nppesnteam/357-22-RHTU-DKVR-4.13/Титульник.pdf

## Директор

# РОССИЙСКАЯ ФЕДЕРАЦИЯ

Общество с Ограниченной Ответственностью Научно Производственное Предприятие "ЭНЕРГОСБЕРЕГАЮЩИЕ СИСТЕМЫ И НЕЙРОАВТОМАТИЗАЦИЯ г.Ижевск
nppesn.ru

## /Корепанов М.И./

Регистрационный номер 1083 в реестре Ассоциации Саморегулируемой организации "Национальное объединение научно-исследовательских и проектно-изыскательских организаций" (Ассоциация СРО "ЦЕНТРСТРОЙПРОЕКТ", регистрационный номер в государственном реестре саморегулируемых организаций СРО-П-029-25092009)

# Котельная ФГБОУ ВО "РХТУ имени Д. И. Менделеева" по адресу: г. Москва, Миусская площадь, дом 9, стр.1

# 357-22-АГСВ1

Автоматизация.

# Котел №1 ДКВР-4/13

## Заказчик: ФГБОУ ВО "РХТУ имени Д. И. Менделеева"

## Ижевск, 2022
