nppesnteam/357-22-RHTU-DKVR-4.13/АГСВ/АГСВ.pdf

## Директор

# РОССИЙСКАЯ ФЕДЕРАЦИЯ

Общество с Ограниченной Ответственностью Научно Производственное Предприятие "ЭНЕРГОСБЕРЕГАЮЩИЕ СИСТЕМЫ И НЕЙРОАВТОМАТИЗАЦИЯ г.Ижевск
nppesn.ru

## /Корепанов М.И./

Регистрационный номер 1083 в реестре Ассоциации Саморегулируемой организации "Национальное объединение научно-исследовательских и проектно-изыскательских организаций" (Ассоциация СРО "ЦЕНТРСТРОЙПРОЕКТ", регистрационный номер в государственном реестре саморегулируемых организаций СРО-П-029-25092009)

# Котельная РХТУ им. Д.И. Менделеева. Приведение автоматики безопасности котлов ДКВР-4/13 в соответствие с требованиями ТР безопасности сетей газораспределения и газопотребления

# 357-22-АГСВ

Автоматизация.

# Общекотельное оборудование

## Заказчик: ФГБОУ ВО "РХТУ имени Д. И. Менделеева"

## Ижевск, 2022

Стадия | Лист | Листов
Изм. | К.уч. | Лист | №Док. | Подп. | Дата

ОООНПП "ЭСН"
www.nppesn.ru

РД

Состав раздела автоматизации

1

ГИП
Разраб.
Проверил

Н. контр.

Чураков

Корепанов

Шакиров

Корепанов

Технические решения, принятые в рабочей документации, соответствуют требованиям экологических, санитарно-технических, противопожарных и других норм, действующих на территории Российской Федерации и обеспечивают безопасную для жизни и здоровья людей эксплуатацию объекта при соблюдении предусмотренных рабочими чертежами мероприятий.

Ведомость рабочих чертежей | Ведомость ссылочных и прилагаемых документов
Лист | Примечание Наименование | Обозначение | Примечание Наименование

Автоматизация. Общекотельное оборудование

357-22-АГСВ

Котельная РХТУ им. Д.И. Менделеева. Приведение автоматики безопасности котлов ДКВР-4/13 в соответствие с требованиями ТР безопасности сетей газораспределения и газопотребления

1 | Состав раздела "Автоматизация. Общекотельное оборудование"
2 | Общие указания
3 | План размещения средств автоматизации
5 | Схема внешних электрических проводок | на 2 листах
| | | Прилагаемые документы
| | 357-22-АГСВ.СО | Спецификация оборудования и материалов
| | 357-22-АГСВ.КЖ | Кабельный журнал
4 | Схема функциональная | 357-22-АГСВ.ИО | Информационное обеспечение
6 | Структурная схема автоматизации котельной
7 | Автоматизированное рабочее место | | Ссылочные документы
8 | Шкаф общекотельной автоматики | на 2 листах
9 | Шкаф управления преобразователями частоты вентиляторов | на 2 листах
10 | Шкаф управления преобразователями частоты дымососов | на 2 листах
11 | Шкаф автоматического ввода резерва | на 2 листах

Стадия | Лист | Листов
Изм. | К.уч. | Лист | №Док. | Подп. | Дата

Автоматизация. Общекотельное оборудование
РД

Котельная РХТУ им. Д.И. Менделеева. Приведение автоматики безопасности котлов ДКВР-4/13 в соответствие с требованиями ТР безопасности сетей газораспределения и газопотребления

357-22-АГСВ

Общие указания

2 Разраб.

Общие указания
Рабочая документация по автоматизации котельной разработана на основании договора подряда, в соответствии с нормами и правилами, действующими на период 12.2022г. в части автоматизации котельных установок и газоснабжения.
Данным рабочим проектом предусматривается автоматизация работы котельной, которая обеспечивает оснащение общего газопровода электромагнитным клапаном, предназначенным для подачи газа на два котла типа ДКВР-4/13, а также сигнализаторами загазованности помещения по углекислому газу и метану.
Система защиты котельной предусматривает прекращение подачи газа к котлам в случаях : а) прекращения подачи электроэнергии или исчезновения напряжения в цепях защиты;
б) срабатывания сигнализаторов загазованнсти.
Автоматика безопасности, при ее отключении или неисправности, обеспечивает блокировку подачи газа в ручном режиме.
Система контроля загазованности по метану и угарному газу в котельной существующая. Регистрация давления, расхода пара и уровня воды в барабане котла производится контроллером шкафа управления и дублируется на АРМ оператора.
В качестве устройства контроля, управления, сигнализации и защиты котла применяется программируемый многофункциональный контроллер REGUL R500, производства инженерной компании "Прософт-Системы" г.Екатеринбург с блоками дискретных входов/выходов REGUL R500, имеющий разрешение к применению на опасных промышленных объектах подконтрольных Ростехнадзору. Контроллер обеспечивает программное открытие клапана подачи газа к котлам, прекращение подачи газа при срабатывании защит, фиксацию первопричины аварии.
Все параметры работы котлов в виде дискретных и аналоговых сигналов вводятся в контроллер REGUL R500, раюотающий в паре с сенсорным монитором размером 12,1". На монитор выводятся необходимые для наблюдения величины: температура, давление, расход, уровень.
В случае аварийной остановки котла выводятся сведения о причине аварии, время и параметры работы котла на момент останова. Дополнительно включается звуковой сигнал и световой сигнал «Авария» на шкафу управления. Управление вводом требуемых параметров и режимами отображения производится виртуальными кнопками на экране панели.
В помещении операторской проектом предусмотрена установка автоматизированного рабочего места (АРМ) оператора. С рабочего места оператора производится управление работой котлов.
На АРМ ведутся архивы необходимой глубины и детализации (часовые, суточные)

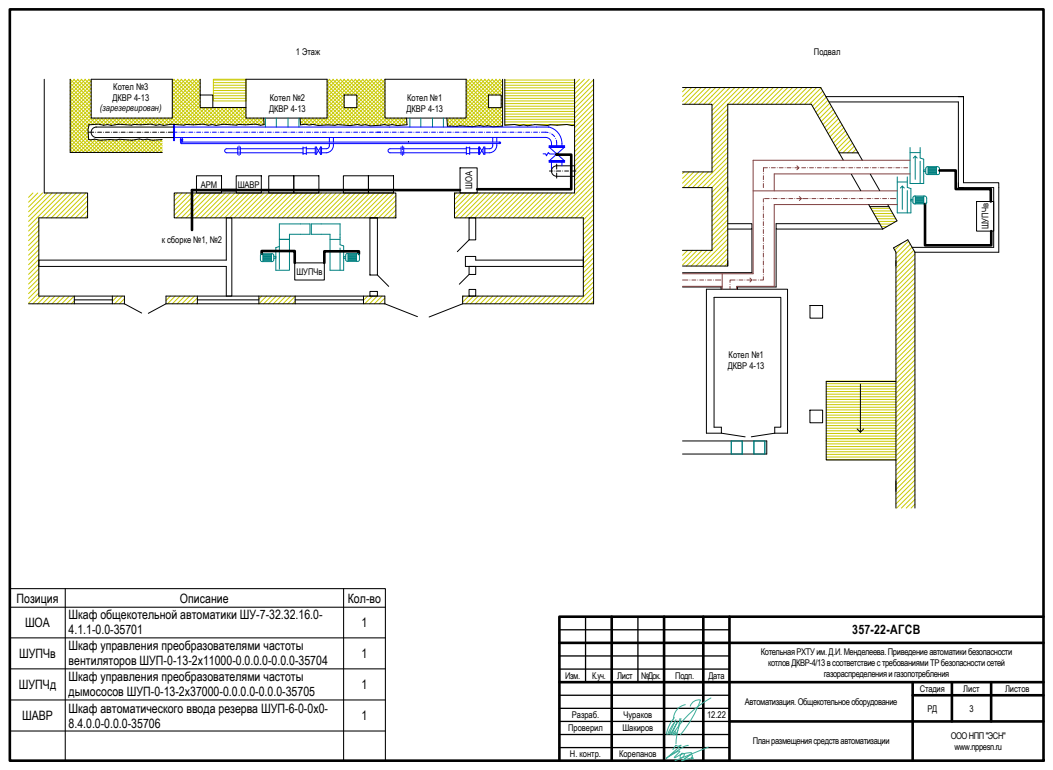
[picture p7: page 4]
Стадия; Лист; Листов; Изм.; №Док.; Подп.; Дата; газораспределения и газопотребления; 357-22-АГСВ; 3 Разраб.; Котел №1 ДКВР 4-13; Котел №2 ДКВР 4-13; Котел №3 ДКВР 4-13 (зарезервирован); 1 Этаж; АРМ; ШОА; ШУПЧв; Подвал; Позиция; Описание; Кол-во; ШАВР; к сборке №1, №2

ШОА | Шкаф общекотельной автоматики ШУ-7-32.32.16.0-4.1.1-0.0-35701
ШУПЧв | Шкаф управления преобразователями частоты вентиляторов ШУП-0-13-2х11000-0.0.0.0-0.0.0-35704 | 1
ШУПЧд | Шкаф управления преобразователями частоты дымососов ШУП-0-13-2х37000-0.0.0.0-0.0.0-35705 | 1
ШАВР | | 1 Шкаф автоматического ввода резерва ШУП-6-0-0х0- 8.4.0.0-0.0.0-35706

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

Автоматизация. Общекотельное оборудование

План размещения средств автоматизации

Стадия | Лист | Листов

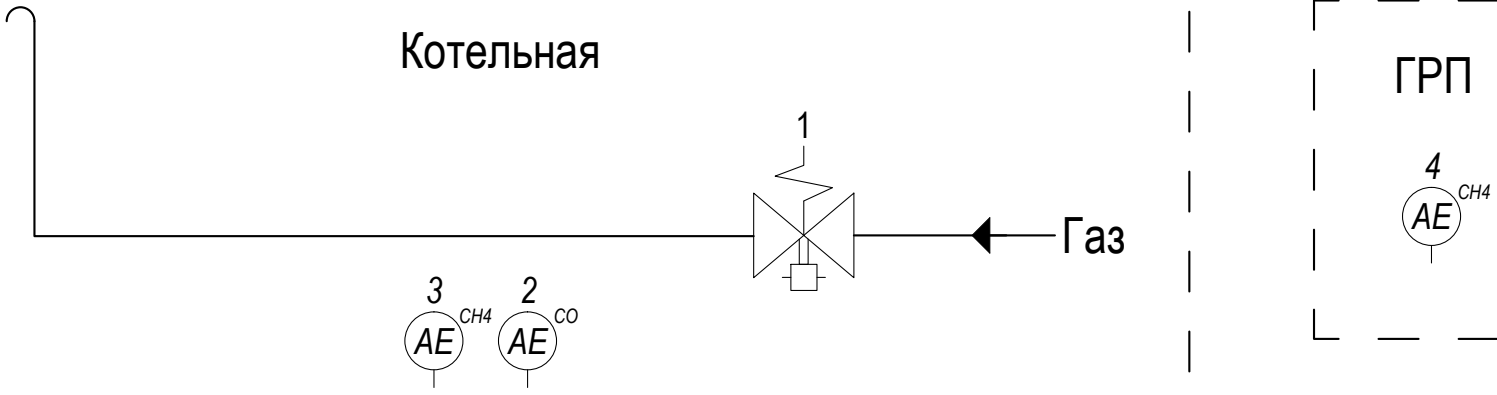
[picture p8: figure]
Газ; Котельная; ГРП

Изм. | К.уч. | Лист | №Док. | Подп. | Дата

Автоматизация. Общекотельное оборудование
РД

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

357-22-АГСВ

Схемафункциональная

4 Разраб.

A - Анализ

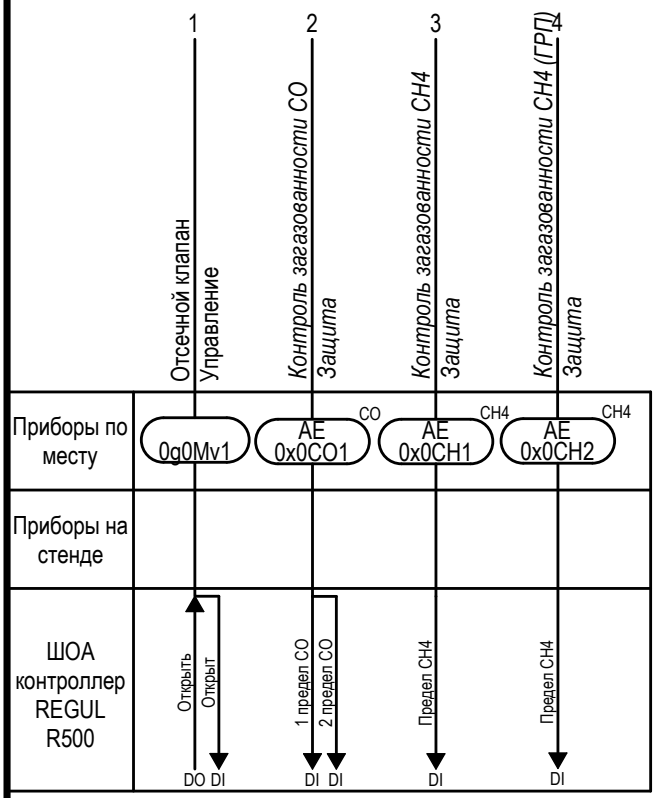
[picture p9: figure]
Приборы по месту; Приборы на стенде; ШОА контроллер REGUL R500; Отсечной клапан Управление

Стадия | Лист | Листов
Изм. | К.уч. | Лист | №Док. | Подп. | Дата

РД

Схема внешних электрических проводок. Дискретные входные сигналы

5.1 Разраб.

Параметр

Место отбора
импульса или
установки
прибора

Позиция

Автоматизация. Общекотельное оборудование

357-22-АГСВ

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

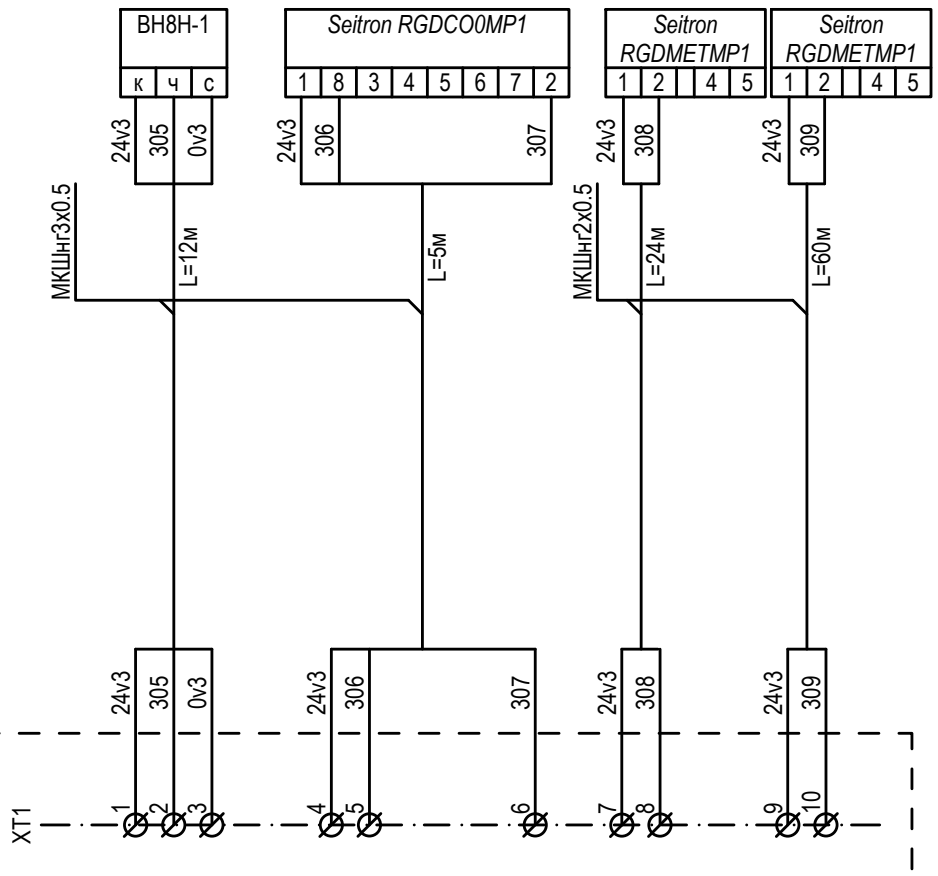
[picture p10: figure]
МКШнг; Seitron RGDCO0MP1; Seitron RGDMETMP1

Шкаф общекотельной автоматики

Контроль

Отсечной клапан
открыт

0g0Mv1

Контроль | Контроль | Контроль | Контроль
Загазованность 1 СО | Загазованность 2 СО | Загазованность СН4 (Котельная) | Загазованность СН4 (ГРП)
| | 0x0CH1 | 0x0CH2

0x0CO1

2

Стадия | Лист | Листов
Изм. | К.уч. | Лист | №Док. | Подп. | Дата

РД

Схема внешних электрических проводок. Дискретные выходные сигналы

5.2 Разраб.

Параметр

Место отбора
импульса или
установки
прибора

Позиция

Автоматизация. Общекотельное оборудование

357-22-АГСВ

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

Шкаф общекотельной
автоматики

XT2 ВВГнг

3

х1,5

Управление

Отсечной клапан
открыть

0g0Mv1

401

123

N | L | PE

ВН8Н-1

N

PE

N

401
PE L=12м

Управление

Вентилятор
котла №1

1a0fMf1

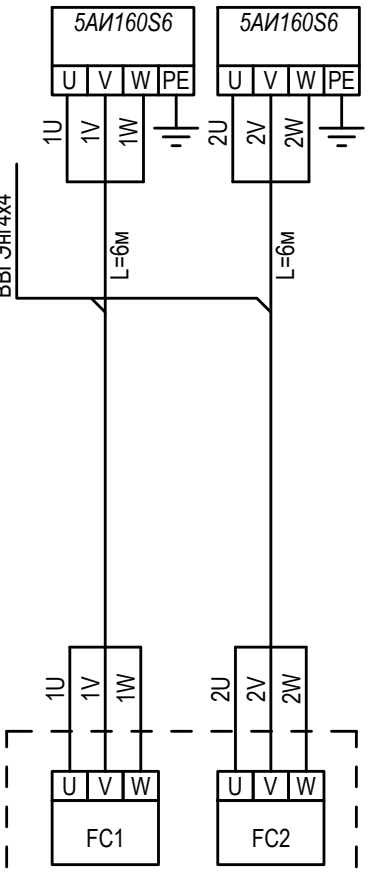
[picture p11: figure]

Шкаф управления
ПЧ вентилятора

Управление

Вентилятор
котла №2

2a0fMf1

Управление

Дымосос
котла №1

1f0fMf2

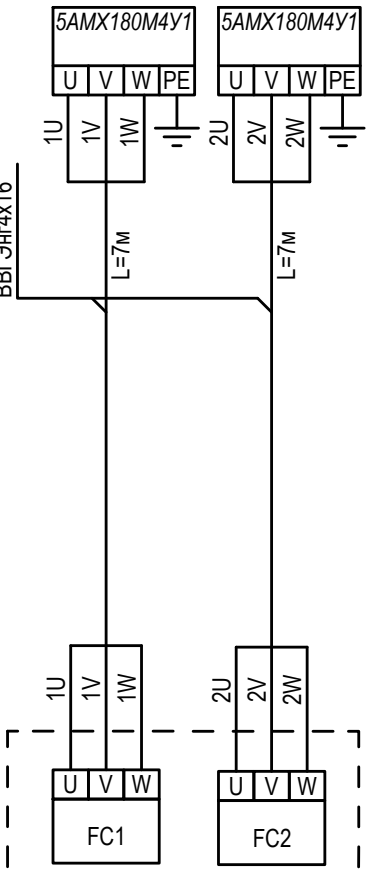
[picture p12: figure]
5АМХ180М4У1

Шкаф управления
ПЧ дымососа

Управление

Дымосос
котла №2

2f0fMf2

ВВГЭнг

4

х

4
ВВГЭнг

4

х16

ШУПЧв/
FC1..2
Позиция | Описание | Кол-во
| Частотный преобразователь 11кВт; Uпит.~380B;
Iн.вых 25А | 2
ШУПЧд/ FC1..2 | Частотный преобразователь 37кВт; Uпит.~380B;
Iн.вых 75А | 2

2

Стадия | Лист | Листов

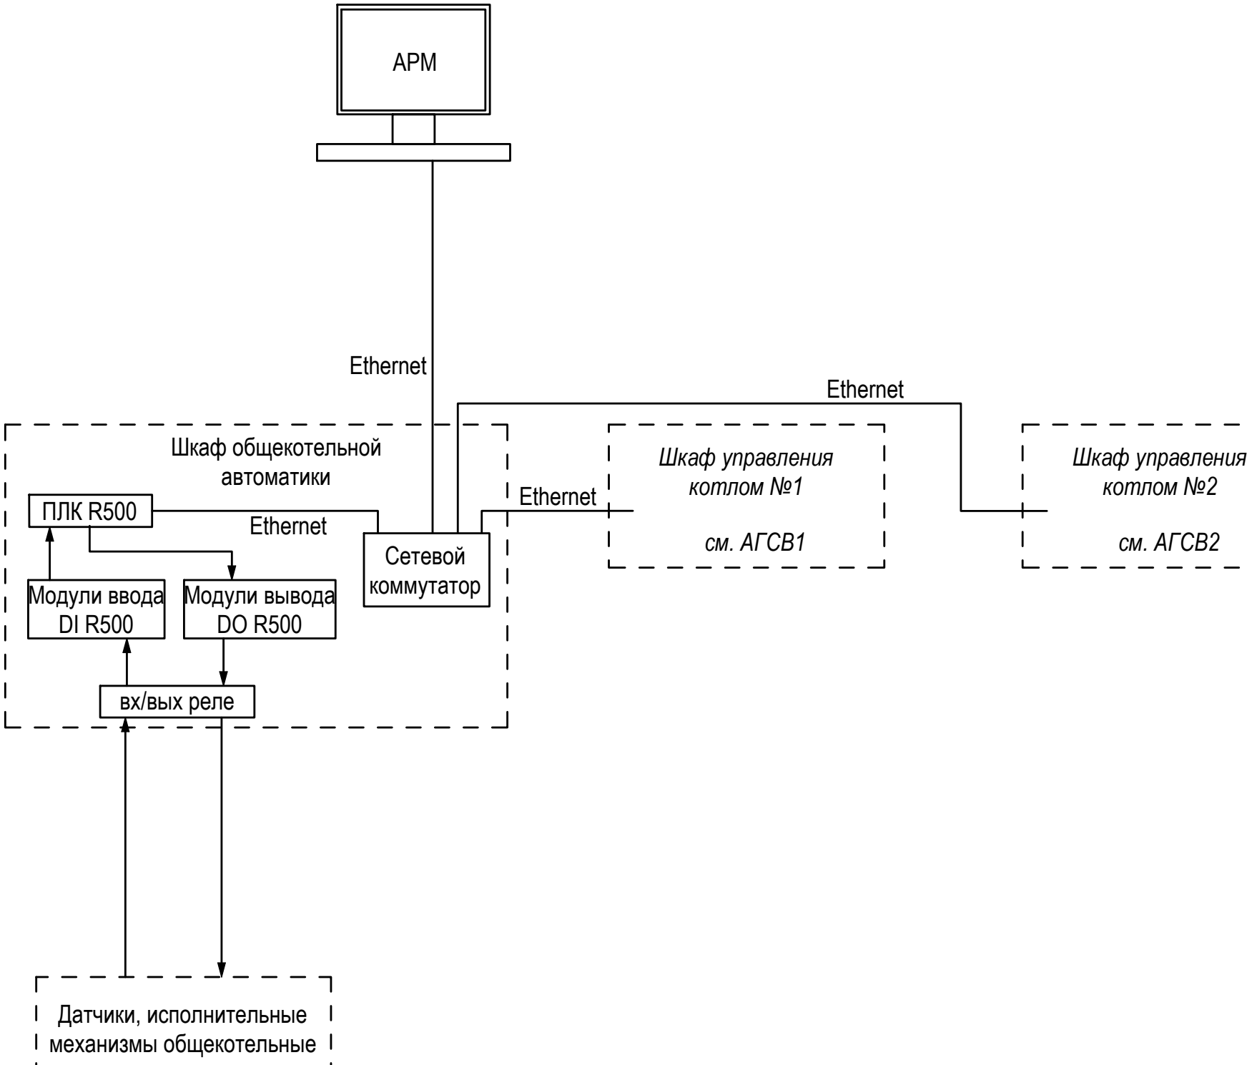
[picture p13: figure]
Датчики, исполнительные механизмы общекотельные; Шкаф управления котлом №1; Шкаф общекотельной автоматики; ПЛК R500; Модули ввода DI R500; Модули вывода DO R500; вх/вых реле; Сетевой коммутатор; Ethernet; АРМ; см. АГСВ1; Шкаф управления котлом №2; см. АГСВ2

Изм. | К.уч. | Лист | №Док. | Подп. | Дата

Автоматизация. Общекотельное оборудование
РД

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

357-22-АГСВ

Структурная схема автоматизации котла

6 Разраб.

Стадия | Лист | Листов
Изм. | К.уч. | Лист | №Док. | Подп. | Дата

Автоматизация. Общекотельное оборудование
РД

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

357-22-АГСВ

Автоматизированное рабочее место

7 Разраб.

### VGA

ПК

## ИБП

Позиция

ПК

Описание | Кол-во
Системный блок | 1
VGA | Монитор | 1
ИБП | Источник бесперебойного питания | 1

Примечание: стол и розетка питания для АРМ существующие.

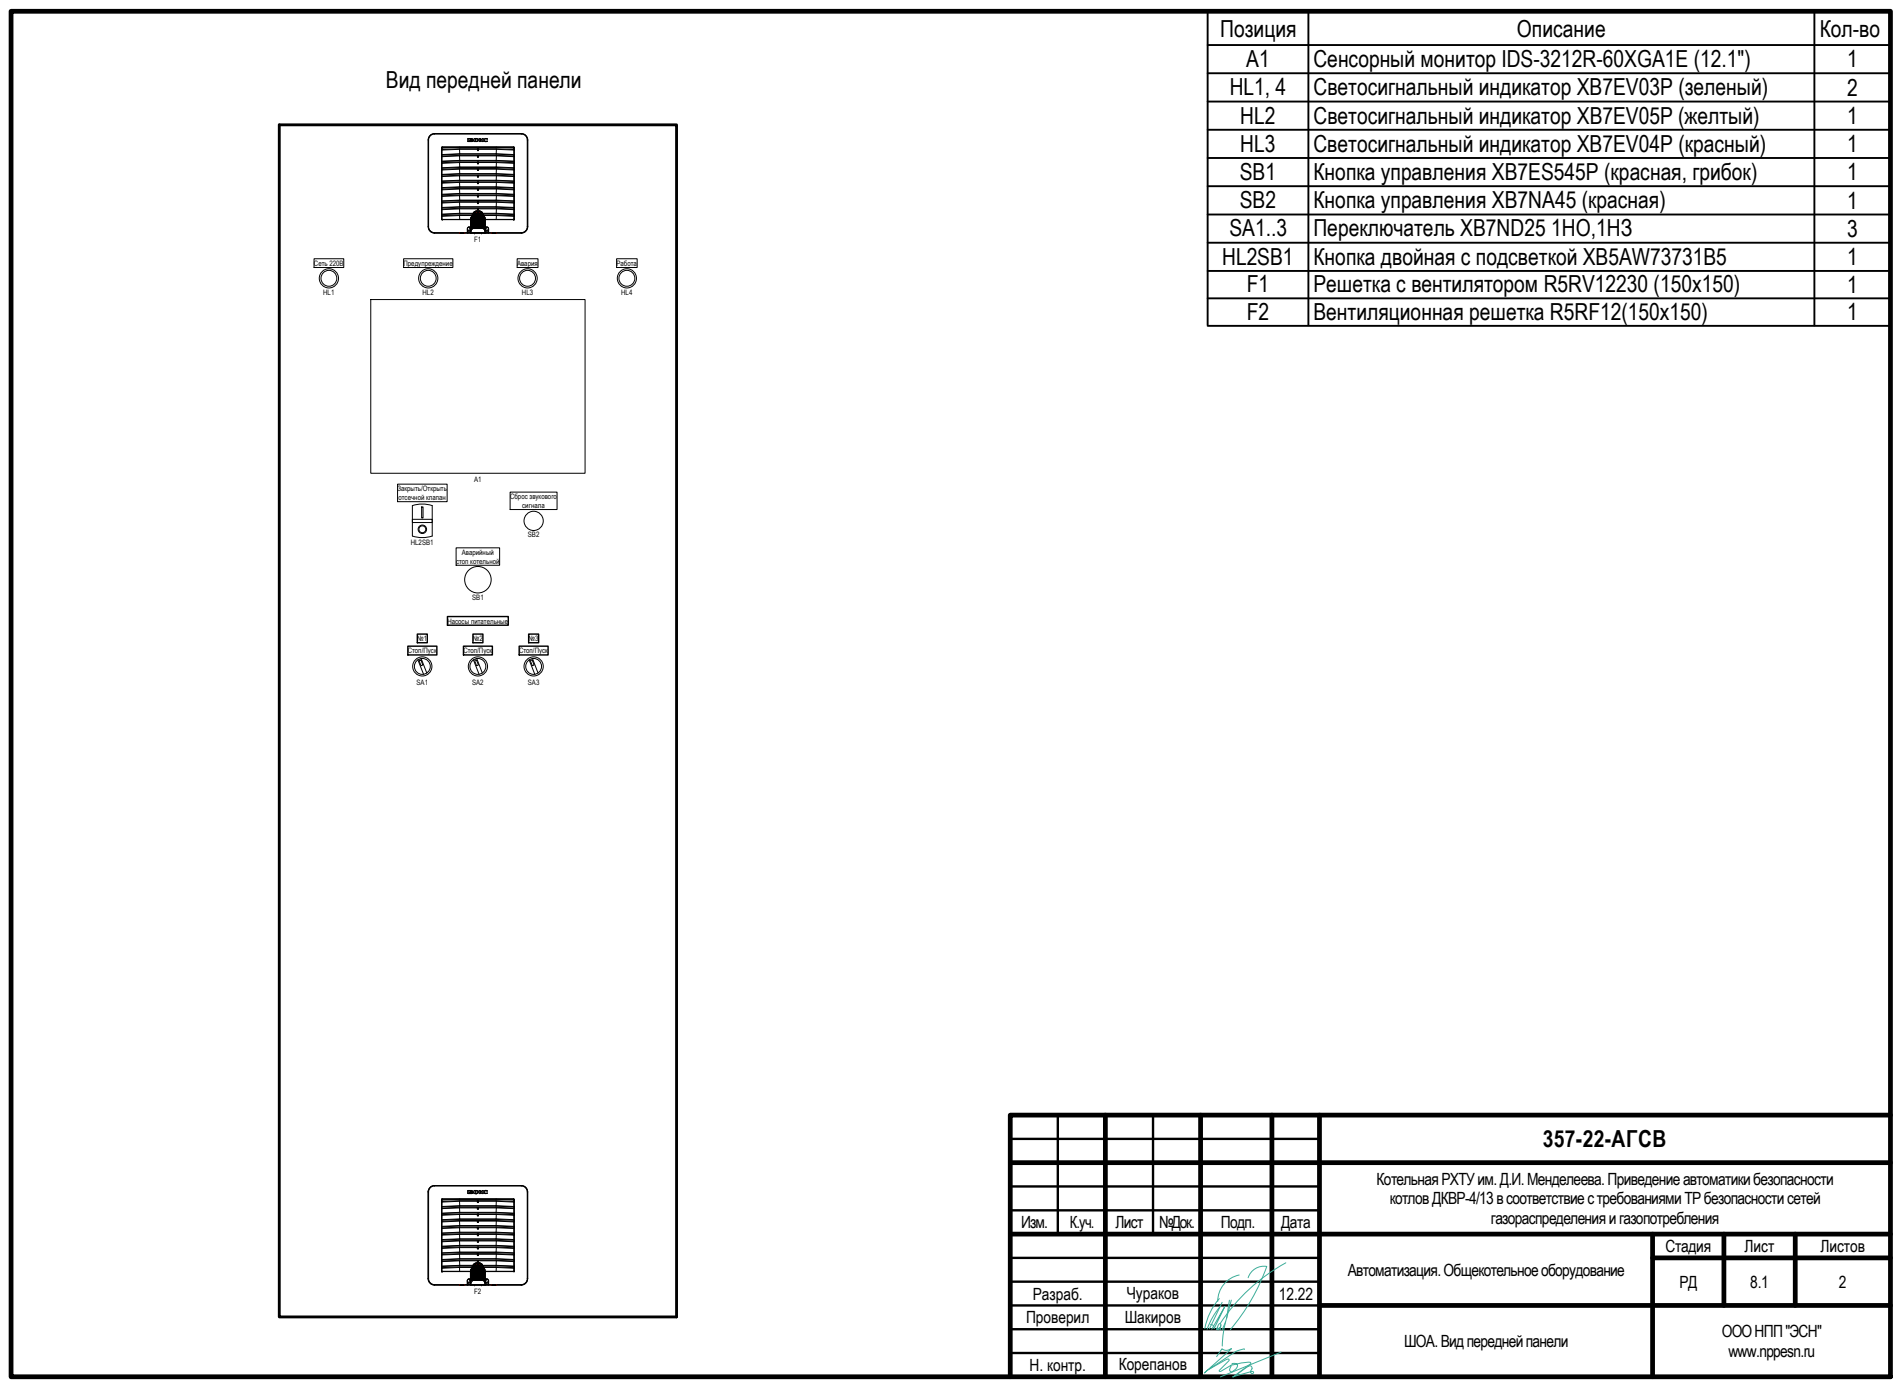
[picture p14: page 10]
Стадия; Лист; Листов; Изм.; №Док.; Подп.; Дата; газораспределения и газопотребления; 357-22-АГСВ; 8.1 Разраб.; Насосы питательные; Аварийный стоп котельной; Закрыть/Открыть; отсечной клапан; Сброс звукового; сигнала; Стоп/Пуск; Предупреждение; Авария; Сеть 220В; Работа; Описание; Кол-во; Сенсорный монитор IDS-3212R-60XGA1E (12.1"); Решетка с вентилятором R5RV12230 (150х150); Вентиляционная решетка R5RF12(150х150)

Позиция
Светосигнальный индикатор XB7EV03P (зеленый)
Светосигнальный индикатор XB7EV05P (желтый)
Светосигнальный индикатор XB7EV04P (красный)
Кнопка управления XB7ES545P (красная, грибок)
Кнопка управления XB7NA45 (красная)
Переключатель XB7ND25 1НО,1НЗ
Кнопка двойная с подсветкой XB5AW73731B5

Вид передней панели

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

Автоматизация. Общекотельное оборудование

ШОА. Вид передней панели

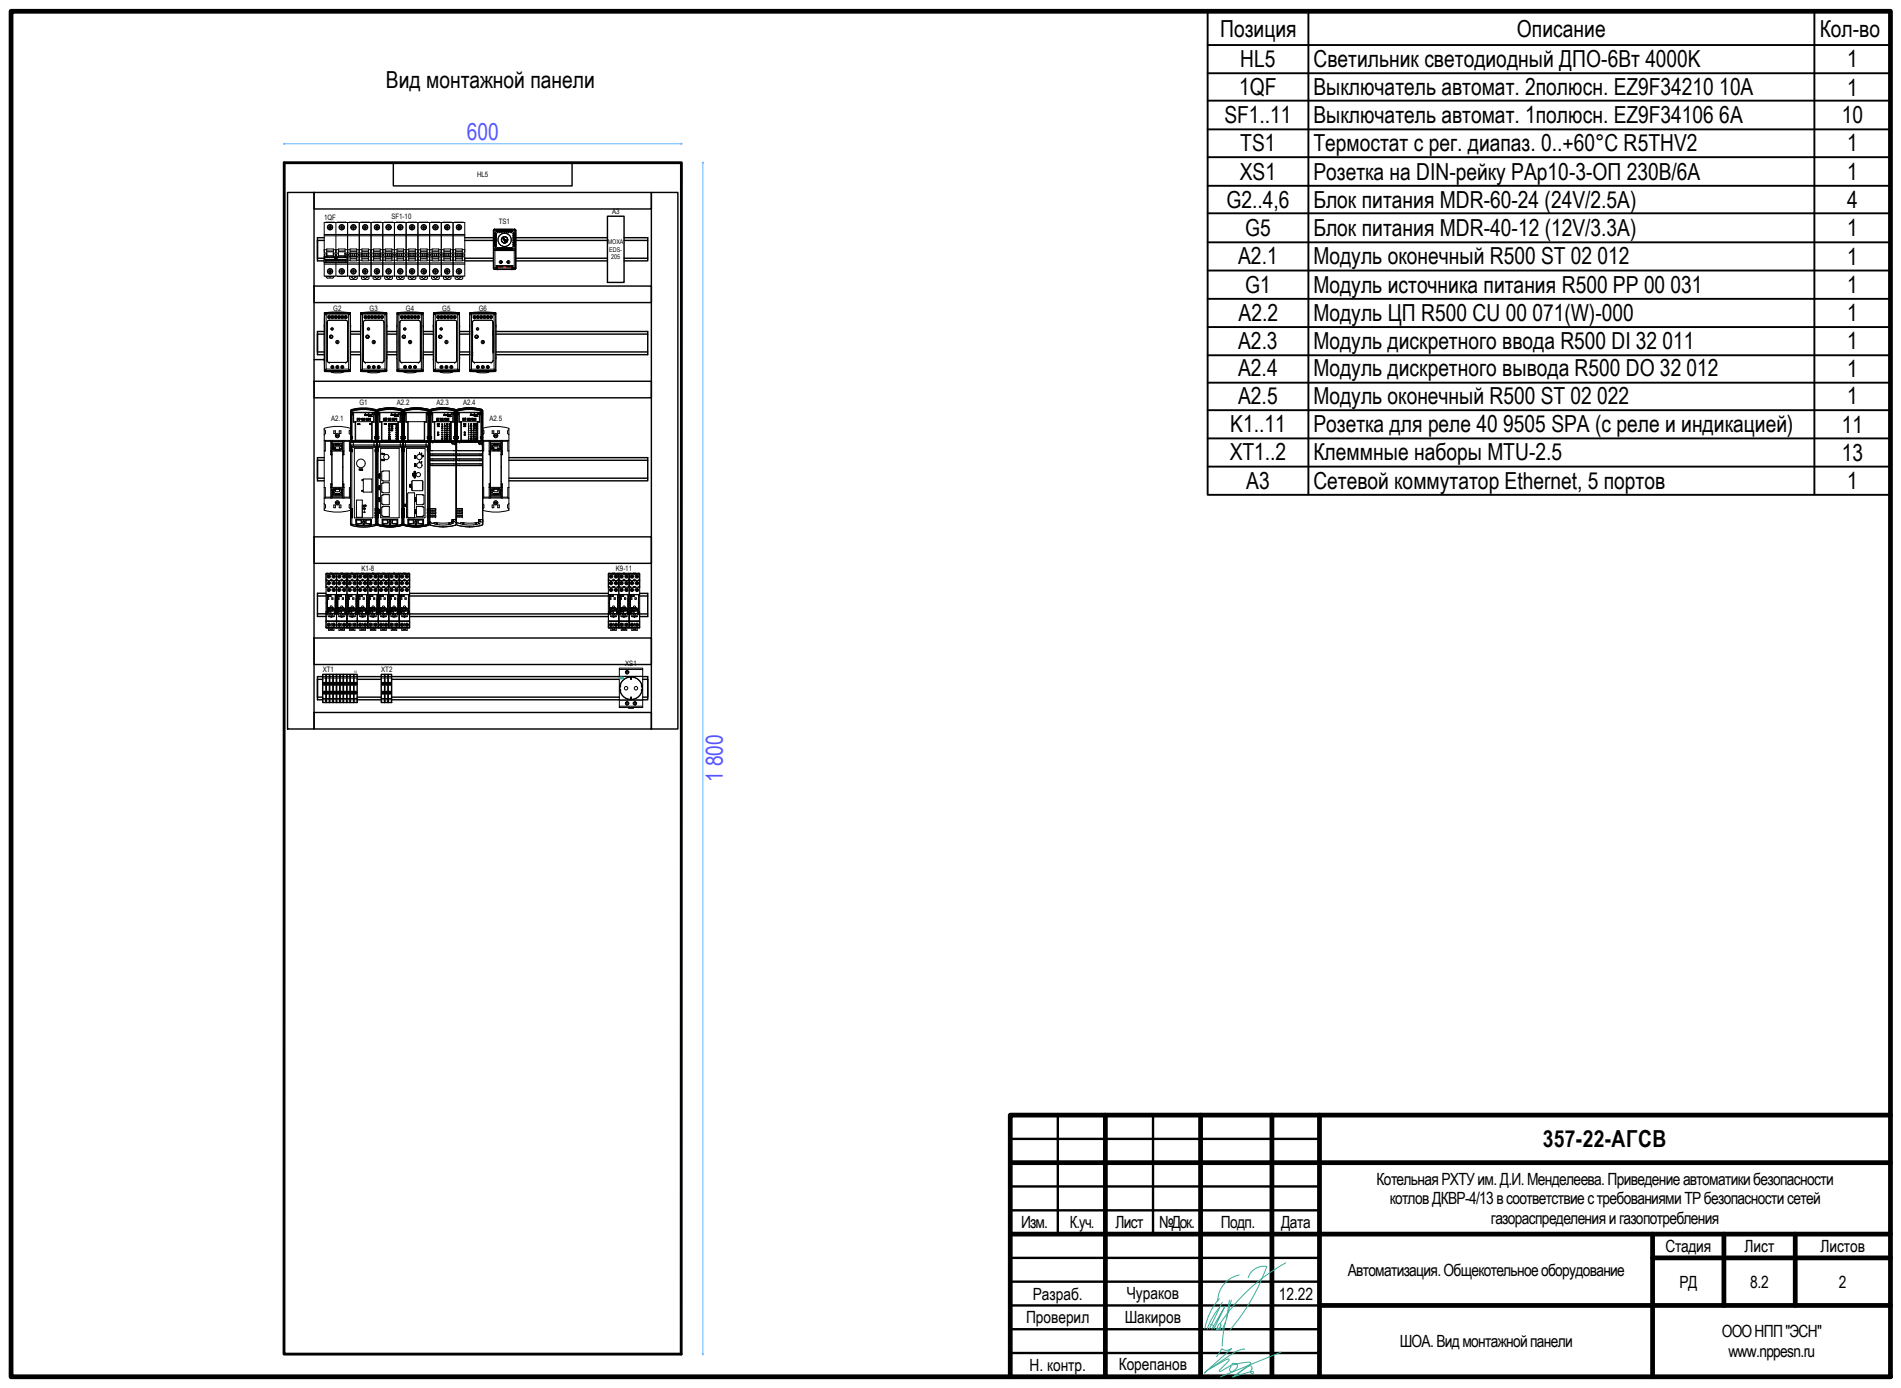
[picture p15: page 11]
Стадия; Лист; Листов; Изм.; №Док.; Подп.; Дата; газораспределения и газопотребления; 357-22-АГСВ; 8.2 Разраб.; COIL; MOXA EDS- 205; Описание; Кол-во; Светильник светодиодный ДПО-6Вт 4000K; Модуль дискретного вывода R500 DO 32 012; Термостат с рег. диапаз. 0..+60°С R5THV2; SF1..11 Выключатель автомат. 1полюсн. EZ9F34106 6A; Блок питания MDR-40-12 (12V/3.3A); Сетевой коммутатор Ethernet, 5 портов

Позиция
Выключатель автомат. 2полюсн. EZ9F34210 10А
Розетка на DIN-рейку PAp10-3-ОП 230В/6А
Блок питания MDR-60-24 (24V/2.5A)
Модуль оконечный R500 ST 02 012
Модуль источника питания R500 PP 00 031
Модуль ЦП R500 CU 00 071(W)-000
Модуль дискретного ввода R500 DI 32 011
Модуль оконечный R500 ST 02 022
Розетка для реле 40 9505 SPA (с реле и индикацией)
Клеммные наборы MTU-2.5

Вид монтажной панели

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

Автоматизация. Общекотельное оборудование

ШОА. Вид монтажной панели

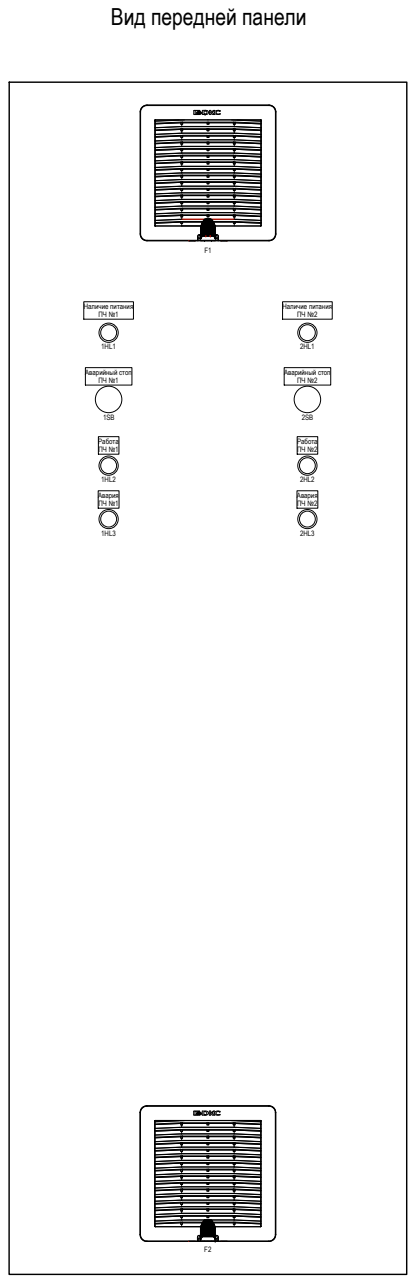
[picture p16: page 12]
Стадия; Лист; Листов; Изм.; №Док.; Подп.; Дата; газораспределения и газопотребления; 357-22-АГСВ; 9.1 Разраб.; Наличие питания ПЧ №1; Аварийный стоп ПЧ №1; Работа ПЧ №1; 1HL2 Авария ПЧ №1; Наличие питания ПЧ №2; Аварийный стоп ПЧ №2; Работа ПЧ №2; 2HL2 Авария ПЧ №2; Описание; Кол-во; Вентилятор с фильтром RV 100/105 м3/ч, 230 В, 205x205 мм, IP54; Вентиляционная решетка с фильтром RF 205x205 мм, IP54

Позиция
Светосигнальный индикатор цвет зеленый (230в)
Кнопка "Грибок" АЕ-22 (красная)
Светосигнальный индикатор цвет красный (230в)

Вид передней панели

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

Автоматизация. Общекотельное оборудование

ШУПЧв. Вид передней панели

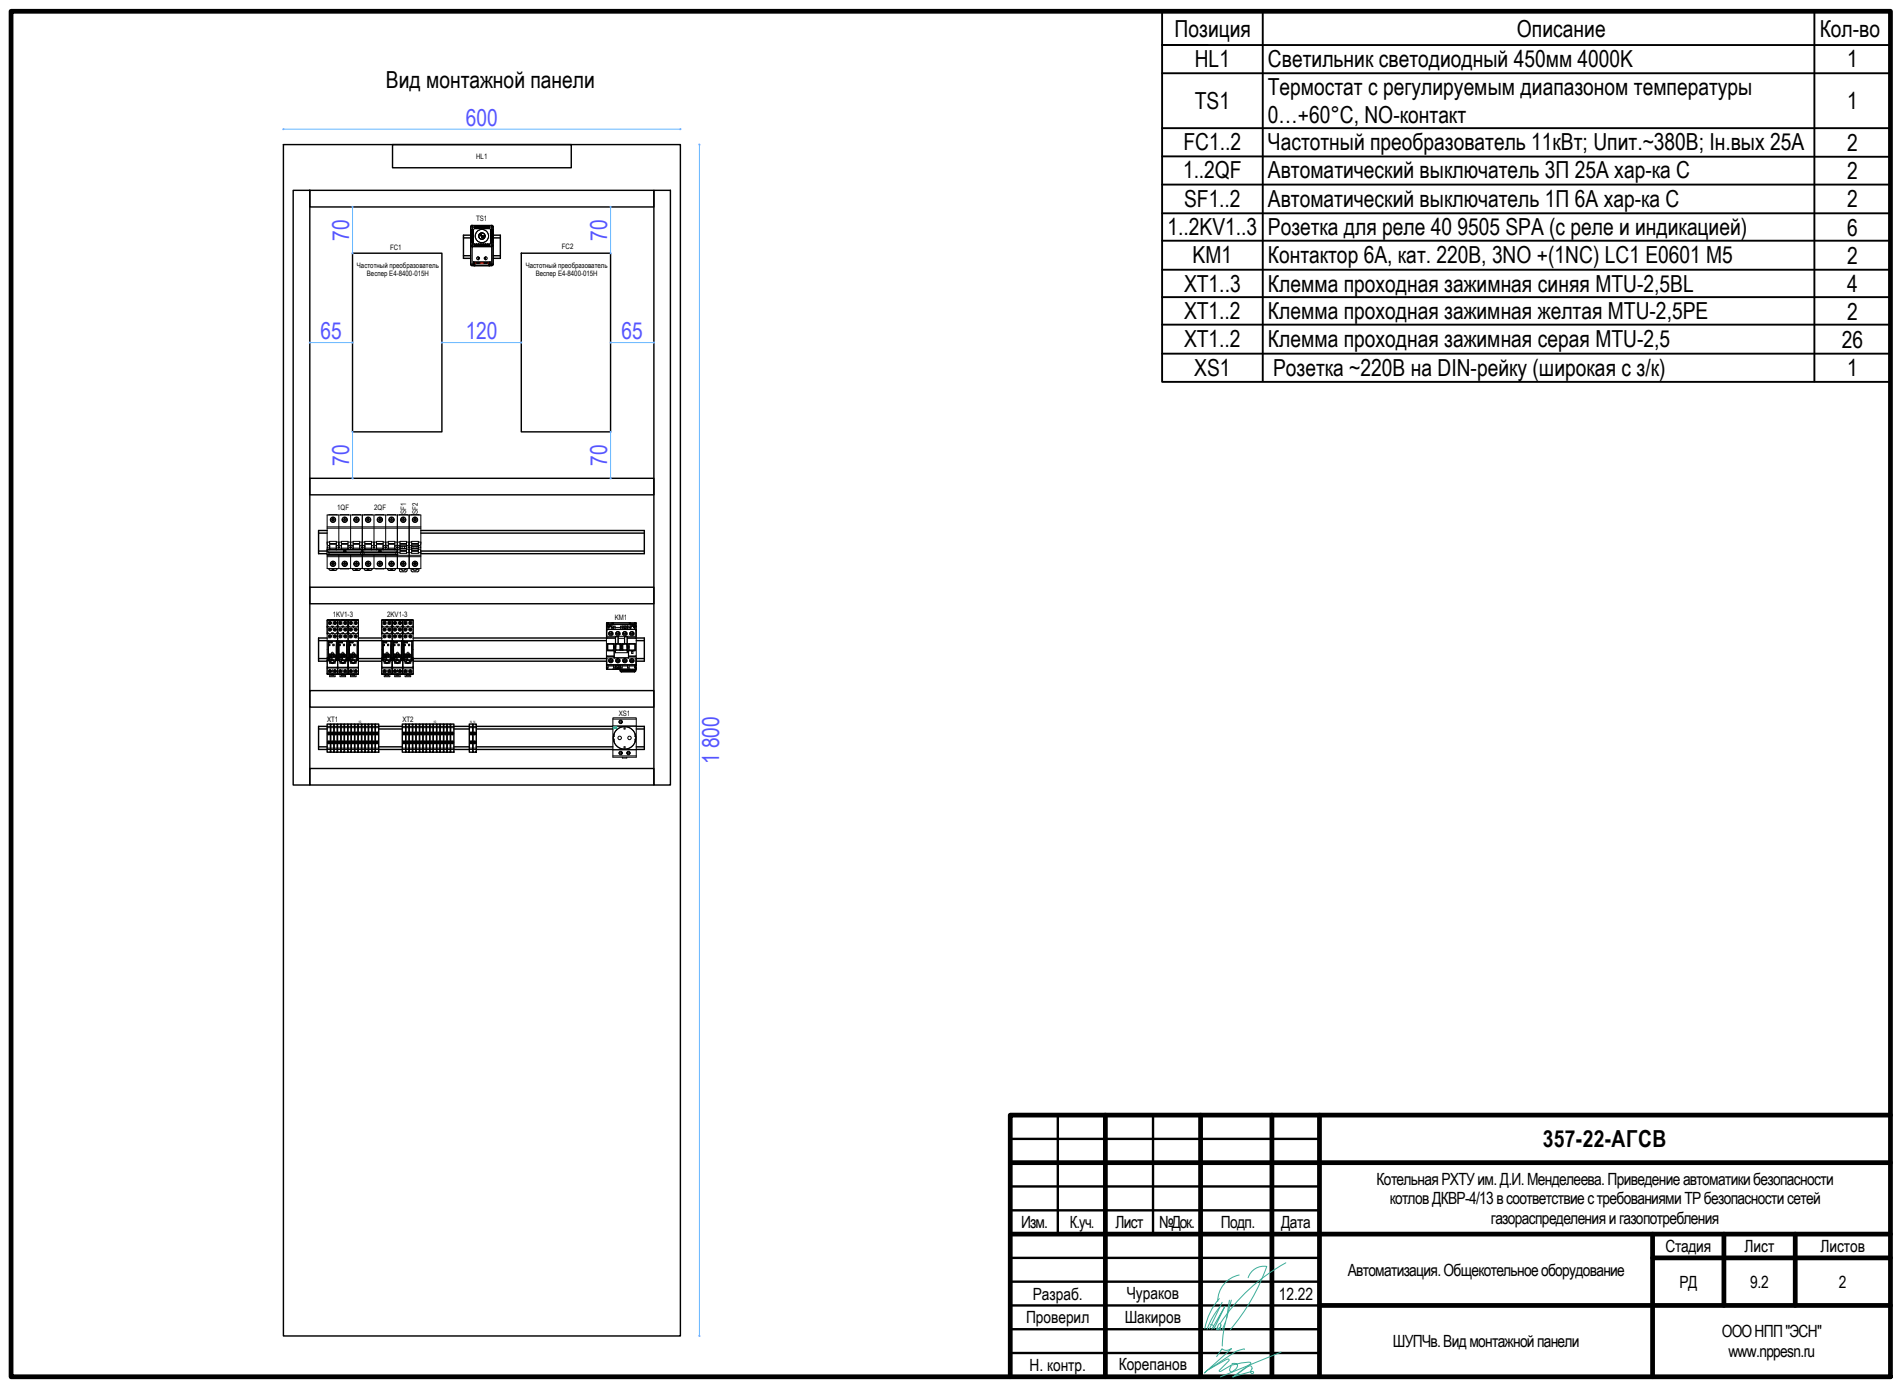
[picture p17: page 13]
Стадия; Лист; Листов; Изм.; №Док.; Подп.; Дата; газораспределения и газопотребления; 357-22-АГСВ; 9.2 Разраб.; Частотный преобразователь Веспер E4-8400-015Н; COIL; Описание; Кол-во; Светильник светодиодный 450мм 4000K; Автоматический выключатель 3П 25А хар-ка C; Частотный преобразователь 11кВт; Uпит.~380B; Iн.вых 25А; Контактор 6А, кат. 220В, 3NO +(1NС) LC1 E0601 M5; Клемма проходная зажимная желтая MTU-2,5PE; Клемма проходная зажимная cерая MTU-2,5

Позиция
Термостат с регулируемым диапазоном температуры
0…+60°C, NO-контакт
Автоматический выключатель 1П 6А хар-ка C
Розетка для реле 40 9505 SPA (с реле и индикацией)
Клемма проходная зажимная cиняя MTU-2,5BL
Розетка ~220В на DIN-рейку (широкая с з/к)

Вид монтажной панели

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

Автоматизация. Общекотельное оборудование

ШУПЧв. Вид монтажной панели

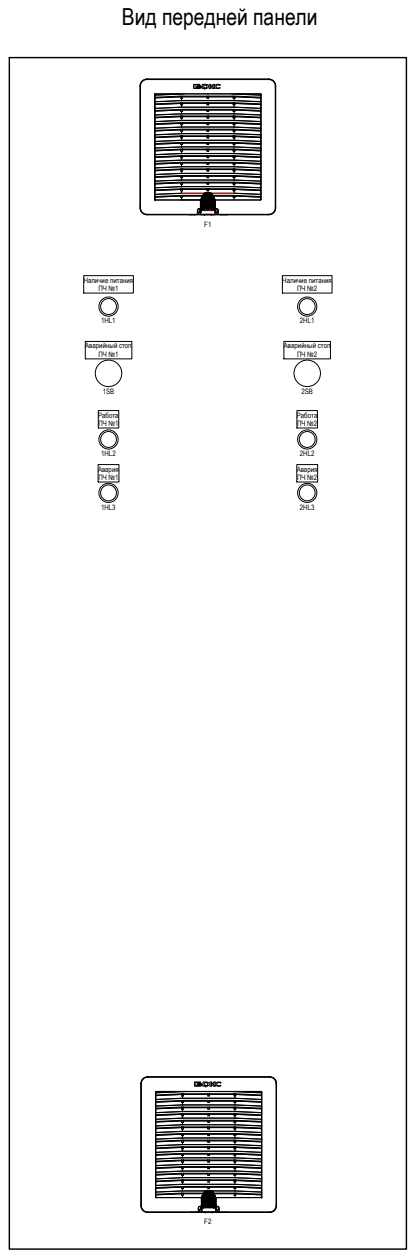
[picture p18: page 14]
Стадия; Лист; Листов; Изм.; №Док.; Подп.; Дата; газораспределения и газопотребления; 357-22-АГСВ; 10.1 Разраб.; Наличие питания ПЧ №1; Аварийный стоп ПЧ №1; Работа ПЧ №1; 1HL2 Авария ПЧ №1; Наличие питания ПЧ №2; Аварийный стоп ПЧ №2; Работа ПЧ №2; 2HL2 Авария ПЧ №2; Описание; Кол-во; Вентилятор с фильтром RV 100/105 м3/ч, 230 В, 205x205 мм, IP54; Вентиляционная решетка с фильтром RF 205x205 мм, IP54

Позиция
Светосигнальный индикатор цвет зеленый (230в)
Кнопка "Грибок" АЕ-22 (красная)
Светосигнальный индикатор цвет красный (230в)

Вид передней панели

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

Автоматизация. Общекотельное оборудование

ШУПЧд. Вид передней панели

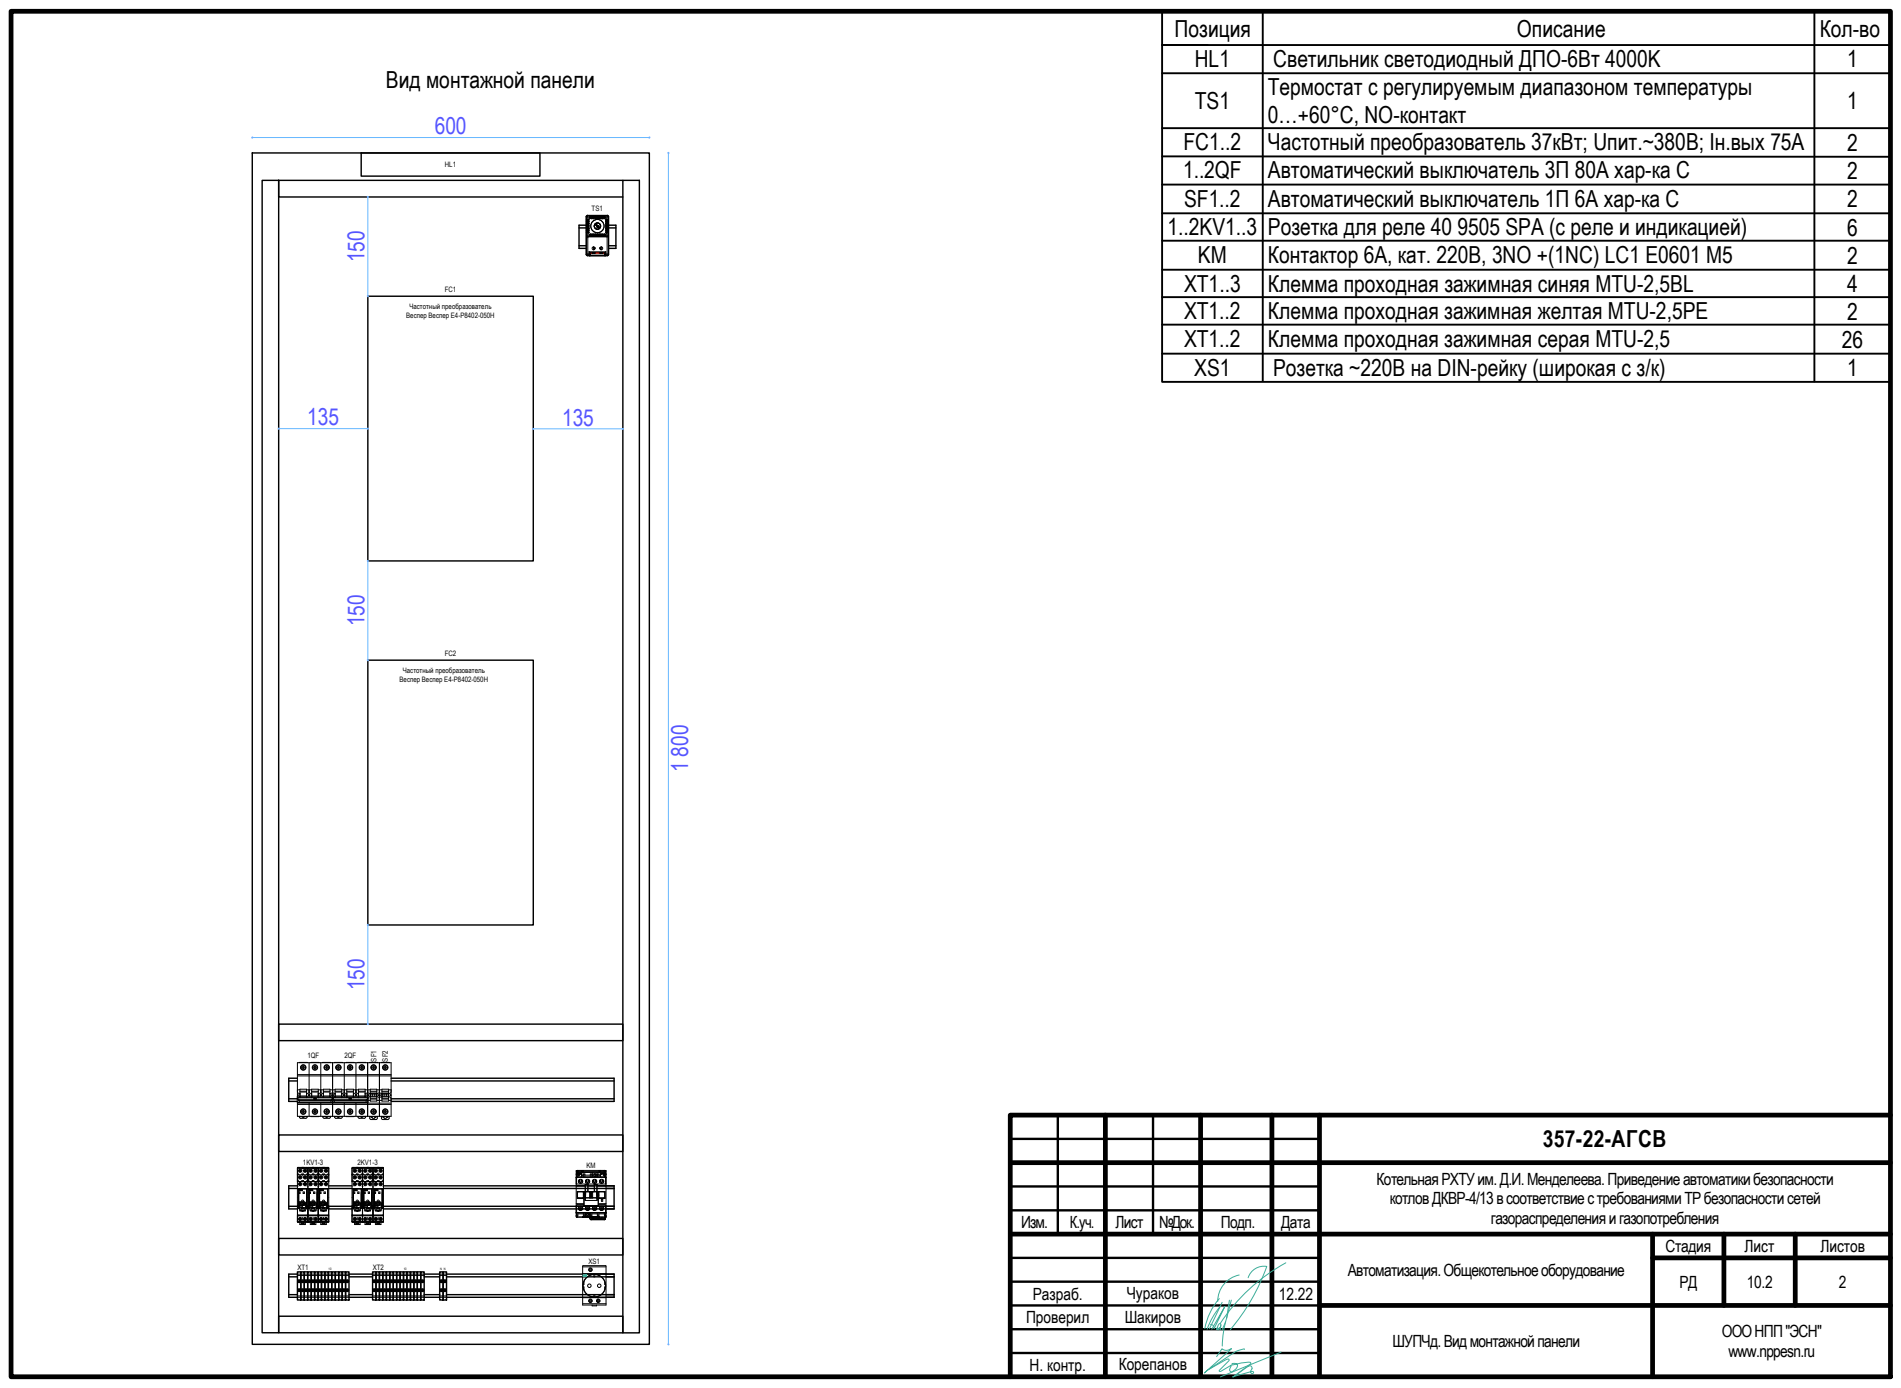
[picture p19: page 15]
Стадия; Лист; Листов; Изм.; №Док.; Подп.; Дата; газораспределения и газопотребления; 357-22-АГСВ; 10.2 Разраб.; Частотный преобразователь Веспер Веспер Е4-P8402-050H; COIL; Описание; Кол-во; Светильник светодиодный ДПО-6Вт 4000K; Автоматический выключатель 3П 80А хар-ка С; Частотный преобразователь 37кВт; Uпит.~380B; Iн.вых 75А; Контактор 6А, кат. 220В, 3NO +(1NС) LC1 E0601 M5; Клемма проходная зажимная желтая MTU-2,5PE; Клемма проходная зажимная cерая MTU-2,5

Позиция
Термостат с регулируемым диапазоном температуры
0…+60°C, NO-контакт
Автоматический выключатель 1П 6А хар-ка C
Розетка для реле 40 9505 SPA (с реле и индикацией)
Клемма проходная зажимная cиняя MTU-2,5BL
Розетка ~220В на DIN-рейку (широкая с з/к)

Вид монтажной панели

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

Автоматизация. Общекотельное оборудование

ШУПЧд. Вид монтажной панели

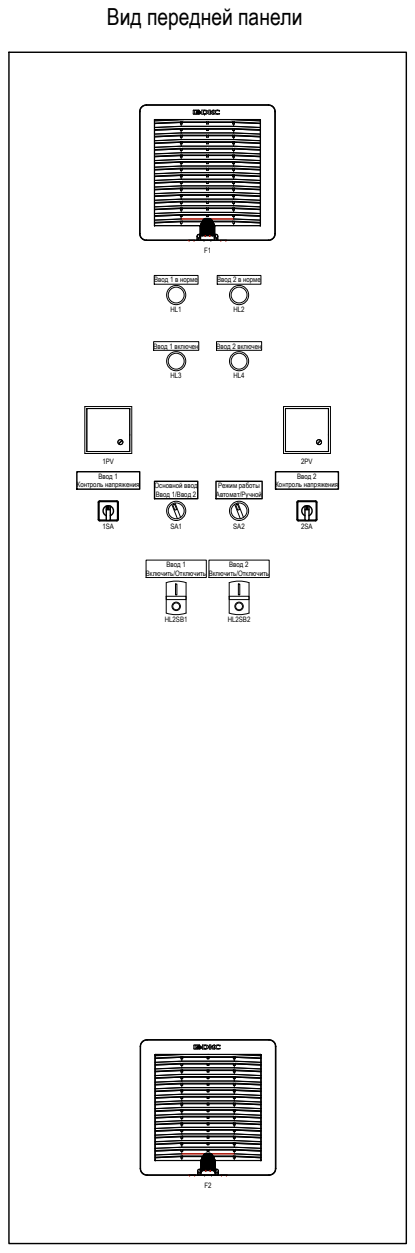
[picture p20: page 16]
Стадия; Лист; Листов; Изм.; №Док.; Подп.; Дата; газораспределения и газопотребления; 357-22-АГСВ; 11.1 Разраб.; Ввод 1 в норме; Ввод 2 в норме; Ввод 1 включен; Ввод 2 включен; Основной ввод Ввод 1/Ввод 2; Ввод 1 Включить/Отключить; Ввод 1 Контроль напряжения; Ввод 2; Режим работы; Контроль напряжения; Автомат/Ручной; Ввод 2 Включить/Отключить; Описание; Кол-во; Решетка с вентилятором R5RV13230 (205х205); Решетка R5RF13 (205х205)

Позиция
Светосигнальный индикатор XB7EV03P (зеленый)
Вольтметр аналоговый 0-500В AC 16005
Переключатель кулачковый K10F027MCH
Переключатель XB7ND25 1НО,1НЗ
Кнопка двойная с подсветкой XB5AW73731M5

Вид передней панели

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

Автоматизация. Общекотельное оборудование

ШАВР. Вид передней панели

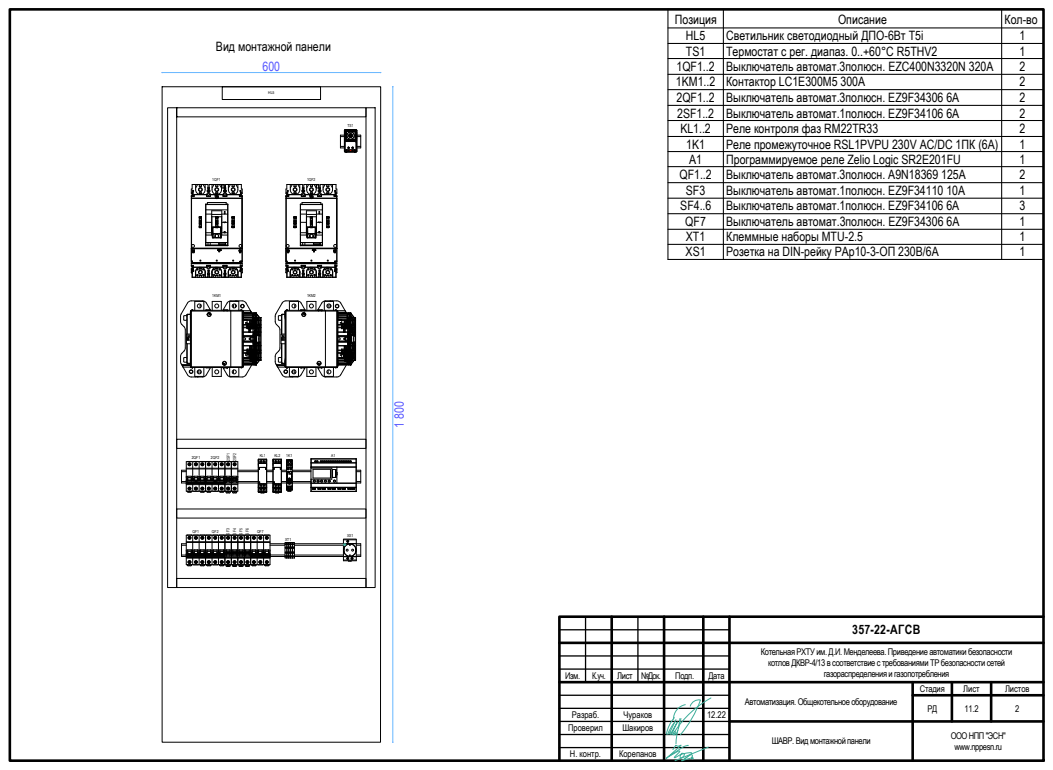
[picture p21: page 17]
Стадия; Лист; Листов; Изм.; №Док.; Подп.; Дата; газораспределения и газопотребления; 357-22-АГСВ; 11.2 Разраб.; COIL; Описание; Кол-во; Светильник светодиодный ДПО-6Вт Т5i; Клеммные наборы MTU-2.5; Розетка на DIN-рейку РАр10-3-ОП 230В/6А; 1KM1..2 Контактор LC1E300M5 300А; 1QF1..2 Выключатель автомат.3полюсн. EZC400N3320N 320А; KL1..2 Реле контроля фаз RM22TR33; Программируемое реле Zelio Logic SR2E201FU; QF1..2 Выключатель автомат.3полюсн. A9N18369 125А

Позиция
Термостат с рег. диапаз. 0..+60°С R5THV2
Выключатель автомат.3полюсн. EZ9F34306 6А
Выключатель автомат.1полюсн. EZ9F34106 6А
Реле промежуточное RSL1PVPU 230V АC/DC 1ПК (6А)
Выключатель автомат.1полюсн. EZ9F34110 10А

Вид монтажной панели

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

Автоматизация. Общекотельное оборудование

ШАВР. Вид монтажной панели

Позиция | Наименование и техническая характеристика | Тип,марка,обозначение документа, опросного листа | код оборудования, изделия, материала | Завод-изготовитель | Едини. изме- рения | Коли- чество | Масса един кГ | Примечание
1 | 2 | 3 | | 5 | 6 | 7 | 8 | 9
| 1.Приборы по месту (общекотельная автоматика)
| Приборы контроля загазованности
0g0co1 | Прибор контроля загазованности по угарному газу | RGDCO0MP1 | | Seitron | шт | 1 | 0,4 | Существующий
0g0ch1..2 | Прибор контроля загазованности по метану | RGDMETMP1 | | Seitron | шт | 2 | 0,8 | Существующий
| Исполнительные механизмы
0g0Mv1 | Электромагнитный клапан с датчиком положения PNP типа, нормально закрытый, сталь, с комплектом ответных фланцев, прокладок, крепежа (КОФ) | ВН8Н-1П | Термобрест | шт | 1 | 148

2.АРМ оператора
Пульт АРМ оператора | | ООО НПП «ЭСН» | шт | 1 | 20
В том числе:
ПК i3-10105 3.7GHz, 6MB/ H510/ 8GB 2666MHz/ 1TB 7200 rpm | 310H5SE | IRU | шт | 1 | 10 | 30000р
Монитор 1920x1080 FHD Monitor IPS 250 cd/m2 1000:1, 5ms, VGA, HDMI, DisplayPort, height, anti-glare, Plug and Play | P27h G4 27 | HP | шт | 1 | 4 | 22500р
Клавиатура+мышь компьютерная | Desktop MK120 USB | Logitech | шт | 1 | 0,75 | 2500р
Источник бесперебойного питания | Ippon Back Basic 650 Euro | IPPON | шт | 1 | 5 | 3500р
Прикладная программа АРМ оператора котла ДКВР4 | | ООО НПП «ЭСН» | шт | 1
Аппаратный ключ защиты | KEY USB | ООО «Прософт-Системы» | шт | 1 | 0,1 | 0р
Сервер Alpha.One+, 1.5k тегов | ONE+-SRV1.5k | ООО «Прософт-Системы» | шт | 1 | | 282000р
Полный клиент Alpha.SCADA, включает лицензию доступа к Alpha.Historian | | ООО «Прософт-Системы» | шт | 1 | | 120000р
Alpha.Historian Standard на 500 тегов | HIST-S500 | ООО «Прософт-Системы» | шт | 1 | | 99000р

3.Шкафы управления
| ШОА | Шкаф общекотельной автоматики | ШУ-7-32.32.16.0-4.1.1-0.0-35701 | ООО НПП "ЭСН" | шт | 1 | 247
| ШУПЧв | Шкаф управления преобразователями частоты вентиляторов | ШУП-0-13-2х11000-0.0.0.0-0.0.0-35704 | ООО НПП "ЭСН" | шт | 1 | 247
| ШУПЧд | Шкаф управления преобразователями частоты дымососов | ШУП-0-13-2х37000-0.0.0.0-0.0.0-35705 | ООО НПП "ЭСН" | шт | 1 | 247
| ШАВР | Шкаф автоматического ввода резерва | ШУП-6-0-0х0-8.4.0.0-0.0.0-35706 | ООО НПП "ЭСН" | шт | 1 | 247

4.Кабельная продукция
Кабель силовой 2х1,5 | ВВГЭнг LS | Подольсккабель | м | 18 | 6
| | Кабель силовой 3х1,5 | ВВГнг LS | | Подольсккабель | м | 12 | 2
| | Кабель силовой 4х4 | ВВГнг LS | | Подольсккабель | м | 12 | 4
| | Кабель силовой 4х16 | ВВГЭнг LS | | Подольсккабель | м | 14 | 14
| | Кабель контрольный 3х0,5 | МКШнг LS | | Подольсккабель | м | 17 | 1
| | Кабель контрольный 2х0,5 | МКШнг LS | | Подольсккабель | м | 84 | 4
| | Кабель интерфейсный 4х2х0,52 | FTP cat5e | | Подольсккабель | м | 42 | 1,6
изм | к.уч. | лист | N докум | подпись | дата
| | | | Автоматизация. Общекотельное оборудование | Стадия | Лист | Листов
| | | | | РД | 1 | 2

формат А3

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

357-22-АГСВ.СО

Согласовано

Разработ. | Чураков
| | Спецификация оборудования и материалов | ООО НПП "ЭСН"
инв Н.контр.

№ подл

. подп.

и дата взамен инв

№

Позиция | Наименование и техническая характеристика | Тип,марка,обозначение документа, опросного листа | Завод-изготовитель код оборудования, изделия, материала | Едини. изме- рения | Коли- чество | Масса един кГ | Примечание
1 | 2 | 3 | 5 | 6 | 7 | 8 | 9
| Кабель силовой 4х150 | ВВГнг LS | Подольсккабель | м | 30 | 180
| Гофра ПВХ с протяжкой | Ф16мм | DKC | м | 29 | 1
| Гофра ПВХ с протяжкой | Ф25мм | DKC | м | 6 | 0,2
| Гофра ПВХ с протяжкой | Ф90мм | DKC | м | 6 | 0,2

5.ЗИП
Прибор контроля загазованности по угарному газу | RGDCO0MP1 | Seitron | шт | 1 | 0,4
Прибор контроля загазованности по метану | RGDMETMP1 | Seitron | шт | 1 | 0,4
Электромагнитный клапан с датчиком положения PNP типа, нормально закрытый, сталь, с (КОФ) | ВН8Н-1П | Термобрест | шт | 1 | 148
изм | к.уч. | лист | N докум | подпись | дата | Лист

формат А3

357-22-АГСВ.СО | 2

инв.

№ подл

. дата

и подп

. взамен инв.

№

№ кабеля | Марка кабеля, количествожил, сечение проводников | Источник подключения | Приемник подключения | Способ защиты | Едини. изме- рения | Коли- чество | Масса един (кГ) | Примечание
1 | 2 | 3 | 4 | 5 | 6 | 7 | 8 | 9
1 | ВВГЭнг LS 2х1,5 | ШАВР/SF3 | ШОА/1QF | Кабельный лоток | м | 18
| | | | Гофра ПВХ 16мм | м | 5
2 | МКШнг LS 3х0,5 | ШОА/XT1 | 0g0Mv1 | Кабельный лоток | м | 12
| | | | Гофра ПВХ 16мм | м | 2
3 | МКШнг LS 3х0,5 | ШОА/XT1 | 0x0CO1 | Кабельный лоток | м | 5
| | | | Гофра ПВХ 16мм | м | 1
4 | МКШнг LS 2х0,5 | ШОА/XT1 | 0x0CH1 | Кабельный лоток | м | 24
| | | | Гофра ПВХ 16мм | м | 5
5 | МКШнг LS 2х0,5 | ШОА/XT1 | 0x0CH2 | Кабельный лоток | м | 60
| | | | Гофра ПВХ 16мм | м | 2
6 | ВВГнг LS 3х1,5 | ШОА/XT2 | 0g0Mv1 | Кабельный лоток | м | 12
| | | | Гофра ПВХ 16мм | м | 2
7 | ВВГнг LS 4х4 | ШУПЧв/FC1 | 1a0fMf1 | Кабельный лоток | м | 6
| | | | | | | | Гофра ПВХ 25мм | м | 3
| | | | 8 | ВВГнг LS 4х4 | ШУПЧв/FC2 | 2a0fMf1 | Кабельный лоток | м | 6
| | | | | | | | Гофра ПВХ 25мм | м | 3
| | | | 9 | ВВГЭнг LS 4х16 | ШУПЧд/FC1 | 1f0fMf2 | Кабельный лоток | м | 7
| | | | | | | | Гофра ПВХ 90мм | м | 3
| | | | 10 | ВВГЭнг LS 4х16 | ШУПЧд/FC2 | 2f0fMf2 | Кабельный лоток | м | 7
| | | | | | | | Гофра ПВХ 90мм | м | 3
| | | | 11 | FTP cat5e 4x2x0,52 | ШОА/А3/port1 | ШУК1/А2.2/port5 | Кабельный лоток | м | 12
| | | | | | | | Гофра ПВХ 16мм | м | 4
| | | | 12 | FTP cat5e 4x2x0,52 | ШОА/А3/port2 | ШУК2/А2.2/port5 | Кабельный лоток | м | 14
| | | | | | | Гофра ПВХ 16мм | м | 4
| | | 13 | FTP cat5e 4x2x0,52 | ШОА/А3/port4 | АРМ | Кабельный лоток | м | 16
| | | | | | | Гофра ПВХ 16мм | м | 4
изм | к.уч. | лист | N докум | подпись | дата
| | | | Автоматизация. Общекотельное оборудование | Стадия | Лист | Листов
| | | | | РД | 1 | 2
Проверил | Шакиров | | | Кабельный журнал | ООО НПП "ЭСН"

Согласовано

357-22-АГСВ.КЖ

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

взамен инв

№

Н. контр. Корепанов

подп.

и дата

формат А3

инв.

№ подл

. Разраб. Чураков

№ кабеля | Марка кабеля, количествожил, сечение проводников | Источник подключения | Приемник подключения | Способ защиты | Едини. изме- рения | Коли- чество | Масса един кГ | Примечание
1 | 2 | 3 | 4 | 5 | 6 | 7 | 8 | 9
14 | ВВГнг LS 4х150 | Сборка №1 | ШАВР/1QF1 | Кабельный лоток | м | 15
15 | ВВГнг LS 4х150 | м | 15
к.уч. | лист | N докум | подпись | дата | лист
2

формат А3

инв

.№подл

изм
357-22-АГСВ.КЖ

дата

и подп

. взамен инвю№

Сборка №2 | ШАВР/1QF2 | Кабельный лоток

№ поз. | | Для расчета сметных норм | Распределение каналов по принадлежности
поз. по ФСА | Описание сигнала | КПТС-ТОУ | ТОУ-КПТС | Оп-КПТС | | к подсистемам I,II,III категории техн. сложности | Метрологическая сложность | Развитость информац. функций | Развитость функций управления
Кау | Кду | Каи | Кди | Каи | Кди | СмС | I | II | III | КаиМ1 | КаиМ2 | КаиМ3 | КиИ1 | КиИ2 | КиИ3 | КуУ1 | КуУ2 | КуУ3
ШОА/HL2SB1 | Открыть/закрыть отсечной клапан | | 1 | | | | 2 | | | | 3 | | | | | 2 | | | 1
ШОА/SB2 | Сброс звукового сигнала | | | | | | 1 | | | | 1 | | | | | 1
ШОА/SB1 | Аварийный останов котельной | | | | | | 1 | | | | 1 | | | | | 1
ШОА/HA1 | Звуковая сигнализация | | 1 | | | | | | | | 1 | | | | | | | | 1
ШОА/HL1 | Светодиод "Питание 220В" | | 1 | | | | | | | | 1 | | | | | | | | 1
ШОА/HL2 | Светодиод "Предупреждение" | | 1 | | | | | | | | 1 | | | | | | | | 1
ШОА/HL3 | Светодиод "Авария" | | 1 | | | | | | | | 1 | | | | | | | | 1
ШОА/HL4 | Светодиод "Работа" | | 1 | | | | | | | | 1 | | | | | | | | 1
ШУПЧв/1SB | Аварийный стоп ПЧ №1 | | | | | | 1 | | | | 1 | | | | | 1
ШУПЧв/2SB | Аварийный стоп ПЧ №2 | | | | | | 1 | | | | 1 | | | | | 1
ШУПЧв/1HL1 | Контроль наличия питания ПЧ №1 | | 1 | | | | | | | | 1 | | | | | | | | 1
ШУПЧв/2HL1 | Контроль наличия питания ПЧ №2 | | 1 | | | | | | | | 1 | | | | | | | | 1
ШУПЧв/1HL2 | Контроль работы ПЧ №1 | | 1 | | | | | | | | 1 | | | | | | | | 1
ШУПЧв/2HL2 | Контроль работы ПЧ №2 | | 1 | | | | | | | | 1 | | | | | | | | 1
ШУПЧв/1HL3 | Контроль аварии ПЧ №1 | | 1 | | | | | | | | 1 | | | | | | | | 1
ШУПЧв/2HL3 | Контроль аварии ПЧ №2 | | 1 | | | | | | | | 1 | | | | | | | | 1
ШУПЧд/1HL1 | Контроль наличия питания ПЧ №1 | | 1 | | | | | | | | 1 | | | | | | | | 1
ШУПЧд/2HL1 | Контроль наличия питания ПЧ №2 | | 1 | | | | | | | | 1 | | | | | | | | 1
ШУПЧд/1HL2 | Контроль работы ПЧ №1 | | 1 | | | | | | | | 1 | | | | | | | | 1
ШУПЧд/2HL2 | Контроль работы ПЧ №2 | | 1 | | | | | | | | 1 | | | | | | | | 1
ШУПЧд/1HL3 | Контроль аварии ПЧ №1 | | 1 | | | | | | | | 1 | | | | | | | | 1
ШУПЧд/2HL3 | Контроль аварии ПЧ №2 | | 1 | | | | | | | | 1 | | | | | | | | 1
0g0Mv1 | Отсечной клапан | | 1 | | 1 | | | | | | 2 | | | | | 1 | | | 1
0x0CO1 | Загазованность CO 1..2 уровни | | | | 2 | | | | | | 2 | | | | | 2
0x0CH1 | Загазованность СН4 (котельная) | | | | 1 | | | | | | 1 | | | | | 1
0x0CH2 | Загазованность СН4 (ГРП) | | | | 1 | | | | | | 1 | | | | | 1
| Контроль аварий общекотельного оборудования | | | | 4 | | | | | | 4 | | | | | 4
| 0 | 19 | 0 | 9 | 0 | 6 | 0 | 0 | 0 | 34 | 0 | 0 | 0 | 0 | 15 | 0 | 0 | 19 | 0
| Кау | Кду | Каи | Кди | Каи | Кди | СмС | КобщI | КобщII | КобщIII | КаиМ1 | КаиМ2 | КаиМ3 | КобщиИ1 | КобщиИ2 | КобщиИ3 | КобщуУ1 | КобщуУ2 | КобщуУ3
Кобщу = 19 | | | Кобщи = 15 | | | | 0 | Кобщ = | | 34 | Каи = | | 0 | Кобщи = | | 15 | Кобщу = | | 19

Список каналов на ПНР по объекту 357-22 "Котельная при РХТУ, г.Москва. АГСВ"

По результатам расчета количества каналов имеем | Кобщ = | 34
| К1общ = | 0
| К2общ = | 0
| К3общ = | 34
Таким образом:
С=(1+0,313хК2общ/Кобщ)*(1+0,566*К3общ/Кобщ) = | | 1,566
На основании расчета величина получившегося коэффициента С удовлетворяет условию № | 3
Принимая это во внимание базовая норма сложной системы Нбсл будет расчитываться исходя из | | 3 | категории
технической сложности системы управления с применением к ней результирующего коэффициента С= | | 1,0000

Расчет коэфициентов
М = (1+0,14*КаиМ2/Каи) * (1+0,51*КаиМ3/Каи) = | (1+0,14*0/0)*(1+0,51*0/0) = | 1
И = (1+0,51*КобщиИ2/Кобщи) * (1+1,03*КобщиИ3/Кобщи) = | (1+0,51*15/15)*(1+1,03*0/15) = | 1,51
У = (1+0,61* КобщуУ2 / Кобщу)*( 1+1,39* КобщуУ3 / Кобщу) = | (1+0,61 * 19/19) * (1+ 1,39*0/19) = | 1,61
Фми = 0,5+ Каи / Кобщи * М * И = | 0,5 + 0/15 * 1 * 1,51 = | 0,5000
Фу = 1,0+(1,3* Кау + 0,95* Кду )/ КобщАСУ * У = | 1,0+(1,3*0 + 0,95*19)/34*1,61= | 1,8547
(Фим x Фу) = | | 0,9274

Для расчета сметных норм:

Количество сигналов системы управления | Кобщ = | 34
Категория сложности системы | атег. т.с. = | 3
Коэффициент к заработной плате | Козп = | 0,9274

Исчисление объемов работ.

1. В соответствии с п. 2.2.2 (ТЕРп 81-05-2001-И1) Базовая норма для сложной системы, имеющие в своем составе подсистемы с разной категорией технической
С=(1+0,313хК2общ/Кобщ)*(1+0,566*К3общ/Кобщ)
где:
К1общ, К2общ, К3общ - общее количество аналоговых и дискретных каналов информационных и управления относимых к подсистемам соответственноI, II и III Кобщ = К1общ + К2общ + К3общ
В этом случае базовая норма для сложной системы расчитывается по формуле:
Нбсл=Нб1 х С; при условии 1 < C < 1,313 (УСЛОВИЕ №1)
Нбсл=Нб2 х С:1,313; при условии 1,313 < C < 1,566 (УСЛОВИЕ №2)

Таким образом по результатам расчета общий коэффициент для расчета базовой нормы сложной системы будет иметь вид:
Нслб | = Нб | 3 | х | С | х | Фми | х | Фу

или
Нслб | = Нб | 3 | х | 1 | х | 0,5000 | х | 1,8547

или
Нслб | = Нб | 3 | х | 0,9274
