nppesnteam/357-22-RHTU-DKVR-4.13/АГСВ1/АГСВ1.pdf

# Директор

# РОССИЙСКАЯ ФЕДЕРАЦИЯ

## Общество с Ограниченной Ответственностью Научно Производственное Предприятие "ЭНЕРГОСБЕРЕГАЮЩИЕ СИСТЕМЫ И НЕЙРОАВТОМАТИЗАЦИЯ г.Ижевск nppesn.ru

# /Корепанов М.И./

Регистрационный номер 1083 в реестре Ассоциации Саморегулируемой организации "Национальное объединение научно-исследовательских и проектно-изыскательских организаций" (Ассоциация СРО "ЦЕНТРСТРОЙПРОЕКТ", регистрационный номер в государственном реестре саморегулируемых организаций СРО-П-029-25092009)

# Котельная РХТУ им. Д.И. Менделеева. Приведение автоматики безопасности котлов ДКВР-4/13 в соответствие с требованиями ТР безопасности сетей газораспределения и газопотребления

# 357-22-АГСВ1

Автоматизация.

# Котел №1 ДКВР-4/13

# Заказчик: ФГБОУ ВО "РХТУ имени Д. И. Менделеева"

# Ижевск, 2022

## Технические решения, принятые в рабочей документации, соответствуют требованиям экологических, санитарно-технических, противопожарных и других норм, действующих на территории Российской Федерации и обеспечивают безопасную для жизни и здоровья людей

эксплуатацию объекта при соблюдении предусмотренных рабочими чертежами мероприятий.

Ведомость рабочих чертежей | Ведомость ссылочных и прилагаемых документов
Лист | Примечание Наименование | Обозначение | Примечание Наименование

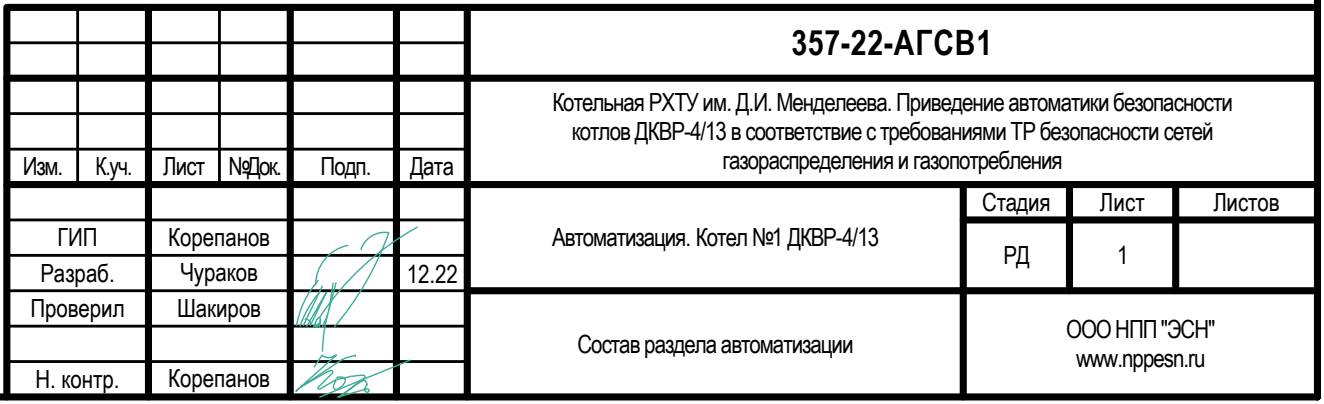
[picture p22: figure]
Стадия; Лист; Листов; Изм.; №Док.; Подп.; Дата; ОООНПП "ЭСН" www.nppesn.ru; Состав раздела автоматизации; ГИП Разраб. Проверил; Н. контр.; Чураков; Корепанов; Шакиров; Автоматизация. Котел №1 ДКВР-4/13; 357-22-АГСВ1; газораспределения и газопотребления

Котельная РХТУ им. Д.И. Менделеева. Приведение автоматики безопасности котлов ДКВР-4/13 в соответствие с требованиями ТР безопасности сетей

## 1 Состав раздела "Автоматизация. Котел №1 ДКВР-4/13"

## на 2 листах на 8 листах

## Прилагаемые документы

357-22-АГСВ1.ТП | Автоматизация. Трубные проводки
357-22-АГСВ1.СО | Спецификация оборудования и материалов
357-22-АГСВ1.КЖ | Кабельный журнал
357-22-АГСВ1.ИО | Информационное обеспечение

## Ссылочные документы

2 | Общие указания
3 | План размещения средств автоматизации
5 | Схема внешних электрических проводок
4 | Схема функциональная
6 | Структурная схема автоматизации котельной
7 | Шкаф управления котлом
8 | Шкаф питания | на 2 листах на 2 листах

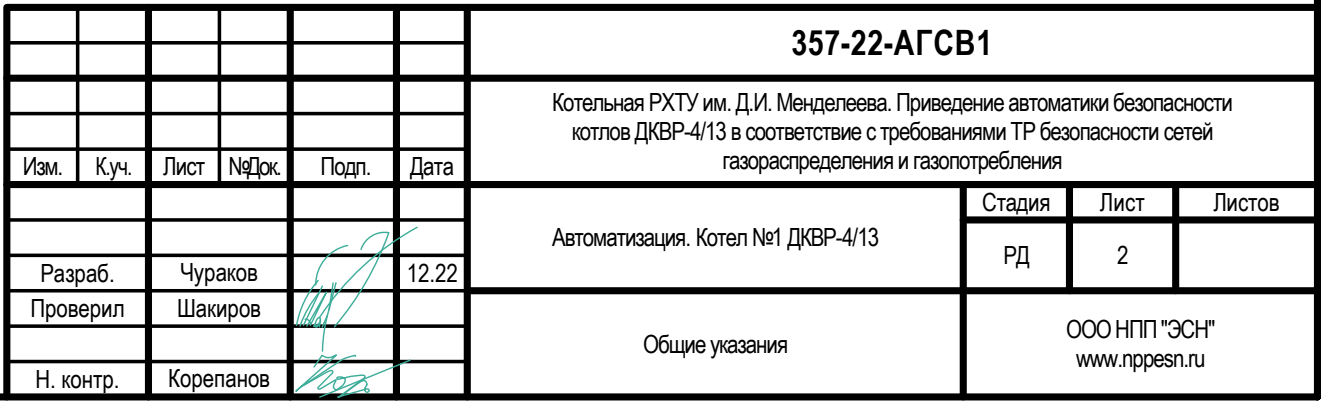
[picture p23: figure]
Стадия; Лист; Листов; Изм.; №Док.; Подп.; Дата; Автоматизация. Котел №1 ДКВР-4/13; газораспределения и газопотребления; 357-22-АГСВ1; Общие указания; 2 Разраб.

Котельная РХТУ им. Д.И. Менделеева. Приведение автоматики безопасности котлов ДКВР-4/13 в соответствие с требованиями ТР безопасности сетей

## Общие указания

Рабочая документация по автоматизации котла разработана на основании договора подряда ,

## в соответствии с нормами и правилами, действующими на период 12.2022г. в части

автоматизации котельных установок и газоснабжения.

## Данным рабочим проектом предусматривается полная автоматизация работы котла ДКВР-4/13, которая обеспечивает оснащение каждой газовой горелки котла: а) электромагнитным клапаном запальника, предназначенными для подачи газа на запальник

горелки во время пуска котла;

## б) электромагнитным клапаном опрессовки, предназначенным для подачи газа в газопровод

между отсечными клапанами и дальнейшей проверкой их герметичности;

## в) двумя, расположенными последовательно по ходу газа электромагнитными отсечными клапанами и нормально открытым клапаном безопасности, расположенным между ними и

связанным с атмосферой;

## г) датчиком давления, обеспечивающего проверку герметичности затворов отсечных клапанов

перед розжигом горелки;

## д) регулирующей газовой заслонкой расположенной за вторым отсечным клапаном перед

горелкой;

## е) датчиком давления, измеряющим давление перед горелкой для регулирования

соотношения газ-воздух;

## ж) защитно-запальным устройством, обеспечивающим автоматический розжиг и контроль

факела горелки;
з) датчиком-сигнализатором наличия факела запальника , факела горелки;

## Система защиты парового котла предусматривает прекращение подачи газа к горелке в случаях :

а) повышения давления газа в коллекторе;
б) понижения давления газа в коллекторе;
в) повышения давления газа перед горелкой; г) понижения давления газа перед горелкой;
д) негерметичности отсечных клапанов;
е) понижения разрежения в топке котла;
ж) понижения давления воздуха перед горелкой; з) погасания факела запальника;
и) погасания факела горелки;
к) повышения давления пара в барабане котла;
л) прекращения подачи электроэнергии или исчезновения напряжения в цепях защиты.

## Автоматика безопасности, при ее отключении или неисправности, обеспечивает блокировку

подачи газа в ручном режиме.

## Система управления котлом обеспечивает автоматическое регулирование и поддержание в

заданных режимах давления воздуха и газа перед горелками, разрежения в топке котла, давления пара и уровня воды в барабане котла.
Для контроля над работой котла предусмотрены измерители давления газа , воздуха, питательной воды, пара, разрежения в топке котла, температуры уходящих газов, уровня воды в

## барабане котла. Контроль тока двигателей дымососа и вентилятора предусмотрен по показаниям табло частотных преобразователей. Регистрация параметров котла производится

контроллером шкафа управления и дублируется на АРМ оператора.

В качестве устройства контроля, управления, сигнализации и защиты котла применяется программируемый многофункциональный контроллер REGUL R500, производства инженерной компании "Прософт-Системы" г.Екатеринбург с блоками аналоговых, и дискретных входов/выходов REGUL R500, имеющий разрешение к применению на опасных промышленных объектах подконтрольных Ростехнадзору. Контроллер обеспечивает работу систем

регулирования в режиме автоматических ПИД-регуляторов, программный пуск, и останов котла, прекращение подачи газа при срабатывании защит, фиксацию первопричины аварии.

## В качестве датчиков измерения давления используются преобразователи давления ЗОНД-10

производства НПП "Гидрогазприбор" г. Зеленоград, имеющие аналоговый токовый выход.

## Регулирование давления газа производится поворотными заслонками на газопроводе перед

горелкой при помощи приводных механизмов МЭОФ.

## Измерение температурных параметров производится датчиками температуры ПТ-204 производства НПП "ПРОМА" г. Казань, с нормирующими преобразователями, имеющими

токовый выход.

## Регулирование уровня воды в барабане котла производится поворотными заслонками на

трубопроводе питательной воды при помощи приводных механизмов МЭОФ.

## Управление разрежением и давлением воздуха предусмотрено изменением частоты вращения двигателей дымососа и вентилятора с помощью преобразователей частоты. Для установки рабочего положения предусмотрено управление заслонками направляющих аппаратов

вентилятора, дымососа при помощи приводных механизмов МЭО.

## Все параметры работы котла в виде дискретных и аналоговых сигналов вводятся в контроллер REGUL R500, работающий в паре с сенсорным монитором размером 12,1". На

монитор выводятся необходимые для наблюдения величины: температура, давление, расход, уровень.

В случае аварийной остановки котла выводятся сведения о причине аварии, время и параметры работы котла на момент останова. Дополнительно включается звуковой сигнал и световой сигнал «Авария» на шкафу управления. Управление вводом требуемых параметров и режимами отображения производится виртуальными кнопками на экране панели или с АРМ

оператора.

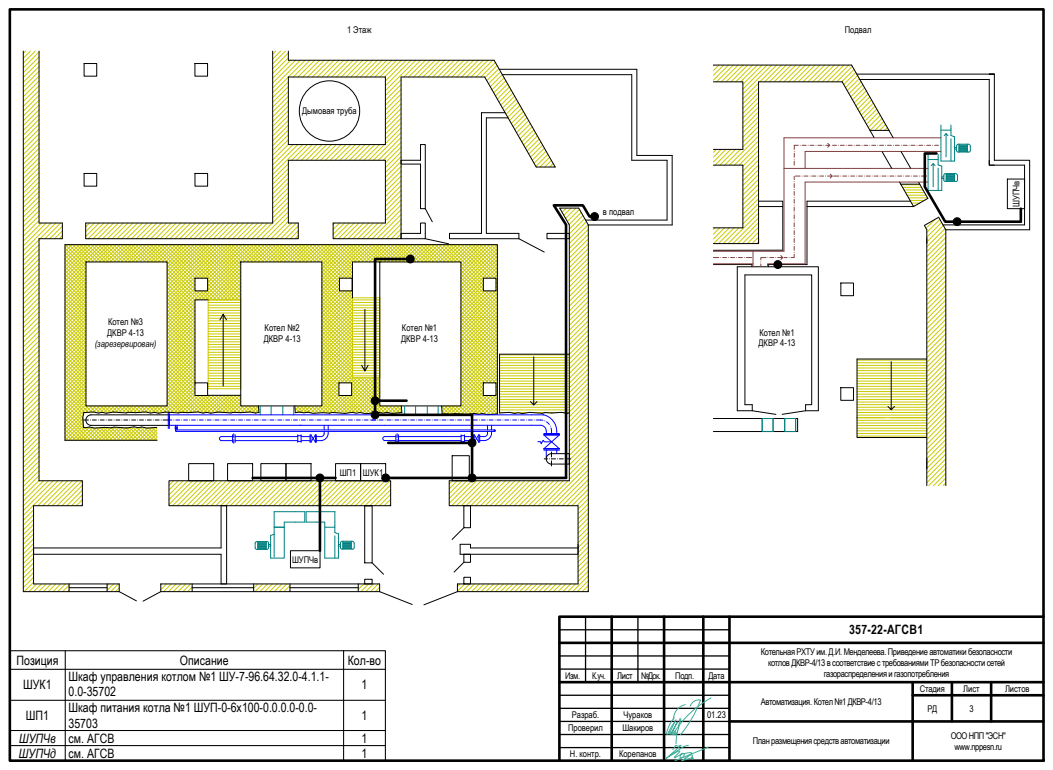
[picture p24: page 4]
Стадия; Лист; Листов; Изм.; №Док.; Подп.; Дата; газораспределения и газопотребления; 357-22-АГСВ1; 3 Разраб.; 1 Этаж; Котел №1 ДКВР 4-13; Подвал; ШУПЧв; Позиция; Описание; Кол-во; Котел №2 ДКВР 4-13; Котел №3 ДКВР 4-13 (зарезервирован); Дымовая труба; ШП1 ШУК1; в подвал

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

ШУК1 | Шкаф управления котлом №1 ШУ-7-96.64.32.0-4.1.1-0.0-35702 | 1
ШП1 | Шкаф питания котла №1 ШУП-0-6х100-0.0.0.0-0.0-35703 | 1

Автоматизация. Котел №1 ДКВР-4/13

ШУПЧв | см. АГСВ | 1
ШУПЧд | см. АГСВ | 1

План размещения средств автоматизации

## Газ

## ~ PG PE Питательная

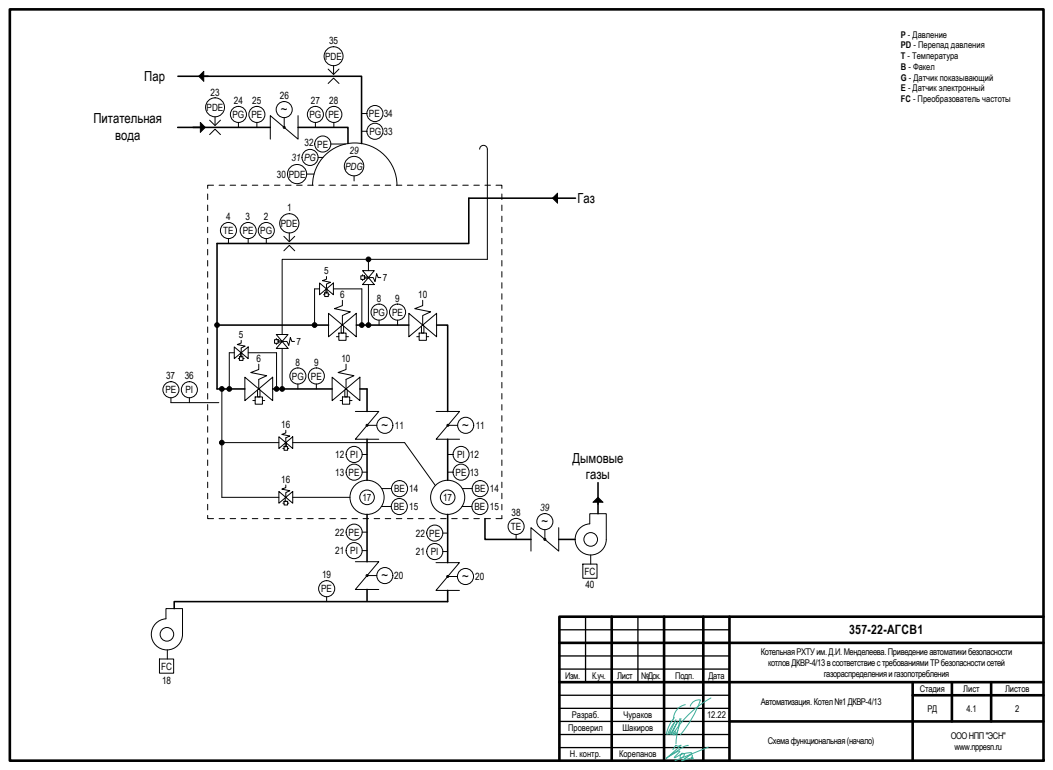
[picture p25: page 5]
Стадия; Лист; Листов; Изм.; №Док.; Подп.; Дата; газораспределения и газопотребления; 357-22-АГСВ1; Схемафункциональная (начало); 4.1 Разраб.; PDE; PG PDE; вода; Пар; PDG; Дымовые газы

P - Давление
PD - Перепад давления
T - Температура
B - Факел
G - Датчик показывающий
E - Датчик электронный
FC - Преобразователь частоты

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

Автоматизация. Котел №1 ДКВР-4/13

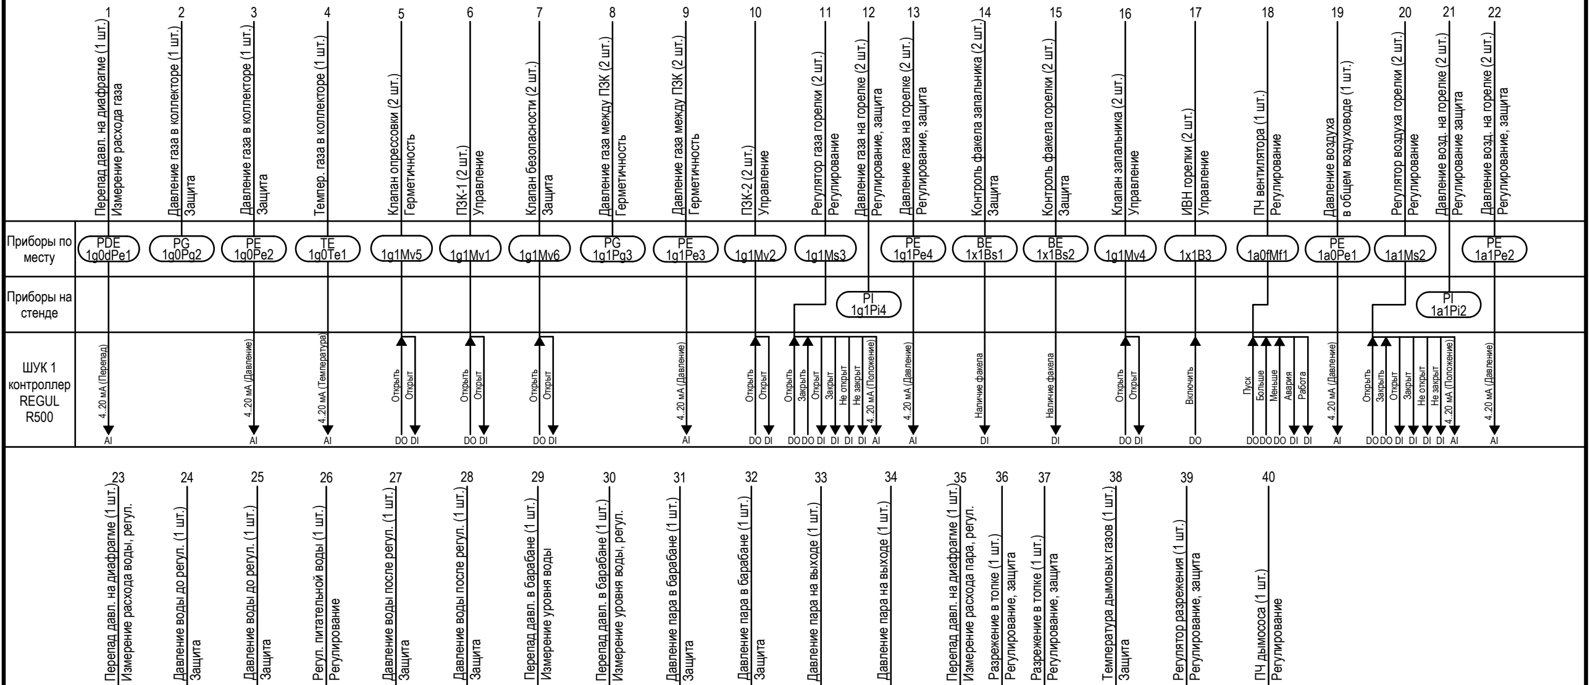
[picture p26: figure]
1g0dPe1; Перепад давл. на диафрагме (1 шт.); Измерение расхода газа; Давление газа; в коллекторе (1 шт.); Защита; Давление газа между ПЗК (2 шт.); Герметичность; Темпер. газа; Приборы по месту; Приборы на стенде; ШУК 1 контроллер REGUL R500; ПЗК-1 (2 шт.) Управление; ПЗК-2 (2 шт.) Управление; Клапан запальника (2 шт.); Управление; Регулятор газа горелки (2 шт.); Регулирование; Клапан безопасности (2 шт.); ИВН горелки (2 шт.); Давление газа на горелке (2 шт.); Регулирование, защита; а Контроль факела запальника (2 шт.); а Контроль факела горелки (2 шт.); Регулятор воздуха горелки (2 шт.)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
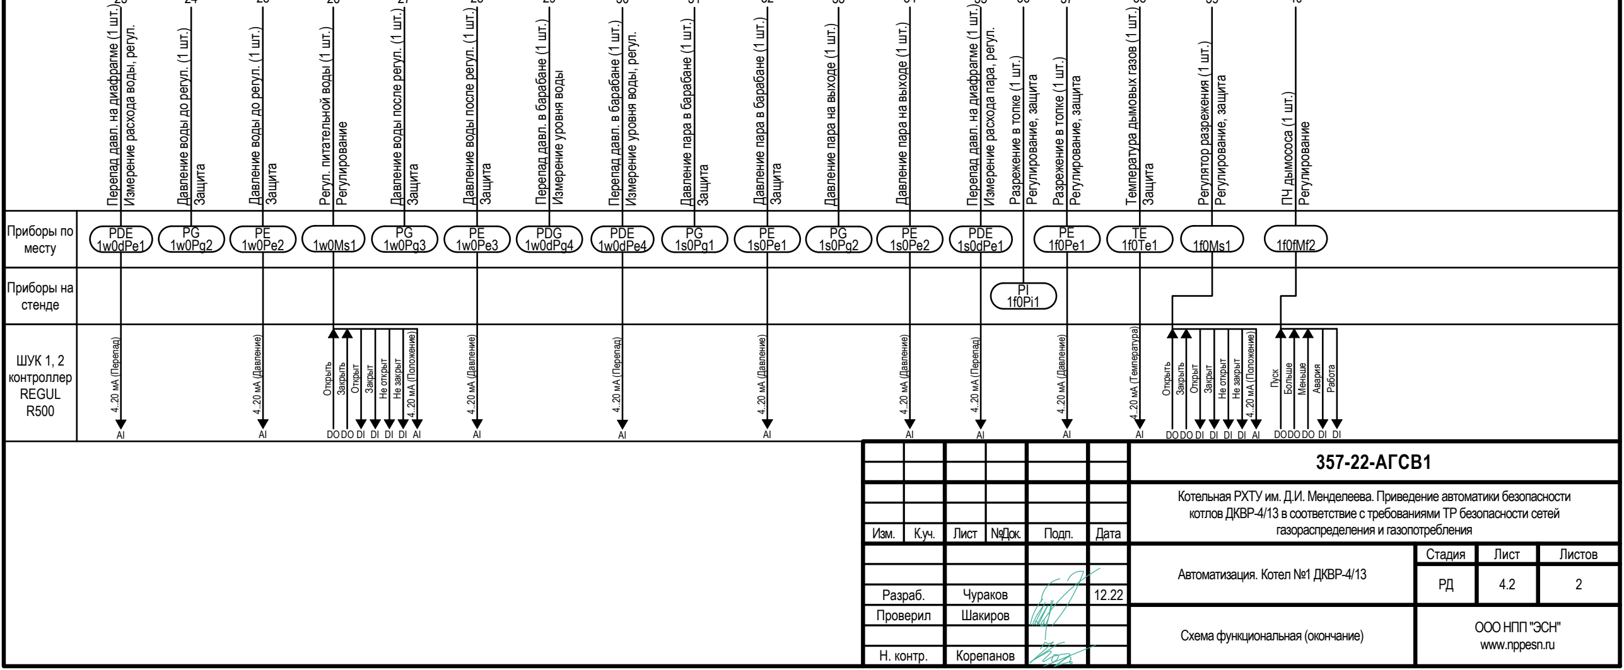
[picture p27: figure]
Стадия; Лист; Листов; Изм.; №Док.; Подп.; Дата; Автоматизация. Котел №1 ДКВР-4/13; газораспределения и газопотребления; 357-22-АГСВ1; Схемафункциональная (окончание); 4.2 Разраб.; Приборы по месту; Приборы на стенде; ШУК 1, 2 контроллер REGUL R500; Давление воды после регул. (1 шт.); Защита; Давление воды до регул. (1 шт.); Регул. питательной воды (1 шт.); Регулирование; 1w0dPe1; Перепад давл. на диафрагме (1 шт.) Измерение расхода воды, регул; 1w0dPe4; Перепад давл.; 1s0dPe1; PDE; 1w0dPg4; PDG; 1f0fMf2

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

# Давление воздуха в общем воздуховоде (1 шт.)

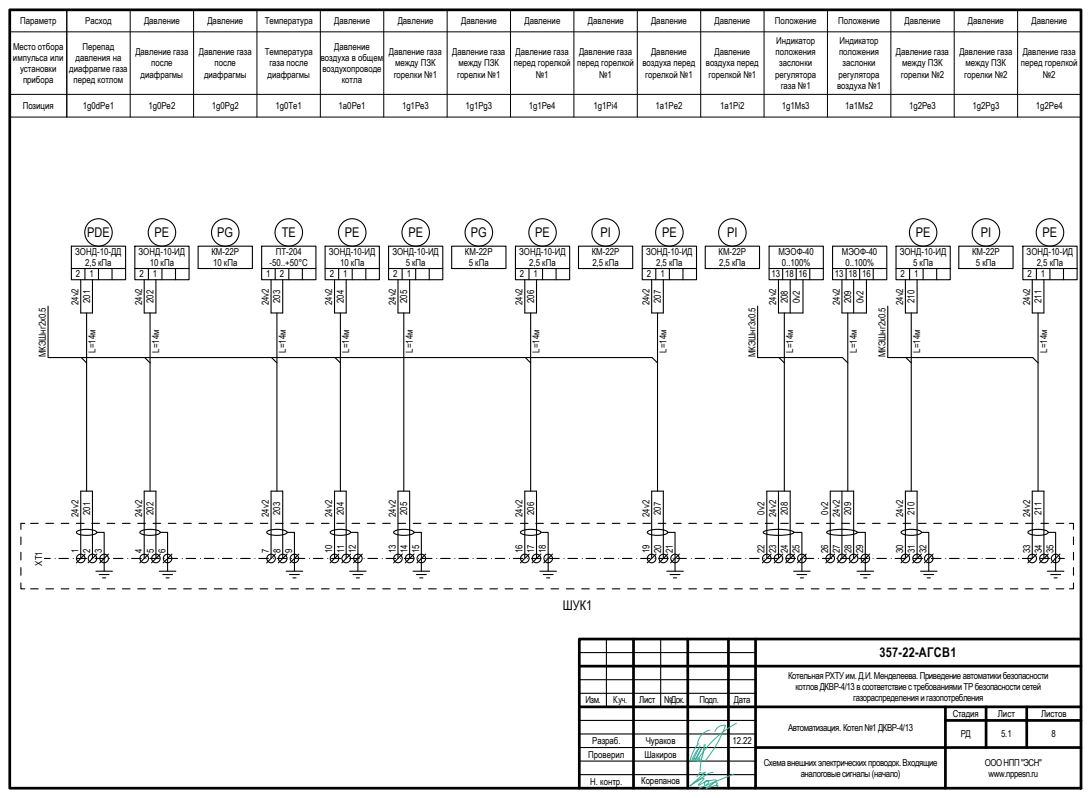
[picture p28: page 7]
Стадия; Лист; Листов; Изм.; №Док.; Подп.; Дата; РД 5.1 Разраб.; Параметр; Место отбора импульса или установки прибора; Позиция; 357-22-АГСВ1; газораспределения и газопотребления; Расход; Давление; Температура; Положение; Перепад давления на диафрагме газа перед котлом; Давление газа после диафрагмы; Температура газа после диафрагмы; Давление воздуха в общем воздухопроводе котла; Давление газа между ПЗК горелки №1; Давление газа перед горелкой №1; Давление воздуха перед горелкой №1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

Автоматизация. Котел №1 ДКВР-4/13

Схема внешних электрических проводок. Входящие
аналоговые сигналы (начало)

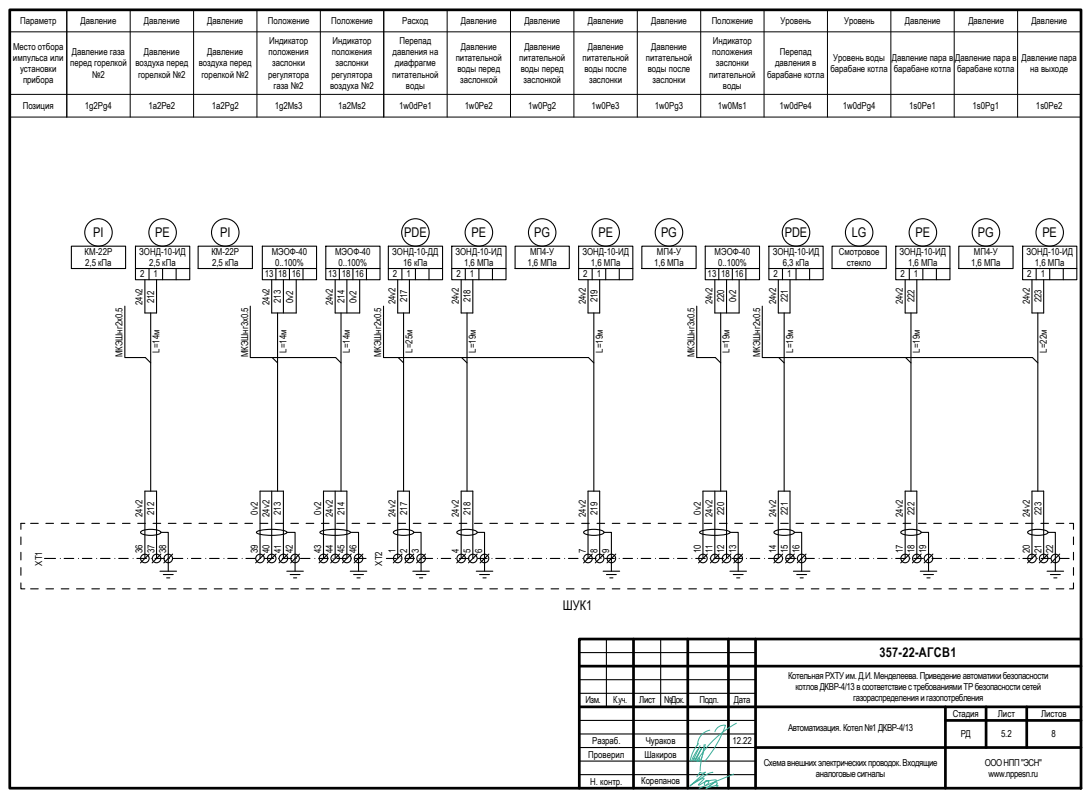
[picture p29: page 8]
Стадия; Лист; Листов; Изм.; №Док.; Подп.; Дата; аналоговые сигналы; 5.2 Разраб.; Параметр; Место отбора импульса или установки прибора; Позиция; 357-22-АГСВ1; газораспределения и газопотребления; МКЭШнг; ЗОНД-10-ДД 16 кПа; ЗОНД-10-ИД 1,6 МПа; ЗОНД-10-ИД 6,3 кПа; МЭОФ-40 0..100%; Расход; Давление; Положение; Уровень; Перепад давления на диафрагме питательной воды; Давление питательной воды перед заслонкой; Давление питательной воды после заслонки; Индикатор положения заслонки питательной воды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

Автоматизация. Котел №1 ДКВР-4/13

Схема внешних электрических проводок. Входящие

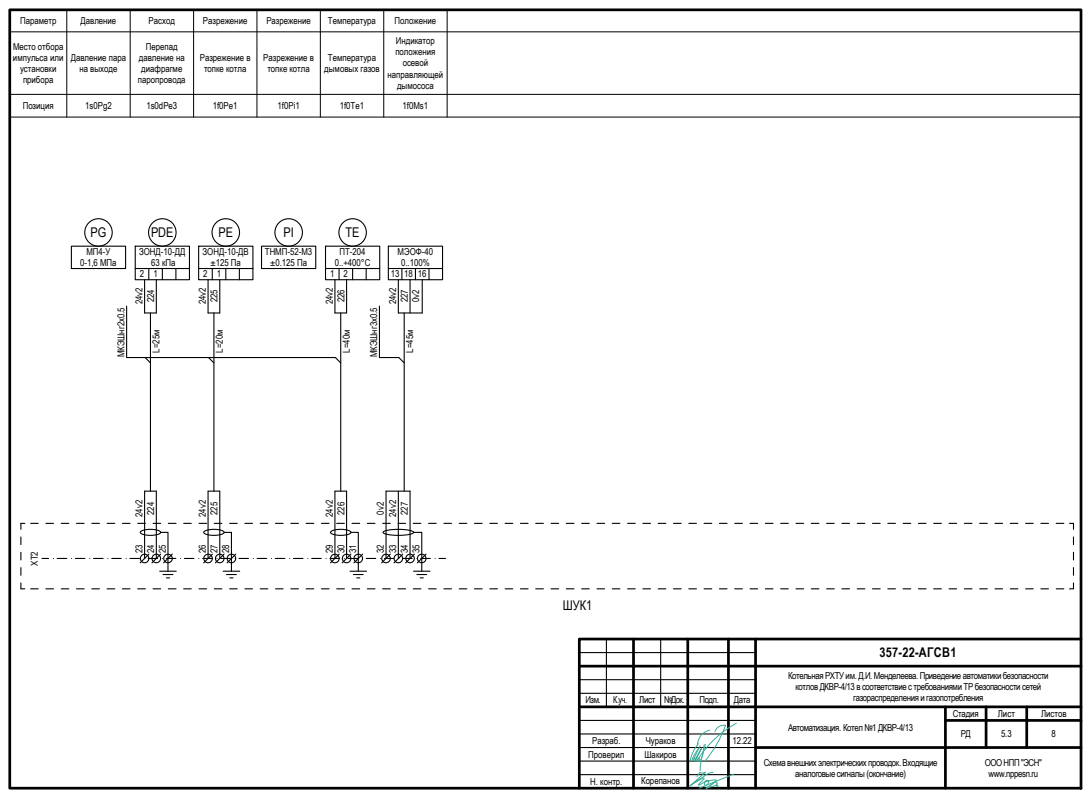
[picture p30: page 9]
Стадия; Лист; Листов; Изм.; №Док.; Подп.; Дата; РД 5.3 Разраб.; Параметр; Место отбора импульса или установки прибора; Позиция; 357-22-АГСВ1; газораспределения и газопотребления; ШУК1; ЗОНД-10-ДД 63 кПа; ЗОНД-10-ДВ ±125 Па; МЭОФ-40 0..100%; МКЭШнг; Давление; Расход; Разрежение; Температура; Положение; Давление пара на выходе; Перепад давление на диафрагме паропровода; Разрежение в топке котла; Температура дымовых газов; Индикатор положения осевой направляющей дымососа; 1s0dPe3; PDE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

Автоматизация. Котел №1 ДКВР-4/13

Схема внешних электрических проводок. Входящие
аналоговые сигналы (окончание)

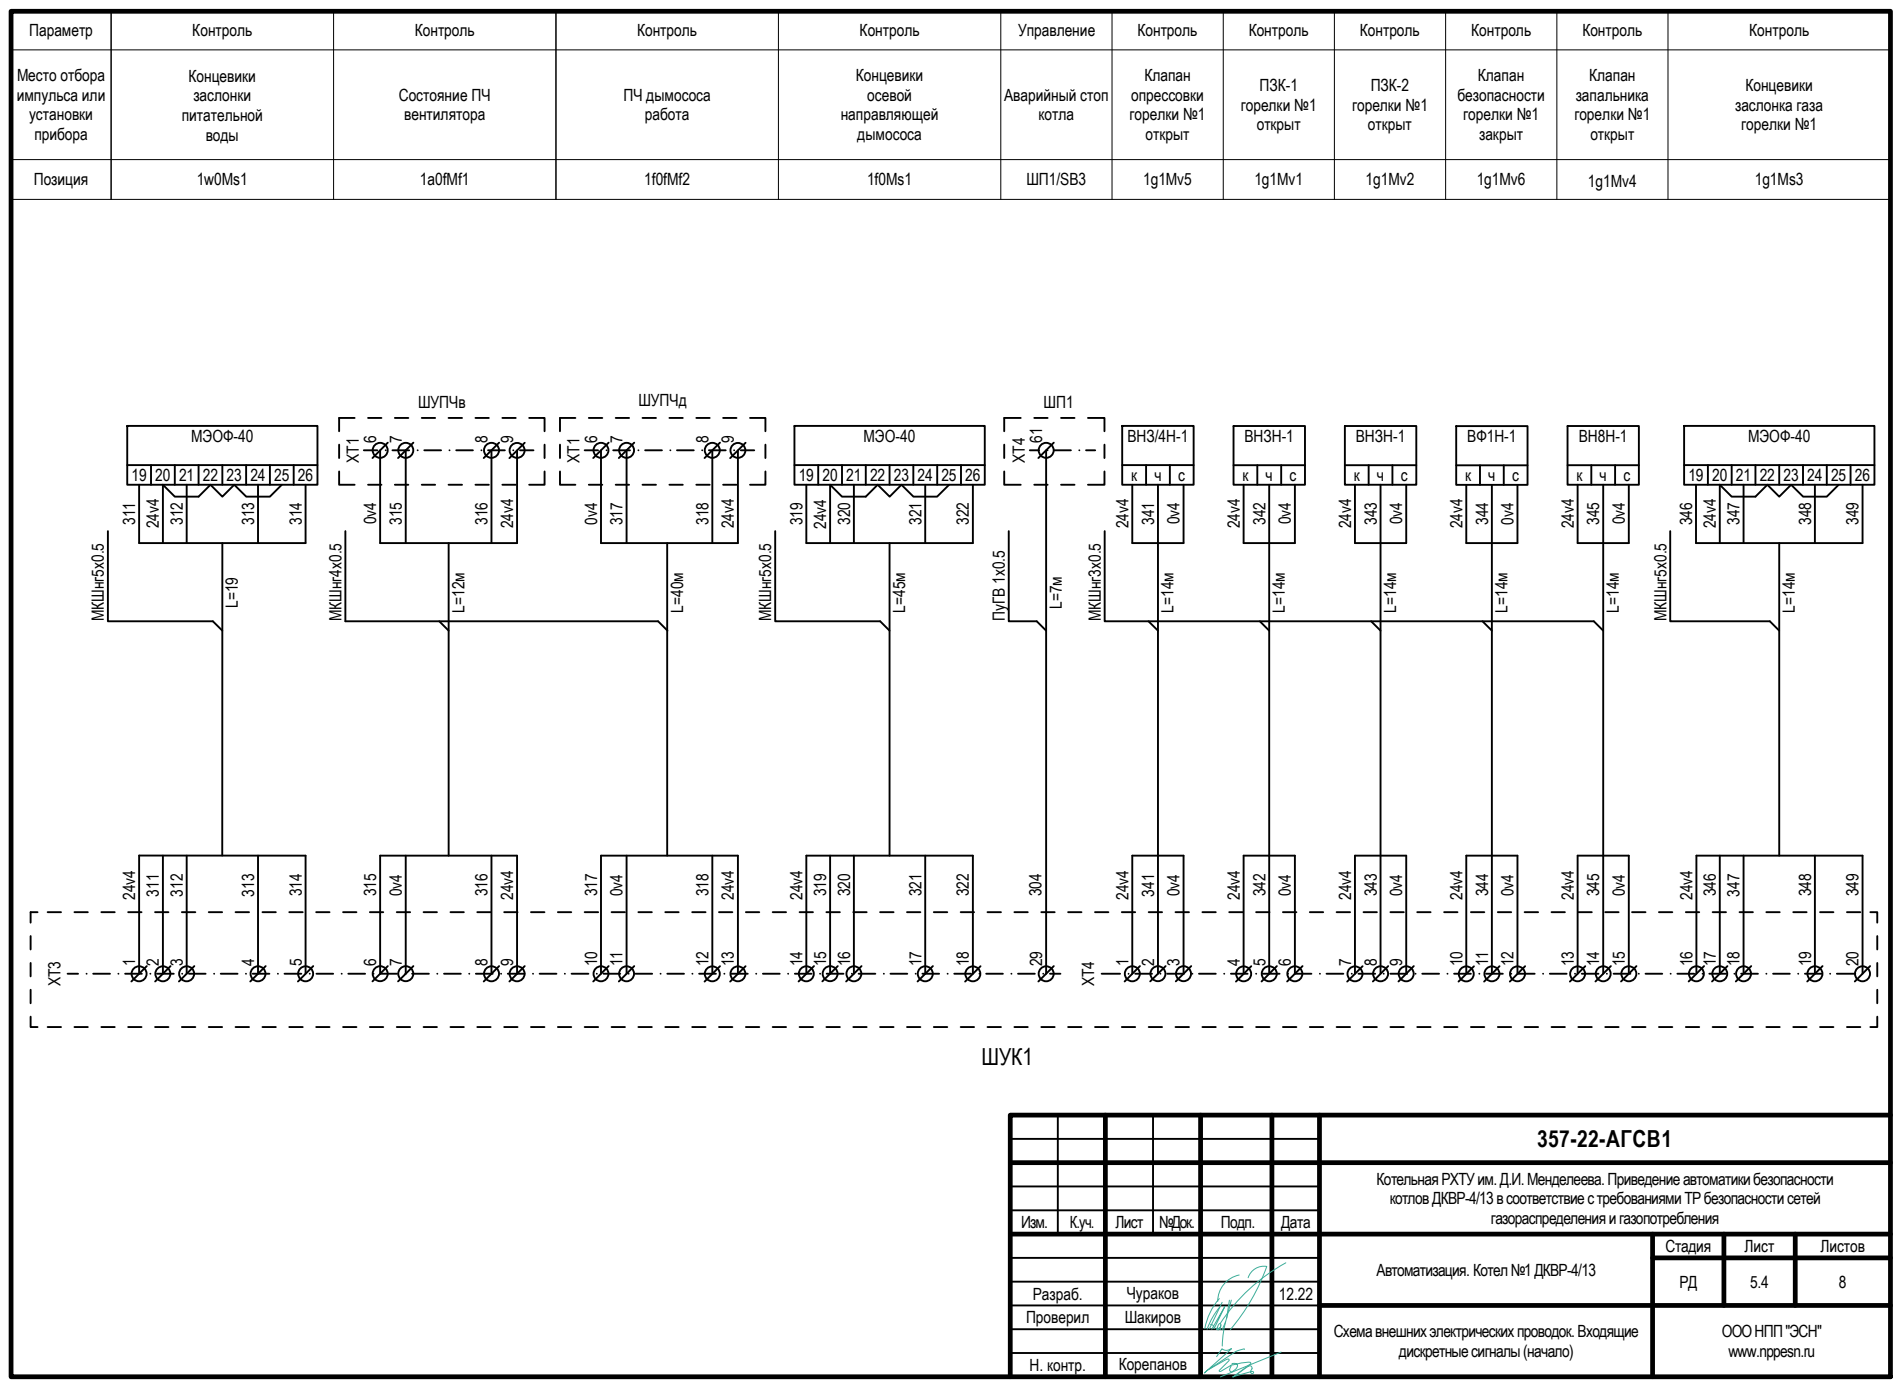
[picture p31: page 10]
Стадия; Лист; Листов; Изм.; №Док.; Подп.; Дата; РД 5.4 Разраб.; Параметр; Место отбора импульса или установки прибора; Позиция; 357-22-АГСВ1; газораспределения и газопотребления; МКШнг; Контроль; Концевики заслонки питательной воды; Состояние ПЧ вентилятора; 1a0fMf1; МЭОФ-40; ШУПЧв; ПЧ дымососа работа; Концевики осевой направляющей дымососа; 1f0fMf2; МЭО-40; ШУПЧд; Клапан опрессовки горелки №1 открыт; ПЗК-1 горелки №1 открыт; ПЗК-2 горелки №1 открыт; Клапан безопасности горелки №1 закрыт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

Автоматизация. Котел №1 ДКВР-4/13

Схема внешних электрических проводок. Входящие
дискретные сигналы (начало)

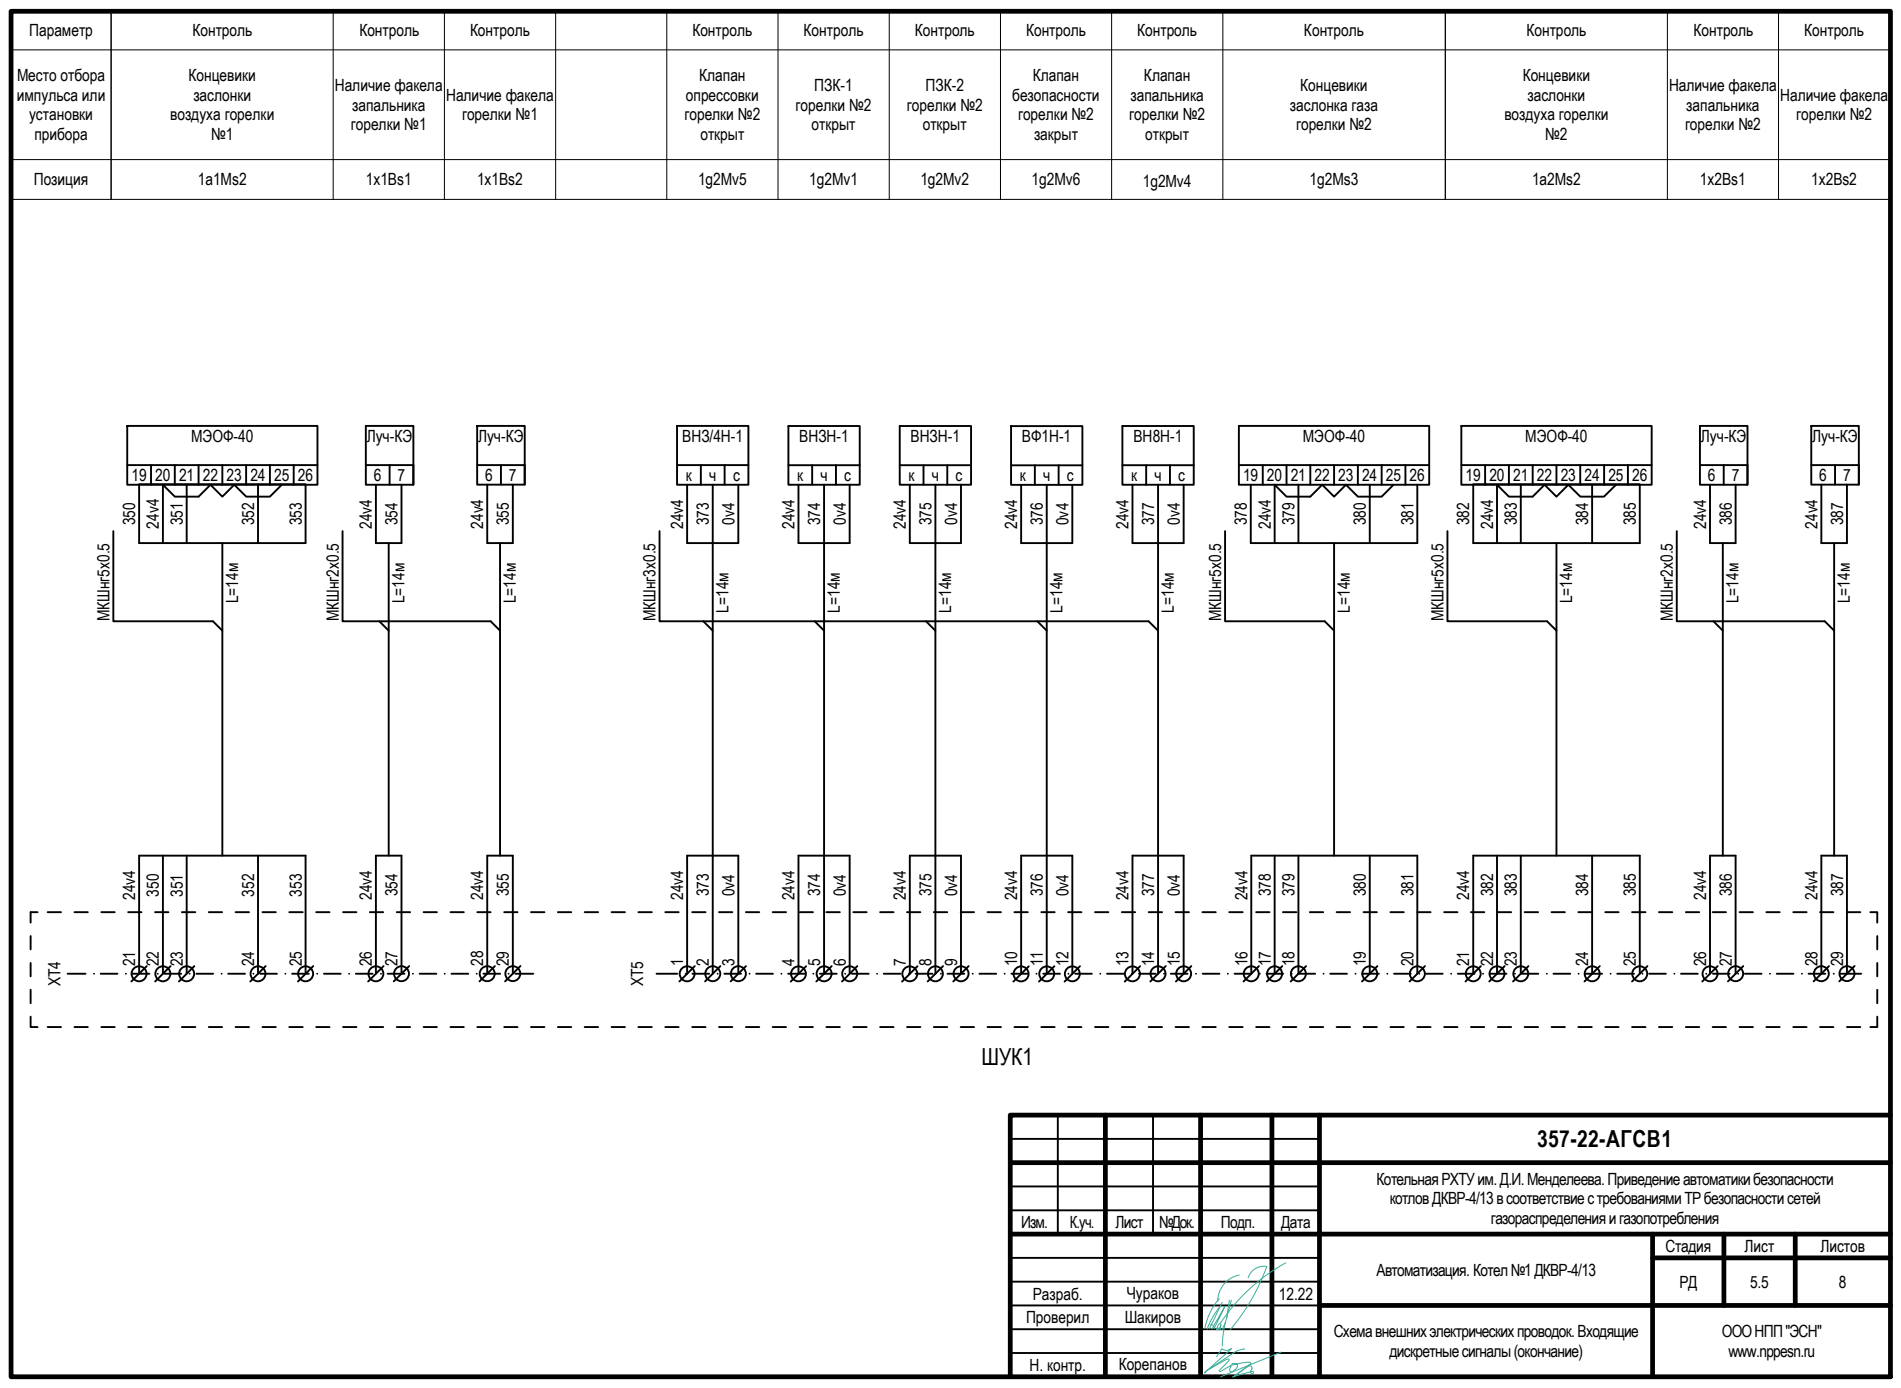
[picture p32: page 11]
Стадия; Лист; Листов; Изм.; №Док.; Подп.; Дата; РД 5.5 Разраб.; Параметр; Место отбора импульса или установки прибора; Позиция; 357-22-АГСВ1; газораспределения и газопотребления; МКШнг; Контроль; Концевики заслонки воздуха горелки №1; Наличие факела запальника горелки №1; Наличие факела горелки №1; МЭОФ-40; Луч-КЭ; ВНЗ/4Н-1; ВНЗН-1; Клапан опрессовки горелки №2 открыт; ПЗК-1 горелки №2 открыт; ПЗК-2 горелки №2 открыт; Клапан безопасности горелки №2 закрыт; Клапан запальника горелки №2 открыт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

Автоматизация. Котел №1 ДКВР-4/13

Схема внешних электрических проводок. Входящие
дискретные сигналы (окончание)

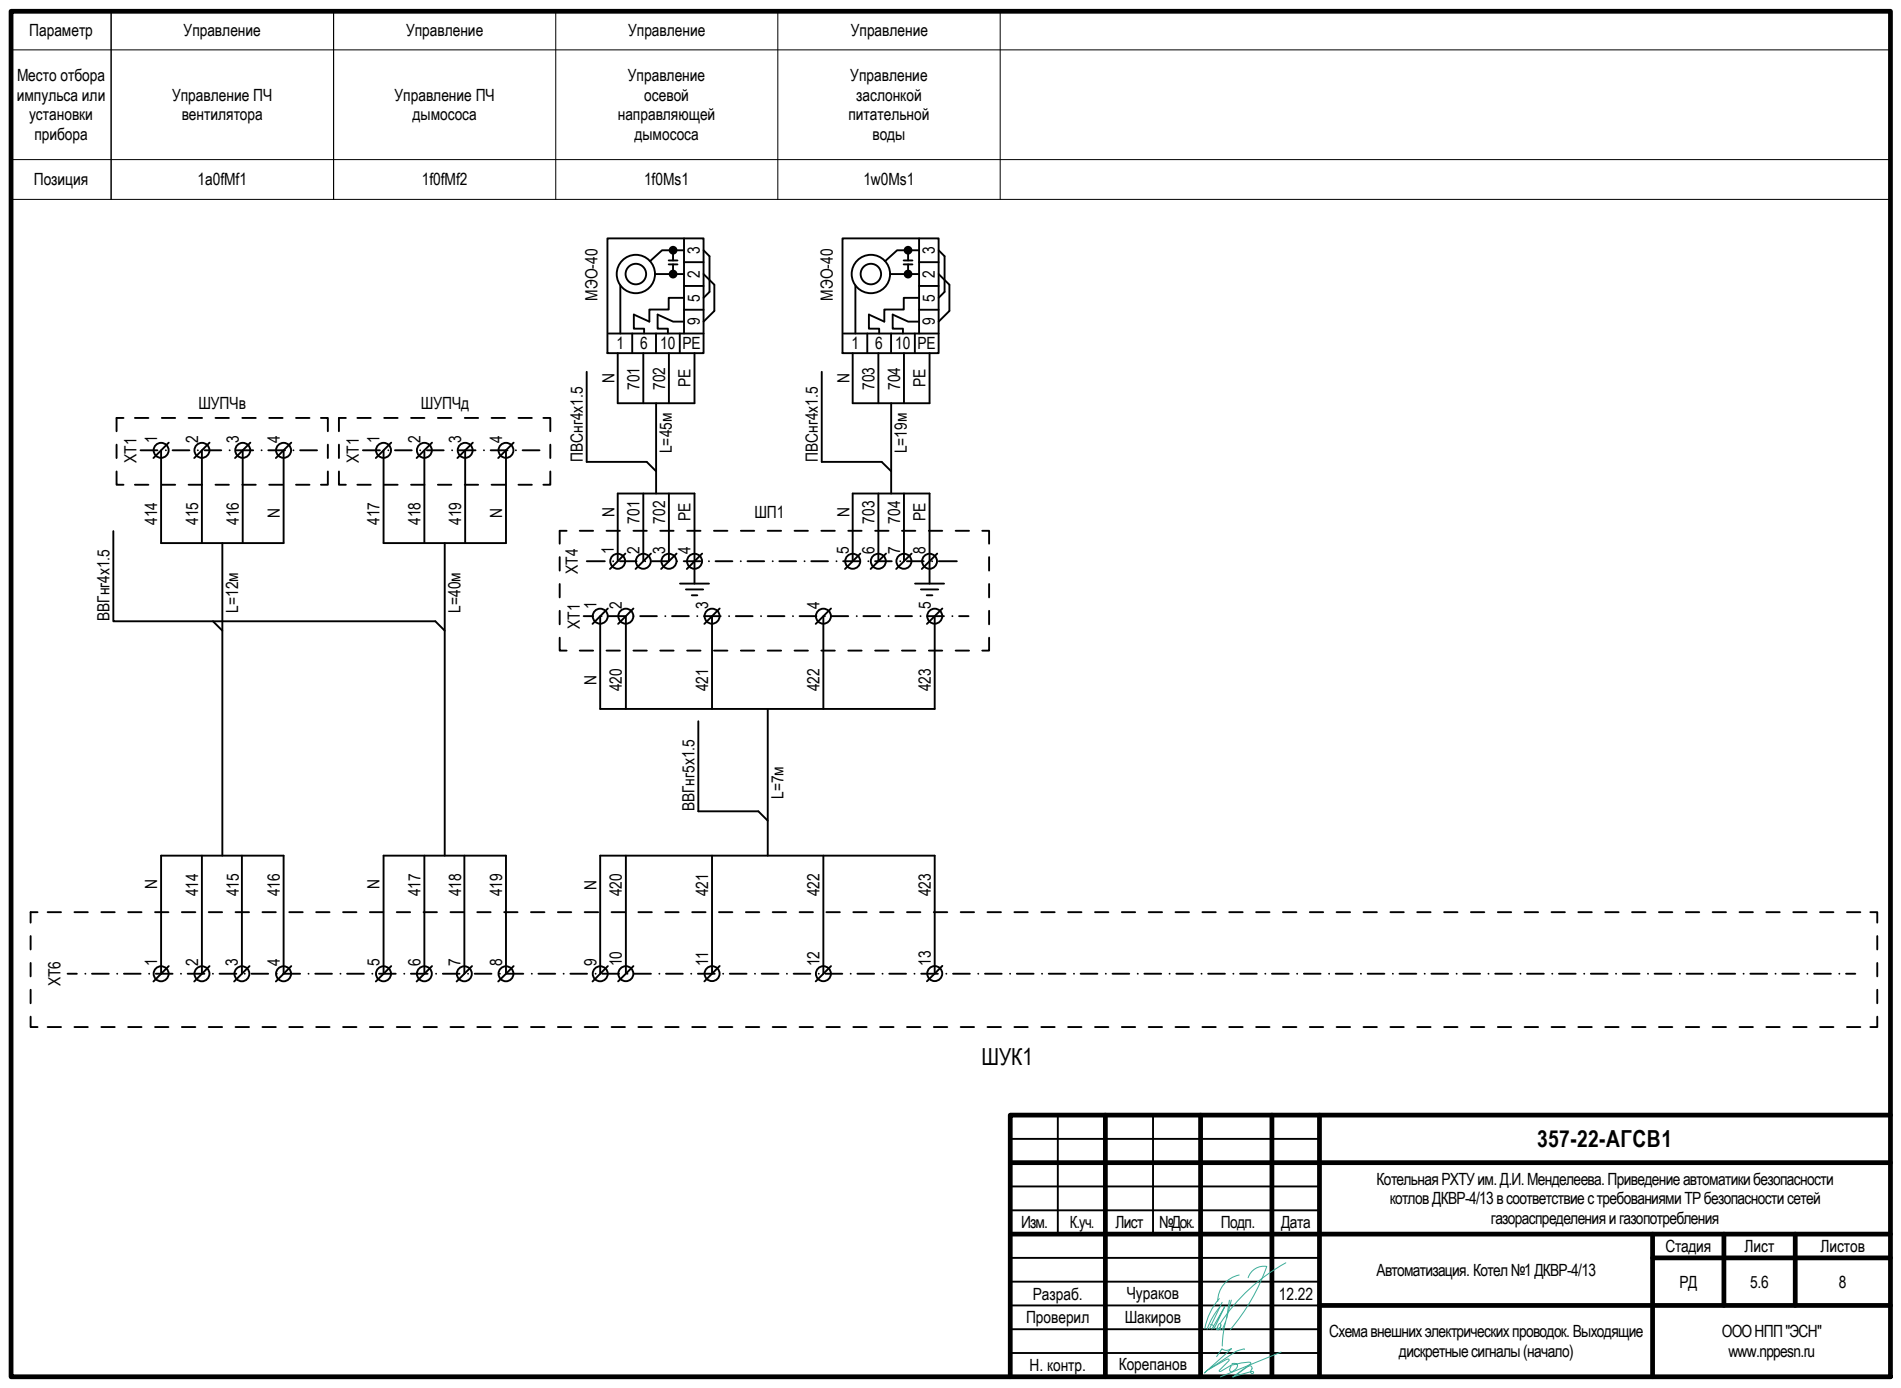
[picture p33: page 12]
Стадия; Лист; Листов; Изм.; №Док.; Подп.; Дата; РД 5.6 Разраб.; Параметр; Место отбора импульса или установки прибора; Позиция; 357-22-АГСВ1; газораспределения и газопотребления; ВВГнг; Управление; Управление ПЧ вентилятора; 1a0fMf1; ШУПЧв; Управление ПЧ дымососа; Управление осевой направляющей дымососа; 1f0fMf2; Управление заслонкой питательной воды; ПВСнг; ШУПЧд; МЭО-40; 4 PE PE ВВГнг5х1.5; ШУК1

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

Автоматизация. Котел №1 ДКВР-4/13

Схема внешних электрических проводок. Выходящие
дискретные сигналы (начало)

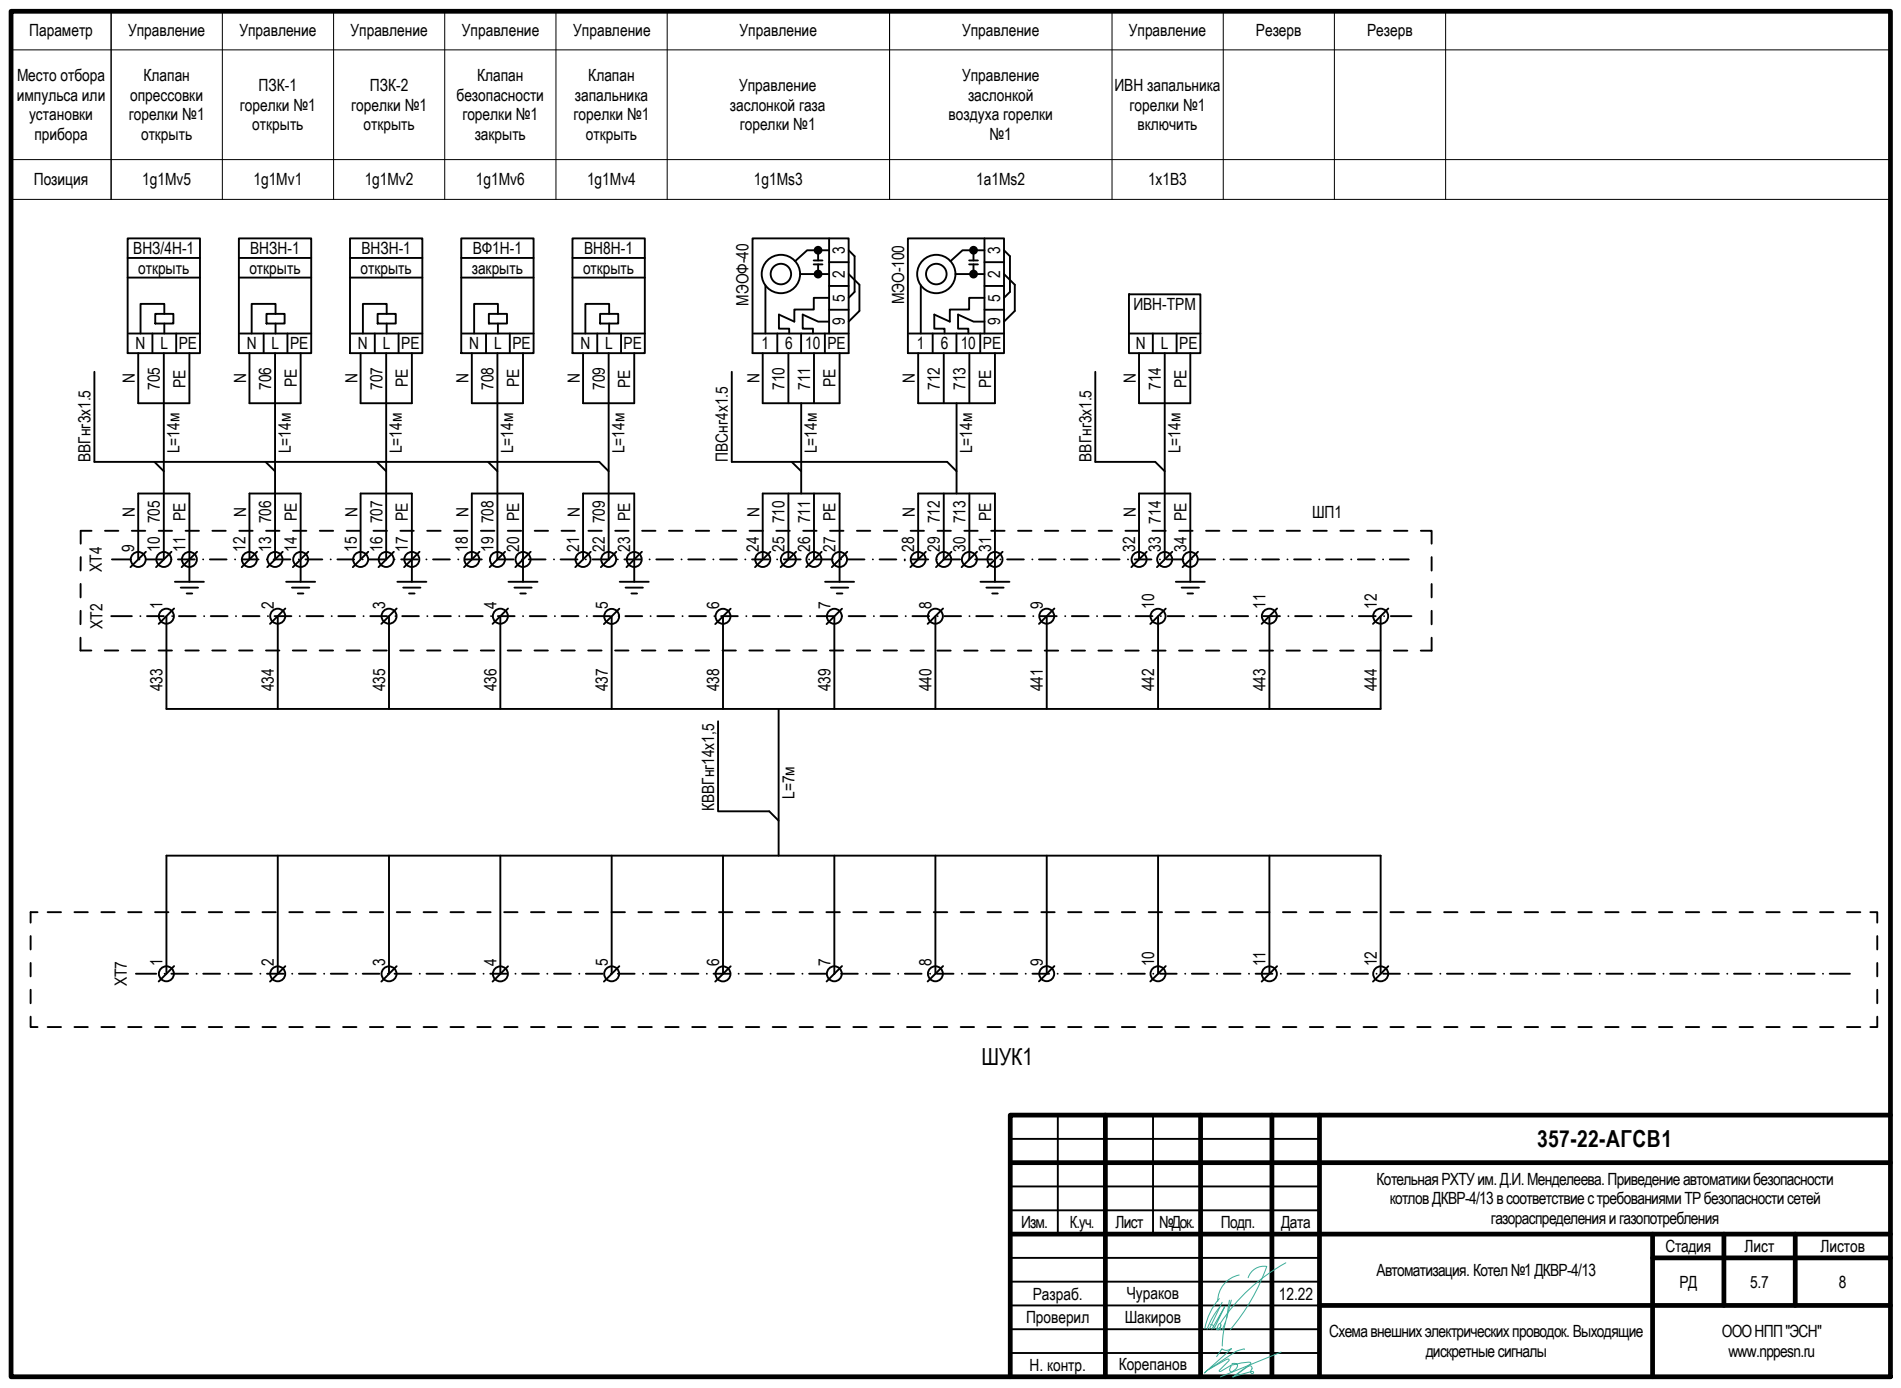
[picture p34: page 13]
Стадия; Лист; Листов; Изм.; №Док.; Подп.; Дата; дискретные сигналы; 5.7 Разраб.; Параметр; Место отбора импульса или установки прибора; Позиция; 357-22-АГСВ1; газораспределения и газопотребления; Управление; Резерв; Клапан опрессовки горелки №1 открыть; ПЗК-1 горелки №1 открыть; ПЗК-2 горелки №1 открыть; Клапан безопасности горелки №1 закрыть; Клапан запальника горелки №1 открыть; ИВН запальника горелки №1 включить; Управление заслонкой газа горелки №1; Управление заслонкой воздуха горелки №1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

Автоматизация. Котел №1 ДКВР-4/13

Схема внешних электрических проводок. Выходящие

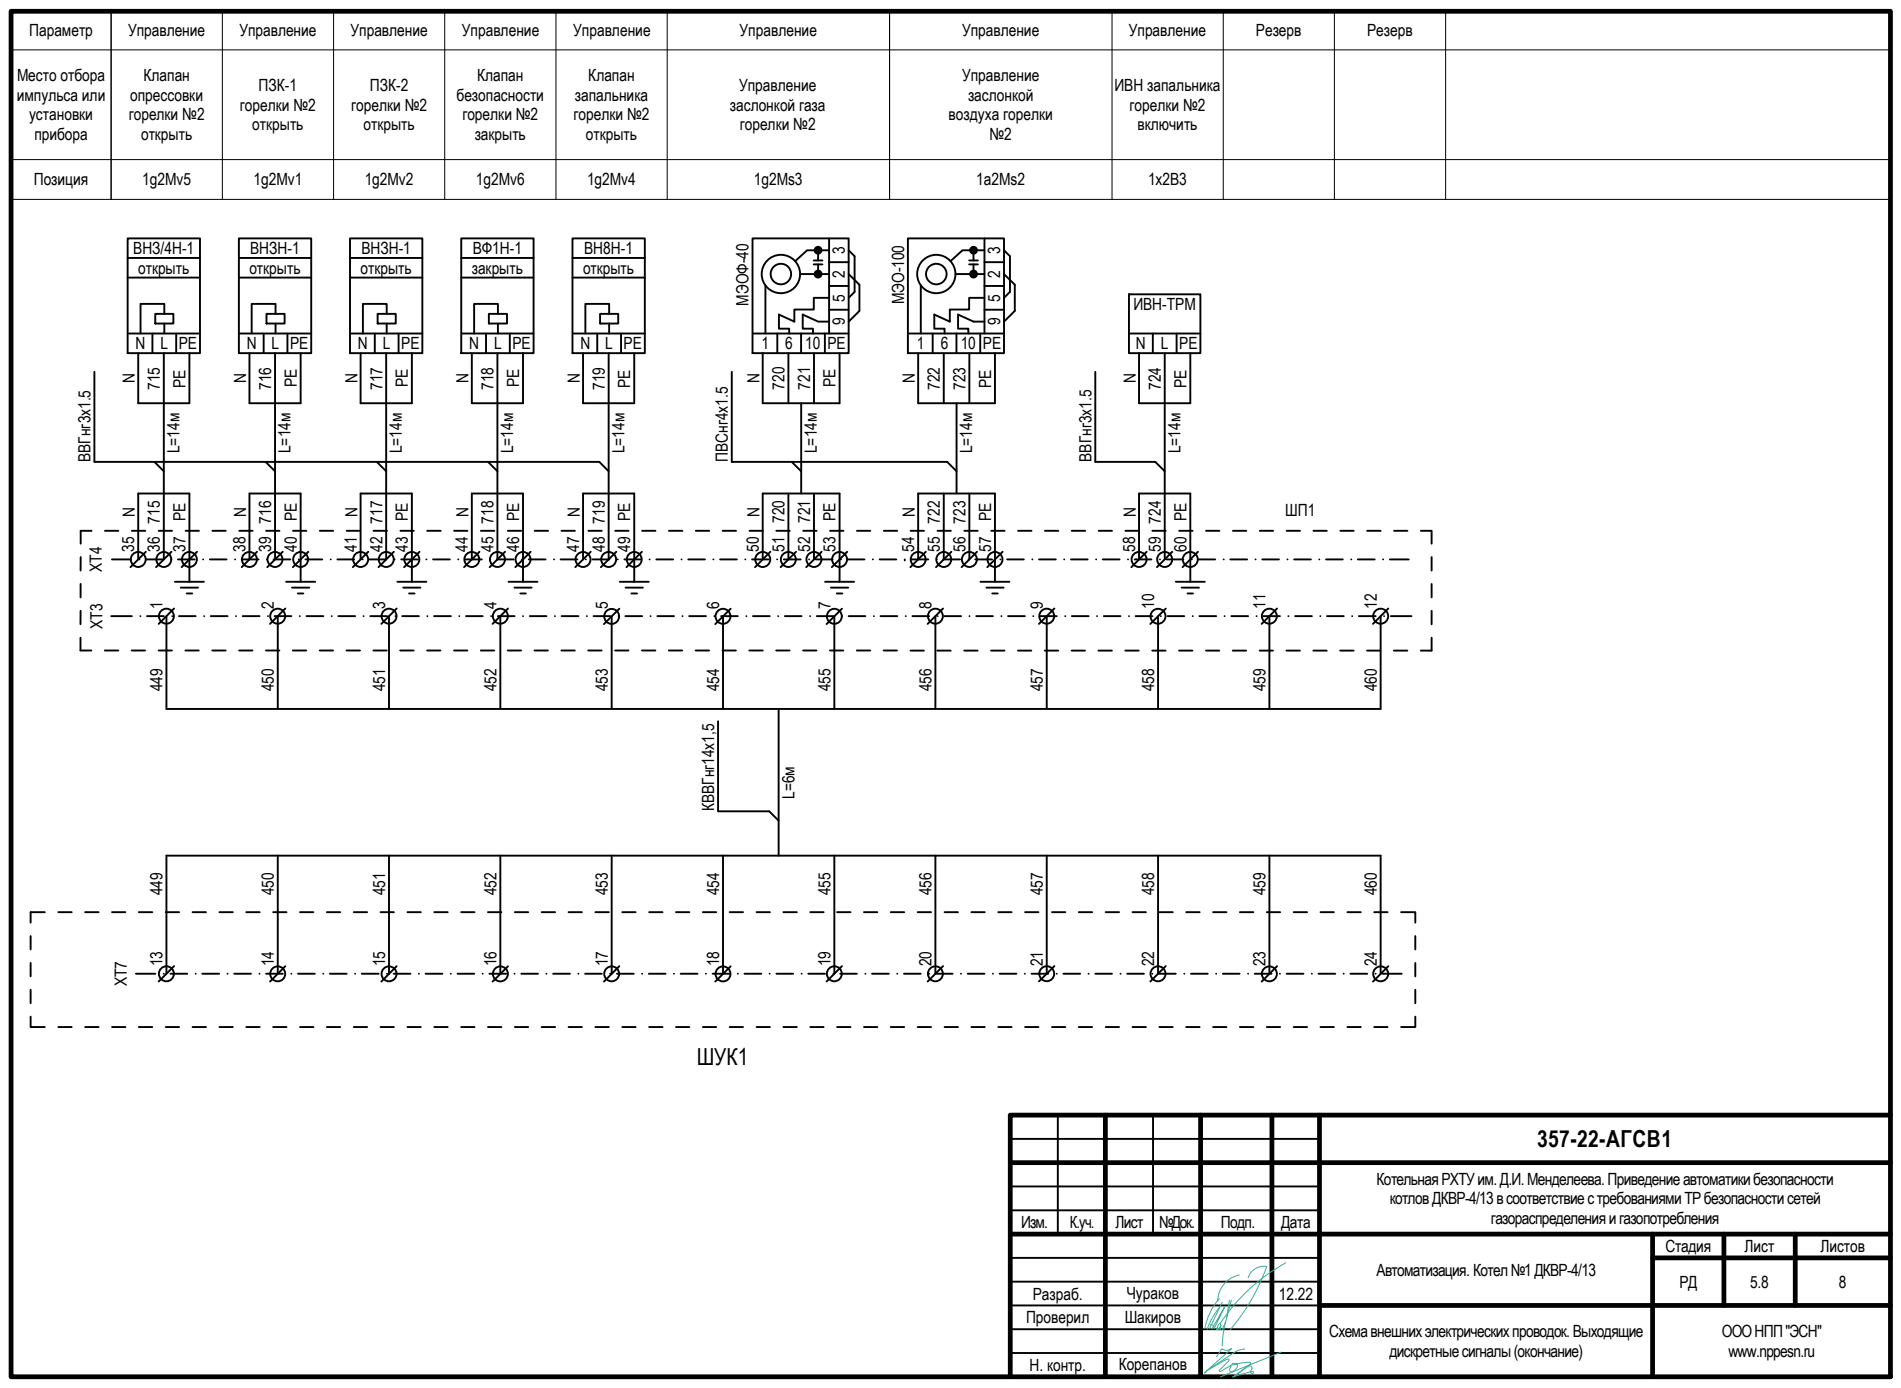
[picture p35: page 14]
Стадия; Лист; Листов; Изм.; №Док.; Подп.; Дата; РД 5.8 Разраб.; Параметр; Место отбора импульса или установки прибора; Позиция; 357-22-АГСВ1; газораспределения и газопотребления; Управление; Резерв; Клапан опрессовки горелки №2 открыть; ПЗК-1 горелки №2 открыть; ПЗК-2 горелки №2 открыть; Клапан безопасности горелки №2 закрыть; Клапан запальника горелки №2 открыть; ИВН запальника горелки №2 включить; Управление заслонкой газа горелки №2; Управление заслонкой воздуха горелки №2; КВВГнг14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

Автоматизация. Котел №1 ДКВР-4/13

Схема внешних электрических проводок. Выходящие
дискретные сигналы (окончание)

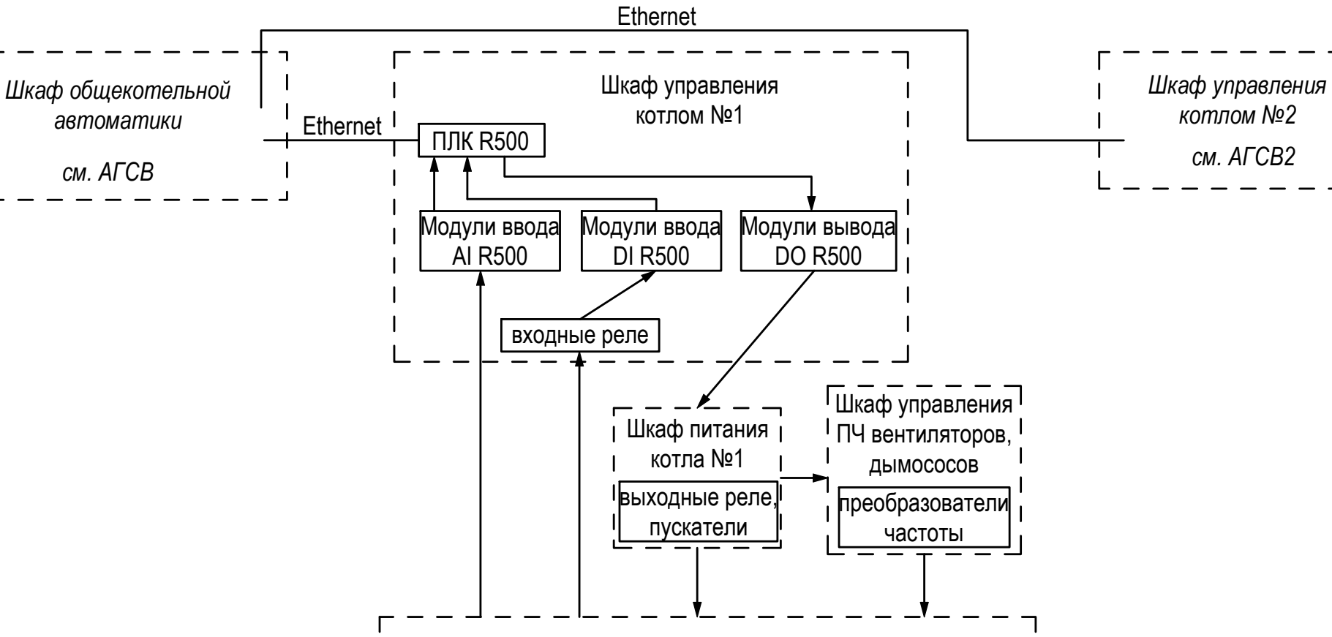
[picture p36: figure]
Шкаф управления котлом №1; Шкаф питания котла №1; ПЛК R500; Модули ввода AI R500; Модули ввода DI R500; Модули вывода DO R500; выходные реле, пускатели; входные реле; Шкаф управления ПЧ вентиляторов, дымососов преобразователи частоты; Шкаф управления котлом №2; Шкаф общекотельной автоматики; Ethernet; см. АГСВ; см. АГСВ2
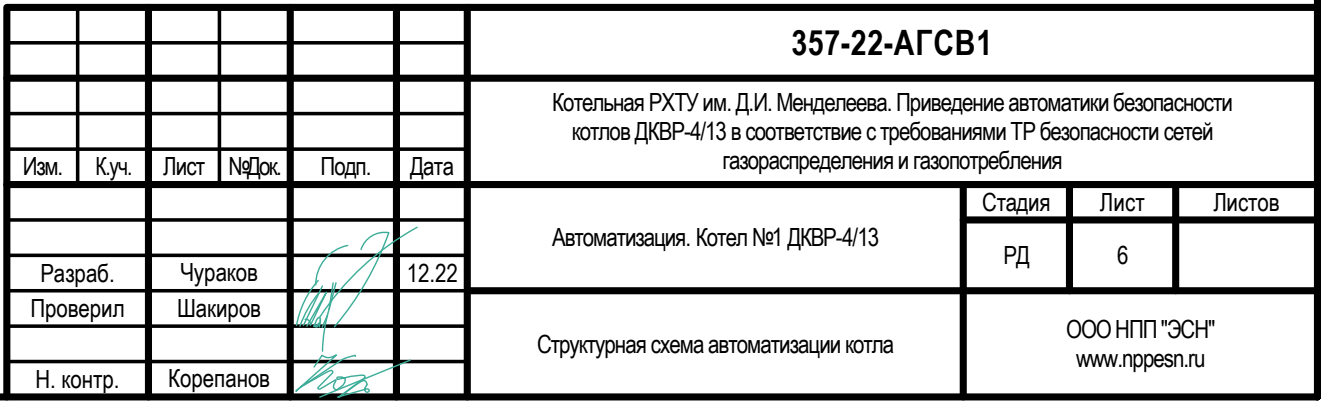
[picture p37: figure]
Стадия; Лист; Листов; Изм.; №Док.; Подп.; Дата; Автоматизация. Котел №1 ДКВР-4/13; газораспределения и газопотребления; 357-22-АГСВ1; Структурная схема автоматизации котла; 6 Разраб.

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

## Датчики, исполнительные механизмы котла №1

## Вид передней панели

## Позиция

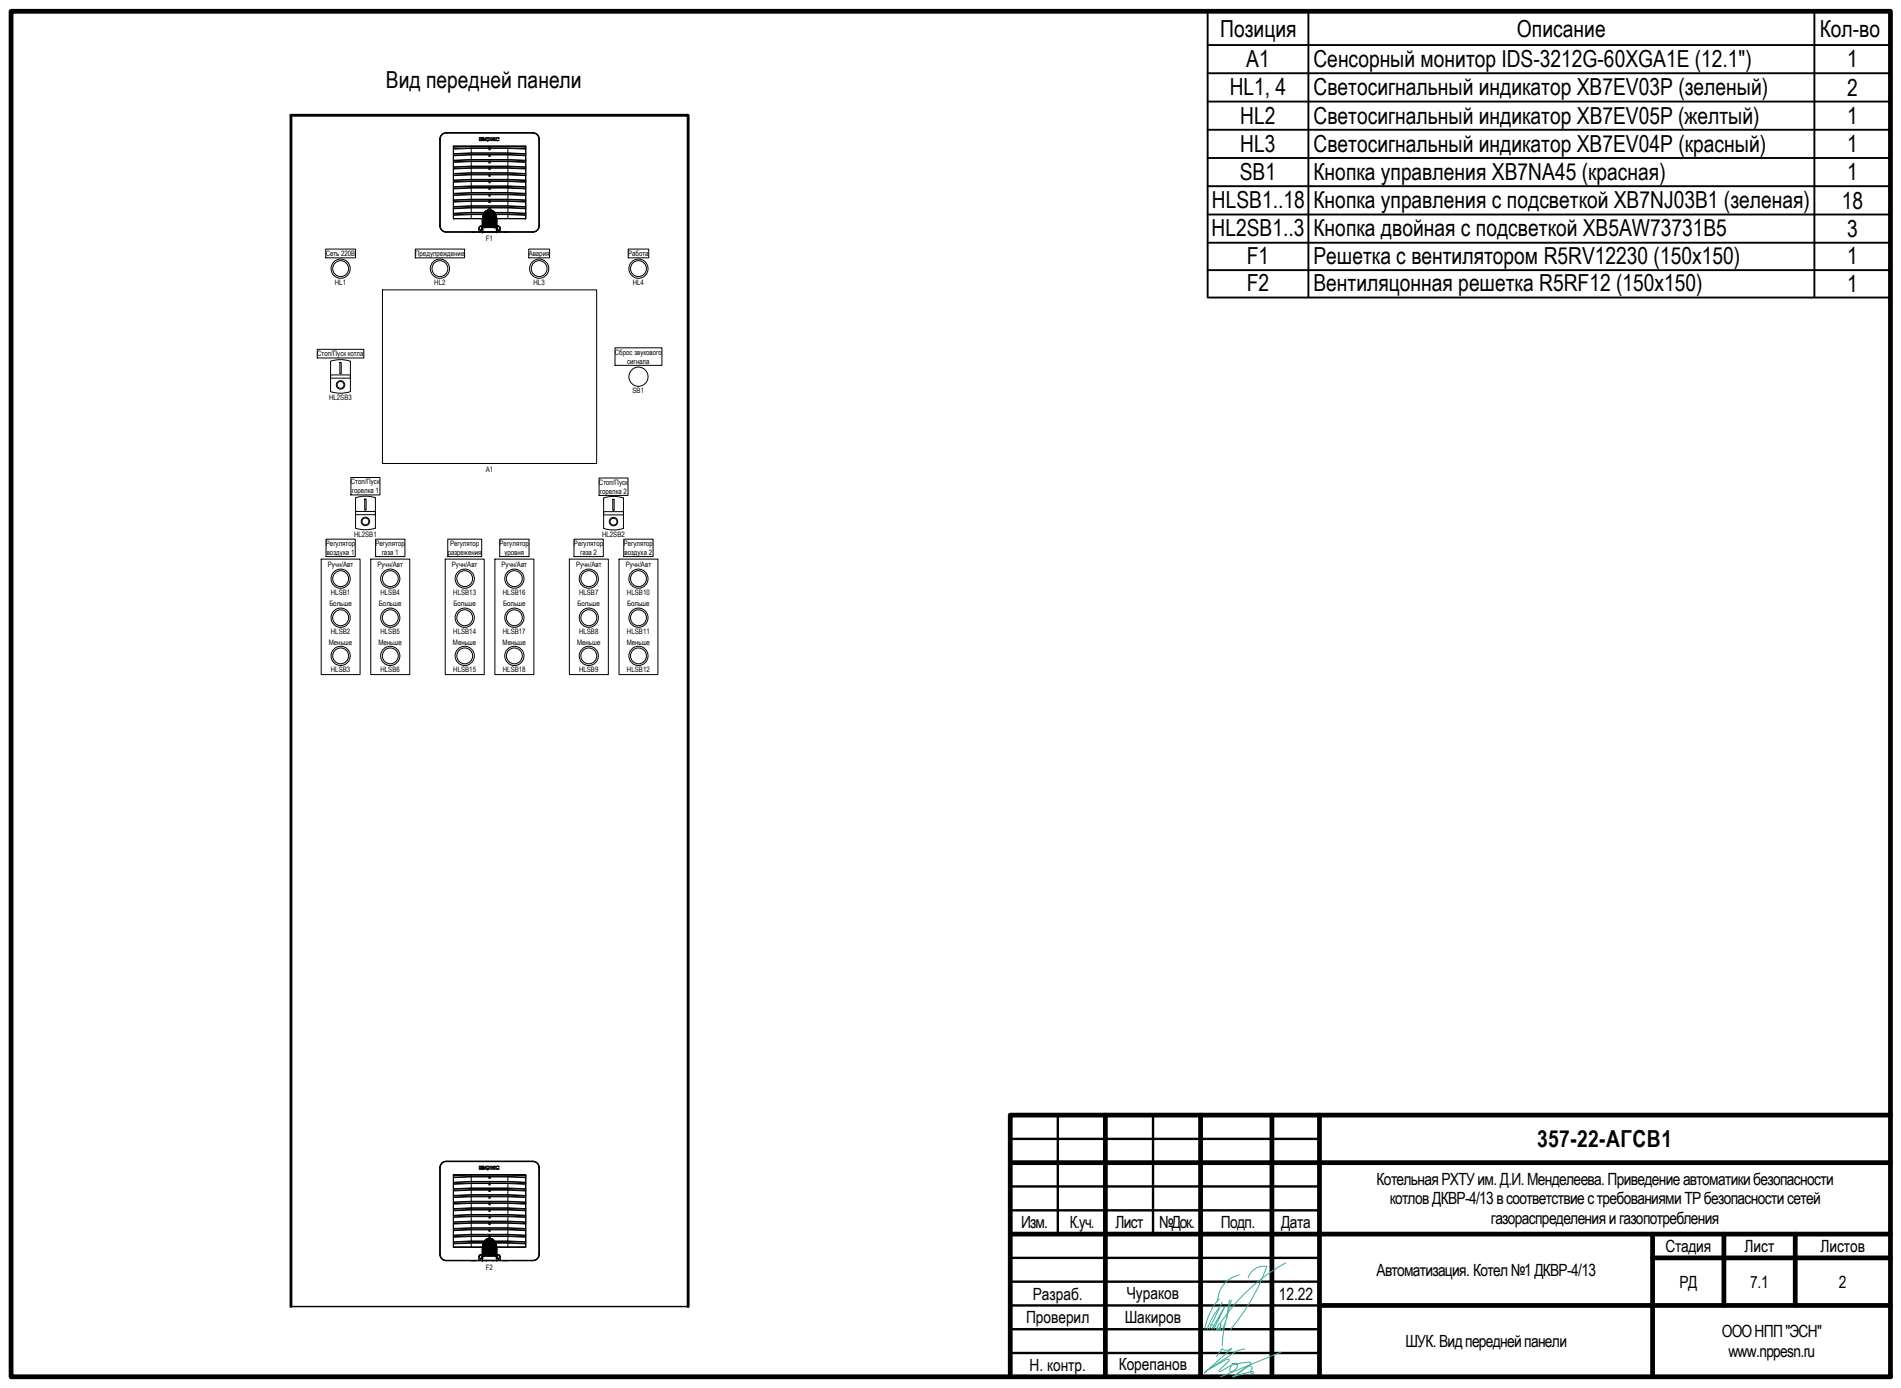
[picture p38: page 16]
Стадия; Лист; Листов; Изм.; №Док.; Подп.; Дата; газораспределения и газопотребления; 357-22-АГСВ1; 7.1 Разраб.; Сеть 220В; Предупреждение; Авария; Работа; Стоп/Пуск котла; Сброс звукового; сигнала; Стоп/Пуск горелка 1; Стоп/Пуск горелка 2; Регулятор газа 1; Регулятор воздуха 1; Регулятор воздуха 2; Регулятор газа 2; Регулятор уровня Ручн/Авт; Больше; Меньше; Регулятор разрежения; HLSB16; HLSB17; HLSB18; Ручн/Авт; HLSB13; HLSB14; HLSB15; HLSB7; HLSB8; HLSB9; HLSB10; HLSB11; HLSB12; HLSB4; HLSB5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

Светосигнальный индикатор XB7EV03P (зеленый)
Светосигнальный индикатор XB7EV05P (желтый)
Светосигнальный индикатор XB7EV04P (красный)
Кнопка управления XB7NA45 (красная)
Кнопка управления с подсветкой XB7NJ03B1 (зеленая)
Кнопка двойная с подсветкой XB5AW73731B5

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

Автоматизация. Котел №1 ДКВР-4/13

ШУК. Вид передней панели

## Позиция

Описание | Кол-во

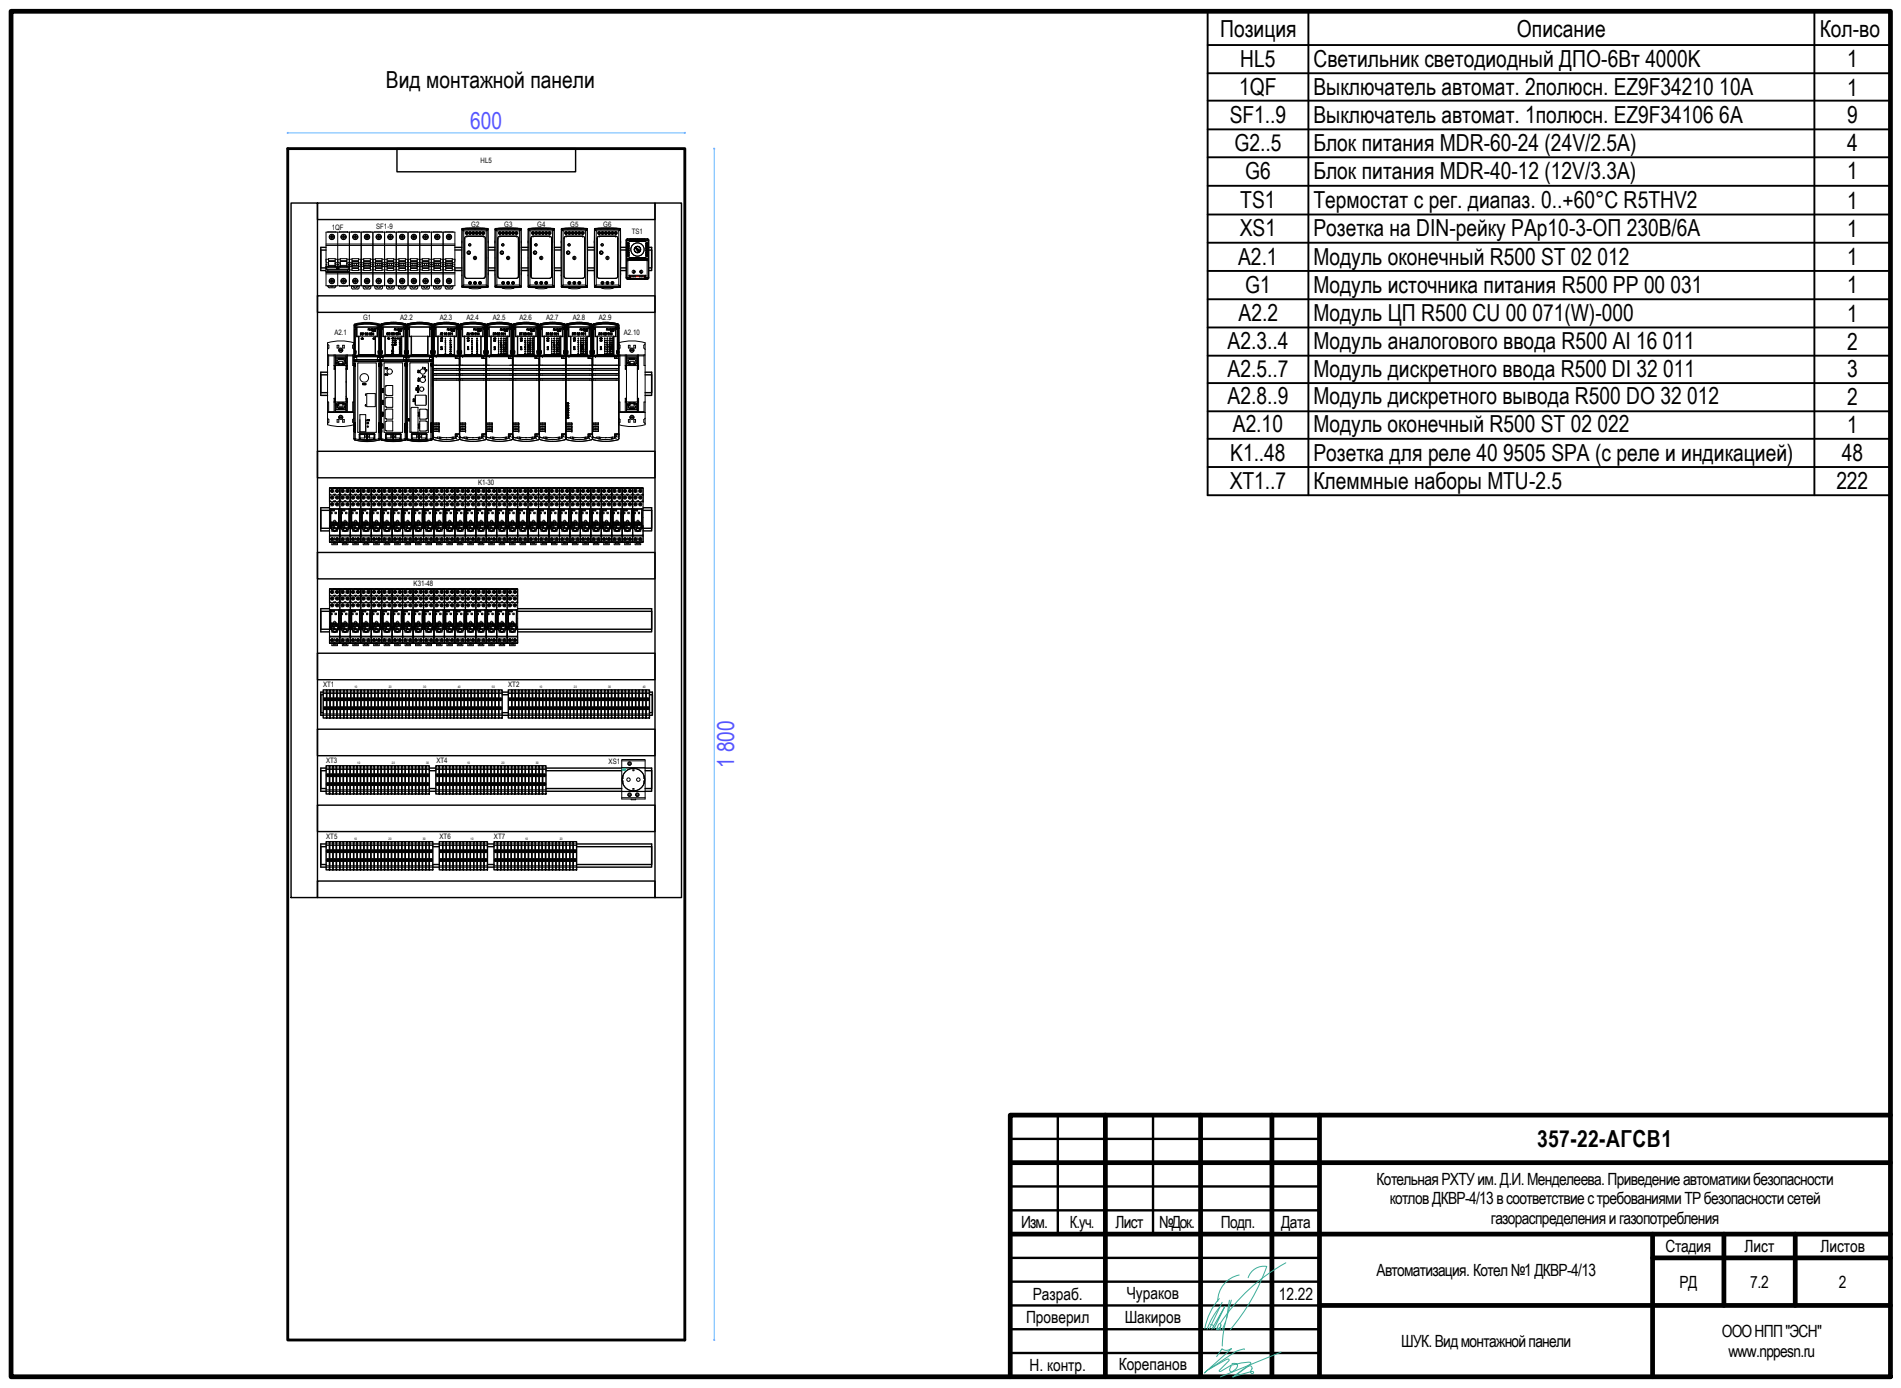
[picture p39: page 17]
Стадия; Лист; Листов; Изм.; №Док.; Подп.; Дата; газораспределения и газопотребления; 357-22-АГСВ1; 7.2 Разраб.; COIL; Светильник светодиодный ДПО-6Вт 4000K; A2.5..7 Модуль дискретного ввода R500 DI 32 011; G2..5 Блок питания MDR-60-24 (24V/2.5A); SF1..9 Выключатель автомат. 1полюсн. EZ9F34106 6A; Блок питания MDR-40-12 (12V/3.3A); A2.10 Модуль оконечный R500 ST 02 022

Выключатель автомат. 2полюсн. EZ9F34210 10А
Термостат с рег. диапаз. 0..+60°С R5THV2
Розетка на DIN-рейку PAp10-3-ОП 230В/6А
Модуль оконечный R500 ST 02 012
Модуль источника питания R500 PP 00 031
Модуль ЦП R500 CU 00 071(W)-000
Модуль аналогового ввода R500 AI 16 011
Модуль дискретного вывода R500 DO 32 012
Розетка для реле 40 9505 SPA (с реле и индикацией)
Клеммные наборы MTU-2.5

Вид монтажной панели

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

Автоматизация. Котел №1 ДКВР-4/13

ШУК. Вид монтажной панели

## Вид передней панели

## Позиция

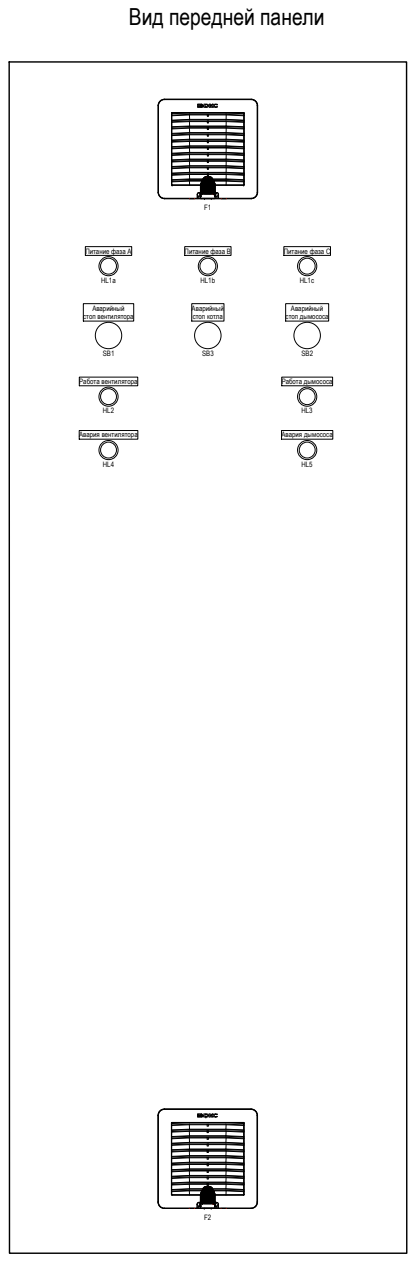
[picture p40: page 18]
Стадия; Лист; Листов; Изм.; №Док.; Подп.; Дата; газораспределения и газопотребления; 357-22-АГСВ1; 8.1 Разраб.; Питание фаза В; Аварийный стоп вентилятора; Работа вентилятора; Авария вентилятора; Работа дымососа; Авария дымососа; Аварийный стоп дымососа; Аварийный стоп котла; Питание фаза А; Питание фаза С; Описание; Кол-во; Решетка с вентилятором R5RV12230 (150х150); Вентиляцонная решетка R5RF12 (150х150)

Светосигнальный индикатор XB7EV03P (зеленый)
Кнопка управления XB7ES545P (красная, грибок)
Светосигнальный индикатор XB7EV04P (красный)

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

Автоматизация. Котел №1 ДКВР-4/13

ШП. Вид передней панели

## Позиция

Описание | Кол-во

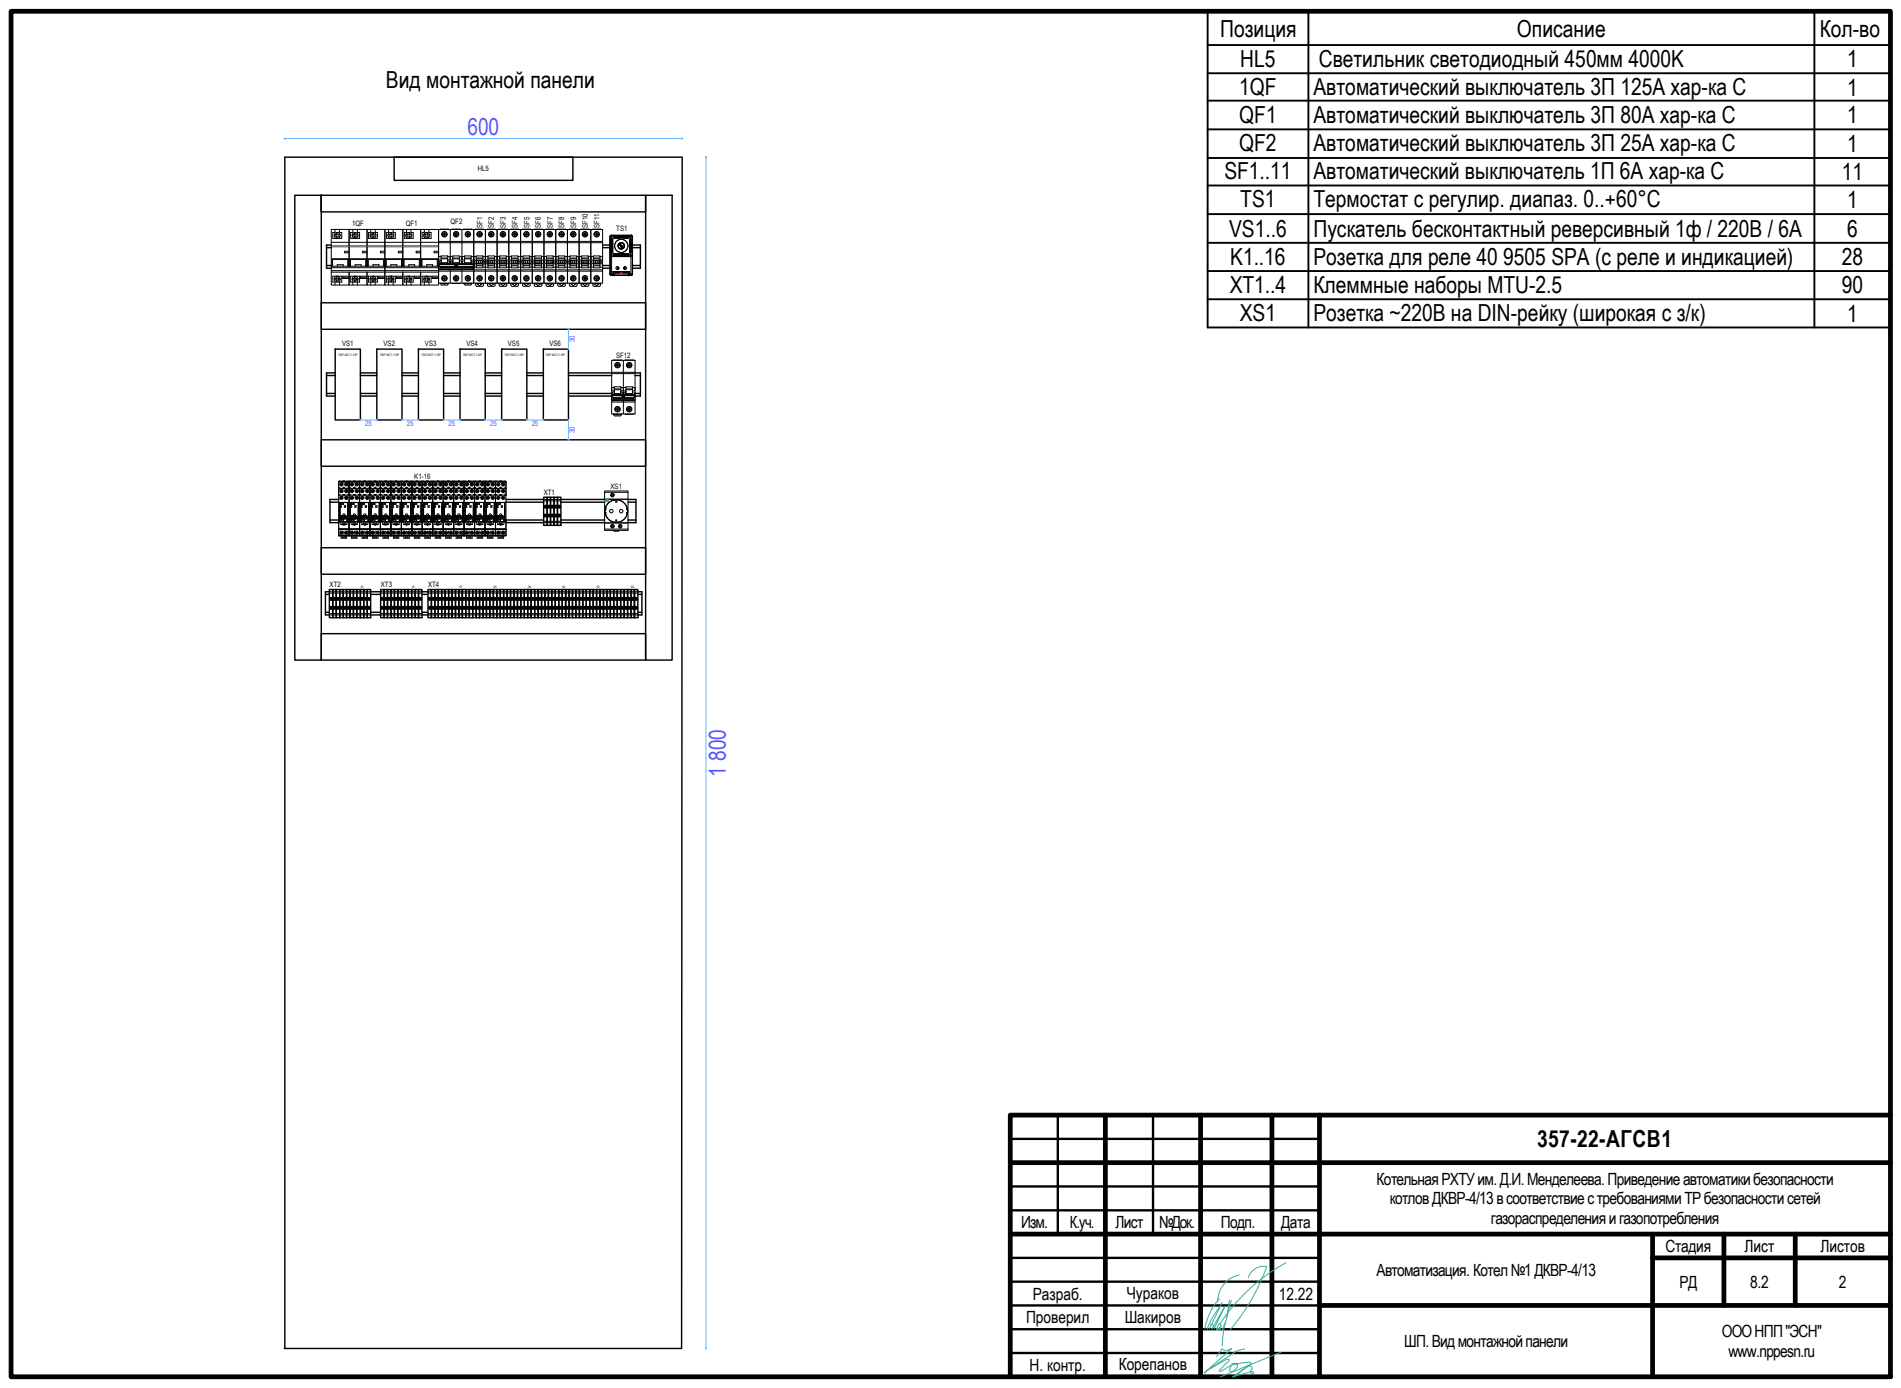
[picture p41: page 19]
Стадия; Лист; Листов; Изм.; №Док.; Подп.; Дата; газораспределения и газопотребления; 357-22-АГСВ1; 8.2 Разраб.; ПБР МСТ-110Р; ПБР ПБР МСТ-110Р; МСТ-110Р; COIL; Светильник светодиодный 450мм 4000K; SF1..11 Автоматический выключатель 1П 6А хар-ка C; Автоматический выключатель 3П 80А хар-ка C; Термостат с регулир. диапаз. 0..+60°С; Автоматический выключатель 3П 25А хар-ка C

Автоматический выключатель 3П 125А хар-ка C
Пускатель бесконтактный реверсивный 1ф / 220В / 6А
Розетка для реле 40 9505 SPA (с реле и индикацией)
Клеммные наборы MTU-2.5
Розетка ~220В на DIN-рейку (широкая с з/к)

Вид монтажной панели

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

Автоматизация. Котел №1 ДКВР-4/13

ШП. Вид монтажной панели

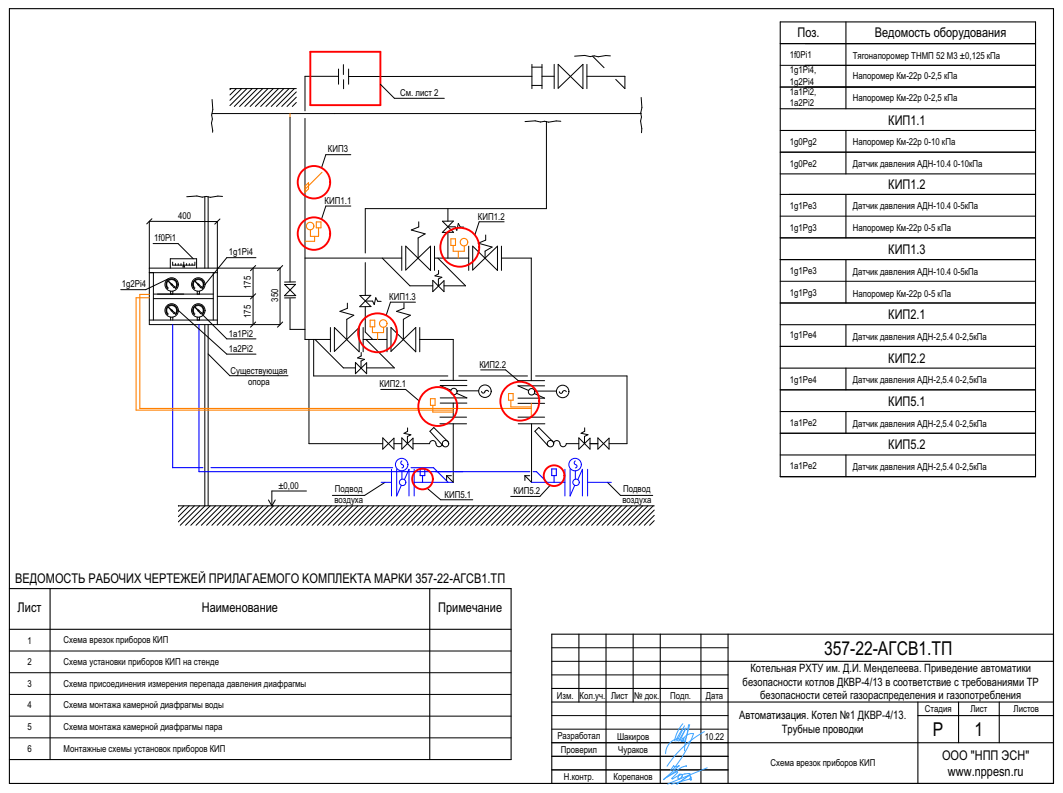
[picture p42: page 20]
GSPublisherVersion 0.0.100.100; КИП1.2; КИП1.3; КИП1.1; Существующая опора; Подвод воздуха; КИП2.1; КИП2.2; См. лист 2; КИП5.1; КИП5.2; КИП3; Схема монтажа камерной диафрагмы пара; Монтажные схемы установок приборов КИП

Поз. | Ведомость оборудования

1f0Pi1 | Тягонапоромер ТНМП 52 М3 ±0,125 кПа
1g1Pi4, 1g2Pi4 | Напоромер Км-22р 0-2,5 кПа

1а1Pi2, 1а2Pi2 | Напоромер Км-22р 0-2,5 кПа

1g0Pg2 | Напоромер Км-22р 0-10 кПа

1g0Pe2 | Датчик давления АДН-10.4 0-10кПа

1g1Pe3 | Датчик давления АДН-10.4 0-5кПа

1g1Pg3 | Напоромер Км-22р 0-5 кПа

Датчик давления АДН-10.4 0-5кПа

Напоромер Км-22р 0-5 кПа
КИП2.1

Датчик давления АДН-2,5.4 0-2,5кПа
КИП2.2

КИП5.1

КИП5.2

ВЕДОМОСТЬ РАБОЧИХ ЧЕРТЕЖЕЙ ПРИЛАГАЕМОГО KОМПЛЕKТА МАРКИ 357-22-АГСВ1.ТП

Лист | Наименование | Примечание

1 | Схема врезок приборов КИП

357-22-АГСВ1.ТП

2 | Схема установки приборов КИП на стенде

Котельная РХТУ им. Д.И. Менделеева. Приведение автоматики безопасности котлов ДКВР-4/13 в соответствие с требованиями ТР безопасности сетей газораспределения и газопотребления

3 | Схема присоединения измерения перепада давления диафрагмы

Изм. | Кол.уч. | Лист | № док. | Подп. | Дата

4 | Схема монтажа камерной диафрагмы воды

Автоматизация. Котел №1 ДКВР-4/13. Трубные проводки | Стадия | Лист | Листов

Разработал

Схема врезок приборов КИП | ООО "НПП ЭСН"

Н.контр.

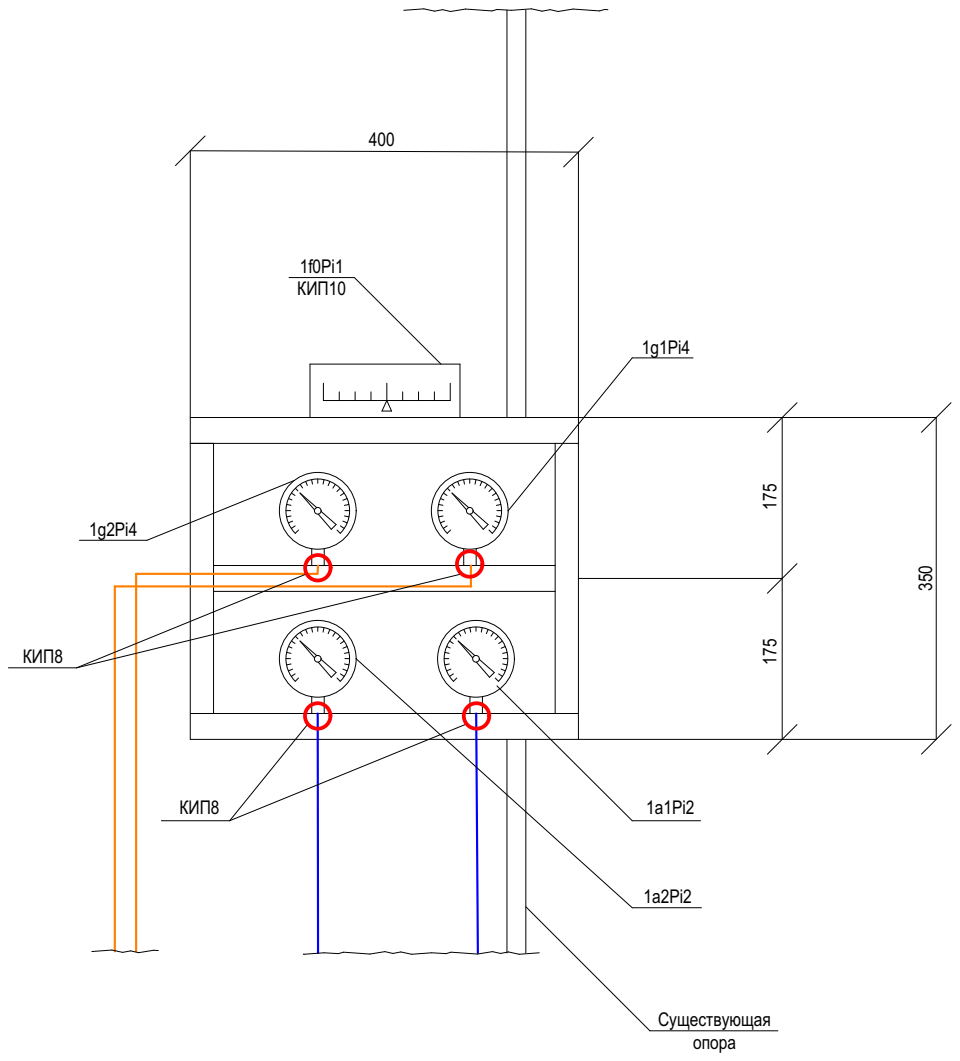
[picture p43: page 21]
GSPublisherVersion 0.0.100.100; 1f0Pi1 КИП10; КИП8

Существующая опора

357-22-АГСВ1.ТП

Котельная РХТУ им. Д.И. Менделеева. Приведение автоматики безопасности котлов ДКВР-4/13 в соответствие с требованиями ТР безопасности сетей газораспределения и газопотребления

Изм. | Кол.уч. | Лист | № док. | Подп. | Дата

Автоматизация. Котел №1 ДКВР-4/13. Трубные проводки | Стадия | Лист | Листов

Разработал

Схема соединений приборов КИП на стенде | ООО "НПП ЭСН"

Н.контр.

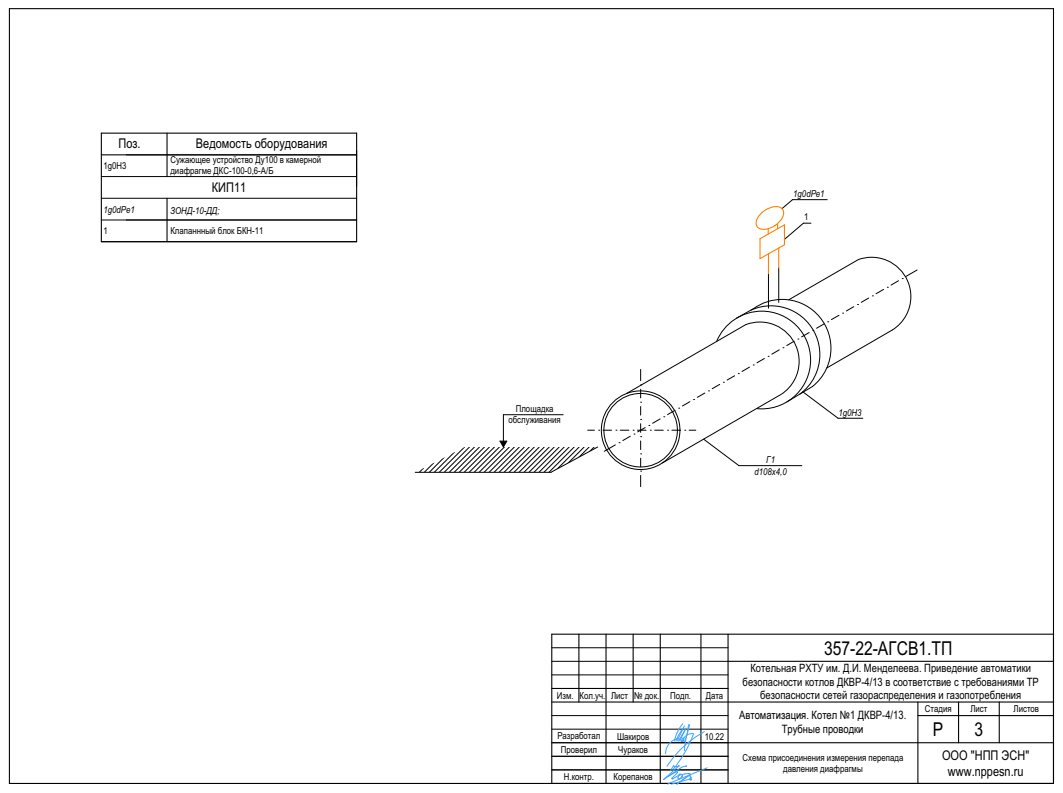
[picture p44: page 22]
GSPublisherVersion 0.0.100.100; КИП11; Площадка обслуживания; 1g0dPe1

Поз. | Ведомость оборудования
1g0Н3 | Сужающее устройство Ду100 в камерной диафрагме ДКС-100-0,6-А/Б

1g0dPe1 | ЗОНД-10-ДД;
1 | Клапаннный блок БКН-11

357-22-АГСВ1.ТП

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

Изм. | Кол.уч. | Лист | № док. | Подп. | Дата

Автоматизация. Котел №1 ДКВР-4/13. Трубные проводки | Стадия | Лист | Листов

Разработал

Схема присоединения измерения перепада давления диафрагмы | ООО "НПП ЭСН"

Н.контр.

GSPublisherVersion 0.0.100.100

Разработал
| Схема монтажа камерной диарфагмы воды | ООО "НПП ЭСН"

Н.контр.

Изм. | Кол.уч. | Лист | № док. | Подп. | Дата
| | | | Автоматизация. Котел №1 ДКВР-4/13. Трубные проводки | Стадия | Лист | Листов
| | | | | P | 4

## 357-22-АГСВ1.ТП

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

1g0Н1

КИП11

1g0Н3

700 | 350
Поз. | Ведомость оборудования
1g0Н1 | Сужающее устройство Ду50 в камерной диафрагме ДКС-50-0,6-А/Б
1g0Н3 | Заслонка дроссельная ЗД-50 с приводом МЭОФ
1g0Н2 | Клапаннный блок БКН-11
1w0Pe1 | ЗОНД10-ДД

М

d57x3,0

КИП6 | КИП6
1w0Pe2 | ЗОНД-10-ИД; 1,6МПа
1g0Н4 | Напоромер Км-22р 0-2,5 кПа

КИП6

1w0Pe1

1w0Pe3

КИП6

ЗОНД-10-ИД; 1,6МПа
1g0Н5 | Напоромер Км-22р 0-2,5 кПа не менее 100мм

См. чертеж
выше

Котел №1
ДКВР-4/13

КИП11

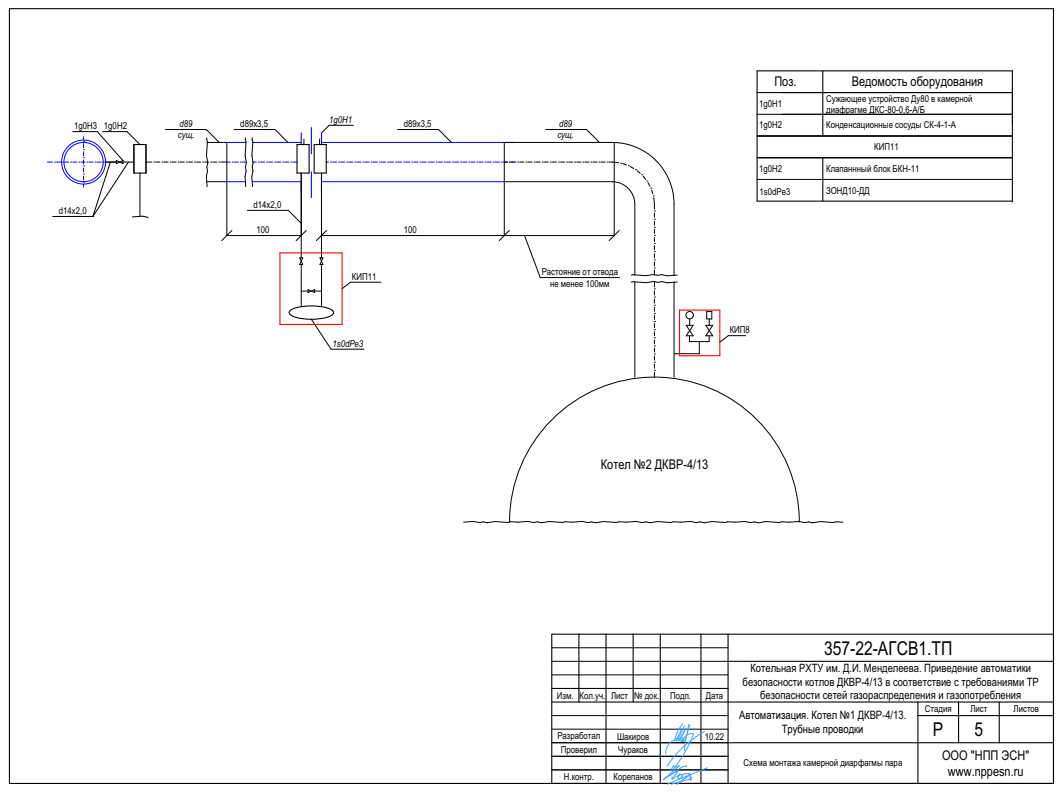
[picture p45: page 24]
GSPublisherVersion 0.0.100.100; 1s0dPe3; КИП8; КИП11; Котел №2 ДКВР-4/13; d89 сущ.; сущ.

Поз. | Ведомость оборудования
1g0Н1 | Сужающее устройство Ду80 в камерной диафрагме ДКС-80-0,6-А/Б

Конденсационные сосуды СК-4-1-А

1g0Н2 | Клапаннный блок БКН-11

1s0dPe3 | ЗОНД10-ДД

Растояние от отвода
не менее 100мм

357-22-АГСВ1.ТП

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

Изм. | Кол.уч. | Лист | № док. | Подп. | Дата

Автоматизация. Котел №1 ДКВР-4/13. Трубные проводки | Стадия | Лист | Листов

Разработал

Схема монтажа камерной диарфагмы пара | ООО "НПП ЭСН"

Н.контр.

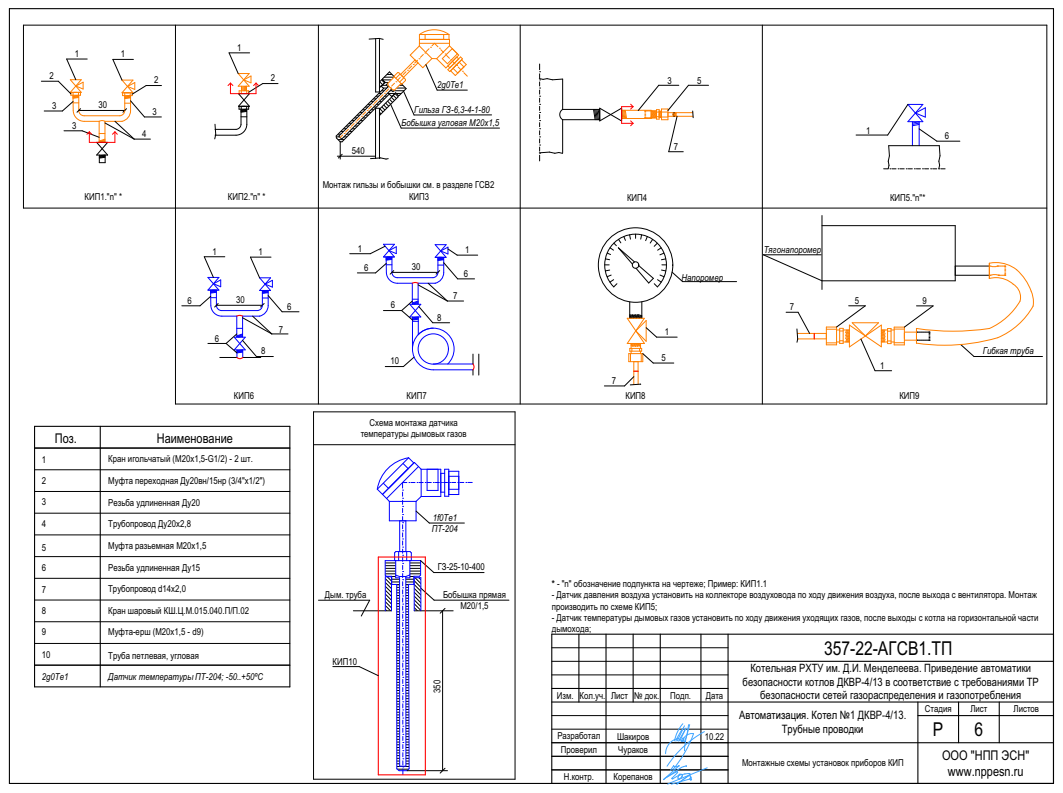
[picture p46: page 25]
GSPublisherVersion 0.0.100.100; Бобышка угловая М20х1,5; Гильза ГЗ-6,3-4-1-80; КИП1."n" *; КИП2."n" *; КИП4; Напоромер; Гибкая труба; Тягонапоромер; КИП3; КИП5."n"*; КИП6; КИП7; КИП8; КИП9; Бобышка прямая М20/1,5; Дым. труба; КИП10

Монтаж гильзы и бобышки см. в разделе ГСВ2

Схема монтажа датчика
температуры дымовых газов

Поз. | Наименование

1 | Кран игольчатый (М20х1,5-G1/2) - 2 шт.

2 | Муфта переходная Ду20вн/15нр (3/4"х1/2")

3 | Резьба удлиненная Ду20

4 | Трубопровод Ду20х2,8

5 | Муфта разьемная М20х1,5

6 | Резьба удлиненная Ду15

* - "n" обозначение подпункта на чертеже; Пример: КИП1.1
- Датчик давления воздуха установить на коллекторе воздуховода по ходу движения воздуха, после выхода с вентилятора. Монтаж
производить по схеме КИП5;
- Датчик температуры дымовых газов установить по ходу движения уходящих газов, после выходы с котла на горизонтальной части
дымохода;

7 | Трубопровод d14х2,0

8 | Кран шаровый КШ.Ц.М.015.040.П/П.02

9 | Муфта-ерш (М20х1,5 - d9)

357-22-АГСВ1.ТП

10 | Труба петлевая, угловая

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

2g0Te1 | Датчик температуры ПТ-204; -50..+50ºС

Изм. | Кол.уч. | Лист | № док. | Подп. | Дата

Автоматизация. Котел №1 ДКВР-4/13. Трубные проводки | Стадия | Лист | Листов

Разработал

Монтажные схемы установок приборов КИП | ООО "НПП ЭСН"

Н.контр.

Позиция | Наименование и техническая характеристика | Тип,марка,обозначение документа, опросного листа | код оборудования, изделия, материала | Завод-изготовитель (поставщик) | Едини. изме-рения | Коли-чество | Масса един (кГ) | Примечание
1 | 2 | 3 | 4 | 5 | 6 | 7 | 8 | 9
| Арматура:
| КИП1."n" | | | | шт. | 3
1 | Кран игольчатый | (М20х1,5-G1/2) | | | шт. | 2
2 | Муфта переходная | Ду20вн/15нр (3/4"х1/2") | | | шт. | 2
3 | резьба удлиненная | Ду20 | | | шт. | 3
4 | Труба водогазопроводная | Ду20х2,8 | | | п.м. | 0,5
| КИП2."n" | | | | шт. | 2
1 | Кран игольчатый | (М20х1,5-G1/2) | | | шт. | 1
2 | Муфта переходная | Ду20вн/15нр (3/4"х1/2") | | | шт. | 1
| КИП4 | | | | шт. | 4
1 | резьба удлиненная | Ду20 | | | шт. | 1
2 | Муфта разьемная | М20х1,5 | | | шт. | 1
| КИП5 | | | | шт. | 3
| | 1 | Кран игольчатый | (М20х1,5-G1/2) | | | п.м. | 1
| | 2 | резьба удлиненная | Ду15 | | | шт. | 1
| | | КИП6 | | | | шт. | 2
| | 1 | Кран игольчатый | (М20х1,5-G1/2) | | | шт. | 2
| | 2 | резьба удлиненная | Ду15 | | | шт. | 4
| | 3 | Труба водогазопроводная Ду14х2,0 | ГОСТ 8734-75 | | | п.м. | 0,75
| | 4 | Кран шаровый | КШ.Ц.М.015.040.П/П.02 | | | п.м. | 1
| | | КИП7 | | | | шт. | 1
| | 1 | Кран игольчатый | (М20х1,5-G1/2) | | | шт. | 2
| | 2 | резьба удлиненная | Ду15 | | | шт. | 4
| | 3 | Труба водогазопроводная Ду14х2,0 | ГОСТ 8734-75 | | | шт. | 0,75
| | 4 | Кран шаровый | КШ.Ц.М.015.040.П/П.02 | | | шт. | 1
| | 5 | Труба петлевая, угловая | d14 | | | шт. | 1
изм | к.уч. | лист | N докум | подпись | дата
| | | | Автоматизация. Котел №1 ДКВР-4/13. Трубные проводки | Стадия | Лист 1 Разработал | Листов
| | | | | РД | | 2
| Чураков | 10.22.г.
Проверил | Шакиров | 10.22.г. | Спецификация оборудования и материалов | ООО "НПП ЭСН" www.nppesn.ru

10.22.г.

формат А3

инв. № подл.

Н.контр. Корепанов

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

357-22-АГСВ1.ТП.С

взамен инв.№ подп. и дата

| КИП8 | | | | 4
1 | Кран игольчатый | (М20х1,5-G1/2) | | шт. | 1
2 | Муфта разьемная | М20х1,5 | | шт. | 1
| КИП9 | | | | 1
1 | Муфта разьемная | М20х1,5 | | шт. | 1
2 | Кран игольчатый | (М20х1,5-G1/2) | | шт. | 1
3 | Муфта-ерш | (М20х1,5-d9) | | шт. | 1
| КИП10 | | | | 1
1 | Бобышка прямая | М20/15 | | шт. | 1
2 | Гильза | ГЗ-25-10-400 | | шт. | 1
| КИП11 | | | | 3
1 | Клапанный блок | БКН-11 | | шт. | 1
2 | Датчик перепада давления | ЗОНД10-ДД | | шт. | 1 | Учтено в разделе АГСВ2
| Оборудование и трубопроводы
1g0Н1 | Сужающее устройство Ду50 в камерной диафрагме с комплектом ответных фланцев | ДКС-50-0,6-А/Б | ИТеК ББМВ | шт | 1
1g0Н1 | Сужающее устройство Ду80 в камерной диафрагме с комплектом ответных фланцев | ДКС-80-0,6-А/Б | ИТеК ББМВ | шт | 1
| Трубопровод d57х3,0 | ГОСТ 10704-91 | | п.м. | 1,5
| Трубопровод d89х3,5 | ГОСТ 10704-91 | | п.м. | 0,2
| Трубопровод d14х2,0 | ГОСТ 10704-91 | | п.м. | 15
к.уч. | лист | N докум | подпись | дата

лист

инв.№подл. дата и подп. взамен инвю№

изм
357-22-АГСВ1.ТП.С | 2

формат А3

Опросный лист для выбора диафрагм

Информация о заказчике
Предприятие: ООО НПП "ЭСН" | Дата заполнения:
Контактное лицо: | Тел./факс:
Адрес: | E-mail:
Опросный лист № | Позиция по проекту: | Количество:
Требования к диафрагме
Тип диафрагмы | ДКС | ДБС | ДФК
| другой (указать)
Исполнение (только для ДКС) | исп. 1 | исп. 2 | исп. 3
Наличие расточки | | | есть | | нет | (заполняется только строка «внутренний диаметр D20, мм»)

Специальное исполнение

Способ отбора давления | ✔ | угловой | | фланцевый
(если требуется) | износоустойчивая | с коническим входом

Параметры измеряемой среды Наименование измеряемой среды
Агрегатное состояние | газ | жидкость | пар
Компонентный состав газовой смеси:
Название компонента | Содержание, % | Название компонента | Содержание, %

Метод расчета коэффициента сжимаемости (для природного газа)

GERG-91 | NX-19м
ВНИЦ СМВ | AGA8-92 DC
Плотность при стандартных условиях
(для сухого газа или сухой части влажного газа), кг/м³ Плотность при рабочих условиях, кг/м³
Динамическая вязкость при рабочих условиях, кгс×с/м² Показатель адиабаты при рабочих условиях (для газов)
Степень сухости (для насыщенного водяного пара), кг/кг
Наибольший измеряемый расход, | м³ /ч | | кг/ч
Наименьший измеряемый расход, | | м³ /ч | | кг/ч
Предельный номинальный
перепад давления,
кг/см² | кПа
Наибольшая допустимая потеря давления, | | кг/см² | ✔ | кПа
Избыточное давление, | кг/см² МПа ✔
Барометрическое давление в месте установки, | | мм рт. ст. | | | кПа

Температура, °С
Информация о трубопроводе в месте установки диафрагмы Внутренний диаметр D20, мм
Толщина стенки, мм
Марка материала трубопровода
Значение абсолютной эквивалентной шероховатости стенок, мм

ООО «ИТеК ББМВ»
Россия, 454112, Челябинск, проспект Победы, 290А
т. (351) 742-44-47, 749-93-60
Отправьте заполненный опросный лист на info@en-i.ru
Илья, +79042485239 г. Ижевск, ул. Карла Маркса, 1А | 06.06.2022 8(3412)506-127 506127@mail.ru 1 комплект ✔

✔

Метан Этан Пропан и-Бутан н-Бутан и-Пентан н-Пентан н-Гексан | Азот Диоксид углерода

Кислород

✔

# 16121,6Ду 50 вода 60°

Измерительный участок трубопровода МС - местные сопротивления. Тип МС по ГОСТ 8.586-2. Приложение А

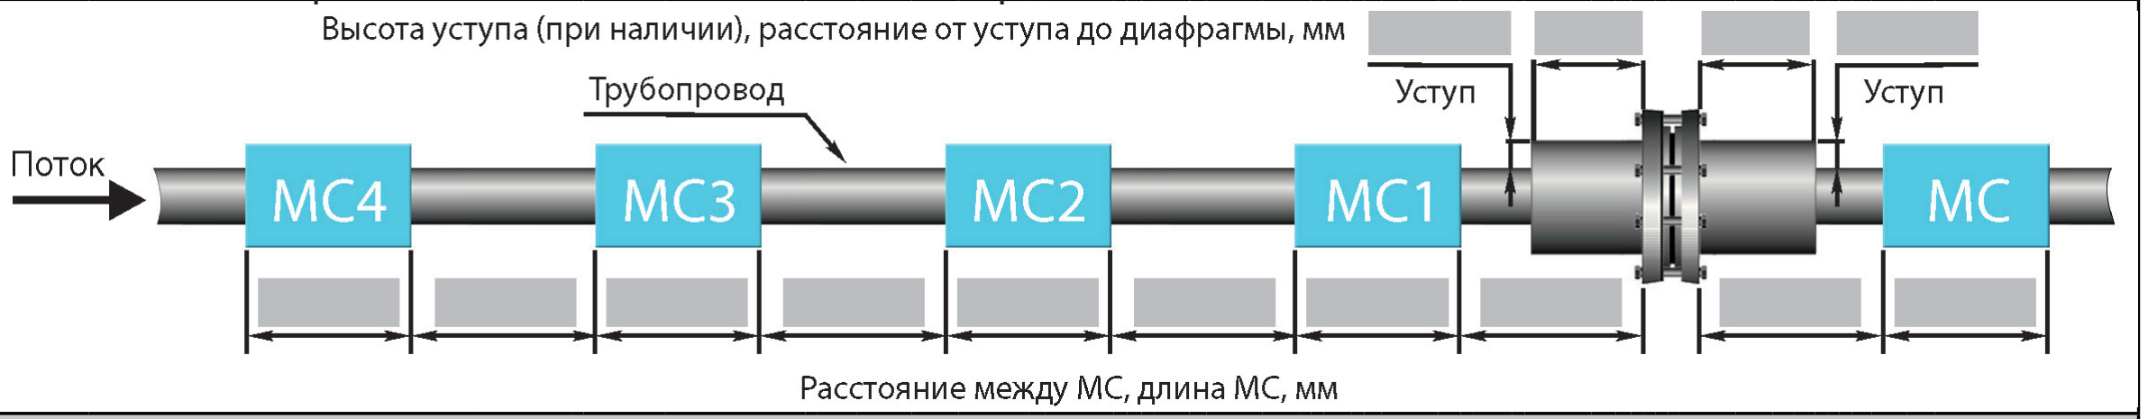
[picture p47: figure]

Требования к датчику разности давлений
Первый датчик разности давлений | Модель
ВПИ | | | кг/см² | ✔ | кПа
Функция преобразования | | | корнеизвлекающая | ✔ | линейная
Основная погрешность, % | | ✔ | приведенная | | | относительная
Регистратор первого датчика разности давлений | Модель
Функция преобразования | | | | корнеизвлекающая | | | линейная
Основная погрешность, % | | | приведенная | | | относительная
Второй датчик разности давлений (при наличии) | Модель
ВПИ | | | кг/см² | | | кПа
Функция преобразования | | | | корнеизвлекающая | | | линейная
Основная погрешность, % | | | | приведенная | | | относительная
Регистратор второго датчика разности давлений (при наличии) | Модель
Функция преобразования | | | | корнеизвлекающая | | | линейная
Основная погрешность, % | | | | приведенная | | | относительная
Требования к датчику измерения статического давления
Датчик измерения статического давления | Модель, измеряемое давление | | | абсолютное | | избыточное
ВПИ | | кг/см² | | | кПа | | МПа
Основная погрешность, % | | | приведенная | | | относительная
Регистратор датчика измерения статического давления | Модель
Основная погрешность, % | | | приведенная | | | относительная
Требования к датчику температуры
Установка гильзы | | | до диафрагмы | | | после диафрагмы
Расстояние между диафрагмой, мм
Внутренний диаметр D20 расширителя трубопро-вода (при наличии), мм
Датчик температуры | Модель
Диапазон измерений, °С | мин:___________ | макс:__________
Основная погрешность, % | | | | абсолют. | | | привед. | | относит.
Регистратор | Модель
Основная погрешность, % | | | | | абсолют. | | | привед. | | относит.
Требования к вычислителю
Вычислитель | Модель
Основная погрешность, % | | приведенная | относительная
Дополнительно требуется
| | | Сосуды | уравнител. | разделител. | конденсац.
✔ | Комплект фланцев для диафрагмы | ✔ | плоские | усиленные
| | | Фланцевое соединение (комплект фланцев с патрубками) | плоские | усиленные
✔ | | | Монтажное кольцо
| | | Дополнительная пара отборов (указать угол между отборами), град.

Дополнительные сведения

0,5 ЗОНД-10-ДД-1175 -(0÷16)-кПа-42-0,5-(-10..+50)-1,6МПа 16

Опросный лист для выбора диафрагм

Информация о заказчике
Предприятие: ООО НПП "ЭСН" | Дата заполнения:
Контактное лицо: | Тел./факс:
Адрес: | E-mail:
Опросный лист № | Позиция по проекту: | Количество:
Требования к диафрагме
Тип диафрагмы | ДКС | ДБС | ДФК
| другой (указать)
Исполнение (только для ДКС) | исп. 1 | исп. 2 | исп. 3
Наличие расточки | | | есть | | нет | (заполняется только строка «внутренний диаметр D20, мм»)

Специальное исполнение

Способ отбора давления | ✔ | угловой | | фланцевый
(если требуется) | износоустойчивая | с коническим входом

Параметры измеряемой среды Наименование измеряемой среды
Агрегатное состояние | газ | жидкость | пар
Компонентный состав газовой смеси:
Название компонента | Содержание, % | Название компонента | Содержание, %

Метод расчета коэффициента сжимаемости (для природного газа)

GERG-91 | NX-19м
ВНИЦ СМВ | AGA8-92 DC
Плотность при стандартных условиях
(для сухого газа или сухой части влажного газа), кг/м³ Плотность при рабочих условиях, кг/м³
Динамическая вязкость при рабочих условиях, кгс×с/м² Показатель адиабаты при рабочих условиях (для газов)
Степень сухости (для насыщенного водяного пара), кг/кг
Наибольший измеряемый расход, | м³ /ч | | кг/ч
Наименьший измеряемый расход, | | м³ /ч | | кг/ч
Предельный номинальный
перепад давления,
кг/см² | кПа
Наибольшая допустимая потеря давления, | | кг/см² | ✔ | кПа
Избыточное давление, | кг/см² МПа ✔
Барометрическое давление в месте установки, | | мм рт. ст. | | | кПа

Температура, °С
Информация о трубопроводе в месте установки диафрагмы Внутренний диаметр D20, мм
Толщина стенки, мм
Марка материала трубопровода
Значение абсолютной эквивалентной шероховатости стенок, мм

ООО «ИТеК ББМВ»
Россия, 454112, Челябинск, проспект Победы, 290А
т. (351) 742-44-47, 749-93-60
Отправьте заполненный опросный лист на info@en-i.ru
Илья, +79042485239 г. Ижевск, ул. Карла Маркса, 1А | 06.06.2022 8(3412)506-127 506127@mail.ru 1 комплект ✔

✔

Метан Этан Пропан и-Бутан н-Бутан и-Пентан н-Пентан н-Гексан | Азот Диоксид углерода

Кислород

✔

# 63290,4Ду 80 насыщенный пар

Измерительный участок трубопровода МС - местные сопротивления. Тип МС по ГОСТ 8.586-2. Приложение А

Требования к датчику разности давлений
Первый датчик разности давлений | Модель
ВПИ | | | кг/см² | ✔ | кПа
Функция преобразования | | | корнеизвлекающая | ✔ | линейная
Основная погрешность, % | | ✔ | приведенная | | | относительная
Регистратор первого датчика разности давлений | Модель
Функция преобразования | | | | корнеизвлекающая | | | линейная
Основная погрешность, % | | | приведенная | | | относительная
Второй датчик разности давлений (при наличии) | Модель
ВПИ | | | кг/см² | | | кПа
Функция преобразования | | | | корнеизвлекающая | | | линейная
Основная погрешность, % | | | | приведенная | | | относительная
Регистратор второго датчика разности давлений (при наличии) | Модель
Функция преобразования | | | | корнеизвлекающая | | | линейная
Основная погрешность, % | | | | приведенная | | | относительная
Требования к датчику измерения статического давления
Датчик измерения статического давления | Модель, измеряемое давление | | | абсолютное | | избыточное
ВПИ | | кг/см² | | | кПа | | МПа
Основная погрешность, % | | | приведенная | | | относительная
Регистратор датчика измерения статического давления | Модель
Основная погрешность, % | | | приведенная | | | относительная
Требования к датчику температуры
Установка гильзы | | | до диафрагмы | | | после диафрагмы
Расстояние между диафрагмой, мм
Внутренний диаметр D20 расширителя трубопро-вода (при наличии), мм
Датчик температуры | Модель
Диапазон измерений, °С | мин:___________ | макс:__________
Основная погрешность, % | | | | абсолют. | | | привед. | | относит.
Регистратор | Модель
Основная погрешность, % | | | | | абсолют. | | | привед. | | относит.
Требования к вычислителю
Вычислитель | Модель
Основная погрешность, % | | приведенная | относительная
Дополнительно требуется
| | | Сосуды | уравнител. | разделител. | конденсац.
✔ | Комплект фланцев для диафрагмы | ✔ | плоские | усиленные
| | | Фланцевое соединение (комплект фланцев с патрубками) | плоские | усиленные
✔ | | | Монтажное кольцо
| | | Дополнительная пара отборов (указать угол между отборами), град.

Дополнительные сведения

0,5 ЗОНД-10-ДД-1175 -(0÷63)-кПа-42-0,5-(-10..+50)-1,6МПа 63

Позиция | Наименование и техническая характеристика | Тип,марка,обозначение документа, опросного листа | код оборудования, изделия, материала | Завод-изготовитель | Едини. изме- рения | Коли- чество | Масса един кГ | Примечание
1 | 2 | 3 | | 5 | 6 | 7 | 8 | 9
| 1.Приборы по месту
| Сужающие устройства
| Сужающее устройство Ду50 в камерной диафрагме с КОФ | ДКС-10-50-А/Б | | ИТеК ББМВ | шт | 1 | 4,8 | Заказать по опросному листу
| Сужающее устройство Ду80 в камерной диафрагме с КОФ | ДКС-0,6-80-А/Б | | ИТеК ББМВ | шт | 1 | 8,9
| 2.Управление котлом
| Программно-аппаратный комплекс управления паровым котлом ДКВР-4/13 | ПАК-ДКВР4-035701 | ООО НПП "ЭСН" | шт | 1 | 949
| В том числе:
| Расход газа
1g0dPe1 | Преобразователь дифф давления 0..2,5 кПа | ЗОНД-10-ДД-1175м-(0÷2,5)-кПа-42-0,5- (-10..+50)-10кПа-газ | НПП "Гидрогазприбор" | шт | 1 | 4,8
| Давление газа в коллекторе
1g0Pe2 | Преобразователь избыточного давления 0..10 кПа | ЗОНД-10-ИД-1025м-(0÷10)-кПа-42-0,5- (-10..+50)-газ | НПП "Гидрогазприбор" | шт | 1 | 0,6
1g0Pg2 | Манометр показывающий 0..10 кПа | КМ-22Р.(0-10 кПа)М20×1,5. 1,5 IP54 | ЗАО "РОСМА" | шт | 1 | 0,59
| Температура газа в коллекторе
1g0Te1 | Преобразователь температуры -50..+50 °С | ПРОМА-ПТ-204-01-80-Р-(-50..+50) | НПП "Прома" | шт | 1 | 0,6
| Давление газа между ПЗК горелки
1g1..2Pe3 | Преобразователь избыточного давления 0..5 кПа | | НПП "Гидрогазприбор" | шт | 2 | 1,2 ЗОНД-10-ИД-1025м-(0÷5)-кПа-42-0,5- (-10..+50)-газ
1g1..2Pg3 | Манометр показывающий 0..5 кПа | КМ-22Р.(0-5 кПа)М20×1,5. 1,5 IP54 | ЗАО "РОСМА" | шт | 2 | 1,18
| Давление газа перед горелкой
1g1..2Pe4 | Преобразователь избыточного давления 0..2,5 кПа | ЗОНД-10-ИД-1025м-(0÷2,5)-кПа-42-0,5- (-10..+50)-газ | НПП "Гидрогазприбор" | шт | 2 | 1,2
1g1..2Pi4 | Манометр показывающий 0..2,5 кПа | КМ-22Р.(0-2,5 кПа)М20×1,5. 1,5 IP54 | ЗАО "РОСМА" | шт | 2 | 1,18

### Давление воздуха в общем воздуховоде

Преобразователь избыточного давления 0..10 кПа | ЗОНД-10-ИД-1025м-(0÷10)-кПа-42-0,5-(-10..+50)-газ ¹a0Pe1 | НПП "Гидрогазприбор" | шт | 1 | 0,6
| Давление воздуха перед горелкой
| | 1a1..2Pe2 | Преобразователь избыточного давления 0..2,5 кПа | | НПП "Гидрогазприбор" | шт | 2 ЗОНД-10-ИД-1025м-(0÷2,5)-кПа-42-0,5- (-10..+50)-газ | 1,2
| | 1a1..2Pi2 | Манометр показывающий 0..2,5 кПа | КМ-22Р.(0-2,5 кПа)М20×1,5. 1,5 IP54 | ЗАО "РОСМА" | шт | 2 | 1,18
*В связи с заменой исполнительных механизмов, необходимо провести режиную наладку горелок на 8 нагрузках.
изм | к.уч. | лист | N докум | подпись | дата
| | | | Автоматизация. Котел №1 ДКВР-4/13 | Стадия | Лист | Листов
| | | | | РД | 1 | 5
Разработ. | Чураков
| | Спецификация оборудования и материалов | ООО НПП "ЭСН"
Н.контр.
формат А3

инв.

№ подл

Согласовано

подп.

и дата взамен инв

№

357-22-АГСВ1.СО

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

Позиция | Наименование и техническая характеристика | Тип,марка,обозначение документа, опросного листа | код оборудования, изделия, материала | Завод-изготовитель | Едини. изме- рения | Коли- чество | Масса един кГ | Примечание
1 | 2 | 3 | | 5 | 6 | 7 | 8 | 9
| Расход питательной воды
1w0dPe1 | Преобразователь дифф давления 0..16 кПа | ЗОНД-10-ДД-1175м-(0÷16)-кПа-42-0,5- (-10..+50)-1,6МПа-вода 60°С | | НПП "Гидрогазприбор" | шт | 1 | 4,8
| Давление воды перед регулирующей заслонкой
1w0Pe2 | Преобразователь избыточного давления 0..1,6 МПа | | НПП "Гидрогазприбор" | шт | 1 | 0,6 ЗОНД-10-ИД-1025м-(0÷1,6)-МПа-42-0,5- (-10..+50)-вода 60°С
1w0Pg2 | Манометр показывающий 0..1,6 Мпа | МП4-УУ2-1,6МПа-1,5-IP54 | ОАО "Манотомь" | шт | 1 | 1,2
| Давление воды после регулирующей заслонкой
1w0Pe3 | Преобразователь избыточного давления 0..1,6 МПа | ЗОНД-10-ИД-1025м-(0÷1,6)-МПа-42-0,5-(-10..+50)-вода 60°С | НПП "Гидрогазприбор" | шт | 1 | 0,6
1w0Pg3 | Манометр показывающий 0..1,6 Мпа | МП4-УУ2-1,6МПа-1,5-IP54 | ОАО "Манотомь" | шт | 1 | 1,2
| Уровень воды в барабане котла
1w0dPe4 | Преобразователь дифф давления 0..16 кПа | ЗОНД-10-ДД-1175м-(0÷16)-кПа-42-0,5- (-10..+50)-1,6МПа-вода 60°С | НПП "Гидрогазприбор" | шт | 1 | 4,8
1w0dPg4 | Рефлексионный указатель уровня | КЛИНГЕР R-100 D-YII | ООО "Клингер" | шт | 2 | 11,8
| Давление пара в барабане котла
1s0Pe1 | Преобразователь избыточного давления 0..1,6 МПа | ЗОНД-10-ИД-1025м-(0÷1,6)-МПа-42-0,5-(-10..+50)-насыщенный пар | НПП "Гидрогазприбор" | шт | 1 | 0,6
1s0Pg1 | Манометр показывающий 0..1,6 Мпа | МП4-УУ2-1,6МПа-1,5-IP54 | ОАО "Манотомь" | шт | 1 | 1,2
| Давление пара на выходе
1s0Pe2 | Преобразователь избыточного давления 0..1,6 МПа | ЗОНД-10-ИД-1025м-(0÷1,6)-МПа-42-0,5-(-10..+50)-насыщенный пар | НПП "Гидрогазприбор" | шт | 1 | 0,6
1s0Pg2 | Манометр показывающий 0..1,6 Мпа | МП4-УУ2-1,6МПа-1,5-IP54 | ОАО "Манотомь" | шт | 1 | 1,2
| Расход пара
1s0dPe3 | Преобразователь дифф давления 0..63 кПа | ЗОНД-10-ДД-1175м-(0÷63)-кПа-42-0,5-(-10..+50)-1,6МПа-насыщенный пар | НПП "Гидрогазприбор" | шт | 1 | 4,8
| Разрежение в топке котла
1f0Pe1 | Преобразователь мановакуумметрического давления ±125 Па | ЗОНД-10-ДИВ-1025м-(±125)-Па-42-0,5-(-10..+50)-разрежение в топке | НПП "Гидрогазприбор" | шт | 1 | 0,6
1f0Pi1 | Тягонапоромер ±125 Па | ТНМП-52-М3-(-125Па..0..+125кПа)-1,5%-У3(- 50+60ºС)-IP53 | ПАО "Саранский приборостроительный завод" | шт | 1 | 0,5
| Температура дымовых газов
1f0Te1 | Преобразователь температуры 0..+400 °С | ПРОМА-ПТ-204-01-80-Р-(0..+400) | НПП "Прома" | шт | 1 | 0,6
| Исполнительные механизмы
1g1..2Mv5 | Электромагнитный клапан с датчиком положения PNP типа, нормально закрытый, сталь, с комплектом ответных фланцев, прокладок, крепежа (КОФ) | ВН3/4Н-4П | | СП "Термобрест" ООО | шт | 2 | 9
| изм | к.уч. | лист | N докум | подпись | дата | | Лист

взамен инв.

№

дата

и подп

. инв. № подл. 357-22-АГСВ1.СО 2

формат А3

Позиция | Наименование и техническая характеристика | Тип,марка,обозначение документа, опросного листа | код оборудования, изделия, материала | Завод-изготовитель | Едини. изме- рения | Коли- чество | Масса един кГ | Примечание
1 | 2 | 3 | | 5 | 6 | 7 | 8 | 9
1g1..2Mv1 | Электромагнитный клапан с датчиком положения PNP типа, нормально закрытый, сталь, с КОФ | ВН Н-1П 3 | | СП "Термобрест" ООО | шт | 2 | 59,2
1g1..2Mv6 | с датчиком положения PNP типа, нормально открытый, сталь, с КОФ | ВФ1Н-4П | | СП "Термобрест" ООО Электромагнитный клапан | шт | 2 | 6
1g1..2Mv2 | Электрмагнитный клапан с датчиком положения PNP типа, нормально закрытый, сталь, с КОФ | ВН Н-1 П 3 | | СП "Термобрест" ООО | шт | 2 | 59,2
1g1..2Mv4 | Электромагнитный клапан с датчиком положения PNP типа, нормально закрытый, сталь, с КОФ | ВН3/4 Н-4П | | СП "Термобрест" ООО | шт | 2 | 9
1g1..2Ms3 | Заслонка с электроприводом | ЗД-80 | | АО "Гипрониигаз" | шт | 2 | 16
1a1..2Ms2 | Электропривод заслонки | МЭО-100/63-0,25 У У 3 | | АБС "ЗЭиМ" | шт | 2 | 64
1w0Ms1 | Электропривод заслонки | МЭОФ-40/63-0,25 У У 3 | | АБС "ЗЭиМ" | шт | 1 | 8
1f0Ms1 | Электропривод осевого направляющего аппарата | МЭО-100/63-0,25 У У 3 | | АБС "ЗЭиМ" | шт | 1 | 32
1x1..2Bs1 | Прибор контроля факела | ЛУЧ-КЭ-Н | ООО "ПромАвтоматика" | шт | 2 | 1,2
1x1..2Bs2 | Прибор контроля факела | ЛУЧ-КЭ-Н | ООО "ПромАвтоматика" | шт | 2 | 1,2
| Контрольный электрод | ИЗОМС-01-1-1200 | ООО "Общемаш" | шт | 4 | 8
1x1..2B3 | Трансформатор розжига | ИВН-ТР-М | ООО "ПромАвтоматика" | шт | 2 | 4
| Электрозапальник монтажная длина 500мм в комплекте с ионизационным датчиком, с установ. комплектом | ЗСУ-ПИ-45-00-500 | ООО "ПромАвтоматика" | шт | 2 | 12
| Шкафы управления
ШУК1 | Шкаф управления котлом с ПО и ЗИП | ШУ-7-96.64.32.0-4.1.1-0.0-35702 | ООО НПП "ЭСН" | шт | 1 | 247
ШП1 | Шкаф питания котла с ЗИП | ШУП-0-6 х100-0.0.0.0-0.0-35703 | ООО НПП "ЭСН" | шт | 1 | 247

### ЗИП

Преобразователь дифф давления 0..2,5 кПа | ЗОНД-10-ДД-1175 м-(0÷2,5)-кПа-42-0,5-(-10..+50)-10кПа-газ | | НПП "Гидрогазприбор" | шт | 1 | 4,8
Преобразователь дифф давления 0..16 кПа | ЗОНД-10-ДД-1175 м-(0÷16)-кПа-42-0,5-(-10..+50)-1,6МПа-вода 60° С | | НПП "Гидрогазприбор" | шт | 1 | 4,8
Преобразователь дифф давления 0..63 кПа | ЗОНД-10-ДД-1175 м-(0÷63)-кПа-42-0,5-(-10..+50)-1,6МПа-насыщенный пар | | НПП "Гидрогазприбор" | шт | 1 | 4,8
Преобразователь избыточного давления 0..10 кПа | ЗОНД-10-ИД-1025 м-(0÷10)-кПа-42-0,5-(-10..+50)-газ | | НПП "Гидрогазприбор" | шт | 1 | 0,6
Преобразователь избыточного давления 0..5 кПа | ЗОНД-10-ИД-1025 м-(0÷5)-кПа-42-0,5-(-10..+50)-газ | | НПП "Гидрогазприбор" | шт | 1 | 0,6
Преобразователь избыточного давления 0..1,6 МПа | ЗОНД-10-ИД-1025 м-(0÷1,6)-МПа-42-0,5-С (-10..+50)-вода 60° | | НПП "Гидрогазприбор" | шт | 1 | 0,6
| | Преобразователь избыточного давления 0..1,6 МПа | ЗОНД-10-ИД-1025 м-(0÷1,6)-МПа-42-0,5-(-10..+50)-насыщенный пар | | НПП "Гидрогазприбор" | шт | 1 | 0,6
| | Преобразователь мановакуумметрического давления ±125 Па | ЗОНД-10-ДИВ-1025 м-(±125)-Па-42-0,5-(-10..+50)-разрежение в топке | | НПП "Гидрогазприбор" | шт | 1 | 0,6
| | Тягонапоромер ±125 Па | ТНМП-52-М3-(-125Па..0..+125кПа)-1,5%-У3(-С)-IP53 50+60º | | ПАО "Саранский приборостроительный завод" | шт | 1 | 0,5
| | Манометр показывающий 0..10 кПа | Р.(0-10 кПа)М20×1,5. 1,5 IP54 | | ЗАО "РОСМА" | шт | 1 | 0,59
| | Манометр показывающий 0..5 кПа | КМ-22 Р.(0-5 кПа)М20×1,5. 1,5 IP54 | | ЗАО "РОСМА" | шт | 1 | 0,59
| | Манометр показывающий 0..2,5 кПа | Р.(0-2,5 кПа)М20×1,5. 1,5 IP54 | | ЗАО "РОСМА" | шт | 1 | 0,59
изм | к.уч. | лист | N докум | подпись | дата | 357-22-АГСВ1.СО | лист

взамен инв. № дата и подп. КМ-22

инв. № подл. КМ-22
3
формат

А3

Позиция | Наименование и техническая характеристика | Тип,марка,обозначение документа, опросного листа | код оборудования, изделия, материала | Завод-изготовитель | Едини. изме- рения | Коли- чество | Масса един кГ | Примечание
1 | 2 | 3 | | 5 | 6 | 7 | 8 | 9
| Преобразователь температуры -50..+50 °С | ПРОМА-ПТ-204-01-80-Р-(-50..+50) | | НПП "Прома" | шт | 1 | 0,6
| Преобразователь температуры 0..+400 °С | ПРОМА-ПТ-204-01-80-Р-(0..+400) | | НПП "Прома" | шт | 1 | 0,6
| Манометр показывающий 0..1,6 Мпа | МП4-УУ2-1,6МПа-1,5-IP54 | | ОАО "Манотомь" | шт | 1 | 1,2
| Рефлексионный указатель уровня | КЛИНГЕР R-100 D-YII | | ООО "Клингер" | шт | 1 | 5,9
| Электромагнитный клапан с датчиком положения PNP типа, нормально закрытый, сталь, с КОФ | ВН3/4Н-4П | | СП "Термобрест" ООО | шт | 1 | 4,5
| Электромагнитный клапан с датчиком положения PNP типа, нормально закрытый, сталь, с КОФ | ВН3Н-1П | | СП "Термобрест" ООО | шт | 1 | 29,6
| Электромагнитный клапан с датчиком положения PNP типа, нормально открытый, сталь, с КОФ | ВФ1Н-4П | | СП "Термобрест" ООО | шт | 1 | 3
| Электропривод заслонки | МЭОФ-40/63-0,25У У3 | | АБС "ЗЭиМ" | шт | 1 | 8
| Электропривод заслонки | МЭО-100/63-0,25У У3 | | АБС "ЗЭиМ" | шт | 1 | 32
| Заслонка с электроприводом | ЗД-80 | | АО "Гипрониигаз" | шт | 1 | 8
| Прибор контроля факела | ЛУЧ-КЭ-Н | | ООО "ПромАвтоматика" | шт | 1 | 0,6
| Контрольный электрод | ИЗОМС-01-1-1200 | | ООО "Общемаш" | шт | 1 | 2
| Трансформатор розжига | ИВН-ТР-М | | ООО "ПромАвтоматика" | шт | 1 | 2
| Электрозапальник монтажная длина 500мм в комплекте с ионизационным датчиком, с установ. комплектом | ЗСУ-ПИ-45-00-500 | | ООО "ПромАвтоматика" | шт | 1 | 6

3.Кабельная продукция
Провод белый 1х0,5 | ПуГВ | Подольсккабель | м | 7 | 1
Кабель силовой 4х1,5 | ПВСнг LS | Альфакабель | м | 120 | 14
Кабель силовой 4х35 | ВВГЭнг LS | Подольсккабель | м | 8 | 16
Кабель силовой 2x2,5 | ВВГЭнг LS | Подольсккабель | м | 6 | 2
Кабель силовой 4x4 | ВВГЭнг LS | Подольсккабель | м | 12 | 7
Кабель силовой 4x16 | ВВГЭнг LS | Подольсккабель | м | 40 | 46
Кабель контрольный 2x0,5 | МКЭШнг LS | Подольсккабель | м | 348 | 26
Кабель контрольный 3x0,5 | МКЭШнг LS | Подольсккабель | м | 120 | 9
Кабель контрольный 5x0,5 | МКШнг LS | Подольсккабель | м | 120 | 9
Кабель контрольный 4x0,5 | МКШнг LS | Подольсккабель | м | 52 | 4
Кабель контрольный 3x0,5 | МКШнг LS | Подольсккабель | м | 140 | 7
Кабель контрольный 2x0,5 | МКШнг LS | Подольсккабель | м | 56 | 3
Кабель силовой 4x1,5 | ВВГнг LS | Подольсккабель | м | 52 | 12
Кабель силовой 5x1,5 | ВВГнг LS | Подольсккабель | м | 7 | 2
Кабель силовой 14x1,5 | КВВГнг LS | Подольсккабель | м | 13 | 5
Кабель силовой 3x1,5 | ВВГнг LS | Подольсккабель | м | 168 | 25
Провод желто-зеленый 1х4,0 | ПуГВ | Подольсккабель | м | 50 | 2
Гофра ПВХ с протяжкой | Ф16мм | | DKC | м | 306 | 11
Гофра ПВХ с протяжкой | Ф25мм | | DKC | м | 6 | 0,39
Гофра ПВХ с протяжкой | Ф90мм | | DKC | м | 10 | 4,1
| | Бирка маркировочная квадратная для кабеля до 1кВ | У-134 (250) | | FORTISFLEX | шт | 30 | 1
| | Бирка маркировочная треугольная для контрольного кабеля | У-136 (400) | | FORTISFLEX | шт | 70 | 1
| | Хомут полиамид белый | 3,6х290 P6.6 | | DKC | уп | 2 | 1
| | Трубка термоусадочная | ТТУ 30/15 | | IEK | м | 5 | 1
| | Трубка термоусадочная | | | | м | 5 | 1
изм | к.уч. | лист | N докум | подпись | дата | 357-22-АГСВ1.СО | лист
4
формат А3

инв.

№ подл

. ТТУ 20/10 IEK

взамен инв.

№

дата

и подп

Позиция | Наименование и техническая характеристика | Тип,марка,обозначение документа, опросного листа | код оборудования, изделия, материала | Завод-изготовитель | Едини. изме- рения | Коли- чество | Масса един кГ | Примечание
1 | 2 | 3 | | 5 | 6 | 7 | 8 | 9
| Трубка термоусадочная | ТТУ 40/20 | | IEK | м | 5 | 1
изм | к.уч. | лист | N докум | подпись | дата | лист

взамен инв.

№ дата и подп. инв. № подл. 357-22-АГСВ1.СО 5

формат А3

№ кабеля | Марка кабеля, количествожил, сечение проводников | Источник подключения | Приемник подключения | Способ защиты | Едини. изме- рения | Коли- чество | Масса един (кГ) | Примечание
1 | 2 | 3 | 4 | 5 | 6 | 7 | 8 | 9
1 | ВВГЭнг LS 4х35 | м | 8
2 | ВВГЭнг LS 2x2,5 | ШП1/SF12 | ШУК1/1QF | Кабельный лоток | м | 6
| | | | Гофра ПВХ 16мм | м | 1
3 | ВВГЭнг LS 4x4 | ШП1/QF2 | ШУПЧв/1QF | Кабельный лоток | м | 12
| | | (см.АГСВ) | Гофра ПВХ 25мм | м | 4
4 | ВВГЭнг LS 4x16 | ШП1/QF1 | ШУПЧд/1QF | Кабельный лоток | м | 40
| | | (см.АГСВ) | Гофра ПВХ 90мм | м | 10
5 | МКЭШнг LS 2x0,5 | ШУК1/ХТ1 | 1g0dPe1 | Кабельный лоток | м | 14
| | | | Гофра ПВХ 16мм | м | 4
6 | МКЭШнг LS 2x0,5 | ШУК1/ХТ1 | 1g0Pe2 | Кабельный лоток | м | 14
| | | | Гофра ПВХ 16мм | м | 4
7 | МКЭШнг LS 2x0,5 | ШУК1/ХТ1 | 1g0Te1 | Кабельный лоток | м | 14
| | | | | | | | Гофра ПВХ 16мм | м | 4
| | | | 8 | МКЭШнг LS 2x0,5 | ШУК1/ХТ1 | 1a0Pe1 | Кабельный лоток | м | 14
| | | | | | | | Гофра ПВХ 16мм | м | 4
| | | | 9 | МКЭШнг LS 2x0,5 | ШУК1/ХТ1 | 1g1Pe3 | Кабельный лоток | м | 14
| | | | | | | | Гофра ПВХ 16мм | м | 4
| | | | 10 | МКЭШнг LS 2x0,5 | ШУК1/ХТ1 | 1g1Pe4 | Кабельный лоток | м | 14
| | | | | | | | Гофра ПВХ 16мм | м | 4
| | | | 11 | МКЭШнг LS 2x0,5 | ШУК1/ХТ1 | 1a1Pe2 | Кабельный лоток | м | 14
| | | | | | | | Гофра ПВХ 16мм | м | 4
| | | | 12 | МКЭШнг LS 3x0,5 | ШУК1/ХТ1 | 1g1Ms3 | Кабельный лоток | м | 14
| | | | | | | Гофра ПВХ 16мм | м | 4
| | | 13 | МКЭШнг LS 3x0,5 | ШУК1/ХТ1 | 1a1Ms2 | Кабельный лоток | м | 14
| | | | | | | Гофра ПВХ 16мм | м | 4
изм | к.уч. | лист | N докум | подпись | дата
| | | | Автоматизация. Котел ДКВР-4/13 №1 | Стадия | Лист | Листов 5 Разраб.
| Чураков | | | | РД | 1
Проверил | Шакиров | | | Кабельный журнал | ООО НПП "ЭСН"

формат А3

взамен инв

№

Н. контр. Корепанов

подп.

и дата

инв.

№ подл

## 357-22-АГСВ1.КЖ

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

Согласовано

ШАВР/QF1 (см.АГСВ) | ШП1/1QF | Кабельный лоток

№ кабеля | Марка кабеля, количествожил, сечение проводников | Источник подключения | Приемник подключения | Способ защиты | Едини. изме- рения | Коли- чество | Масса един кГ | Примечание
1 | 2 | 3 | 4 | 5 | 6 | 7 | 8 | 9
14 | МКЭШнг LS 2x0,5 | ШУК1/ХТ1 | 1g2Pe3 | Кабельный лоток | м | 14
| | | | Гофра ПВХ 16мм | м | 4
15 | МКЭШнг LS 2x0,5 | ШУК1/ХТ1 | 1g2Pe4 | Кабельный лоток | м | 14
| | | | Гофра ПВХ 16мм | м | 4
16 | МКЭШнг LS 2x0,5 | ШУК1/ХТ1 | 1a2Pe2 | Кабельный лоток | м | 14
| | | | Гофра ПВХ 16мм | м | 4
17 | МКЭШнг LS 3x0,5 | ШУК1/ХТ1 | 1g2Ms3 | Кабельный лоток | м | 14
| | | | Гофра ПВХ 16мм | м | 4
18 | МКЭШнг LS 3x0,5 | ШУК1/ХТ1 | 1a2Ms2 | Кабельный лоток | м | 14
| | | | Гофра ПВХ 16мм | м | 4
19 | МКЭШнг LS 2x0,5 | ШУК1/ХТ2 | 1w0dPe1 | Кабельный лоток | м | 25
| | | | Гофра ПВХ 16мм | м | 4
20 | МКЭШнг LS 2x0,5 | ШУК1/ХТ2 | 1w0Pe2 | Кабельный лоток | м | 19
| | | | Гофра ПВХ 16мм | м | 4
21 | МКЭШнг LS 2x0,5 | ШУК1/ХТ2 | 1w0Pe3 | Кабельный лоток | м | 19
| | | | Гофра ПВХ 16мм | м | 4
22 | МКЭШнг LS 3x0,5 | ШУК1/ХТ2 | 1w0Ms1 | Кабельный лоток | м | 19
| | | | Гофра ПВХ 16мм | м | 4
23 | МКЭШнг LS 2x0,5 | ШУК1/ХТ2 | 1w0dPe4 | Кабельный лоток | м | 19
| | | | Гофра ПВХ 16мм | м | 4
24 | МКЭШнг LS 2x0,5 | ШУК1/ХТ2 | 1s0Pe1 | Кабельный лоток | м | 19
| | | | Гофра ПВХ 16мм | м | 4
25 | МКЭШнг LS 2x0,5 | ШУК1/ХТ2 | 1s0Pe2 | Кабельный лоток | м | 22
| | | | Гофра ПВХ 16мм | м | 4
| | 26 | МКЭШнг LS 2x0,5 | ШУК1/ХТ2 | 1s0dPe3 | Кабельный лоток | м | 25
| | | | | | Гофра ПВХ 16мм | м | 4
| | 27 | МКЭШнг LS 2x0,5 | ШУК1/ХТ2 | 1f0Pe1 | Кабельный лоток | м | 20
| | | | | | Гофра ПВХ 16мм | м | 4
| | 28 | МКЭШнг LS 2x0,5 | ШУК1/ХТ2 | 1f0Te1 | Кабельный лоток | м | 40
| | | | | | Гофра ПВХ 16мм | м | 10
| | 29 | МКЭШнг LS 3x0,5 | ШУК1/ХТ2 | 1f0Ms1 | Кабельный лоток | м | 45
| | | | | | Гофра ПВХ 16мм | м | 10
к.уч. | лист | N докум | подпись | дата | Лист

Инв

№ подл

формат А3

изм
357-22-АГСВ1.КЖ | 2

Подп

и дата

взамен инв

№

№ кабеля | Марка кабеля, количествожил, сечение проводников | Источник подключения | Приемник подключения | Способ защиты | Едини. изме- рения | Коли- чество | Масса един кГ | Примечание
1 | 2 | 3 | 4 | 5 | 6 | 7 | 8 | 9
30 | МКШнг LS 5x0,5 | ШУК1/ХТ3 | 1w0Ms1 | Кабельный лоток | м | 19
| | | | Гофра ПВХ 16мм | м | 4
31 | МКШнг LS 4x0,5 | ШУК1/ХТ3 | 1a0fMf1 | Кабельный лоток | м | 12
| | | | Гофра ПВХ 16мм | м | 4
32 | МКШнг LS 4x0,5 | ШУК1/ХТ3 | 1f0fMf2 | Кабельный лоток | м | 40
| | | | Гофра ПВХ 16мм | м | 10
33 | МКШнг LS 5x0,5 | ШУК1/ХТ3 | 1f0Ms1 | Кабельный лоток | м | 45
| | | | Гофра ПВХ 16мм | м | 10
34 | МКШнг LS 3x0,5 | ШУК1/ХТ4 | 1g1Mv5 | Кабельный лоток | м | 14
| | | | Гофра ПВХ 16мм | м | 4
35 | МКШнг LS 3x0,5 | ШУК1/ХТ4 | 1g1Mv1 | Кабельный лоток | м | 14
| | | | Гофра ПВХ 16мм | м | 4
36 | МКШнг LS 3x0,5 | ШУК1/ХТ4 | 1g1Mv2 | Кабельный лоток | м | 14
| | | | Гофра ПВХ 16мм | м | 4
37 | МКШнг LS 3x0,5 | ШУК1/ХТ4 | 1g1Mv6 | Кабельный лоток | м | 14
| | | | Гофра ПВХ 16мм | м | 4
38 | МКШнг LS 3x0,5 | ШУК1/ХТ4 | 1g1Mv4 | Кабельный лоток | м | 14
| | | | Гофра ПВХ 16мм | м | 4
39 | МКШнг LS 5x0,5 | ШУК1/ХТ4 | 1g1Ms3 | Кабельный лоток | м | 14
| | | | Гофра ПВХ 16мм | м | 4
40 | МКШнг LS 5x0,5 | ШУК1/ХТ4 | 1a1Ms2 | Кабельный лоток | м | 14
| | | | Гофра ПВХ 16мм | м | 4
41 | МКШнг LS 2x0,5 | ШУК1/ХТ4 | 1x1Bs1 | Кабельный лоток | м | 14
| | | | Гофра ПВХ 16мм | м | 4
| | 42 | МКШнг LS 2x0,5 | ШУК1/ХТ4 | 1x1Bs2 | Кабельный лоток | м | 14
| | | | | | Гофра ПВХ 16мм | м | 4
| | 43 | МКШнг LS 3x0,5 | ШУК1/ХТ5 | 1g2Mv5 | Кабельный лоток | м | 14
| | | | | | Гофра ПВХ 16мм | м | 4
| | 44 | МКШнг LS 3x0,5 | ШУК1/ХТ5 | 1g2Mv1 | Кабельный лоток | м | 14
| | | | | | Гофра ПВХ 16мм | м | 4
| | 45 | МКШнг LS 3x0,5 | ШУК1/ХТ5 | 1g2Mv2 | Кабельный лоток | м | 14
| | | | | | Гофра ПВХ 16мм | м | 4
к.уч. | лист | N докум | подпись | дата | лист

инв

.№подл

формат А3

изм
357-22-АГСВ1.КЖ | 3

дата

и подп

взамен инвю№

№ кабеля | Марка кабеля, количествожил, сечение проводников | Источник подключения | Приемник подключения | Способ защиты | Едини. изме- рения | Коли- чество | Масса един кГ | Примечание
1 | 2 | 3 | 4 | 5 | 6 | 7 | 8 | 9
46 | МКШнг LS 3x0,5 | ШУК1/ХТ5 | 1g2Mv6 | Кабельный лоток | м | 14
| | | | Гофра ПВХ 16мм | м | 4
47 | МКШнг LS 3x0,5 | ШУК1/ХТ5 | 1g2Mv4 | Кабельный лоток | м | 14
| | | | Гофра ПВХ 16мм | м | 4
48 | МКШнг LS 5x0,5 | ШУК1/ХТ5 | 1g2Ms3 | Кабельный лоток | м | 14
| | | | Гофра ПВХ 16мм | м | 4
49 | МКШнг LS 5x0,5 | ШУК1/ХТ5 | 1a2Ms2 | Кабельный лоток | м | 14
| | | | Гофра ПВХ 16мм | м | 4
50 | МКШнг LS 2x0,5 | ШУК1/ХТ5 | 1x2Bs1 | Кабельный лоток | м | 14
| | | | Гофра ПВХ 16мм | м | 4
51 | МКШнг LS 2x0,5 | ШУК1/ХТ5 | 1x2Bs2 | Кабельный лоток | м | 14
| | | | Гофра ПВХ 16мм | м | 4
52 | ВВГнг LS 4x1,5 | ШУК1/ХТ6 | ШУПЧв/XT1 | Кабельный лоток | м | 12
| | | | Гофра ПВХ 16мм | м | 3
53 | ВВГнг LS 4x1,5 | ШУК1/ХТ6 | ШУПЧд/XT1 | Кабельный лоток | м | 40
| | | | Гофра ПВХ 16мм | м | 10
54 | ВВГнг LS 5x1,5 | ШУК1/ХТ6 | ШП1/XT1 | Кабельный лоток | м | 7
| | | | Гофра ПВХ 16мм | м | 1
55 | ПВСнг LS 4x1,5 | ШП1/ХТ4 | 1f0Ms1 | Кабельный лоток | м | 45
| | | | Гофра ПВХ 16мм | м | 10
56 | ПВСнг LS 4x1,5 | ШП1/ХТ4 | 1w0Ms1 | Кабельный лоток | м | 19
| | | | Гофра ПВХ 16мм | м | 4
57 | КВВГнг LS 14x1,5 | ШУК1/XT7 | ШП1/ХТ2 | Кабельный лоток | м | 7
| | | | Гофра ПВХ 25мм | м | 1
| | 58 | ВВГнг LS 3x1,5 | ШП1/ХТ4 | 1g1Mv5 | Кабельный лоток | м | 14
| | | | | | Гофра ПВХ 16мм | м | 4
| | 59 | ВВГнг LS 3x1,5 | ШП1/ХТ4 | 1g1Mv1 | Кабельный лоток | м | 14
| | | | | | Гофра ПВХ 16мм | м | 4
| | 60 | ВВГнг LS 3x1,5 | ШП1/ХТ4 | 1g1Mv2 | Кабельный лоток | м | 14
| | | | | | Гофра ПВХ 16мм | м | 4
| | 61 | ВВГнг LS 3x1,5 | ШП1/ХТ4 | 1g1Mv6 | Кабельный лоток | м | 14
| | | | | | Гофра ПВХ 16мм | м | 4
к.уч. | лист | N докум | подпись | дата | лист

формат А3

изм
357-22-АГСВ1.КЖ | 4

инв

.№подл

дата

и подп

взамен инвю№

№ кабеля | Марка кабеля, количествожил, сечение проводников | Источник подключения | Приемник подключения | Способ защиты | Едини. изме- рения | Коли- чество | Масса един кГ | Примечание
1 | 2 | 3 | 4 | 5 | 6 | 7 | 8 | 9
62 | ВВГнг LS 3x1,5 | ШП1/ХТ4 | 1g1Mv4 | Кабельный лоток | м | 14
| | | | Гофра ПВХ 16мм | м | 4
63 | ПВСнг LS 4x1,5 | ШП1/ХТ4 | 1g1Ms3 | Кабельный лоток | м | 14
| | | | Гофра ПВХ 16мм | м | 4
64 | ПВСнг LS 4x1,5 | ШП1/ХТ4 | 1a1Ms2 | Кабельный лоток | м | 14
| | | | Гофра ПВХ 16мм | м | 4
65 | ВВГнг LS 3x1,5 | ШП1/ХТ4 | 1x1B3 | Кабельный лоток | м | 14
| | | | Гофра ПВХ 16мм | м | 4
66 | КВВГнг LS 14x1,5 | ШУК1/XT7 | ШП1/ХТ3 | Кабельный лоток | м | 6
| | | | Гофра ПВХ 25мм | м | 1
| | ШП1/ХТ4 | 1g2Mv5 | Кабельный лоток
| | | | Гофра ПВХ 16мм | м | 4
68 | ВВГнг LS 3x1,5 | ШП1/ХТ4 | 1g2Mv1 | Кабельный лоток | м | 14
| | | | Гофра ПВХ 16мм | м | 4
69 | ВВГнг LS 3x1,5 | ШП1/ХТ4 | 1g2Mv2 | Кабельный лоток | м | 14
| | | | Гофра ПВХ 16мм | м | 4
70 | ВВГнг LS 3x1,5 | ШП1/ХТ4 | 1g2Mv6 | Кабельный лоток | м | 14
| | | | Гофра ПВХ 16мм | м | 4
71 | ВВГнг LS 3x1,5 | ШП1/ХТ4 | 1g2Mv4 | Кабельный лоток | м | 14
| | | | Гофра ПВХ 16мм | м | 4
72 | ПВСнг LS 4x1,5 | ШП1/ХТ4 | 1g2Ms3 | Кабельный лоток | м | 14
| | | | Гофра ПВХ 16мм | м | 4
73 | ПВСнг LS 4x1,5 | ШП1/ХТ4 | 1a2Ms2 | Кабельный лоток | м | 14
| | | | Гофра ПВХ 16мм | м | 4
| | 74 | ВВГнг LS 3x1,5 | ШП1/ХТ4 | 1x2B3 | Кабельный лоток | м | 14
| | | | | | Гофра ПВХ 16мм | м | 4
| | 75 | ПуГВ 1x0,5 | ШУК1/ХТ3 | ШП1/ХТ4 | Кабельный лоток | м | 7
| | | | | | | м | 1
L | 67 | ВВГнг LS 3x1,5 | м | 14
к.уч. | лист | N докум | подпись | дата | лист

формат А3

инв

.№подл

изм
357-22-АГСВ1.КЖ | 5

дата

и подп

## взамен Гофра ПВХ 16мм

инвю№

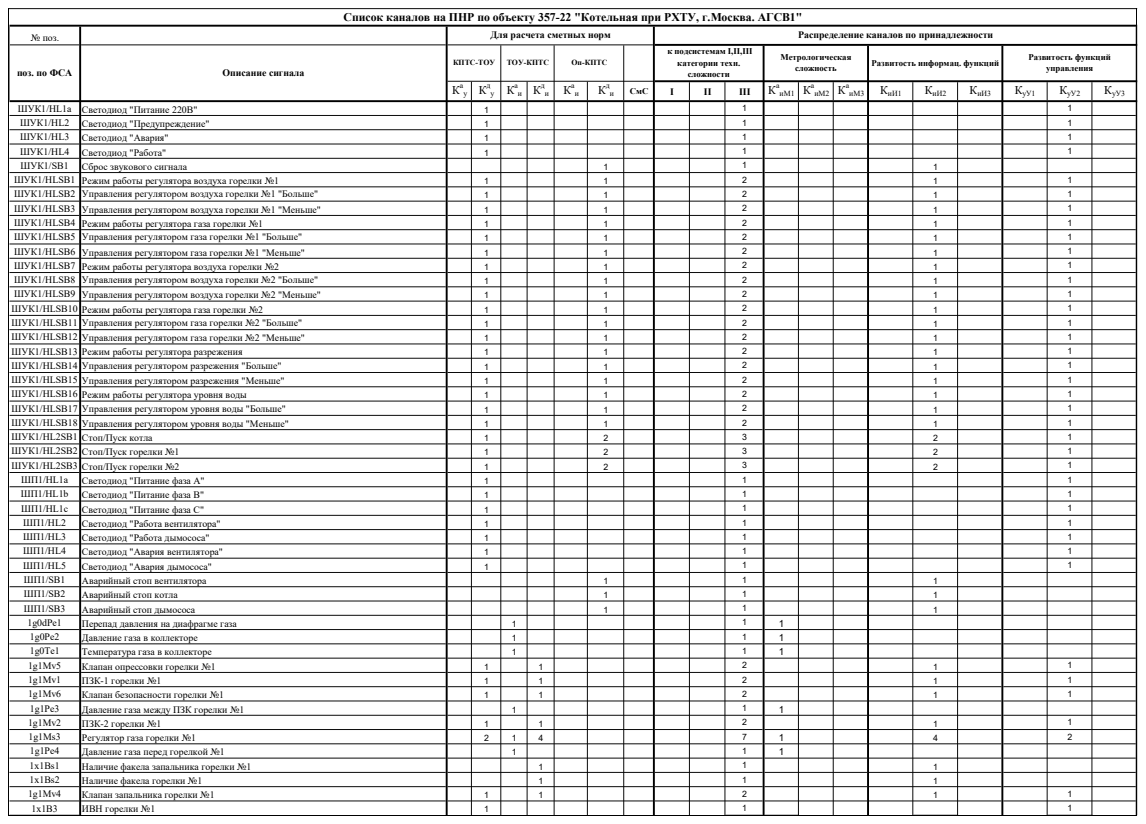
[picture p48: page 42]
ШУК1/HL1a; Светодиод "Питание 220В"; ШУК1/HL2; Светодиод "Предупреждение"; ШУК1/HL3; Светодиод "Авария"; ШУК1/HL4; Светодиод "Работа"; ШУК1/SB1; Сброс звукового сигнала; ШУК1/HLSB1; Режим работы регулятора воздуха горелки №1; ШУК1/HLSB2; Управления регулятором воздуха горелки №1 "Больше"; ШУК1/HLSB3; Управления регулятором воздуха горелки №1 "Меньше"; ШУК1/HLSB4; Режим работы регулятора газа горелки №1; ШУК1/HLSB5; Управления регулятором газа горелки №1 "Больше"; ШУК1/HLSB6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

Список каналов на ПНР по объекту 357-22 "Котельная при РХТУ, г.Москва. АГСВ1"

№ поз. | | Для расчета сметных норм | Распределение каналов по принадлежности
поз. по ФСА | Описание сигнала | КПТС-ТОУ ТОУ-КПТС Оп-КПТС | к подсистемам I,II,III категории техн. сложности | Метрологическая сложность | Развитость информац. функций | Развитость функций управления

а д а д а д К у К у К и К и К и К и СмС | I II III | а а а К иМ1 К иМ2 К иМ3 | КиИ1 КиИ2 КиИ3 | КуУ1 КуУ2 КуУ3

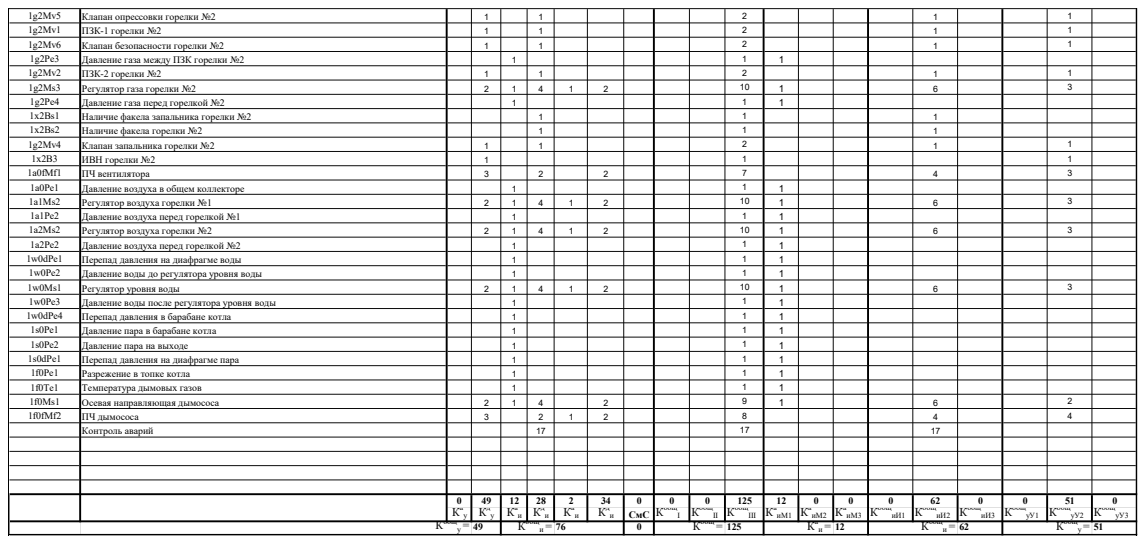
[picture p49: page 43]
Клапан опрессовки горелки №2; ПЗК-1 горелки №2; Клапан безопасности горелки №2; Давление газа между ПЗК горелки №2; ПЗК-2 горелки №2; Регулятор газа горелки №2; Давление газа перед горелкой №2; Наличие факела запальника горелки №2; Наличие факела горелки №2; Клапан запальника горелки №2; ИВН горелки №2; 1a0fMf1; ПЧ вентилятора; Давление воздуха в общем коллекторе; Регулятор воздуха горелки №1; Давление воздуха перед горелкой №1; Регулятор воздуха горелки №2; Давление воздуха перед горелкой №2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

0 а | 49 д | 12 а | 28 д | 2 а | 34 д | 0 | 0 общ | 0 общ | 125 общ | 12 а | 0 а | 0 а | 0 общ | 62 общ | 0 общ | 0 общ | 51 общ | 0 общ
К у | К у | К и | К и | К и | К и | СмС | К I К | II | К III | К иМ1 | К иМ2 | К иМ3 | К иИ1 | К иИ2 | К иИ3 | К уУ1 | К уУ2 | К уУ3
у = 49 К | | | К и = 76 | | | | 0 | общ = К | | 125 | К и = | | 12 | К и = | | 62 | К у = | | 51 общ

По результатам расчета количества каналов имеем | Кобщ = | 125
| К1общ = | 0
| К2общ = | 0
| К3общ = | 125
Таким образом:
С=(1+0,313хК2общ/Кобщ)*(1+0,566*К3общ/Кобщ) = | | 1,566
На основании расчета величина получившегося коэффициента С удовлетворяет условию № | 3
Принимая это во внимание базовая норма сложной системы Нбсл будет расчитываться исходя из | | 3 | категории
технической сложности системы управления с применением к ней результирующего коэффициента С= | | 1,0000

Расчет коэфициентов
М = (1+0,14*Ка иМ2/Ка ) * (1+0,51*Ка иМ3/Ка ) = и и | (1+0,14*0/12)*(1+0,51*0/12) = | 1
И = (1+0,51*Кобщ иИ2/Кобщ ) * (1+1,03*Кобщ иИ3/Кобщ ) = и и | (1+0,51*62/62)*(1+1,03*0/62) = | 1,51
У = (1+0,61* Кобщ уУ2 / Кобщ у)*( 1+1,39* Кобщ уУ3 / Кобщ у) = м | (1+0,61 * 51/51) * (1+ 1,39*0/51) = | 1,61
и = 0,5+ Ка и / Кобщ Ф и * М * И = | 0,5 + 12/62 * 1 * 1,51 = | 0,7384
Фу = 1,0+(1,3* Ка у + 0,95* Кд у )/ Кобщ АСУ * У = | 1,0+(1,3*0 + 0,95*49)/125*1,61= | 1,5996
м x Фу) = (Фи | | 1,1811

сл

м

Для расчета сметных норм:
Количество сигналов системы управления | Кобщ = | 125
Категория сложности системы катег. т.с. = | | 3
Коэффициент к заработной плате | Козп = | 1,1811

Исчисление объемов работ.

сложности, определяется применением к соответствующей базовой норме для системы I категории технической сложности коэффициента сложности (С)
С=(1+0,313хК2общ/Кобщ)*(1+0,566*К3общ/Кобщ)
где:
III категории технической сложности
Кобщ = К1общ + К2общ + К3общ
В этом случае базовая норма для сложной системы расчитывается по формуле: Нбсл=Нб1 х С; при условии 1 < C < 1,313 (УСЛОВИЕ №1) Нбсл=Нб2 х С:1,313; при условии 1,313 < C < 1,566 (УСЛОВИЕ №2)

Таким образом по результатам расчета общий коэффициент для расчета базовой нормы сложной системы будет иметь вид:
Н б | = Нб | 3 | х | С | х | Ф и | х | Фу

или сл
Н б | = Нб | 3 | х | 1 | х | 0,7384 | х | 1,5996

или сл
Н б | = Нб | 3 | х | 1,1811
