nppesnteam/357-22-RHTU-DKVR-4.13/АГСВ/12. ШАВР/АГСВ.ШАВР.СО.pdf

Позиция | Наименование и техническая характеристика | Тип,марка,обозначение документа, опросного листа | код оборудования, изделия, материала | Завод-изготовитель | Едини. изме- рения | Коли- чество | Масса един кГ | Примечание
1 | 2 | 3 | | 5 | 6 | 7 | 8 | 9
| 1.Шкаф автоматического ввода резерва | ШУП-0-0-0х0-0.0.0.0-0.0.0-35706 | | НПП "ЭСН" 506-127 | шт | 1
A1 | Zelio Logic реле эконом 20вход/выход ~240В | SR2E201FU | | Schnеider Elektric | шт | 1
HL1..4 | Светосигнальный индикатор 230В (зеленый) | XB7EV03MP | | Schnеider Elektric | шт | 4
HL5 | Светильник светодиодный 450мм 4000K | ДПО-6Вт Т5i | | JazzWay | шт | 1
1KM1..2 | КОНТАКТОР TVS,3Р,300A,380В,AC3.220VAC50ГЦ | LC1E300M5 | | Schnеider Elektric | шт | 2
| МЕХАНИЧ БЛОКИР ДЛЯ КОНТАКТОРОВ TVS 300А-500A | LAEM7 | | Schnеider Elektric | шт | 1
KL1..2 | Реле контроля чередования фаз, пониж. Повыш. напряжения | RM22TR33 | | Schnеider Elektric | шт | 2
1K1 | Реле промежуточное + розетка 230V AC 1ПК (6А) | RSL1PVPU | | Schnеider Elektric | шт | 1
1..2SA | Кулачков.перекл.10А 6+"0"(0 - L1N - L2N - L3N - L1L2 - L2L3 - L3L1) | K10F027MCH | | Schnеider Elektric | шт | 2
SA1..2 | Переключатель 2 позиции 1НО+1НЗ | XB7ND25 | | Schnеider Elektric | шт | 2
HL2SB1..2 | Кнопка двойная 1НО,1НЗ с подсветкой AC 220V | XB5AW73731M5 | | Schnеider Elektric | шт | 2
1..2PV | Вольтметр аналоговый 0-500В AC (72х72) | 16005 | | Schnеider Elektric | шт | 2
| Расширители полюсов с шагом 52,5 мм, 3Р, ComPact NSX/Easypact CVS 400/630 (комплект 3шт.) | LV432490 | | Schnеider Elektric | шт | 4
1QF1..2 | АВТ.ВЫКЛ. EZC400 36кА/415В 320А 3П3Т | EZC400N3320N | | Schnеider Elektric | шт | 2
QF1..2 | Автоматический выключатель C120N C 125A 3P | A9N18369 | | Schnеider Elektric | шт | 2
2QF1..2,QF7 Автоматический выключатель 3П 6А хар-ка С | | EZ9F34306 | | Schnеider Elektric | шт | 3
SF3 | Автоматический выключатель 1П 10А хар-ка С | EZ9F34110 | | Schnеider Elektric | шт | 1
SF4..6, 2SF1..2 | Автоматический выключатель 1П 6А хар-ка С | EZ9F34106 | | Schnеider Elektric | шт | 5
| Изолятор силовой (высота 30 мм) | SM30-(М8) | | КЭАЗ | шт | 2
| Изолятор силовой (высота 35 мм) | SM35-(М8) | | КЭАЗ | шт | 2
| Изолятор силовой (высота 40 мм) | SM40-(М8) | | КЭАЗ | шт | 2
| Изолятор силовой (высота 51 мм) | SM51-(М8) | | КЭАЗ | шт | 2
| Нулевая шина на двух угловых изоляторах | ШНИ-6х9-14-У2-С | | ИЭК | шт | 2
| | | | | DIN-рейка 35ммх7,5мм | NS 35/75 | | | м | 5
| | | | | Безвинтовой стопор (ширина 6мм) | 0249-0116 | | Wago | шт | 2
| | | | XT1 | Клемма зажимная до 2,5 мм2 серая | MTU-2,5 | | Meyertec | шт | 1
| | | | XT1 | Клемма зажимная до 2,5 мм2 синяя | MTU-2,5BL | | Meyertec | шт | 4
| | | | XT1 | Маркировка клеммного ряда, ширина 5 мм (уп. 100 шт.) | MTU-2.5MC | | Meyertec | упак | 1
| | | | | Держатель маркировки кнопок и лампочек 30х50мм | ZВY6102 | | Schneider Electric | шт | 10
| | | | | Медная шина прямоугольного сечения ( ≥120 мм2) | 30х4мм | | | м | 5
| | | | | Провод изолированный с медными жилами | 150 мм2 | | | м | 10
| | | | | Наконечник медный 150мм2 под опрессовку | | | | шт | 16
| | | | | Провод монтажный многожильный сечением (ПУГВ) | ПВ-3 (1х0,75) | | | м | 120
| | | | Провод монтажный многожильный сечением (ПУГВ) | ПВ-3 (1х35) | | | м | 20
| | | | Наконечник-гильза 0,75 мм2 с изолированным фланцем | SQ0512-0011 | | ТДМ | шт | 100
| | | | Наконечник-гильза 35 мм2 с изолированным фланцем | SQ0512-0009 | | ТДМ | шт | 20
изм | к.уч. | лист | N докум | подпись | дата
| | | | | | Стадия | Лист | Листов
| | | | | | РД | 1 Автоматизация | 1
Разработ. | Чураков
Проверил | Шакиров | Спецификация оборудования и материалов | ООО НПП "ЭСН"

Н.контр.

Российский химико-технологический университет имени Д. И. Менделеева г. Москва, Миусская площадь, дом 9, стр.1

357-22-АГСВ.ШАВР.СО

Корепанов
формат А3

взамен инв

№ инв. № подл. подп. и дата

Согласовано

Позиция | Наименование и техническая характеристика | Тип,марка,обозначение документа, опросного листа | код оборудования, изделия, материала | Завод-изготовитель | Едини. изме- рения | Коли- чество | Масса един кГ | Примечание
1 | 2 | 3 | | 5 | 6 | 7 | 8 | 9
| Кабельный канал СD 80X80 | 3240200 | | Рhоеniх Сопtасt | м | 3,4
| Кабельный канал СD 60X60 | 3240193 | | Рhоеniх Сопtасt | м | 8,7
| Кабельный канал СD 25X60 WH | 3240618 | | Рhоеniх Сопtасt | м | 3,7
| Короб перфорированный RL75 15х30 cерый QUADRO | 00672RL | | DKC | м | 4
| Метизы (винты,гайки, шайбы, заклепки) | | | | кг | 0,4
F1 | Вентилятор с фильтром RV 100/105 м3/ч, 230 В, 205x205 мм, IP54 | R5RV13230 | | DKC | шт | 1
F2 | Вентиляционная решетка с фильтром RF 205x205 мм, IP54 | R5RF13 | | DKC | шт | 1
TS1 | Термостат с рег. диапаз. 0..+60°С | R5THV2 | | DKC | шт | 1
| Шкаф напольный CQE собранный с дверью и задней панелью ВхШхГ 1400x600x500 мм | R5CQE1465A | | DKC | шт | 1
XS1 | Розетка на DIN-рейку 230В/6А | PAp10-3-ОП | | IEK | шт | 1
изм | к.уч. | лист | N докум | подпись | дата | Лист

взамен инв.

№ дата и подп.

инв.

№ подл

357-22-АГСВ.ШАВР.СО | 2

формат А3
