nppesnteam/357-22-RHTU-DKVR-4.13/АГСВ/1-7. Общее/5.1 Схема внешних электрических проводок.pdf

Параметр

Место отбора
импульса или
установки
прибора

Позиция

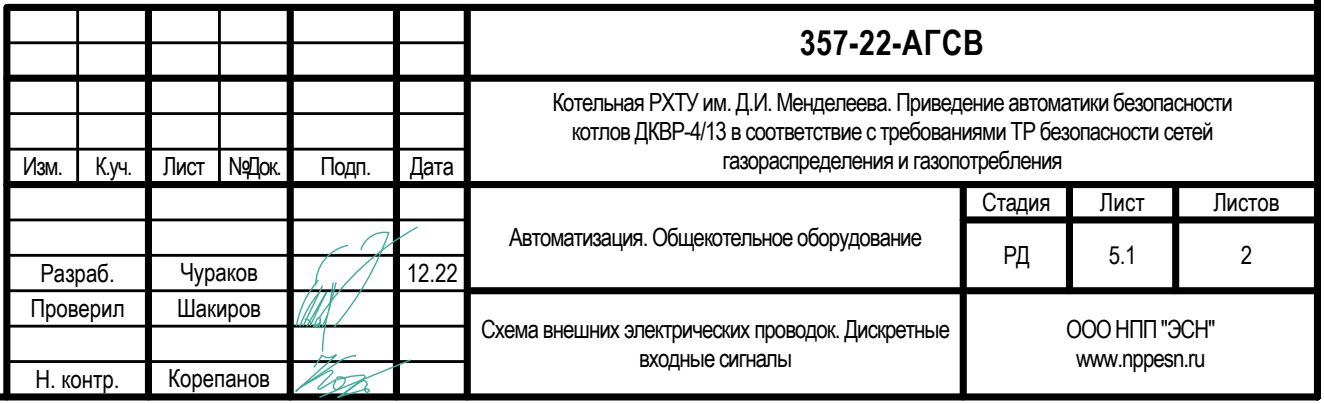
[picture p74: figure]
Стадия; Лист; Листов; Изм.; №Док.; Подп.; Дата; ОООНПП "ЭСН" www.nppesn.ru; Схема внешних электрических проводок. Дискретные входные сигналы; 5.1 Разраб.; Проверил; Н. контр.; Чураков Шакиров; Корепанов; Автоматизация. Общекотельное оборудование; 357-22-АГСВ; газораспределения и газопотребления

Котельная РХТУ им. Д.И. Менделеева. Приведение автоматики безопасности котлов ДКВР-4/13 в соответствие с требованиями ТР безопасности сетей

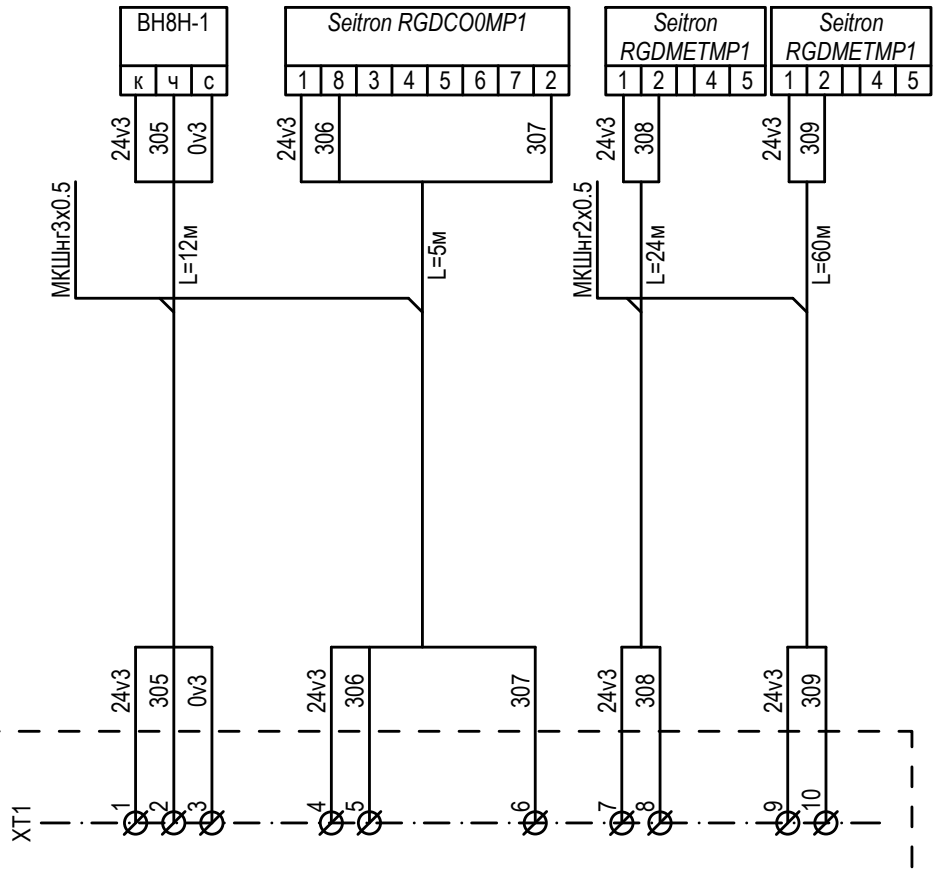
[picture p75: figure]
МКШнг; Seitron RGDCO0MP1; Seitron RGDMETMP1

## Шкаф общекотельной автоматики

Контроль

Отсечной клапан
открыт

0g0Mv1

Контроль | Контроль | Контроль | Контроль
Загазованность 1 СО | Загазованность 2 СО | Загазованность СН4 (Котельная) | Загазованность СН4 (ГРП)
| | 0x0CH1 | 0x0CH2

0x0CO1
