nppesnteam/357-22-RHTU-DKVR-4.13/АГСВ2/1-8. Общее/6 Структурная схема автоматизации котла _ Макет.pdf

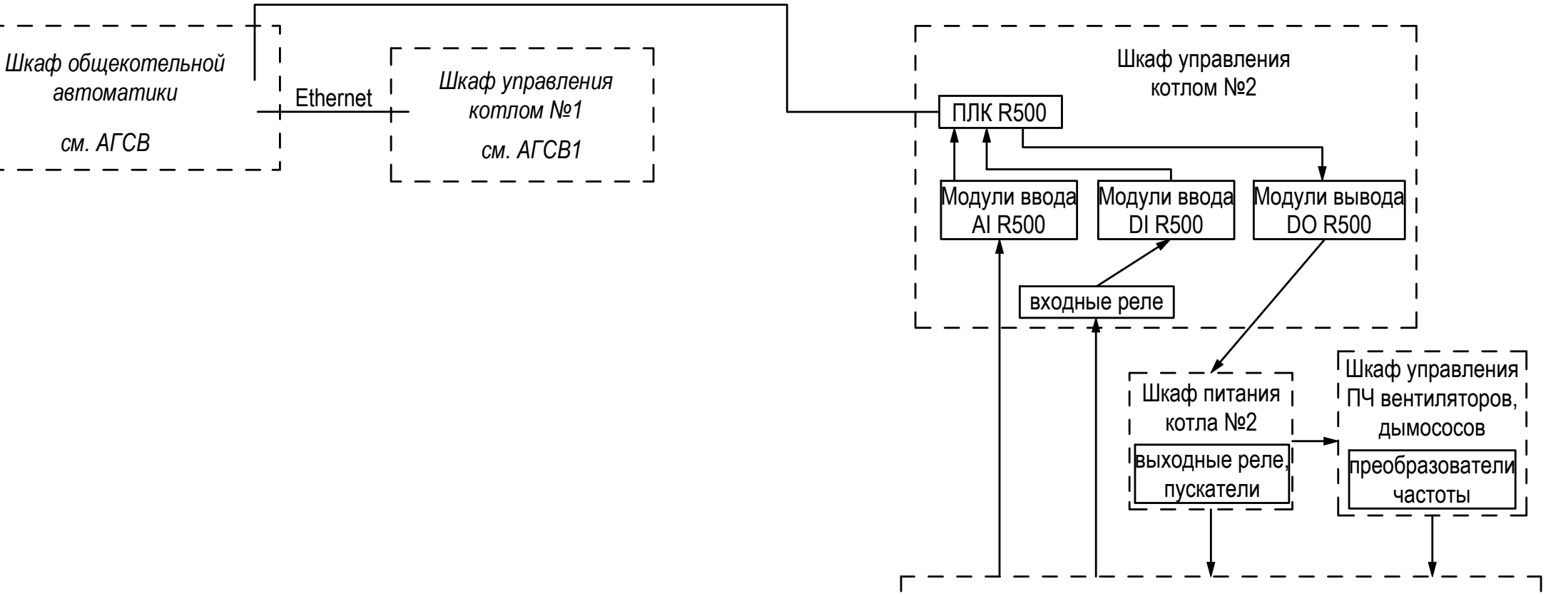
[picture p76: figure]
Шкаф управления котлом №2; Шкаф питания котла №2; ПЛК R500; Модули ввода AI R500; Модули ввода DI R500; Модули вывода DO R500; выходные реле, пускатели; входные реле; Шкаф управления ПЧ вентиляторов, дымососов преобразователи частоты; Шкаф управления котлом №1; Шкаф общекотельной автоматики; Ethernet; см. АГСВ; см. АГСВ1
Стадия; Лист; Листов; Изм.; №Док.; Подп.; Дата; Автоматизация. Котел №2 ДКВР-4/13; ОООНПП "ЭСН" www.nppesn.ru; газораспределения и газопотребления; 357-22-АГСВ2; Структурная схема автоматизации котла; 6 Разраб.; Проверил; Н. контр.; Чураков Шакиров; Корепанов

Котельная РХТУ им. Д.И. Менделеева. Приведение автоматики безопасности котлов ДКВР-4/13 в соответствие с требованиями ТР безопасности сетей

## Датчики, исполнительные механизмы котла №2

## Ethernet
