nppesnteam/357-22-RHTU-DKVR-4.13/ЭТН РХТУ.xlsx

Расценка | Наименование расценки | Нормочасы на ед | Количество | Нормочасы | Как считать | приемо-сдаточная документация
п01-02-005-02 | Трансформатор силовой сухой однофазный напряжением до 11 кВ | 5.4 | 4 | 21.6 | по количеству ИВН | протокол проверки ИВН
п01-03-001-01 | Выключатель однополюсный напряжением до 1 кВ с электромагнитным, тепловым или комбинированным расцепителем | 1.3 | 57 | 74.1 | по количеству однополюсных автоматов на каждый шкаф управления | протокол проверки автоматических выключателей первичным током
п01-03-002-04 | Выключатель трехполюсный напряжением до 1 кВ с электромагнитным, тепловым или комбинированным расцепителем, номинальный ток до 50 А я | 1.8 | 4 | 7.2 | по количеству трехполюсных автоматов до 50А на каждый шкаф управления | протокол проверки автоматических выключателей первичным током
п01-03-002-05 | Выключатель трехполюсный напряжением до 1 кВ с электромагнитным, тепловым или комбинированным расцепителем, номинальный ток до 200 А | 2.7 | 4 | 10.8 | по количеству трехполюсных автоматов сыше 50А до 200А на каждый шкаф управления | протокол проверки автоматических выключателей первичным током
п01-03-005-01 | Разъединитель трехполюсный напряжением до 20 кВ | 5.4 | 8 | 43.2 | по количеству трехполюсных рубильников | протокол
п01-03-005-04 | Разъединитель однополюсный напряжением от 110 до 220 кВ | 4.5 | 57 | 256.5 | по количеству однополюсных рубильников | протокол
п01-05-015-01 | Устройство АВР со схемой восстановления напряжения | 20.88 | 1 | 20.88 | по количеству шкафов АВР, ИБП | протокол проверки ИБП
п01-06-010-03 | Выпрямительный блок питания (токовый или напряжения) для питания цепей защиты, управления и сигнализации мощностью до 1 кВА со стабилизацией выходного напряжения | 18 | 15 | 270 | по количеству блоков питания на каждый шкаф | протокол проверки БП
п01-06-021-01 | Схема разводки трехпроводной системы с количеством панелей (шкафов, ячеек): до 2 | 2.88 | 0 | 0 | по количеству шкафов, где более одной ячейки (например БОЭ для РТЗО) или панели | протокол
п01-06-021-02 | Схема разводки трехпроводной системы с количеством панелей (шкафов, ячеек): за каждую последующую панель (шкаф, ячейку) свыше 2 | 0.72 | 0 | 0 | по количеству ячеек св шкафах, где ячеек(панелей) более 2. | протокол
п01-07-001-01 | Электродвигатель асинхронный с короткозамкнутым ротором, напряжением до 1 кВ | 2.43 | 16 | 38.88 | по количеству насососв, вентиляторов, дымососов, приводов задвижек, МЭО | протокол наладки эл. привода
п01-08-010-01 | Тиристорное устройство напряжением до 1 кВ однофазное | 17.01 | 12 | 204.12 | по количеству ПБР однофазных | протокол
п01-08-021-01 | Тиристорный преобразователь реверсивный напряжением до 1 кВ, ток: до 25А | 59.13 | 0 | 0 | по количеству ПБР трехфазных | протокол проверки пускателя реверсивного трехфазного АПР 01.2
п01-08-022-04 | Тиристорный преобразователь частоты напряжением: до 1 кВ с непосредственной связью, ток до 200 А | 208.98 | 4 | 835.92 | по количеству частотников | протокол наладки частотного преобразователя
п01-09-002-01 | Датчик бесконтактный с числом "вход-выход": до 3 | 6.48 | 72 | 466.56 | по количеству датчиков давления, температуры, уровня, приборы с дискретными выходами (АДИ, АДМ) | протокол индивидуальных испытаний
п01-09-003-02 | Бесконтактный дискретный элемент с числом "вход-выход": до 5 с числом органов настройки до 2 | 3.24 | 8 | 25.92 | по количеству датчиков факела | протокол индивидуальных испытаний
п01-09-003-05 | Бесконтактный дискретный элемент с числом "вход-выход": до 10 с числом органов настройки до 2 | 4.86 | 8 | 38.88 | по количеству вторичных приборов | протокол индивидуальных испытаний
п01-09-010-03 | Функциональная группа управления релейно-контакторная с общим числом внешних блокировочных связей до 10 | 13.5 | 37 | 499.5 | по количеству насосов, вентиляторов, дымососов, приводов задвижек, МЭО, клапанов | протокол наладки эл. привода + протокол индивидуальных испытаний
п01-09-013-02 | Контур систем автоматического регулирования параметров: 1 с числом органов настройки до 10(шт) | 81 | 10 | 810 | для деаратора - 3шт, любое подержание уровня - 1шт, для котла - 4 шт (+1 шт для резервного топлива) | Настроечные параметры и коэффициенты АБ
п01-10-001-01 | Сбор и реализация сигналов информации устройств защиты, автоматики, электрических и технологических режимов | 1.22 | 204 | 248.88 | по количеству дискретных и аналоговых датчиков, датчиков положения и конечников исполнительных механизмов | протокол индивидуальных испытаний
п01-11-010-01 | Измерение сопротивления растеканию тока заземлителя | 1 | 0 | 0 | по количеству контуров заземления | протокол замера сопротивления контура
п01-11-010-02 | Измерение сопротивления растеканию тока контура с диагональю до 20 м | 1.62 | 0 | 0 | по количеству контуров заземления | протокол замера сопротивления контура
п01-11-010-03 | Измерение сопротивления растеканию тока контура с диагональю до 200 м | 3.24 | 0 | 0 | по количеству контуров заземления | протокол замера сопротивления контура
п01-11-011-01 | Проверка наличия цепи между заземлителями и заземленными элементами(100 измерений) | 12.96 | 49 | 635.04 | по количеству заземляемых элементов - каждый датчик, исполнительный механизм, шкаф управления, не забыть разделить на 100 | протокол замера сопротивления металлосвязи
п01-11-013-01 | Замер полного сопротивления цепи "фаза-нуль" | 1 | 162 | 162 | по количеству автоматов (для 3-х полюсного автомата - 3+3 замера, для 1 полюсного - 1+1 замер) | протокол проверки цепи фаза-нуль
п01-11-024-01 | Фазировка электрической линии или трансформатора с сетью напряжением до 1 кВ | 0.82 | 17 | 13.94 | по количеству ИВН, ИБП, преобразователей частоты, шкафы питания, двигатели насосов, вентиляторов, дымососов | протокол фазировки
п01-11-028-01 | Измерение сопротивления изоляции (на линию) мегаомметром кабельных и других линий напряжением до 1 кВ, предназначенных для передачи электроэнергии к распределительным устройствам, щитам, шкафам, коммутационным аппаратам и электропотребителям(шт) | 0.32 | 163 | 52.16 | по количеству кабелей из кабельного журнала | протокол замера сопротивления изоляции
п01-11-028-02 | Измерение сопротивления изоляции мегаомметром обмоток машин и аппаратов | 0.08 | 37 | 2.96 | по количеству двигателей насосов, вентиляторов, дымососов, умножить на 4 | протокол наладки эл. привода
Всего, нормочасов |  |  |  | 4739.04
