nppesnteam/357-22-RHTU-DKVR-4.13/(list of files, cad)

Other CAD files:
АГСВ/АГСВ.dwg
АГСВ1/АГСВ1.dwg
АГСВ2/АГСВ2.dwg
