nppesnteam/357-22-RHTU-DKVR-4.13/АГСВ1/АГСВ1.ШП (без принципиальных схем).pdf

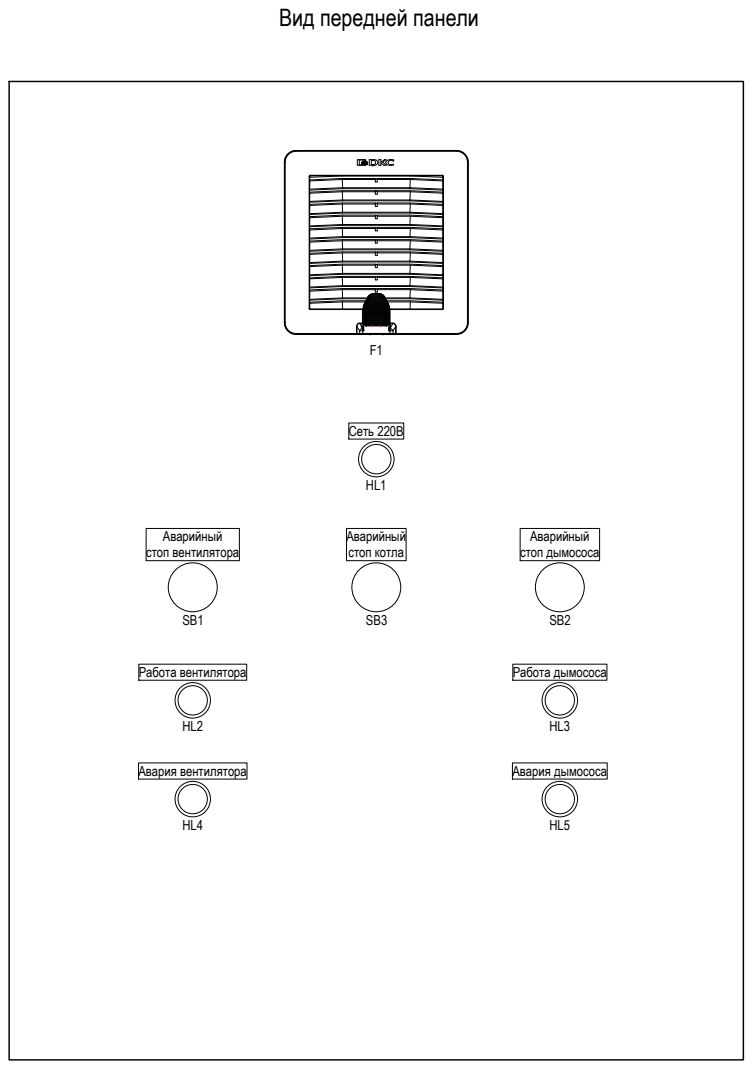
[picture p77: page 1]
Стадия; Лист; Листов; Изм.; №Док.; Подп.; Дата; Автоматизация; 357-22-АГСВ1.ШП; 5.1 Разраб.; Проверил; Н. контр.; Чураков Шакиров; Корепанов; Сеть 220В; Аварийный стоп вентилятора; Работа вентилятора; Авария вентилятора; Работа дымососа; Авария дымососа; Аварийный стоп дымососа; Аварийный стоп котла; Позиция; Описание; Кол-во; Решетка с вентилятором R5RV12230 (150х150)

Вид передней панели

Светосигнальный индикатор XB7EV03P (зеленый)
Кнопка управления XB7ES545P (красная, грибок)
Светосигнальный индикатор XB7EV04P (красный)

Российский химико-технологический университет имени Д. И. Менделеева

г. Москва, Миусская площадь, дом 9, стр.1

ОООНПП "ЭСН"
www.nppesn.ru

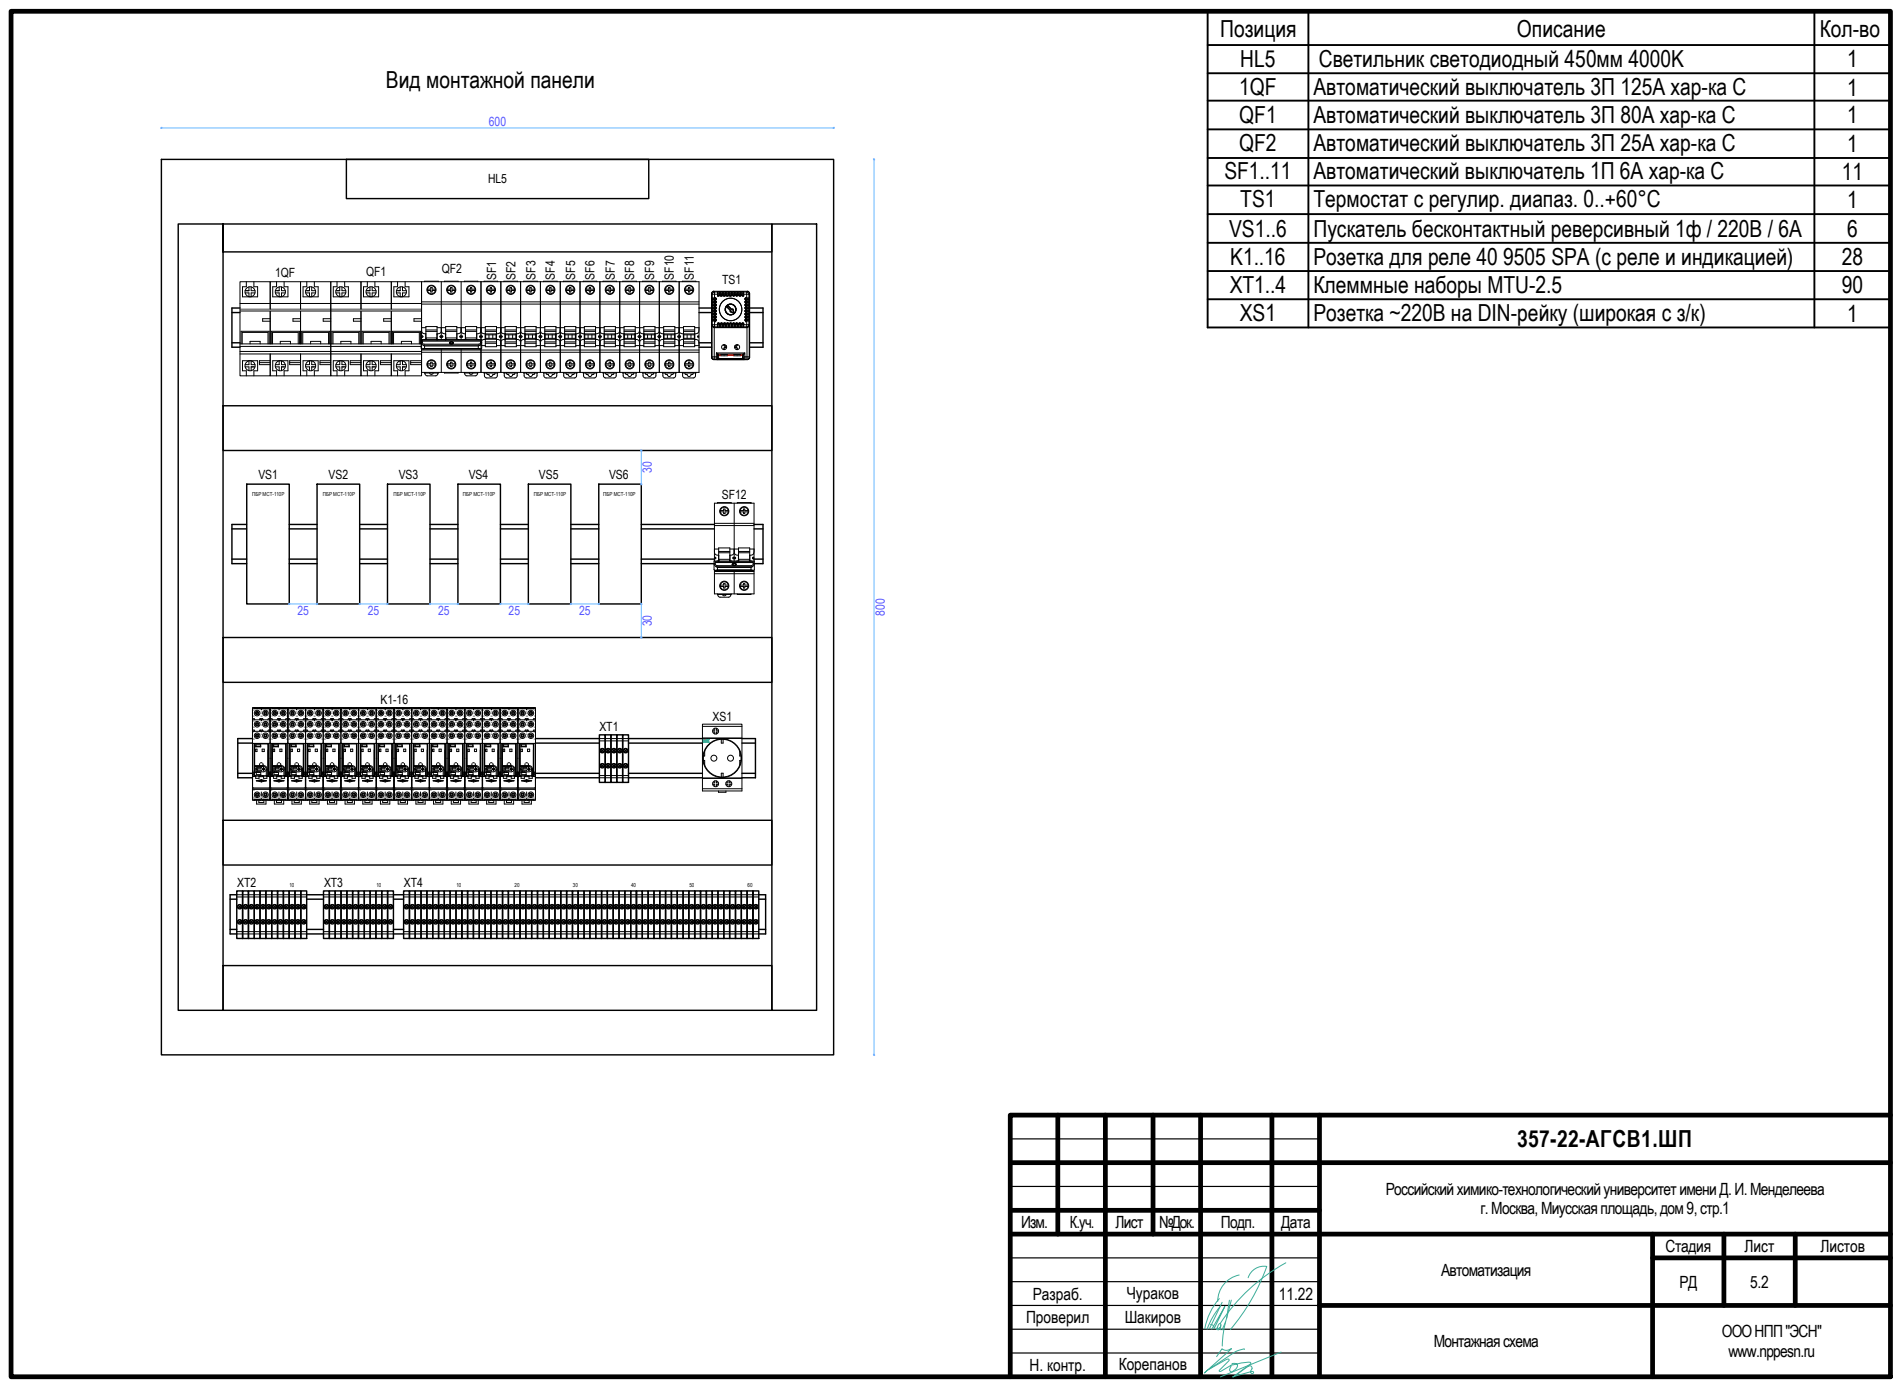
[picture p78: page 2]
Стадия; Лист; Листов; Изм.; №Док.; Подп.; Дата; Автоматизация; 357-22-АГСВ1.ШП; Монтажная схема; 5.2 Разраб.; Проверил; Н. контр.; Чураков Шакиров; Корепанов; ПБР МСТ-110Р; ПБР ПБР МСТ-110Р; МСТ-110Р; COIL; Позиция; Описание; Кол-во; Светильник светодиодный 450мм 4000K; SF1..11 Автоматический выключатель 1П 6А хар-ка C; Автоматический выключатель 3П 80А хар-ка C; Термостат с регулир. диапаз. 0..+60°С; Автоматический выключатель 3П 25А хар-ка C

Вид монтажной панели

Автоматический выключатель 3П 125А хар-ка C

Пускатель бесконтактный реверсивный 1ф / 220В / 6А
Розетка для реле 40 9505 SPA (с реле и индикацией)
Клеммные наборы MTU-2.5
Розетка ~220В на DIN-рейку (широкая с з/к)

Российский химико-технологический университет имени Д. И. Менделеева

г. Москва, Миусская площадь, дом 9, стр.1

ОООНПП "ЭСН"
www.nppesn.ru
