nppesnteam/357-22-RHTU-DKVR-4.13/АГСВ1/АГСВ1.ШУК (без принципиальных схем).pdf

Сеть 220В | Предупреждение | Авария | Работа

F1

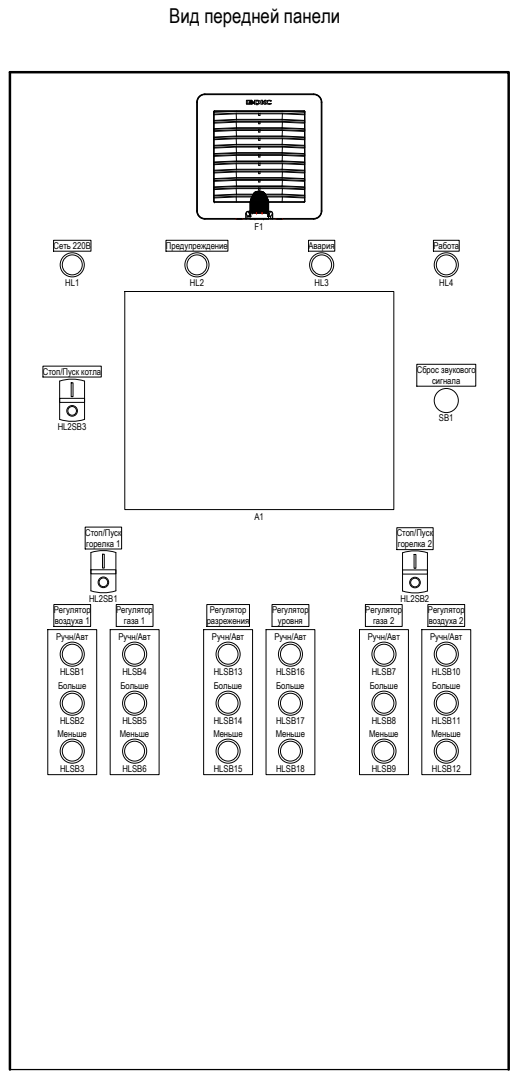
[picture p79: page 1]
Стадия; Лист; Листов; Изм.; №Док.; Подп.; Дата; Автоматизация; 357-22-АГСВ1.ШУК; 4.1 Разраб.; Проверил; Н. контр.; Чураков Шакиров; Корепанов; Стоп/Пуск котла; Сброс звукового; сигнала; Стоп/Пуск горелка 1; Стоп/Пуск горелка 2; Регулятор газа 1; Регулятор воздуха 1; Регулятор воздуха 2; Регулятор газа 2; Регулятор уровня Ручн/Авт; Больше; Меньше; Регулятор разрежения; HLSB16; HLSB17; HLSB18; Ручн/Авт; HLSB13; HLSB14; HLSB15; HLSB7; HLSB8; HLSB9; HLSB10; HLSB11; HLSB12; HLSB4; HLSB5; HLSB6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

Позиция
Светосигнальный индикатор XB7EV03P (зеленый)
Светосигнальный индикатор XB7EV05P (желтый)
Светосигнальный индикатор XB7EV04P (красный)
Кнопка управления XB7NA45 (красная)
Кнопка управления с подсветкой XB7NJ03B1 (зеленая)
Кнопка двойная с подсветкой XB5AW73731B5

Вид передней панели

Российский химико-технологический университет имени Д. И. Менделеева

г. Москва, Миусская площадь, дом 9, стр.1

ОООНПП "ЭСН"
www.nppesn.ru

600

HL5

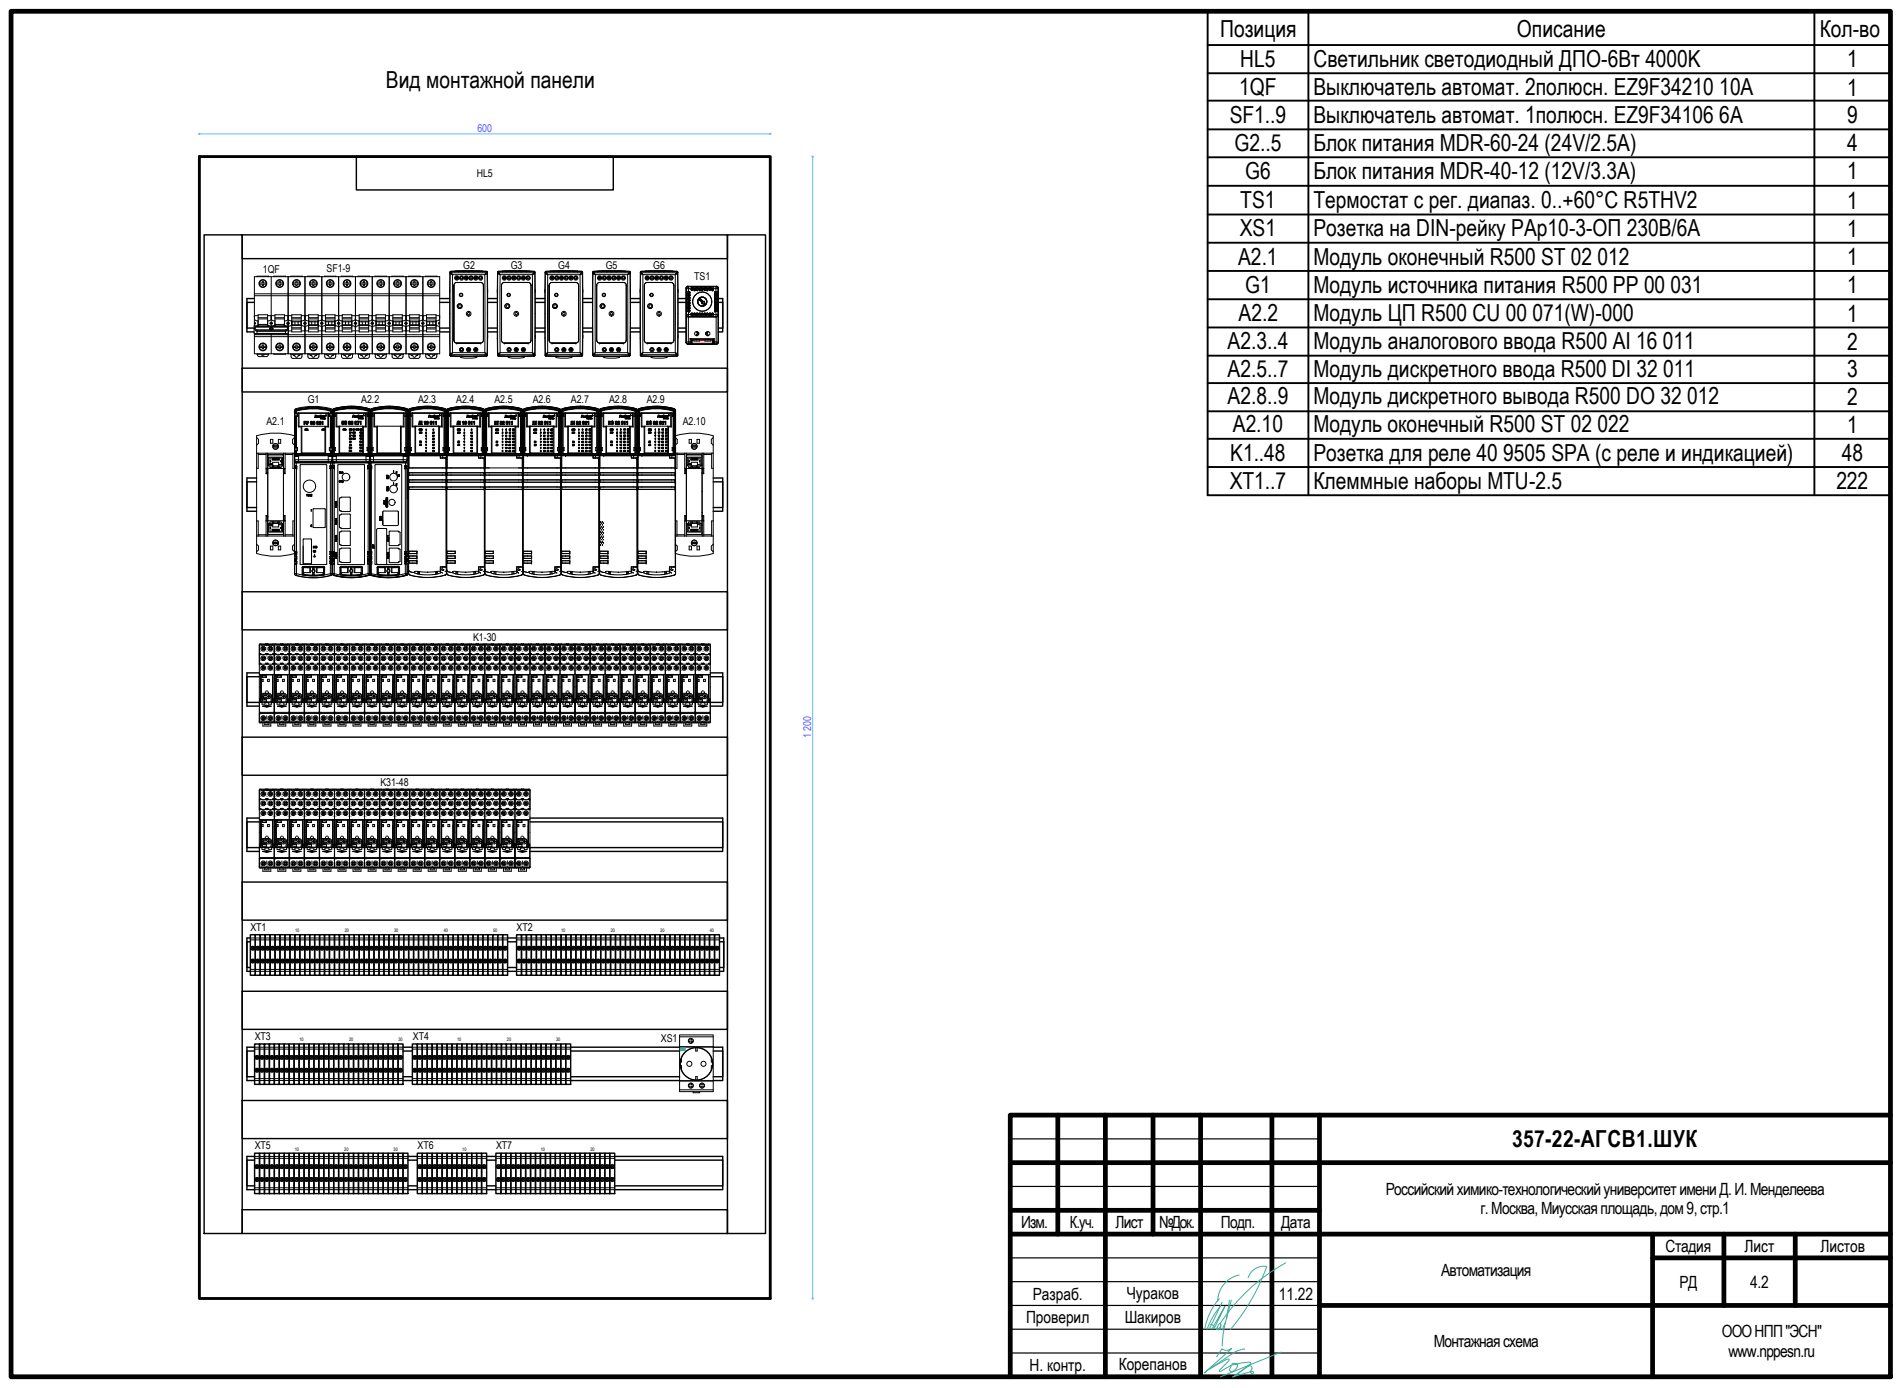
[picture p80: page 2]
Стадия; Лист; Листов; Изм.; №Док.; Подп.; Дата; Автоматизация; 357-22-АГСВ1.ШУК; Монтажная схема; 4.2 Разраб.; Проверил; Н. контр.; Чураков Шакиров; Корепанов; COIL; Позиция; Описание; Кол-во; Выключатель автомат. 2полюсн. EZ9F34210 10А; Светильник светодиодный ДПО-6Вт 4000K; A2.5..7 Модуль дискретного ввода R500 DI 32 011; G2..5 Блок питания MDR-60-24 (24V/2.5A); SF1..9 Выключатель автомат. 1полюсн. EZ9F34106 6A; Блок питания MDR-40-12 (12V/3.3A); A2.10 Модуль оконечный R500 ST 02 022

Вид монтажной панели

Розетка на DIN-рейку PAp10-3-ОП 230В/6А
Модуль оконечный R500 ST 02 012
Модуль источника питания R500 PP 00 031
Модуль ЦП R500 CU 00 071(W)-000
Модуль аналогового ввода R500 AI 16 011

Термостат с рег. диапаз. 0..+60°С R5THV2

Модуль дискретного вывода R500 DO 32 012

Розетка для реле 40 9505 SPA (с реле и индикацией)
Клеммные наборы MTU-2.5

Российский химико-технологический университет имени Д. И. Менделеева

г. Москва, Миусская площадь, дом 9, стр.1

ОООНПП "ЭСН"
www.nppesn.ru
