nppesnteam/357-22-RHTU-DKVR-4.13/АГСВ/1-7. Общее/10.1 ШУПЧд. Вид передней панели.pdf

## Вид передней панели

## Позиция

Стадия; Лист; Листов; Изм.; №Док.; Подп.; Дата; газораспределения и газопотребления; 357-22-АГСВ; 10.1 Разраб.; Проверил; Н. контр.; Чураков Шакиров; Корепанов; Наличие питания ПЧ №1; Аварийный стоп ПЧ №1; Работа ПЧ №1; Авария ПЧ №1; Наличие питания ПЧ №2; Аварийный стоп ПЧ №2; Работа ПЧ №2; Авария ПЧ №2; Описание; Кол-во; Вентилятор с фильтром RV 100/105 м3/ч, 230 В, 205x205 мм, IP54; Вентиляционная решетка с фильтром RF 205x205 мм, IP54

Светосигнальный индикатор цвет зеленый (230в)
Кнопка "Грибок" АЕ-22 (красная)
Светосигнальный индикатор цвет красный (230в)

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

Автоматизация. Общекотельное оборудование

ОООНПП "ЭСН"
www.nppesn.ru

ШУПЧд. Вид передней панели
