nppesnteam/357-22-RHTU-DKVR-4.13/АГСВ/1-7. Общее/10.2 ШУПЧд. Вид монтажной панели.pdf

Стадия; Лист; Листов; Изм.; №Док.; Подп.; Дата; газораспределения и газопотребления; 357-22-АГСВ; 10.2 Разраб.; Проверил; Н. контр.; Чураков Шакиров; Корепанов; Частотный преобразователь Веспер Веспер Е4-P8402-050H; COIL; Описание; Кол-во; Розетка ~220В на DIN-рейку (широкая с з/к); Светильник светодиодный ДПО-6Вт 4000K; Автоматический выключатель 3П 80А хар-ка С; Частотный преобразователь 37кВт; Uпит.~380B; Iн.вых 75А; Контактор 6А, кат. 220В, 3NO +(1NС) LC1 E0601 M5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

Позиция
Термостат с регулируемым диапазоном температуры
0…+60°C, NO-контакт

Вид монтажной панели

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

Клемма проходная зажимная cиняя MTU-2,5BL

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

Автоматизация. Общекотельное оборудование

ОООНПП "ЭСН"
www.nppesn.ru

ШУПЧд. Вид монтажной панели
