nppesnteam/357-22-RHTU-DKVR-4.13/АГСВ/1-7. Общее/11.2 ШАВР. Вид монтажной панели.pdf

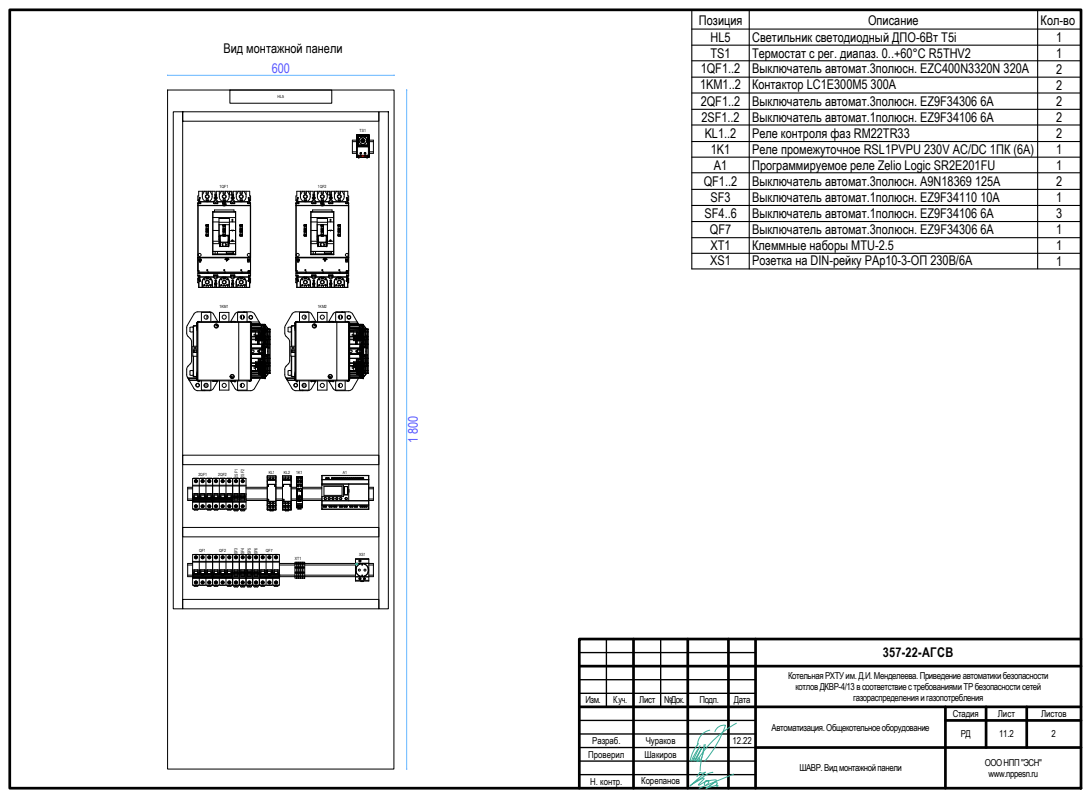
[picture p81: page 1]
Стадия; Лист; Листов; Изм.; №Док.; Подп.; Дата; газораспределения и газопотребления; 357-22-АГСВ; 11.2 Разраб.; Проверил; Н. контр.; Чураков Шакиров; Корепанов; COIL; Позиция; Описание; Кол-во; Термостат с рег. диапаз. 0..+60°С R5THV2; Выключатель автомат.3полюсн. EZ9F34306 6А Выключатель автомат.1полюсн. EZ9F34106 6А; Выключатель автомат.1полюсн. EZ9F34110 10А Выключатель автомат.1полюсн. EZ9F34106 6А Выключатель автомат.3полюсн. EZ9F34306 6А; Светильник светодиодный ДПО-6Вт Т5i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

Вид монтажной панели

Реле промежуточное RSL1PVPU 230V АC/DC 1ПК (6А)

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

Автоматизация. Общекотельное оборудование

ОООНПП "ЭСН"
www.nppesn.ru

ШАВР. Вид монтажной панели
