nppesnteam/357-22-RHTU-DKVR-4.13/АГСВ/10. ШУПЧв/АГСВ.ШУПЧв (без принципиальных схем).pdf

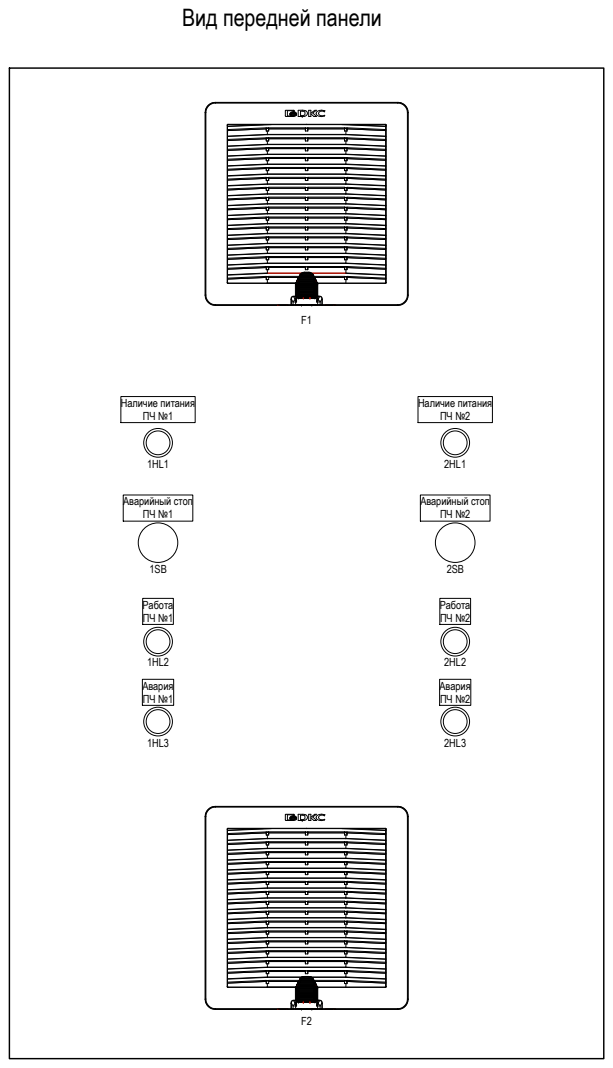
[picture p82: page 1]
Стадия; Лист; Листов; Изм.; №Док.; Подп.; Дата; 357-22-АГСВ.ШУПЧв; 10.1 Разраб.; Проверил; Н. контр.; Чураков Шакиров; Корепанов; Наличие питания ПЧ №1; Аварийный стоп ПЧ №1; Работа ПЧ №1; Авария ПЧ №1; Наличие питания ПЧ №2; Аварийный стоп ПЧ №2; Работа ПЧ №2; Авария ПЧ №2; Позиция; Описание; Кол-во; Вентилятор с фильтром RV 100/105 м3/ч, 230 В, 205x205 мм, IP54; Вентиляционная решетка с фильтром RF 205x205 мм, IP54

Вид передней панели

Светосигнальный индикатор цвет зеленый (230в)
Кнопка "Грибок" АЕ-22 (красная)
Светосигнальный индикатор цвет красный (230в)

Российский химико-технологический университет имени Д. И. Менделеева

г. Москва, Миусская площадь, дом 9, стр.1

Автоматизация. Общекотельное оборудование

ОООНПП "ЭСН"
www.nppesn.ru

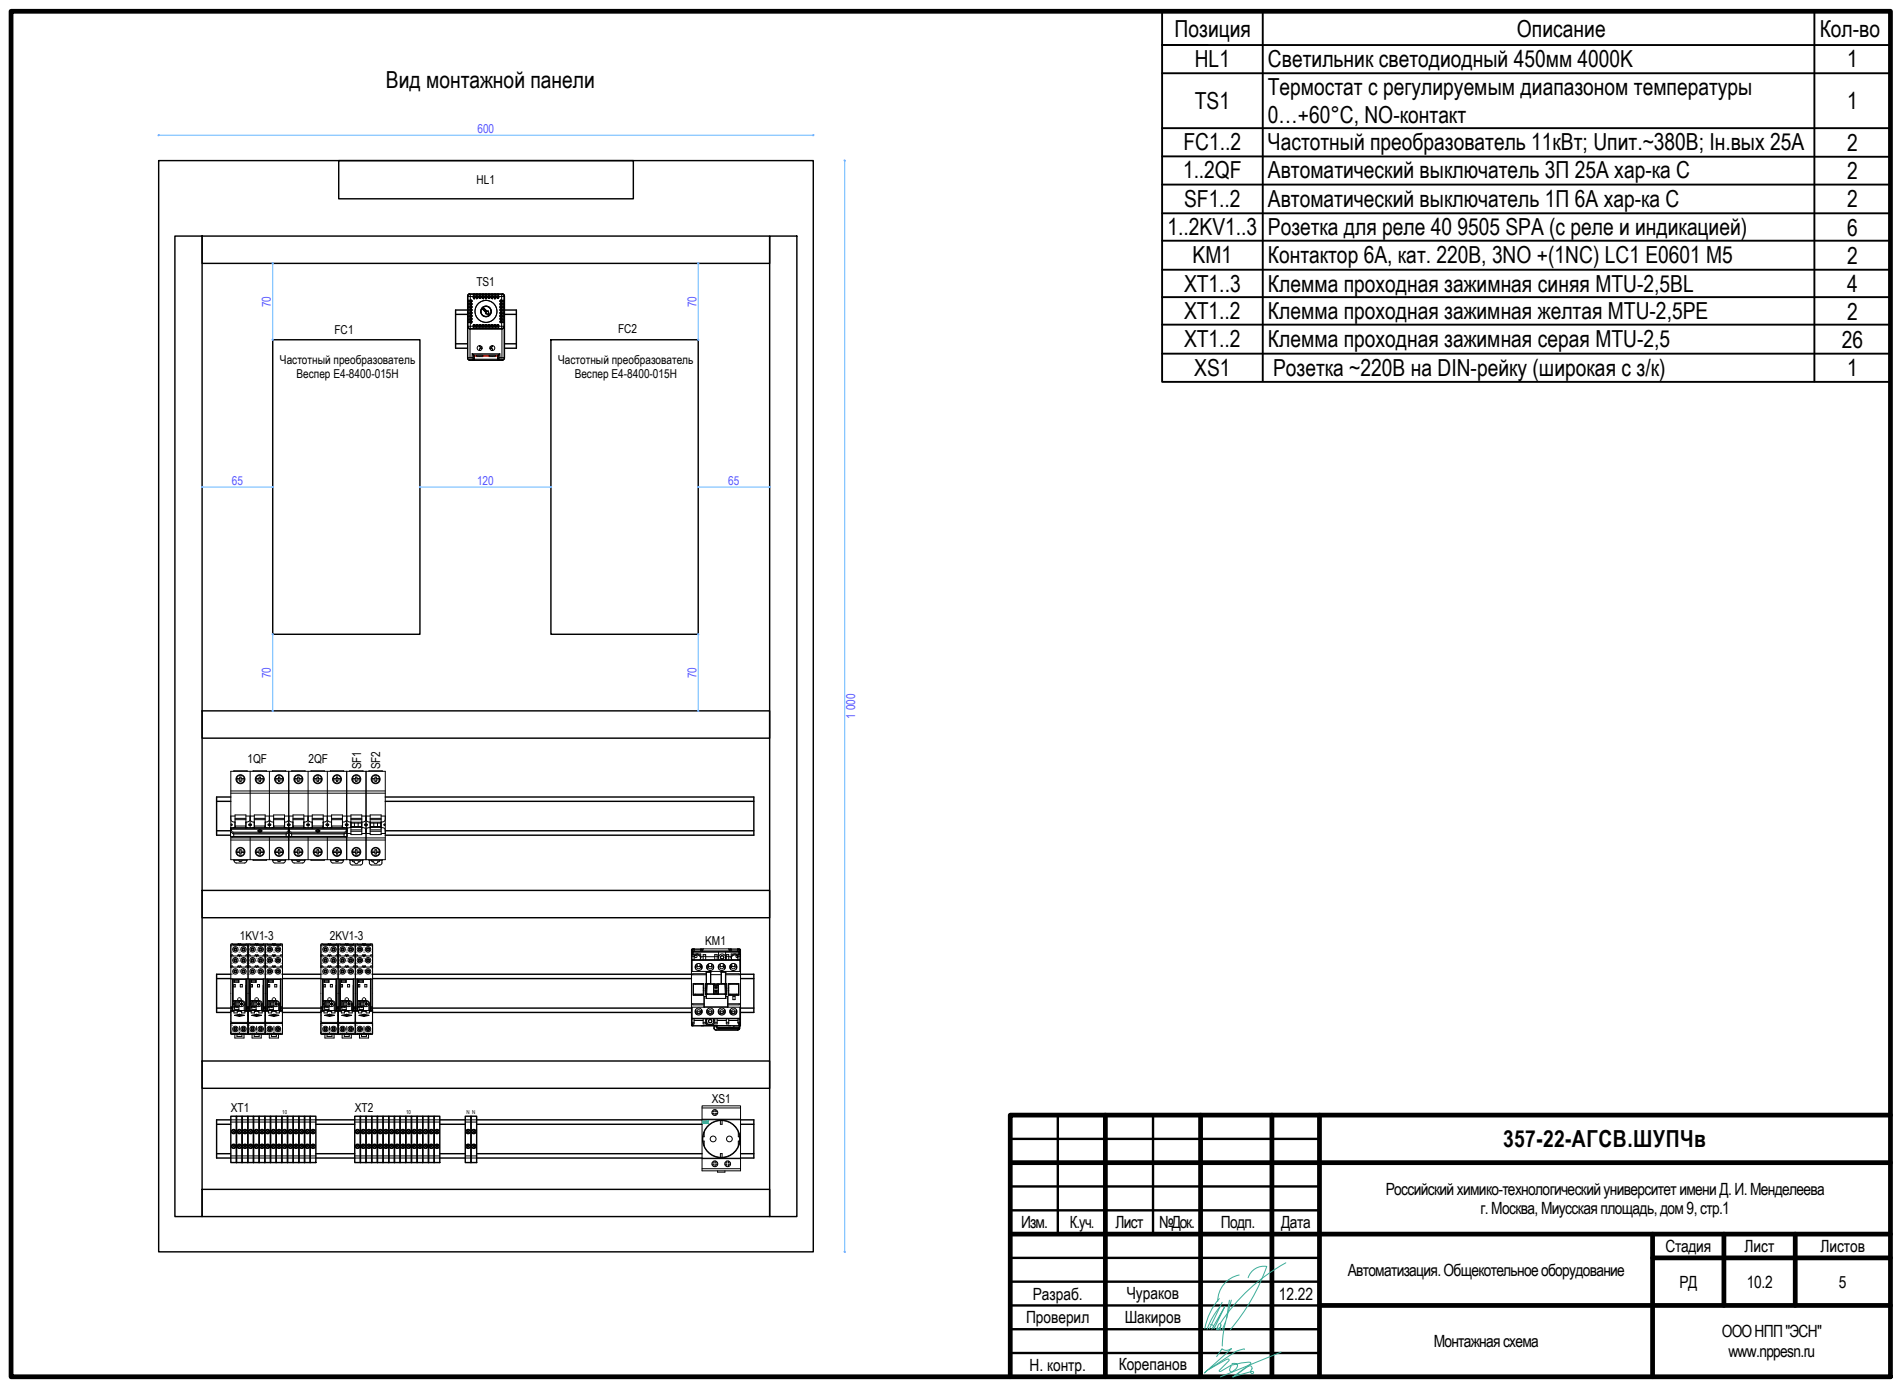
[picture p83: page 2]
Стадия; Лист; Листов; Изм.; №Док.; Подп.; Дата; 357-22-АГСВ.ШУПЧв; Монтажная схема; 10.2 Разраб.; Проверил; Н. контр.; Чураков Шакиров; Корепанов; Частотный преобразователь Веспер E4-8400-015Н; COIL; Описание; Кол-во; Светильник светодиодный 450мм 4000K; Автоматический выключатель 3П 25А хар-ка C; Частотный преобразователь 11кВт; Uпит.~380B; Iн.вых 25А; Контактор 6А, кат. 220В, 3NO +(1NС) LC1 E0601 M5; Клемма проходная зажимная желтая MTU-2,5PE; Клемма проходная зажимная cерая MTU-2,5

Позиция
Термостат с регулируемым диапазоном температуры
0…+60°C, NO-контакт

Вид монтажной панели

Автоматический выключатель 1П 6А хар-ка C
Розетка для реле 40 9505 SPA (с реле и индикацией)

Клемма проходная зажимная cиняя MTU-2,5BL

Розетка ~220В на DIN-рейку (широкая с з/к)

Российский химико-технологический университет имени Д. И. Менделеева

г. Москва, Миусская площадь, дом 9, стр.1

Автоматизация. Общекотельное оборудование

ОООНПП "ЭСН"
www.nppesn.ru
