nppesnteam/357-22-RHTU-DKVR-4.13/АГСВ/12. ШАВР/12.3 Схема питания.pdf

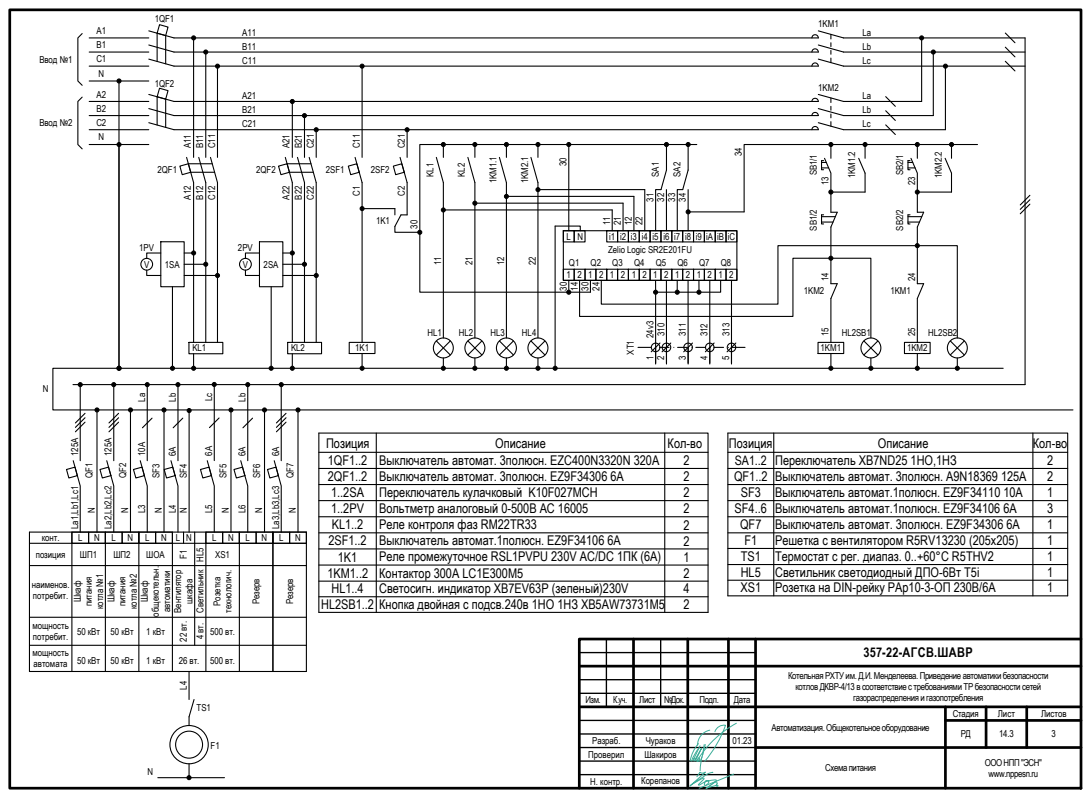
[picture p86: page 1]

1QF1..2 | Выключатель автомат. 3полюсн. EZC400N3320N 320А | 2
2QF1..2 | Выключатель автомат. 3полюсн. EZ9F34306 6А | 2
1..2SA | Переключатель кулачковый K10F027MCH | 2
1..2PV | Вольтметр аналоговый 0-500В AC 16005 | 2
KL1..2 | Реле контроля фаз RM22TR33 | 2

позиция | ШП1 | ШП2 | ШОА | XS1

1K1 | Реле промежуточное RSL1PVPU 230V АC/DC 1ПК (6А) | 1

мощность потребит. | 50 кВт | 50 кВт | 1 кВт | | 500 вт.

мощность автомата | 50 кВт | 50 кВт | 1 кВт | 26 вт. | 500 вт.

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
