nppesnteam/357-22-RHTU-DKVR-4.13/АГСВ/9. ШОА/АГСВ.ШОА.pdf

## Вид передней панели

## Позиция

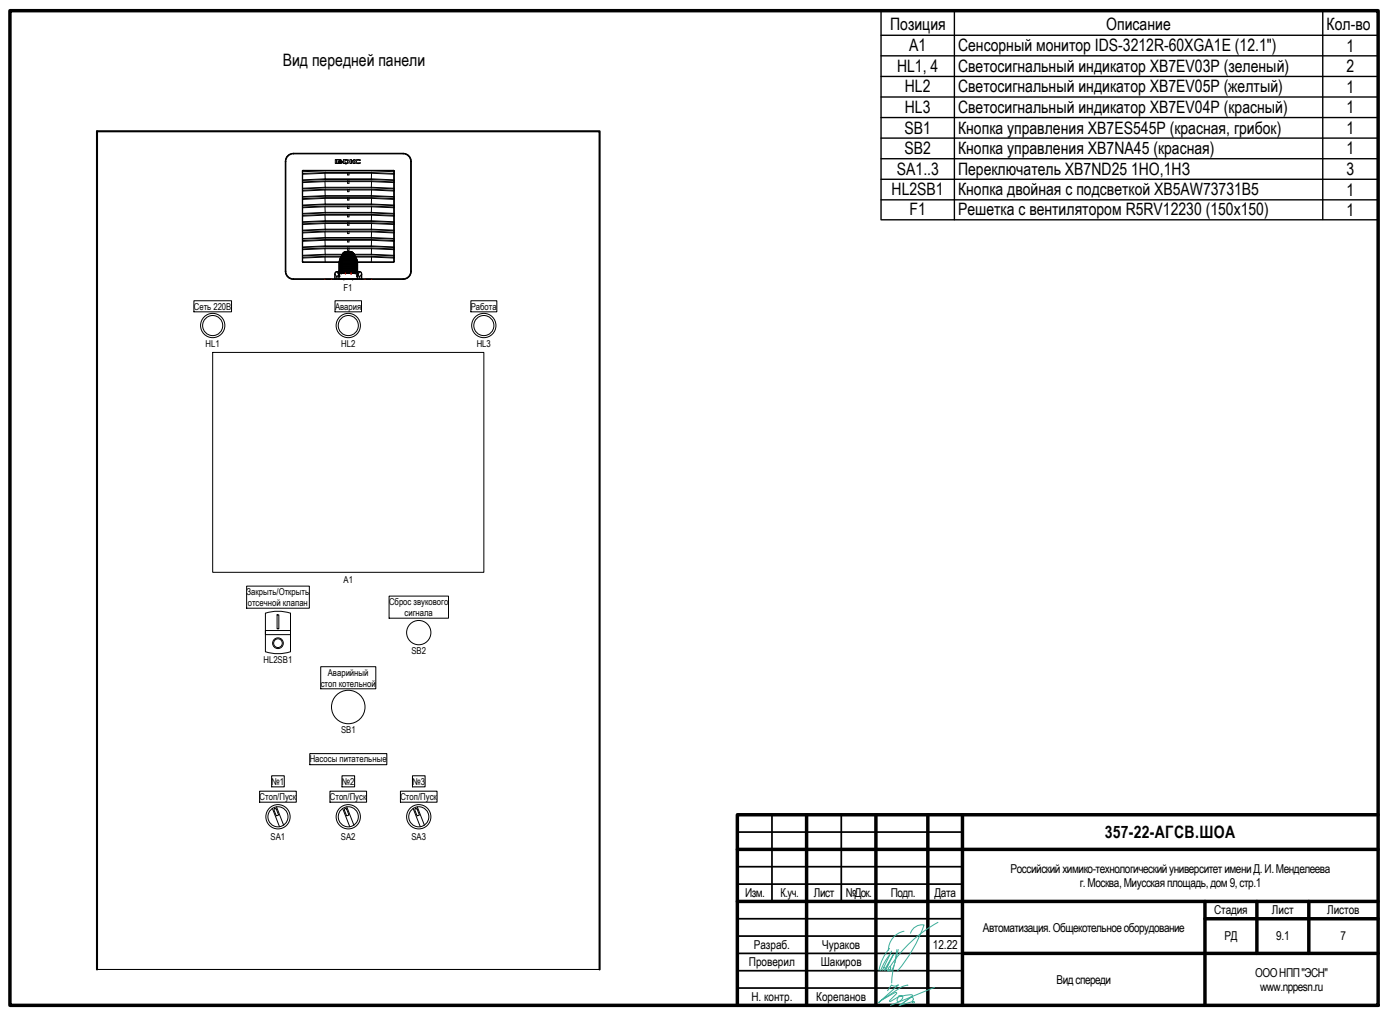
[picture p87: page 1]
Стадия; Лист; Листов; Изм.; №Док.; Подп.; Дата; 357-22-АГСВ.ШОА; Вид спереди; 9.1 Разраб.; Проверил; Н. контр.; Чураков Шакиров; Корепанов; Насосы питательные; Сеть 220В; Авария; Работа; Аварийный стоп котельной; Закрыть/Открыть; отсечной клапан; Сброс звукового; сигнала; Стоп/Пуск; Описание; Кол-во; Сенсорный монитор IDS-3212R-60XGA1E (12.1"); Решетка с вентилятором R5RV12230 (150х150)

Светосигнальный индикатор XB7EV03P (зеленый)
Светосигнальный индикатор XB7EV05P (желтый)
Светосигнальный индикатор XB7EV04P (красный)
Кнопка управления XB7ES545P (красная, грибок)
Кнопка управления XB7NA45 (красная)
Переключатель XB7ND25 1НО,1НЗ
Кнопка двойная с подсветкой XB5AW73731B5

Российский химико-технологический университет имени Д. И. Менделеева

г. Москва, Миусская площадь, дом 9, стр.1

Автоматизация. Общекотельное оборудование

ОООНПП "ЭСН"
www.nppesn.ru

## Позиция

1QF

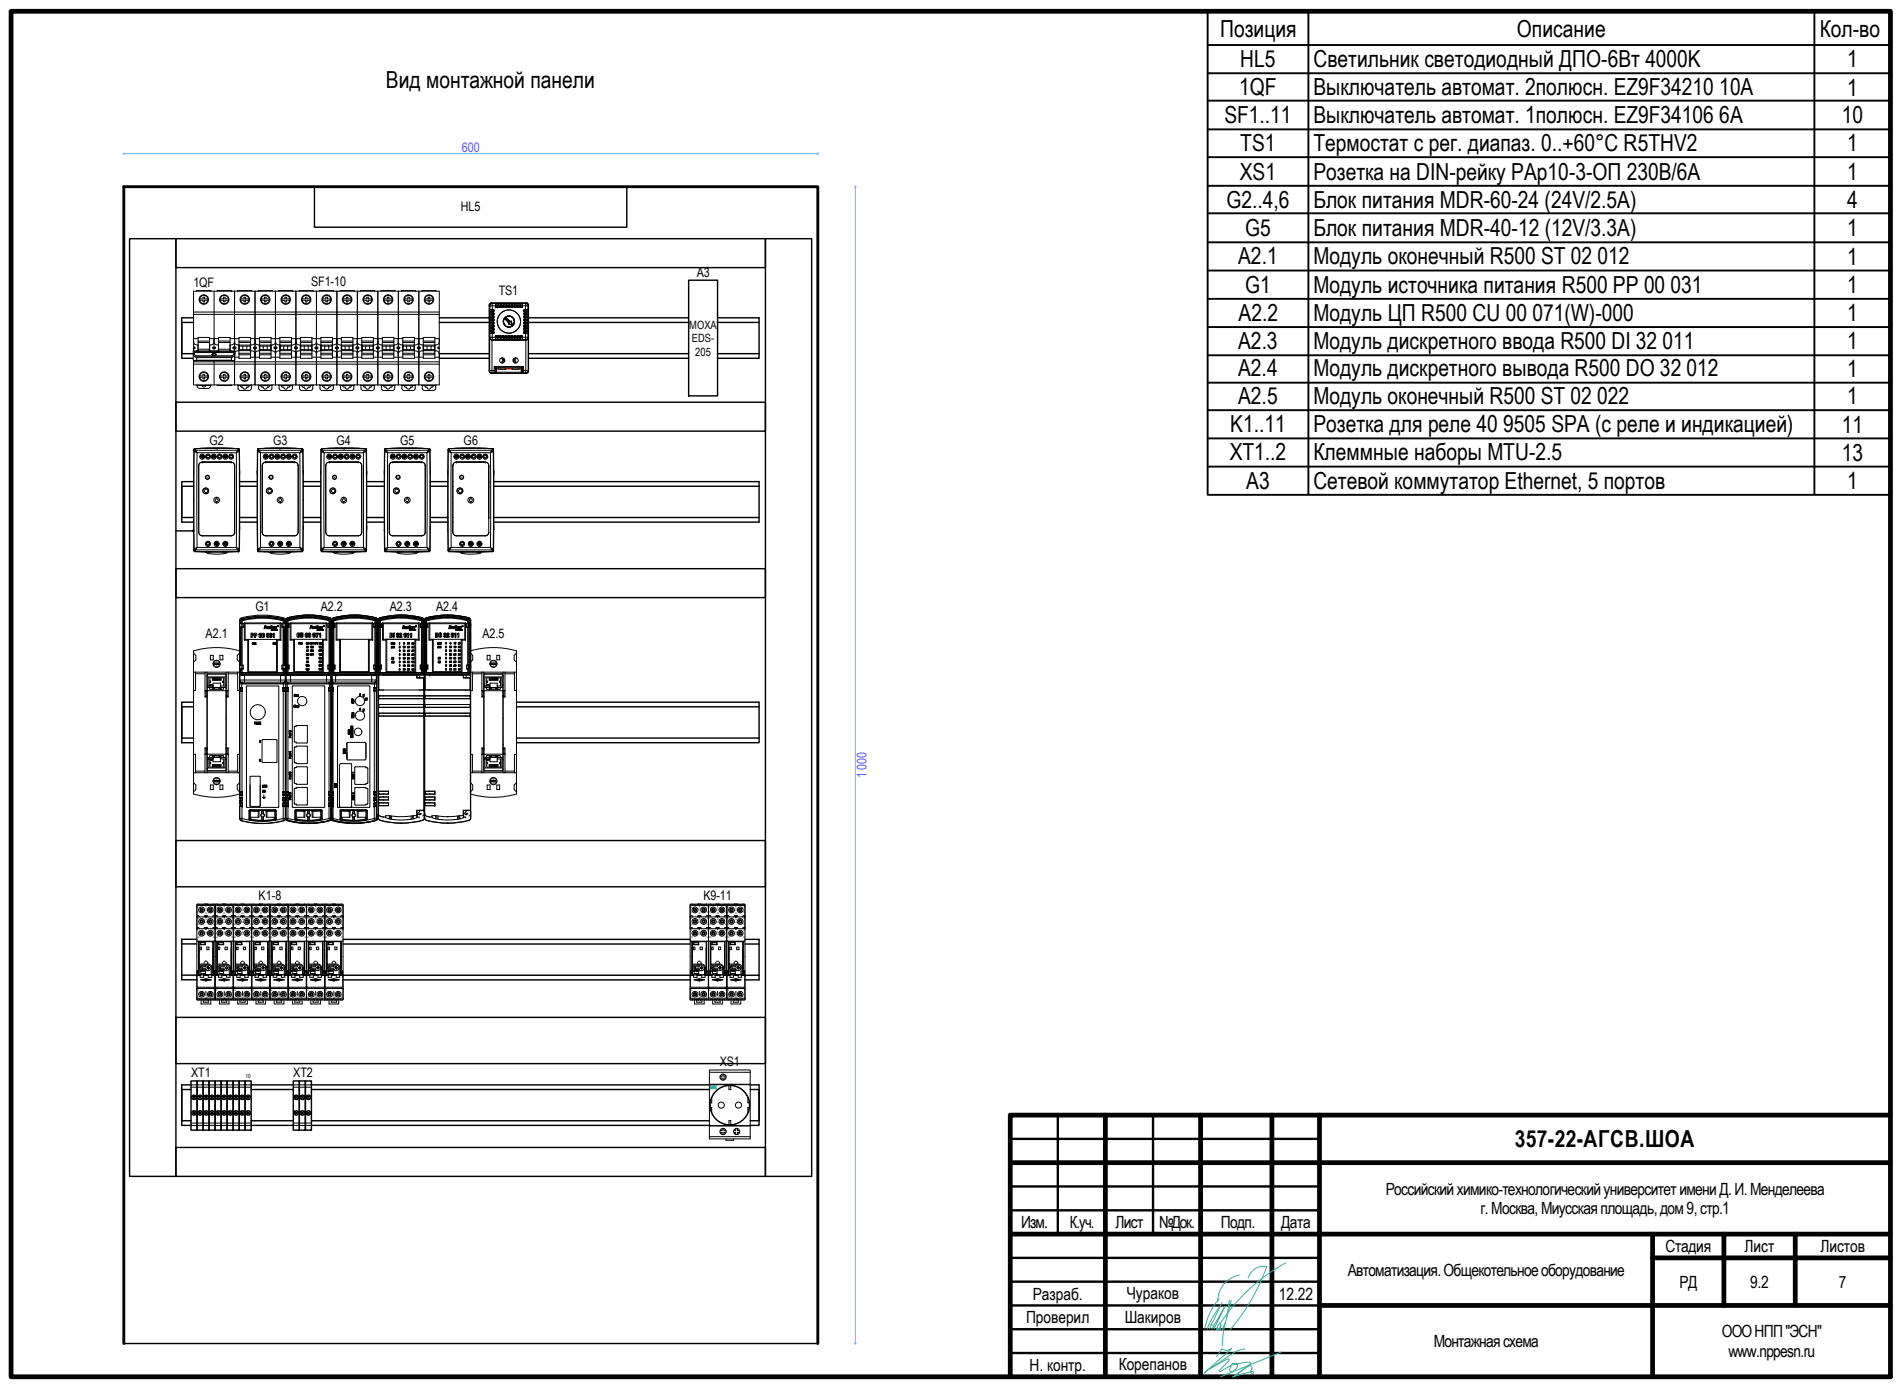
[picture p88: page 2]
Стадия; Лист; Листов; Изм.; №Док.; Подп.; Дата; 357-22-АГСВ.ШОА; Монтажная схема; 9.2 Разраб.; COIL; MOXA EDS- 205; Описание; Кол-во; Выключатель автомат. 2полюсн. EZ9F34210 10А; Светильник светодиодный ДПО-6Вт 4000K; Модуль дискретного вывода R500 DO 32 012; Термостат с рег. диапаз. 0..+60°С R5THV2; SF1..11 Выключатель автомат. 1полюсн. EZ9F34106 6A; Блок питания MDR-40-12 (12V/3.3A); Сетевой коммутатор Ethernet, 5 портов

Вид монтажной панели

Розетка на DIN-рейку PAp10-3-ОП 230В/6А
Блок питания MDR-60-24 (24V/2.5A)
Модуль оконечный R500 ST 02 012
Модуль источника питания R500 PP 00 031
Модуль ЦП R500 CU 00 071(W)-000
Модуль дискретного ввода R500 DI 32 011
Модуль оконечный R500 ST 02 022

Розетка для реле 40 9505 SPA (с реле и индикацией)
Клеммные наборы MTU-2.5

Российский химико-технологический университет имени Д. И. Менделеева

г. Москва, Миусская площадь, дом 9, стр.1

Автоматизация. Общекотельное оборудование

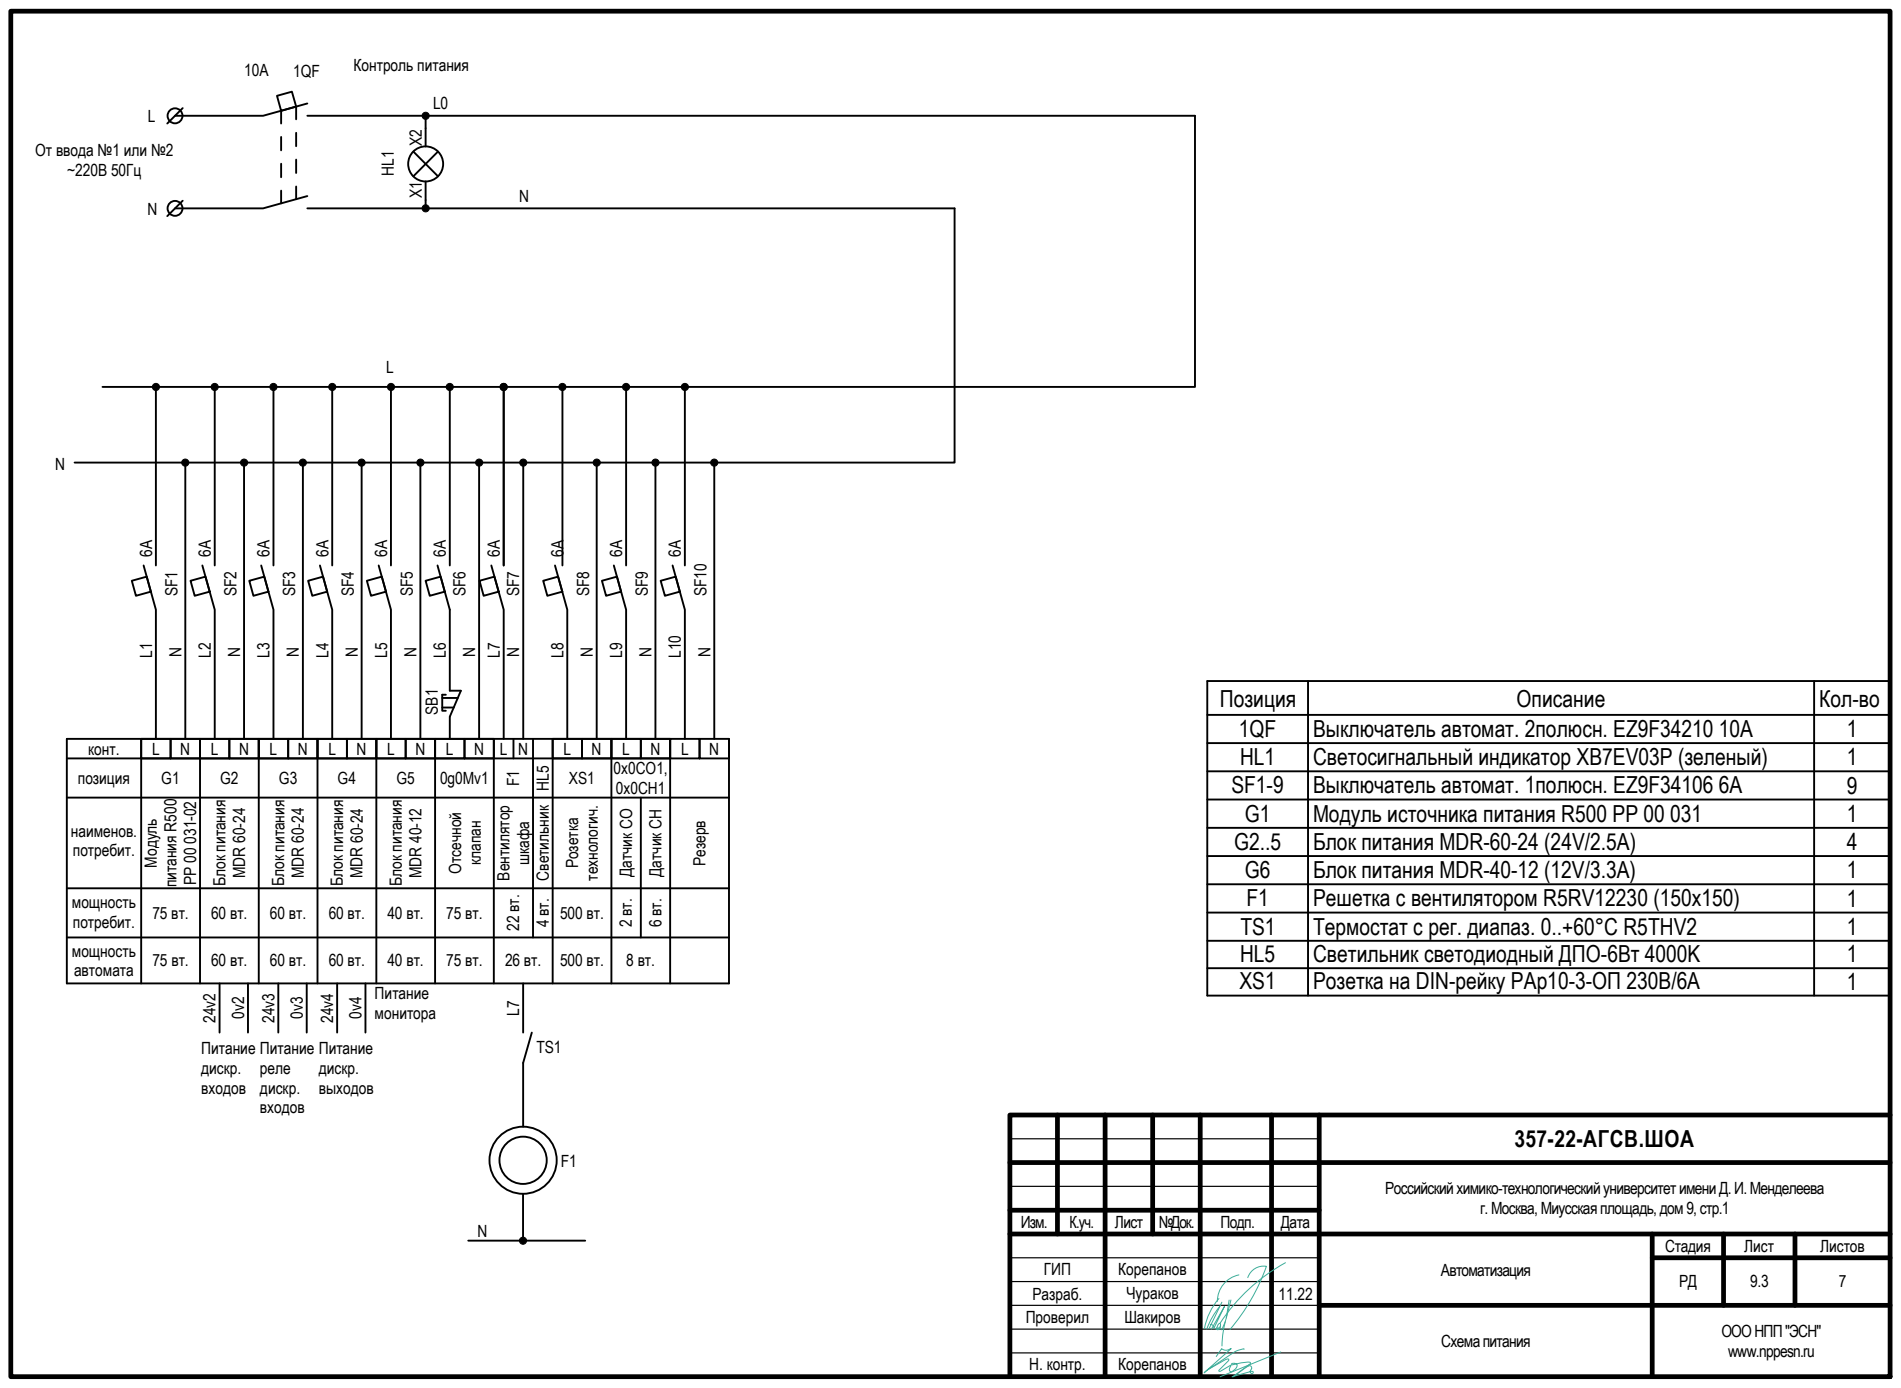
[picture p89: page 3]
Стадия; Лист; Листов; Изм.; №Док.; Подп.; Дата; Автоматизация; 357-22-АГСВ.ШОА; Схема питания; ГИП Разраб.; Корепанов; Контроль питания; Питание дискр. входов; Питание реле дискр. входов; Питание дискр. выходов; Описание; Кол-во; Термостат с рег. диапаз. 0..+60°С R5THV2; Решетка с вентилятором R5RV12230 (150х150); Выключатель автомат. 2полюсн. EZ9F34210 10А; Светильник светодиодный ДПО-6Вт 4000K; Розетка на DIN-рейку PAp10-3-ОП 230В/6А; Питание монитора

От ввода №1 или №2

Позиция
Светосигнальный индикатор XB7EV03P (зеленый)
Выключатель автомат. 1полюсн. EZ9F34106 6A
Модуль источника питания R500 PP 00 031

конт. | L N | L N | L N | L N | L N | L N | L | N | | L N | L N
позиция | G1 | G2 | G3 | G4 | G5 | 0g0Mv1 | | | | XS1 | 0x0CO1, 0x0CH1

наименов. потребит.

Блок питания MDR-60-24 (24V/2.5A)

Блок питания MDR-40-12 (12V/3.3A)

мощность потребит. | 75 вт. | 60 вт. | 60 вт. | 60 вт. | 40 вт. | 75 вт. | | | 500 вт.

мощность автомата | 75 вт. | 60 вт. | 60 вт. | 60 вт. | 40 вт. | 75 вт. | 26 вт. | | 500 вт. | 8 вт.

Российский химико-технологический университет имени Д. И. Менделеева

г. Москва, Миусская площадь, дом 9, стр.1

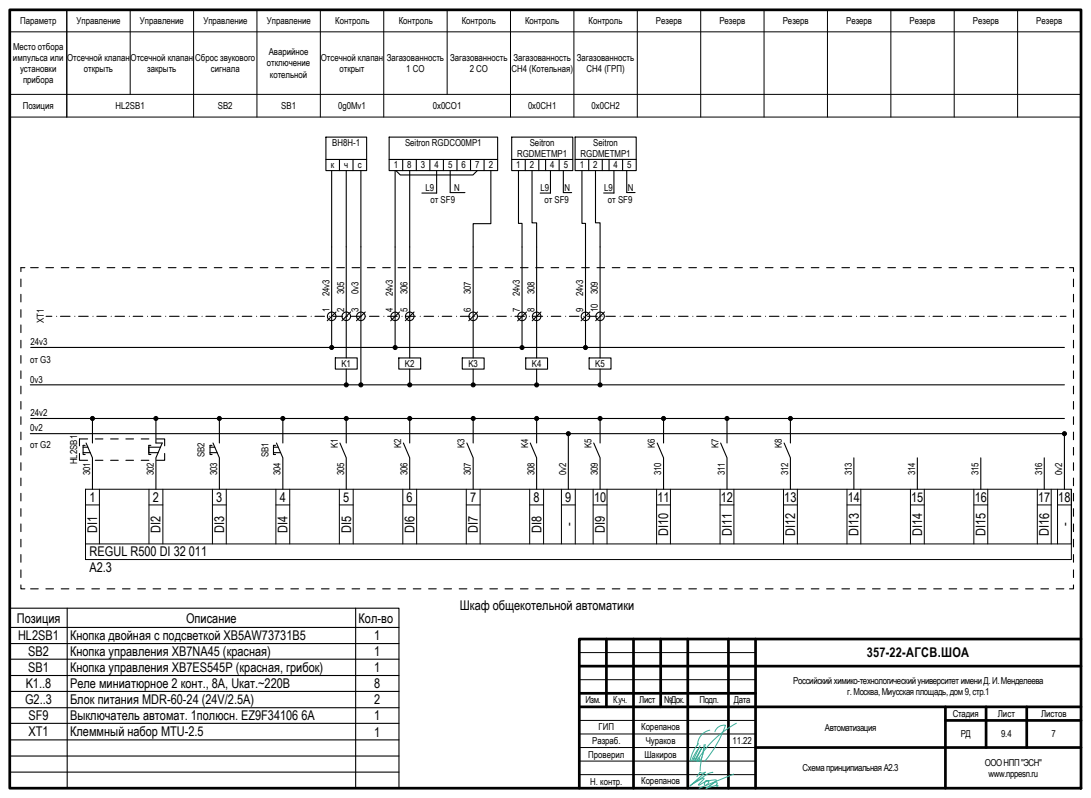
[picture p90: page 4]
Стадия; Лист; Листов; Изм.; №Док.; Подп.; Дата; Автоматизация; 357-22-АГСВ.ШОА; Схема принципиальная А2.3; ГИП; Корепанов; Параметр; Место отбора импульса или установки прибора; Позиция; REGUL R500 DI 32 011; Управление; Контроль; Резерв; Seitron RGDCO0MP1; Seitron RGDMETMP1; Описание; Кол-во; Кнопка двойная с подсветкой XB5AW73731B5; Реле миниатюрное 2 конт., 8A, Uкат.~220В; Кнопка управления XB7ES545P (красная, грибок); Клеммный набор MTU-2.5

Отсечной клапан открыть | Отсечной клапан закрыть | Сброс звукового сигнала | Аварийное отключение котельной | Отсечной клапан открыт | Загазованность 1 СО | Загазованность 2 СО | Загазованность СН4 (Котельная) | Загазованность СН4 (ГРП)

Шкаф общекотельной автоматики

Кнопка управления XB7NA45 (красная)

Российский химико-технологический университет имени Д. И. Менделеева

г. Москва, Миусская площадь, дом 9, стр.1

Блок питания MDR-60-24 (24V/2.5A)
Выключатель автомат. 1полюсн. EZ9F34106 6A

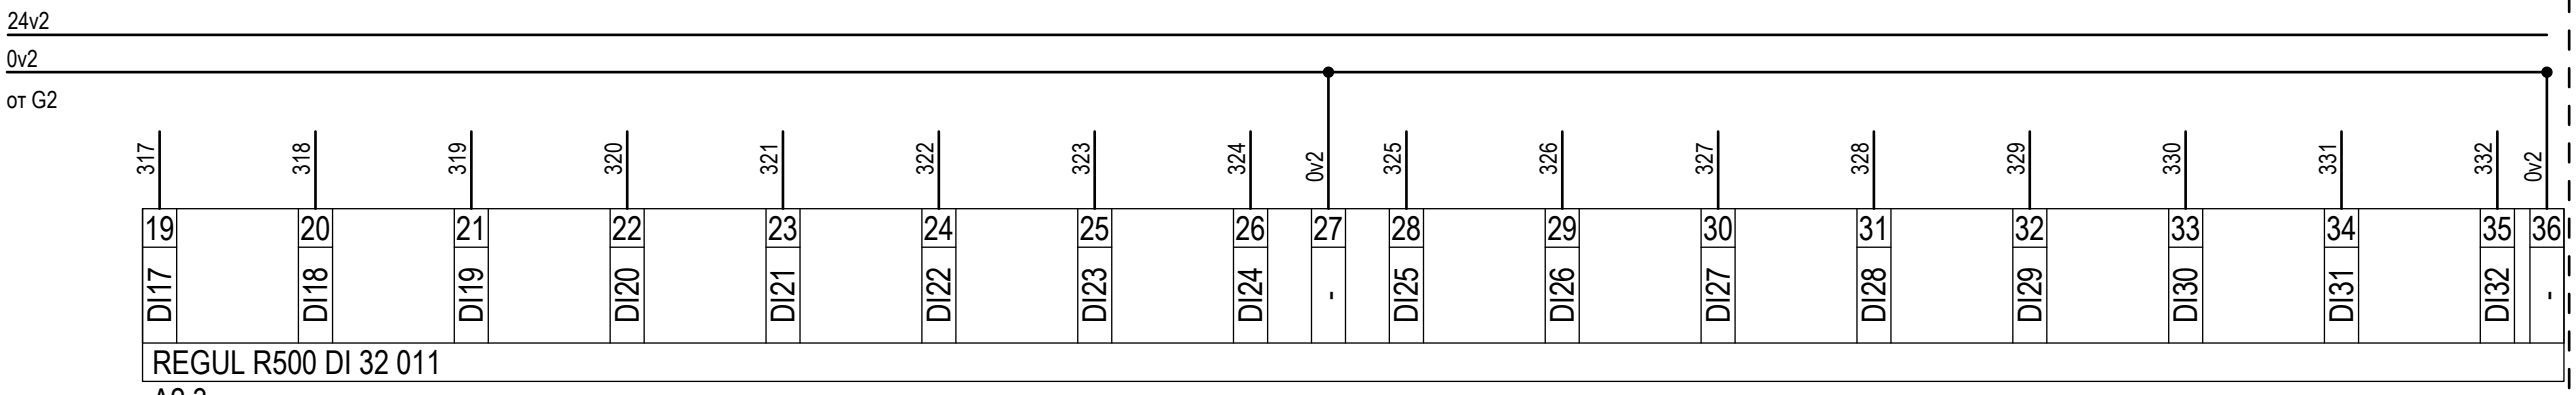
[picture p91: figure]
REGUL R500 DI 32 011

Стадия | Лист | Листов
Изм. | К.уч. | Лист | №Док. | Подп. | Дата

Автоматизация
РД

Российский химико-технологический университет имени Д. И. Менделеева г. Москва, Миусская площадь, дом 9, стр.1

## 357-22-АГСВ.ШОА

9.5

ГИП

Корепанов

установки
прибора

Позиция

A2.3

Резерв | Резерв | Резерв | Резерв | Резерв | Резерв | Резерв | Резерв | Резерв | Резерв

## Шкаф общекотельной автоматики

Резерв | Резерв | Резерв | Резерв | Резерв | Резерв

7

Позиция | Описание | Кол-во
G2 | Блок питания MDR-60-24 (24V/2.5A) | 1

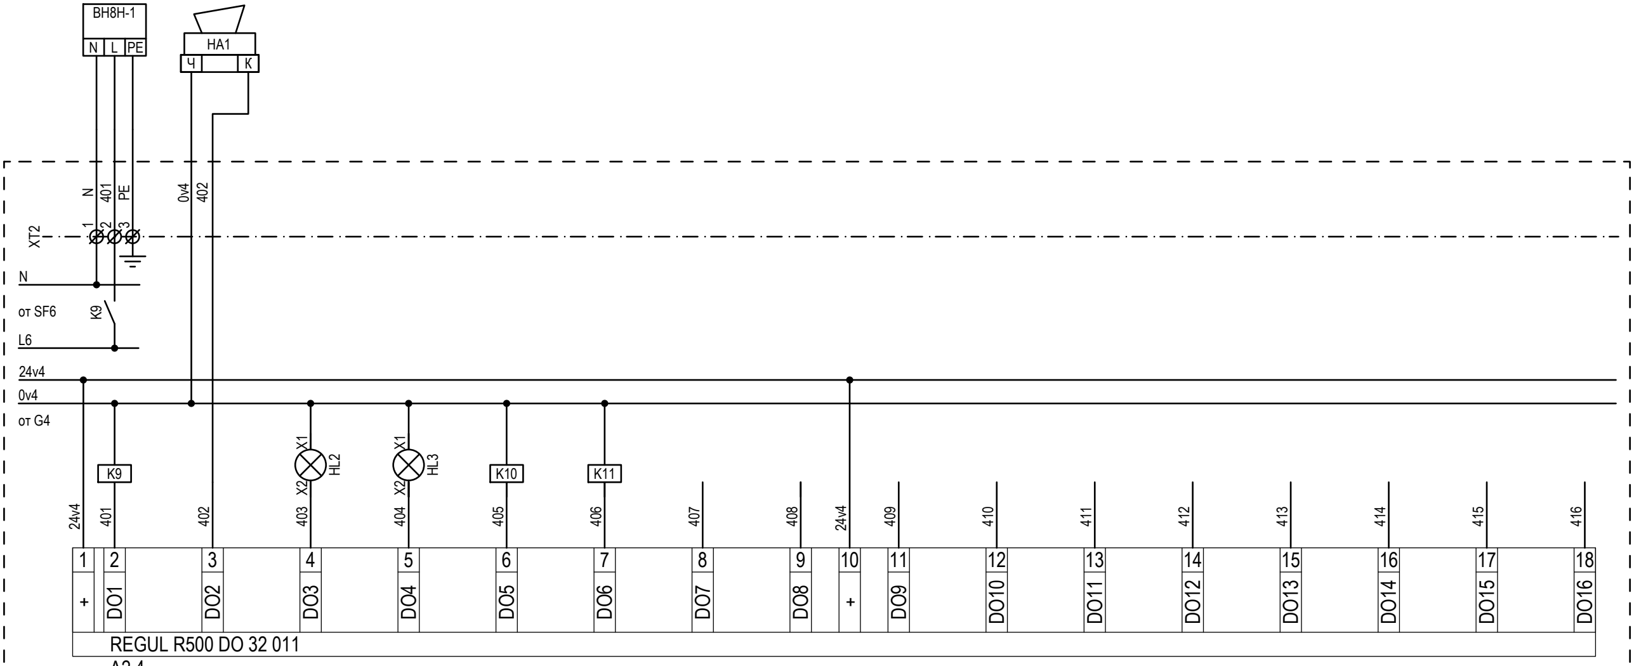
[picture p92: figure]
REGUL R500 DO 32 011

Стадия | Лист | Листов
Изм. | К.уч. | Лист | №Док. | Подп. | Дата

Автоматизация
РД

Российский химико-технологический университет имени Д. И. Менделеева г. Москва, Миусская площадь, дом 9, стр.1

## 357-22-АГСВ.ШОА

9.6 Разраб.

установки
прибора

Позиция

A2.4

Управление | Управление | Управление | Резерв | Резерв | Резерв | Резерв | Резерв | Резерв | Резерв | Резерв | Резерв | Резерв | Резерв | Резерв
Отсечной клапан открыть | Звуковая сигнализация включить | Светодиод "Авария" включить | Светодиод "Работа" включить
0g0Mv1 | HA1 | HL2 | HL3

## Шкаф управления котлом

Управление

7

## Позиция

G4
SF6
Описание | Кол-во
Блок питания MDR-60-24 (24V/2.5A) Выключатель автомат. 1полюсн. EZ9F34106 6A | 1
| 1
K9..11 | Реле миниатюрное 2 конт., 8A, Uкат.~220В | 3
HA1 | Оповещатель охранно-пожарный звуковой | 1
XT2 | Клеммный набор MTU-2.5 | 1

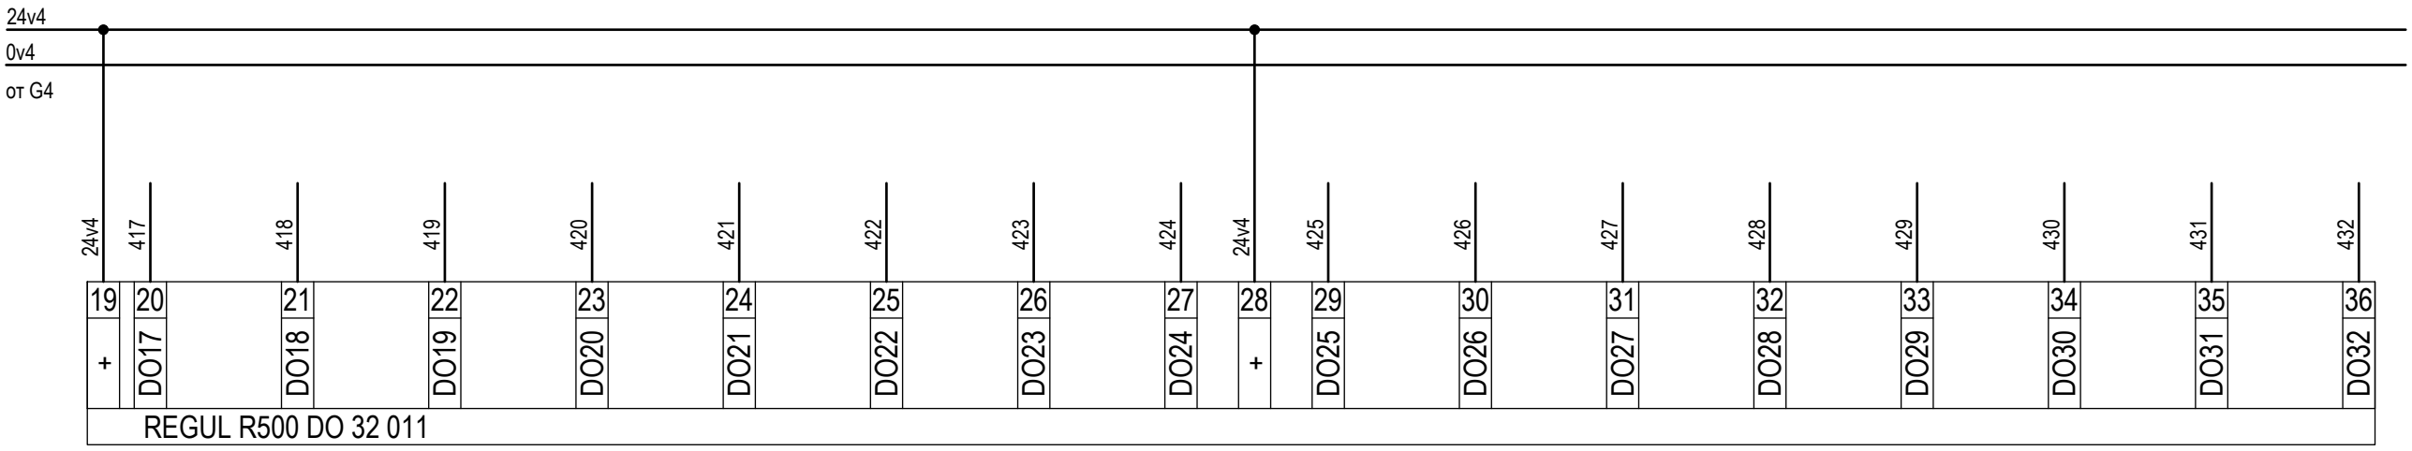
[picture p93: figure]
REGUL R500 DO 32 011

Стадия | Лист | Листов
Изм. | К.уч. | Лист | №Док. | Подп. | Дата

Автоматизация
РД

Российский химико-технологический университет имени Д. И. Менделеева г. Москва, Миусская площадь, дом 9, стр.1

## 357-22-АГСВ.ШОА

9.7

ГИП

Корепанов

установки
прибора

Позиция

A2.9

Резерв | Резерв | Резерв | Резерв | Резерв | Резерв | Резерв | Резерв | Резерв | Резерв | Резерв | Резерв | Резерв | Резерв | Резерв | Резерв

## Шкаф управления котлом

7

Позиция | Описание | Кол-во
G4 | Блок питания MDR-60-24 (24V/2.5A) | 1
