nppesnteam/357-22-RHTU-DKVR-4.13/АГСВ1/7. ШУК/АГСВ1.ШУК.pdf

## Вид передней панели

## Позиция

Стадия; Лист; Листов; Изм.; №Док.; Подп.; Дата; 357-22-АГСВ1.ШУК; 7.1 Разраб.; Проверил; Н. контр.; Чураков Шакиров; Корепанов; Сеть 220В; Предупреждение; Авария; Работа; Стоп/Пуск котла; Сброс звукового; сигнала; Стоп/Пуск горелка 1; Стоп/Пуск горелка 2; Регулятор газа 1; Регулятор воздуха 1; Регулятор воздуха 2; Регулятор газа 2; Регулятор уровня Ручн/Авт; Больше; Меньше; Регулятор разрежения; HLSB16; HLSB17; HLSB18; Ручн/Авт; HLSB13; HLSB14; HLSB15; HLSB7; HLSB8; HLSB9; HLSB10; HLSB11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

Светосигнальный индикатор XB7EV03P (зеленый)
Светосигнальный индикатор XB7EV05P (желтый)
Светосигнальный индикатор XB7EV04P (красный)
Кнопка управления XB7NA45 (красная)
Кнопка управления с подсветкой XB7NJ03B1 (зеленая)
Кнопка двойная с подсветкой XB5AW73731B5

Российский химико-технологический университет имени Д. И. Менделеева

г. Москва, Миусская площадь, дом 9, стр.1

Автоматизация. Котел №1 ДКВР-4/13

ОООНПП "ЭСН"
www.nppesn.ru

Вид передней панели

## Позиция

1QF

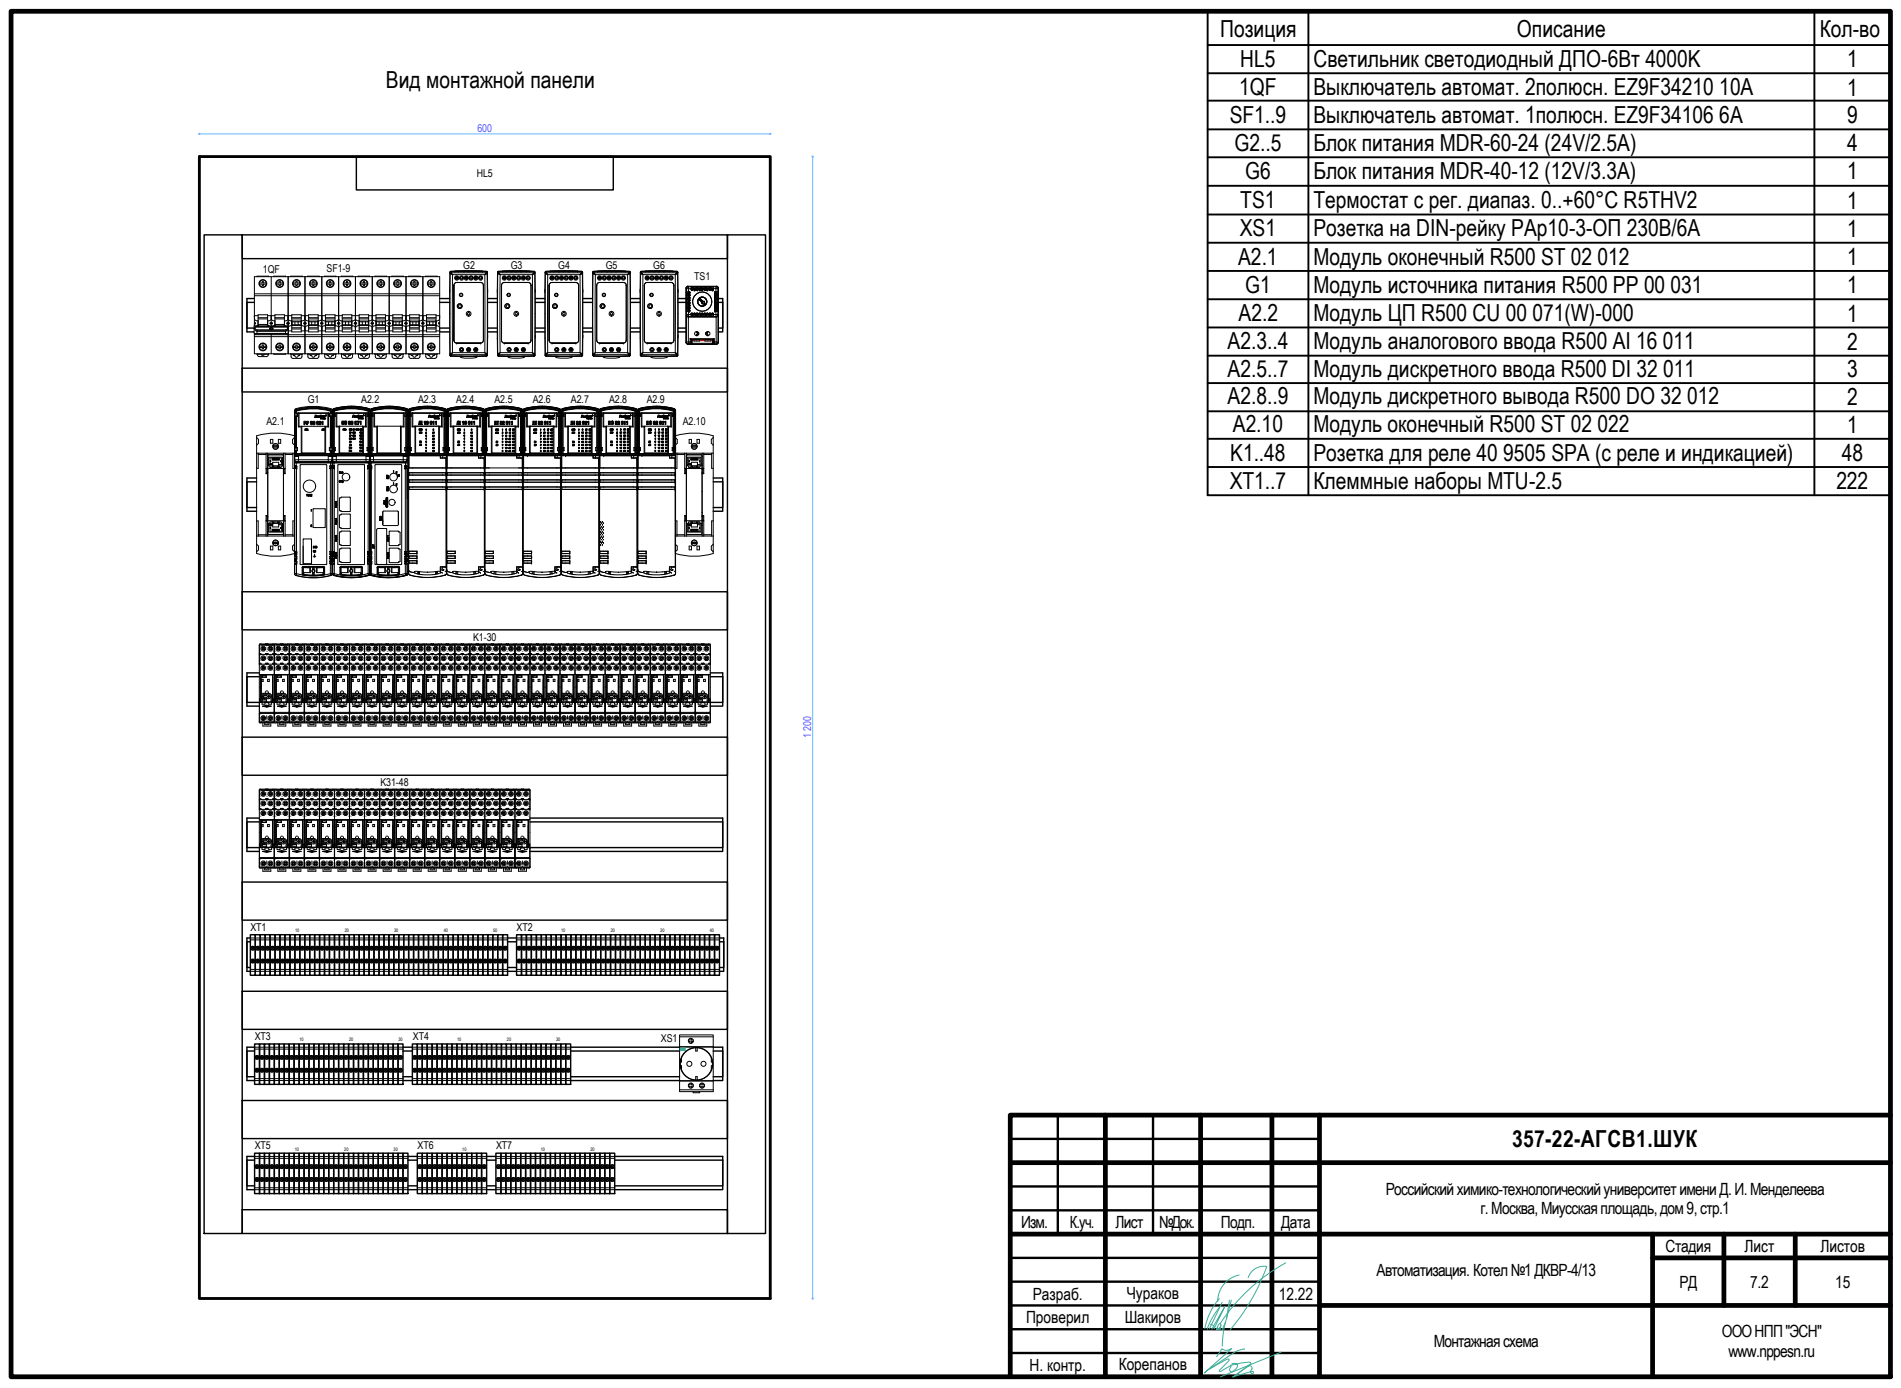
[picture p94: page 2]
Стадия; Лист; Листов; Изм.; №Док.; Подп.; Дата; 357-22-АГСВ1.ШУК; Монтажная схема; 7.2 Разраб.; COIL; Описание; Кол-во; Выключатель автомат. 2полюсн. EZ9F34210 10А; Светильник светодиодный ДПО-6Вт 4000K; A2.5..7 Модуль дискретного ввода R500 DI 32 011; G2..5 Блок питания MDR-60-24 (24V/2.5A); SF1..9 Выключатель автомат. 1полюсн. EZ9F34106 6A; Блок питания MDR-40-12 (12V/3.3A); A2.10 Модуль оконечный R500 ST 02 022

Вид монтажной панели

Розетка на DIN-рейку PAp10-3-ОП 230В/6А
Модуль оконечный R500 ST 02 012
Модуль источника питания R500 PP 00 031
Модуль ЦП R500 CU 00 071(W)-000
Модуль аналогового ввода R500 AI 16 011

Термостат с рег. диапаз. 0..+60°С R5THV2

Модуль дискретного вывода R500 DO 32 012

Розетка для реле 40 9505 SPA (с реле и индикацией)
Клеммные наборы MTU-2.5

Российский химико-технологический университет имени Д. И. Менделеева

г. Москва, Миусская площадь, дом 9, стр.1

Автоматизация. Котел №1 ДКВР-4/13

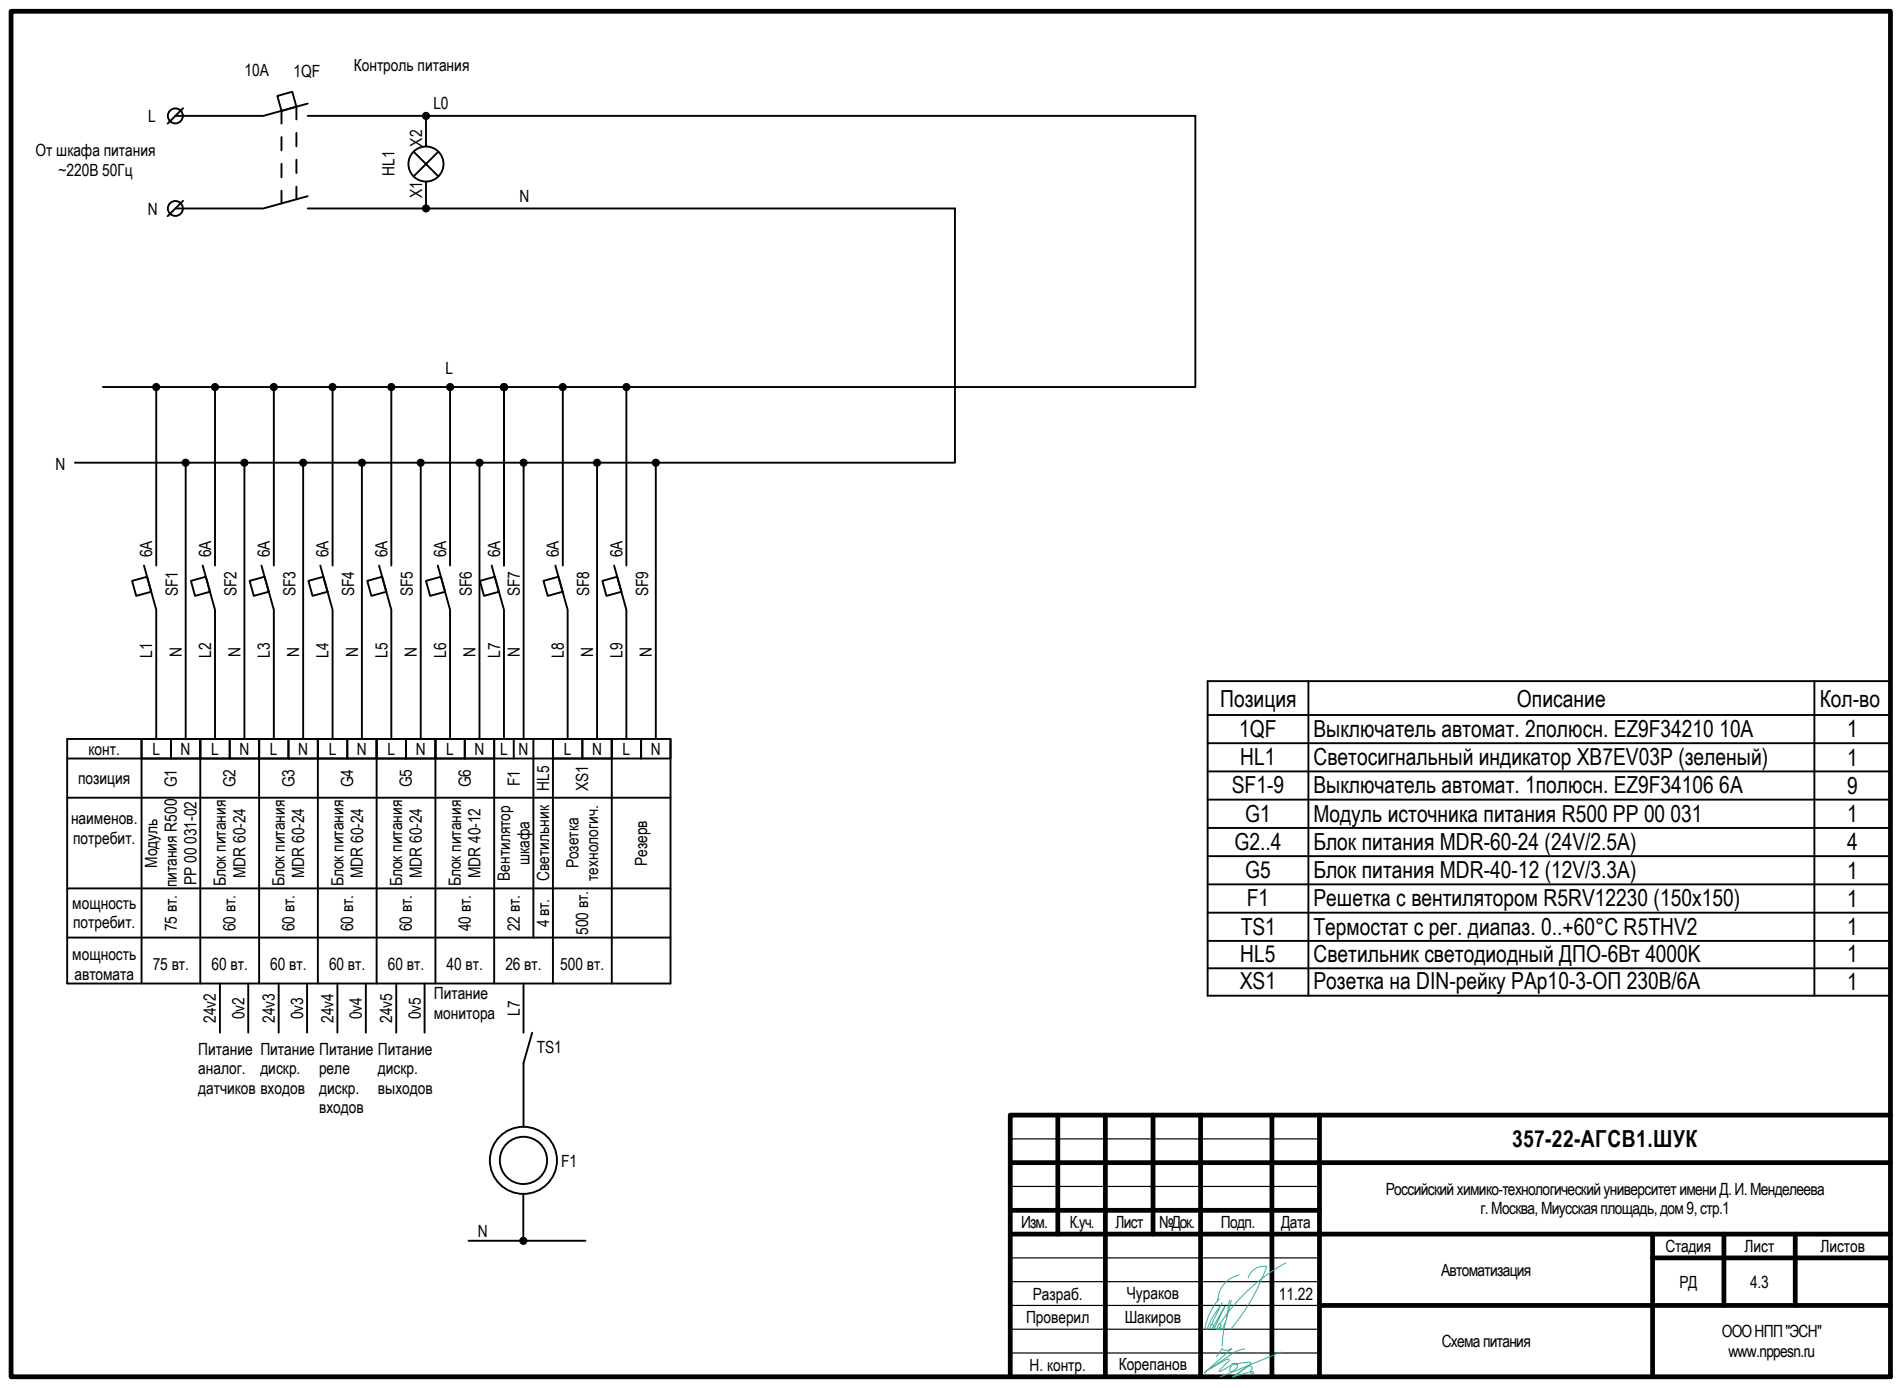
[picture p95: page 3]
Стадия; Лист; Листов; Изм.; №Док.; Подп.; Дата; Автоматизация; 357-22-АГСВ1.ШУК; Схема питания; 4.3 Разраб.; Контроль питания; Питание аналог. датчиков; Питание дискр. входов; Питание реле дискр. входов; Питание дискр. выходов; Описание; Кол-во; Решетка с вентилятором R5RV12230 (150х150); Выключатель автомат. 2полюсн. EZ9F34210 10А; Светильник светодиодный ДПО-6Вт 4000K; Розетка на DIN-рейку PAp10-3-ОП 230В/6А; Питание монитора

От шкафа питания

Позиция
Светосигнальный индикатор XB7EV03P (зеленый)
Выключатель автомат. 1полюсн. EZ9F34106 6A
Модуль источника питания R500 PP 00 031

конт. | L N | L N | L N | L N | L N | L N | L | N | | L N
позиция

наименов. потребит.

Блок питания MDR-60-24 (24V/2.5A)

Блок питания MDR-40-12 (12V/3.3A)

мощность потребит.

Термостат с рег. диапаз. 0..+60°С R5THV2

мощность автомата | 75 вт. | 60 вт. | 60 вт. | 60 вт. | 60 вт. | 40 вт. | 26 вт. | | 500 вт.

Российский химико-технологический университет имени Д. И. Менделеева

г. Москва, Миусская площадь, дом 9, стр.1

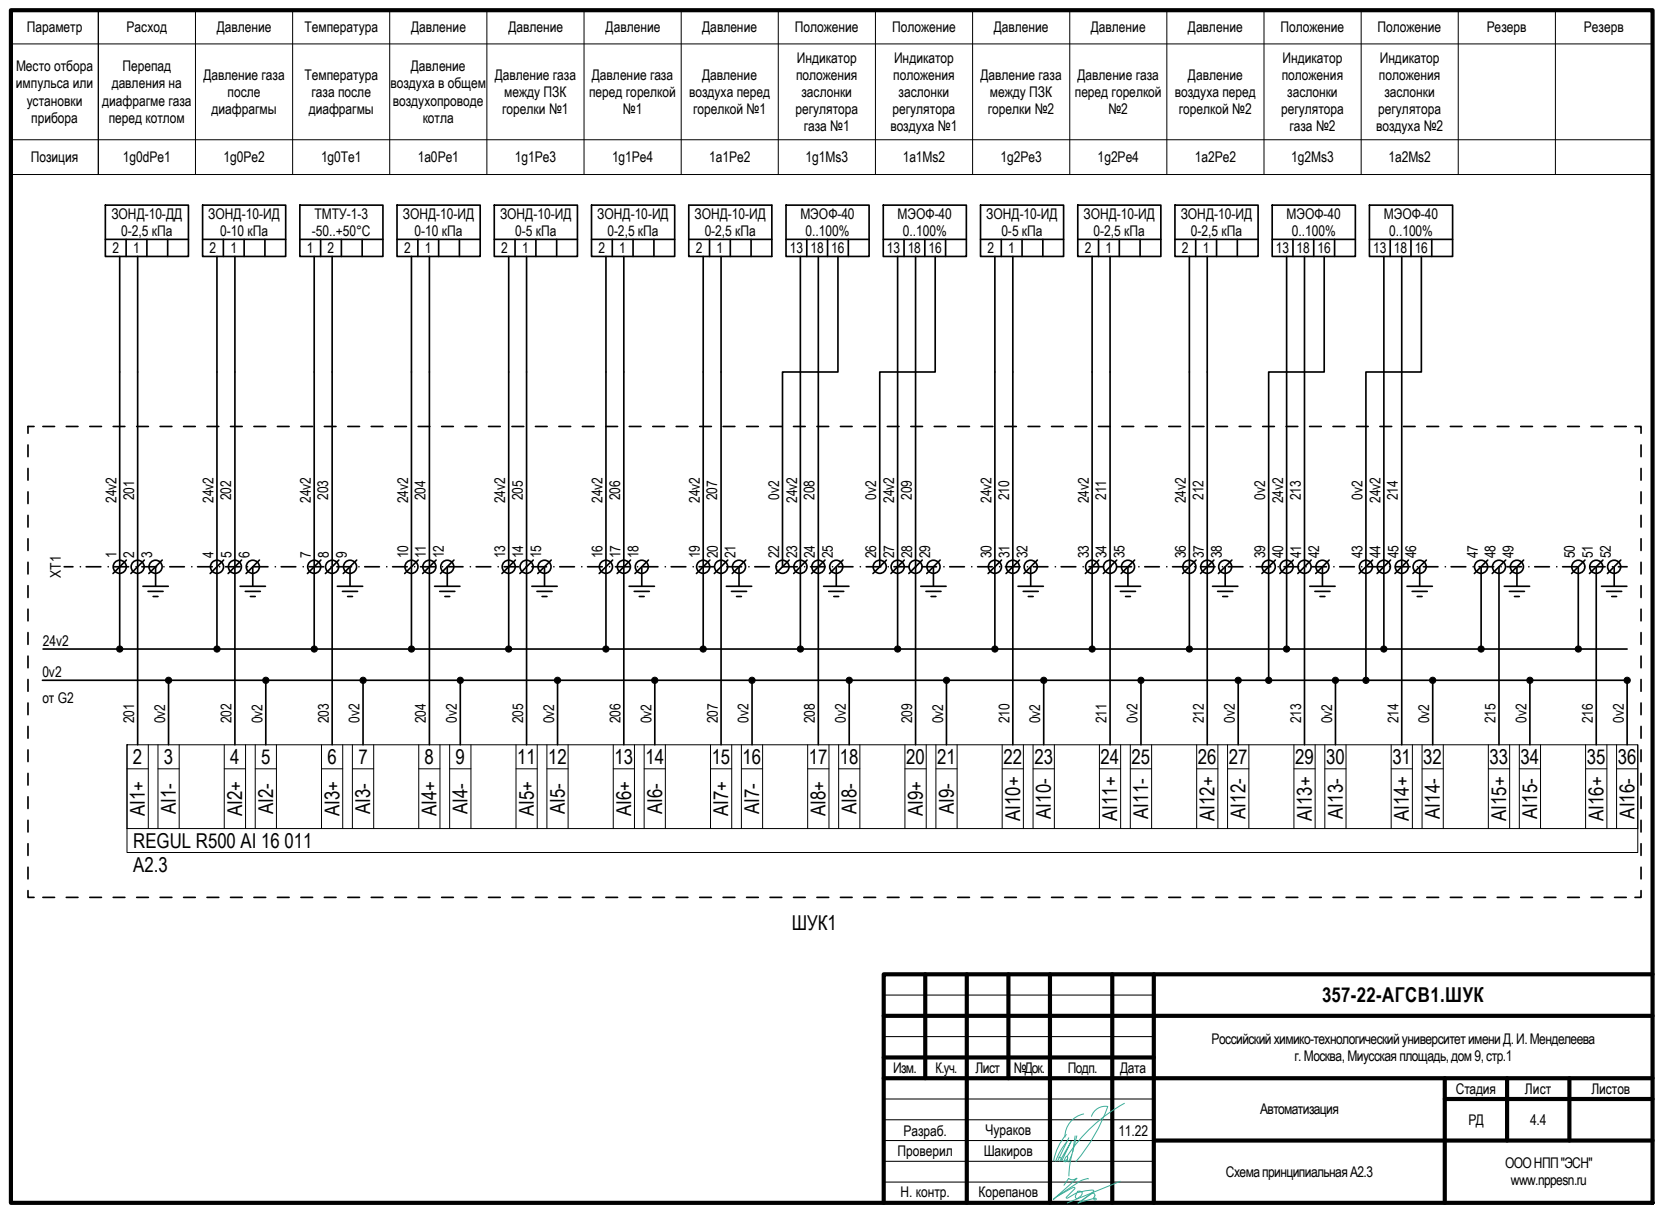
[picture p96: page 4]
Стадия; Лист; Листов; Изм.; №Док.; Подп.; Дата; Автоматизация; 357-22-АГСВ1.ШУК; Схема принципиальная А2.3; 4.4 Разраб.; Параметр; Место отбора импульса или установки прибора; Позиция; REGUL R500 AI 16 011; Расход; Давление; Температура; Положение; Резерв; Перепад давления на диафрагме газа перед котлом; Давление газа после диафрагмы; Температура газа после диафрагмы; Давление воздуха в общем воздухопроводе котла; Давление газа между ПЗК горелки №1; Давление газа перед горелкой №1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

Российский химико-технологический университет имени Д. И. Менделеева

г. Москва, Миусская площадь, дом 9, стр.1

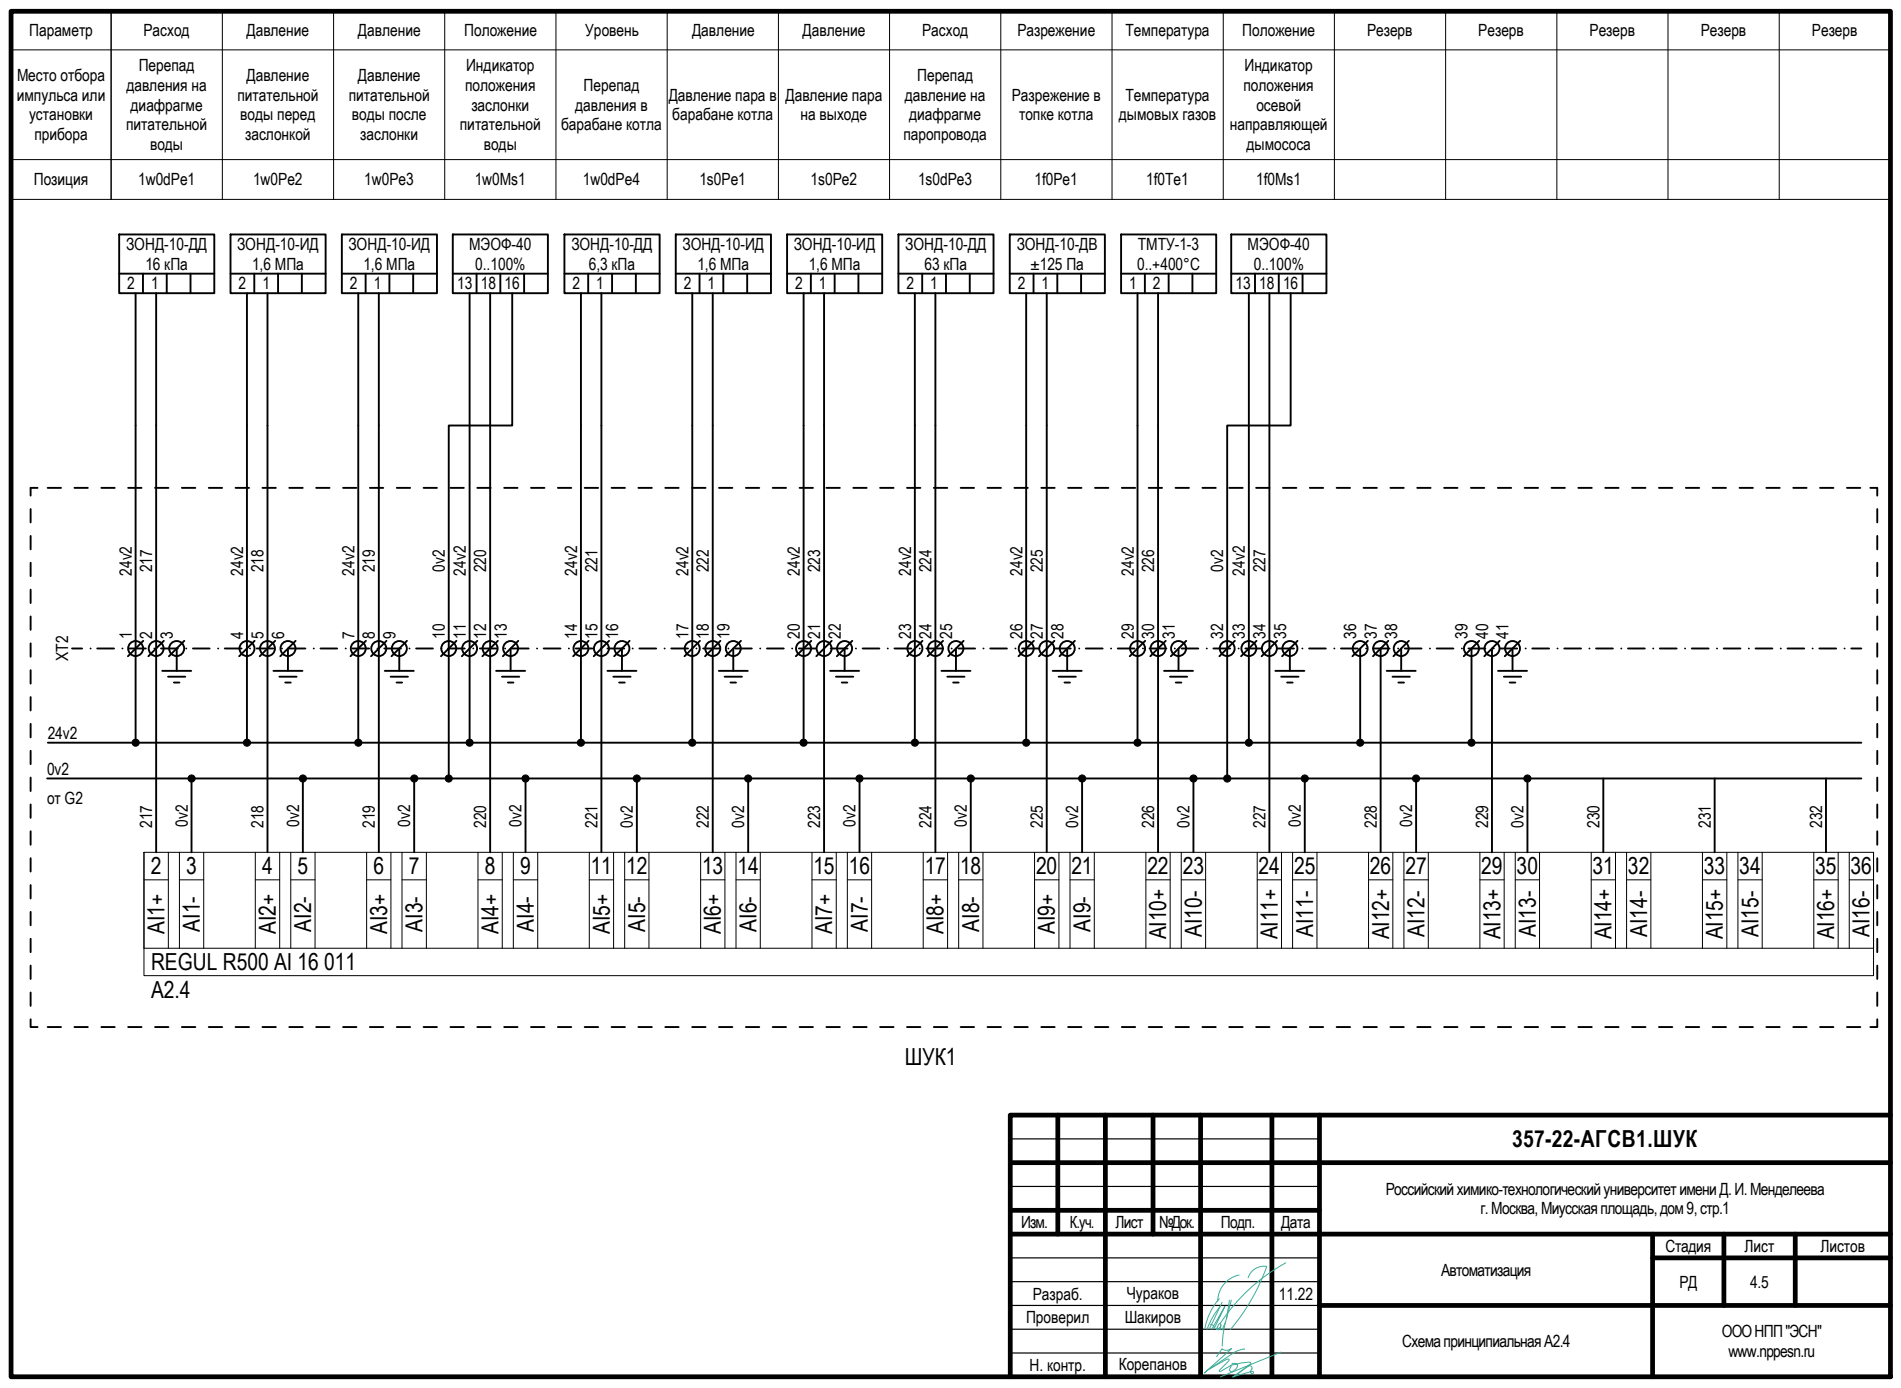
[picture p97: page 5]
Стадия; Лист; Листов; Изм.; №Док.; Подп.; Дата; Автоматизация; 357-22-АГСВ1.ШУК; 4.5 Разраб.; установки прибора; Позиция; REGUL R500 AI 16 011; Расход; Давление; Положение; Уровень; Разрежение; Температура; Резерв; Перепад давления на диафрагме питательной воды; Давление питательной воды перед заслонкой; Давление питательной воды после заслонки; Индикатор положения заслонки питательной воды; Перепад давления в барабане котла; Давление пара в барабане котла; Давление пара на выходе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

Российский химико-технологический университет имени Д. И. Менделеева

г. Москва, Миусская площадь, дом 9, стр.1

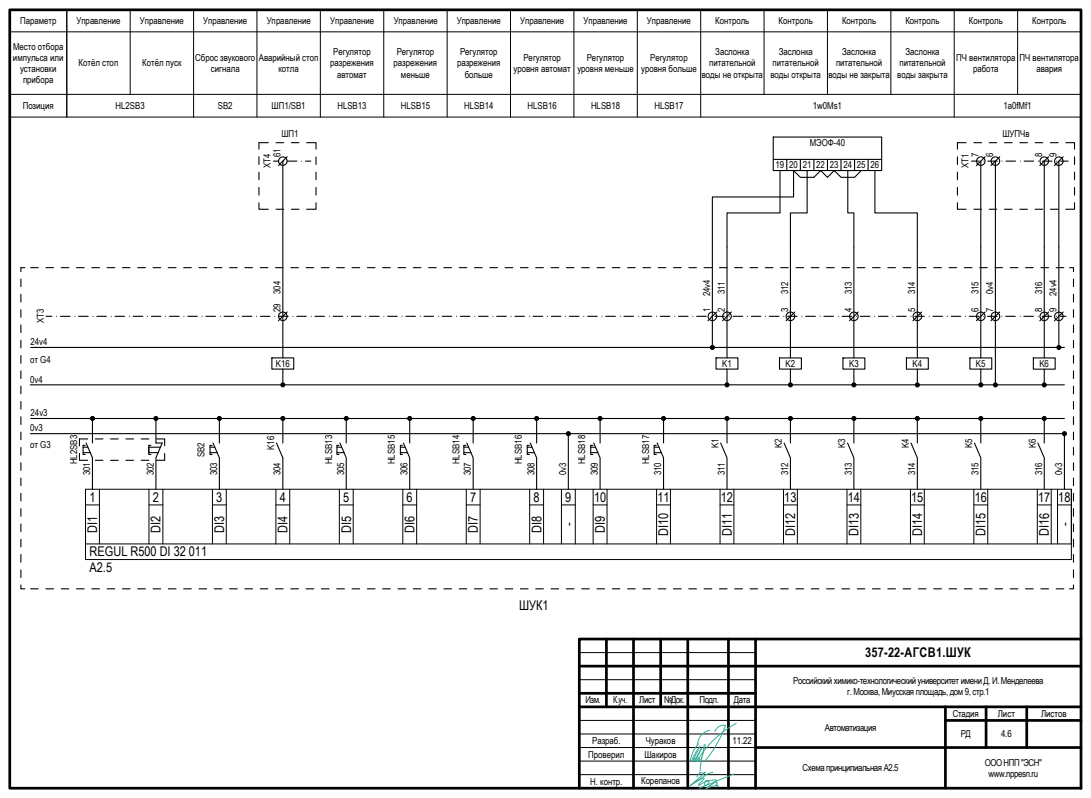
[picture p98: page 6]
Стадия; Лист; Листов; Изм.; №Док.; Подп.; Дата; Автоматизация; 357-22-АГСВ1.ШУК; 4.6 Разраб.; установки прибора; Позиция; REGUL R500 DI 32 011; Управление; Контроль; Котёл стоп; Котёл пуск; Сброс звукового сигнала; Аварийный стоп котла; Регулятор разрежения; автомат; Регулятор разрежения меньше; Регулятор разрежения больше; Регулятор уровня автомат; Регулятор уровня меньше; Регулятор уровня больше; HLSB13; HLSB15; HLSB14; HLSB16; HLSB18; HLSB17; питательной воды открыта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

Заслонка
питательной
воды не открыта

воды не закрыта

Российский химико-технологический университет имени Д. И. Менделеева

г. Москва, Миусская площадь, дом 9, стр.1

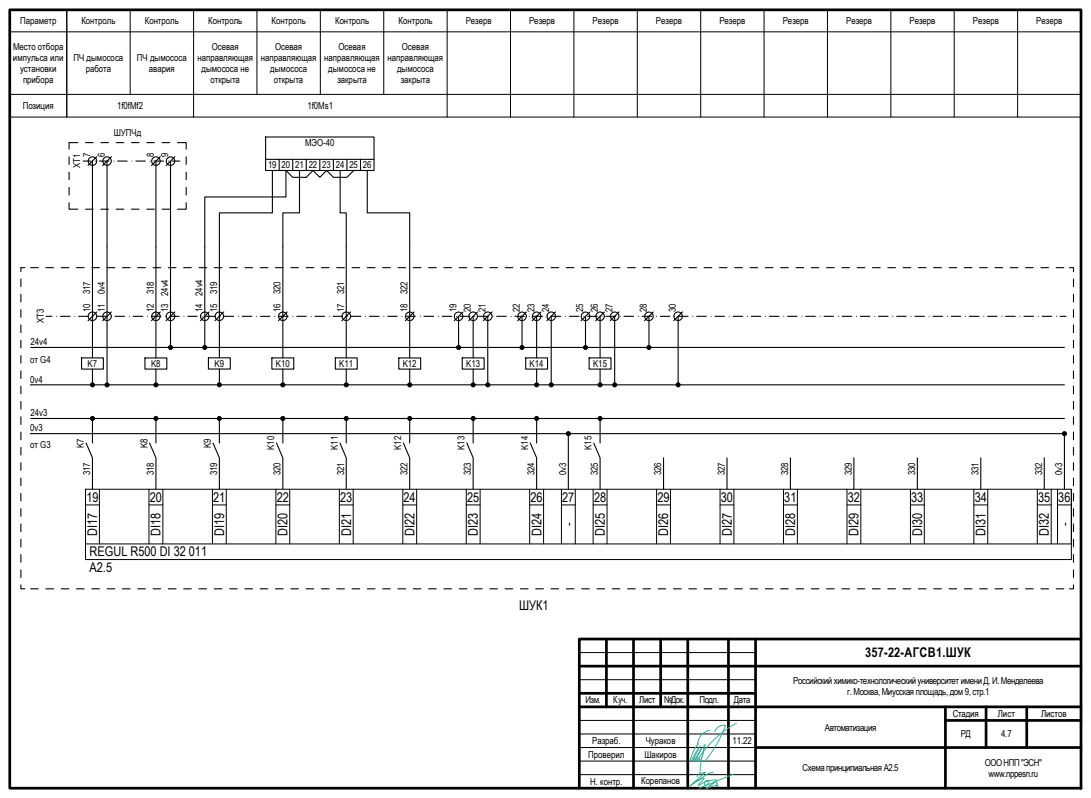
[picture p99: page 7]
Стадия; Лист; Листов; Изм.; №Док.; Подп.; Дата; Автоматизация; 357-22-АГСВ1.ШУК; 4.7 Разраб.; установки прибора; Позиция; REGUL R500 DI 32 011; Контроль; Резерв; ПЧ дымососа работа; ПЧ дымососа авария; Осевая направляющая дымососа не открыта; 1f0fMf2; Осевая направляющая дымососа открыта; Осевая направляющая дымососа не закрыта; Осевая направляющая дымососа закрыта; МЭО-40; ШУПЧд; ШУК1

Российский химико-технологический университет имени Д. И. Менделеева

г. Москва, Миусская площадь, дом 9, стр.1

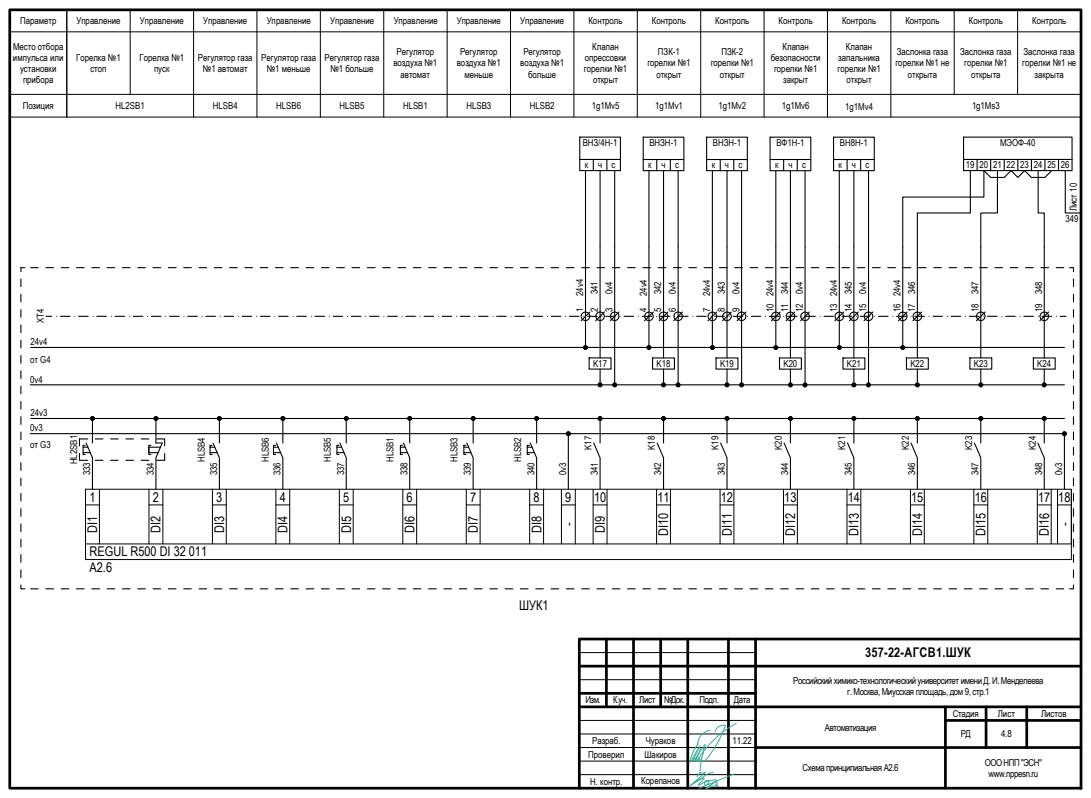
[picture p100: page 8]
Стадия; Лист; Листов; Изм.; №Док.; Подп.; Дата; Автоматизация; 357-22-АГСВ1.ШУК; 4.8 Разраб.; установки прибора; Позиция; REGUL R500 DI 32 011; Управление; Контроль; Горелка №1 стоп; Горелка №1 пуск; Регулятор газа №1 автомат; Регулятор газа №1 меньше; Регулятор газа №1 больше; Регулятор воздуха №1 автомат; Регулятор воздуха №1 меньше; Регулятор воздуха №1 больше; Клапан опрессовки горелки №1 открыт; ПЗК-1 горелки №1 открыт; ПЗК-2; открыт; HLSB4; HLSB6; HLSB5; HLSB1; HLSB3; HLSB2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

Российский химико-технологический университет имени Д. И. Менделеева

г. Москва, Миусская площадь, дом 9, стр.1

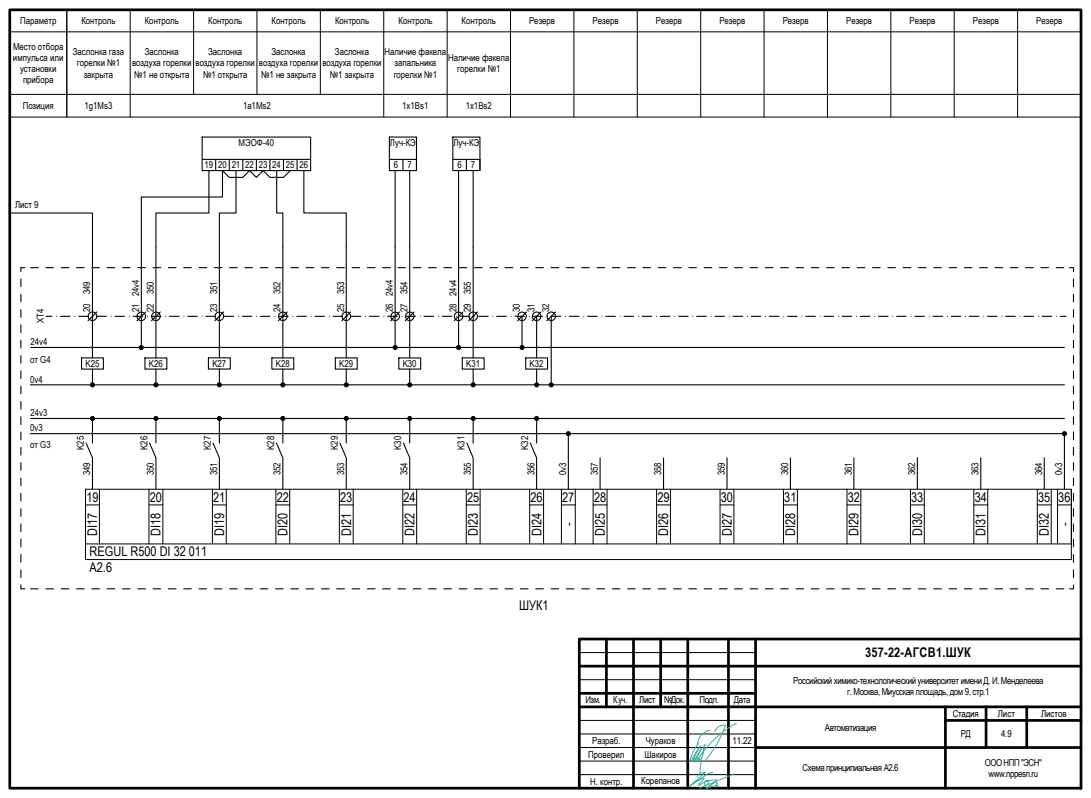
[picture p101: page 9]
Стадия; Лист; Листов; Изм.; №Док.; Подп.; Дата; Автоматизация; 357-22-АГСВ1.ШУК; 4.9 Разраб.; установки прибора; Позиция; REGUL R500 DI 32 011; Контроль; Резерв; закрыта; воздуха горелки №1 не открыта; воздуха горелки №1 открыта; воздуха горелки №1 не закрыта; воздуха горелки №1 закрыта; Наличие факела; горелки №1; Наличие факела горелки №1; МЭОФ-40; Лист 9; Луч-КЭ; ШУК1

Российский химико-технологический университет имени Д. И. Менделеева

г. Москва, Миусская площадь, дом 9, стр.1

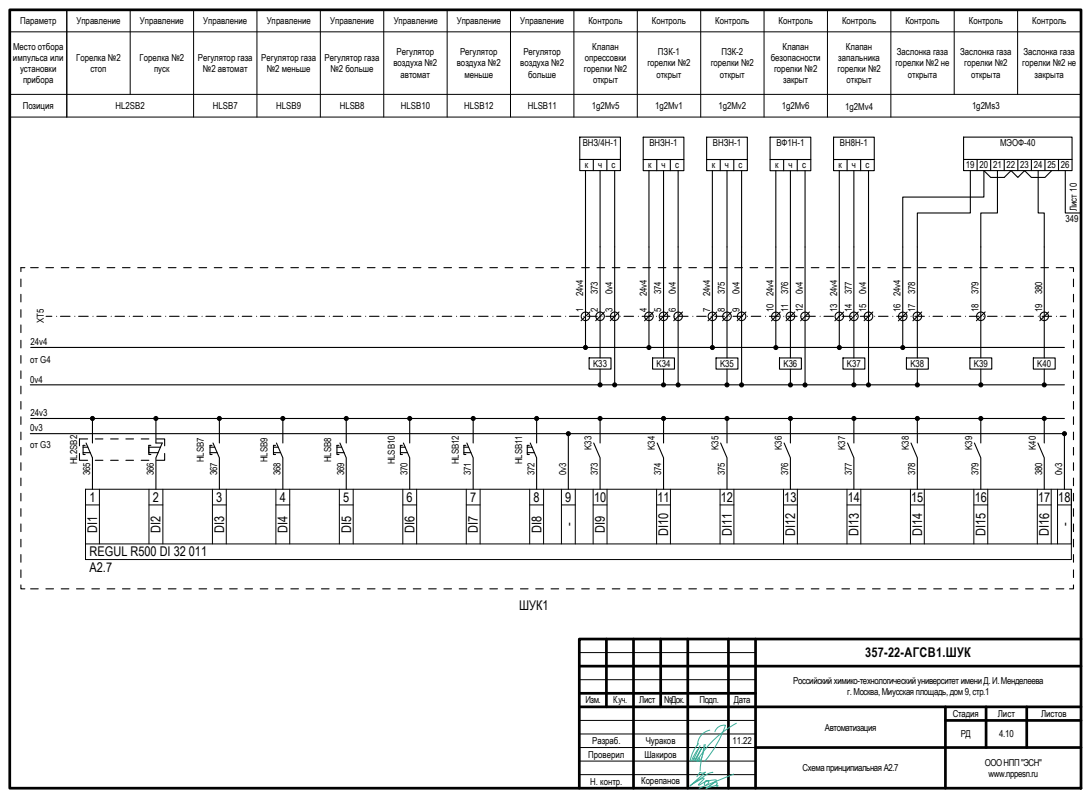
[picture p102: page 10]
Стадия; Лист; Листов; Изм.; №Док.; Подп.; Дата; Автоматизация; 357-22-АГСВ1.ШУК; 4.10 Разраб.; установки прибора; Позиция; REGUL R500 DI 32 011; Управление; Контроль; Горелка №2 стоп; Горелка №2 пуск; Регулятор газа №2 автомат; Регулятор газа №2 меньше; Регулятор газа №2 больше; Регулятор воздуха №2 автомат; Регулятор воздуха №2 меньше; Регулятор воздуха №2 больше; Клапан опрессовки горелки №2 открыт; ПЗК-1; открыт; ПЗК-2; HLSB7; HLSB9; HLSB8; HLSB10; HLSB12; HLSB11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

Российский химико-технологический университет имени Д. И. Менделеева

г. Москва, Миусская площадь, дом 9, стр.1

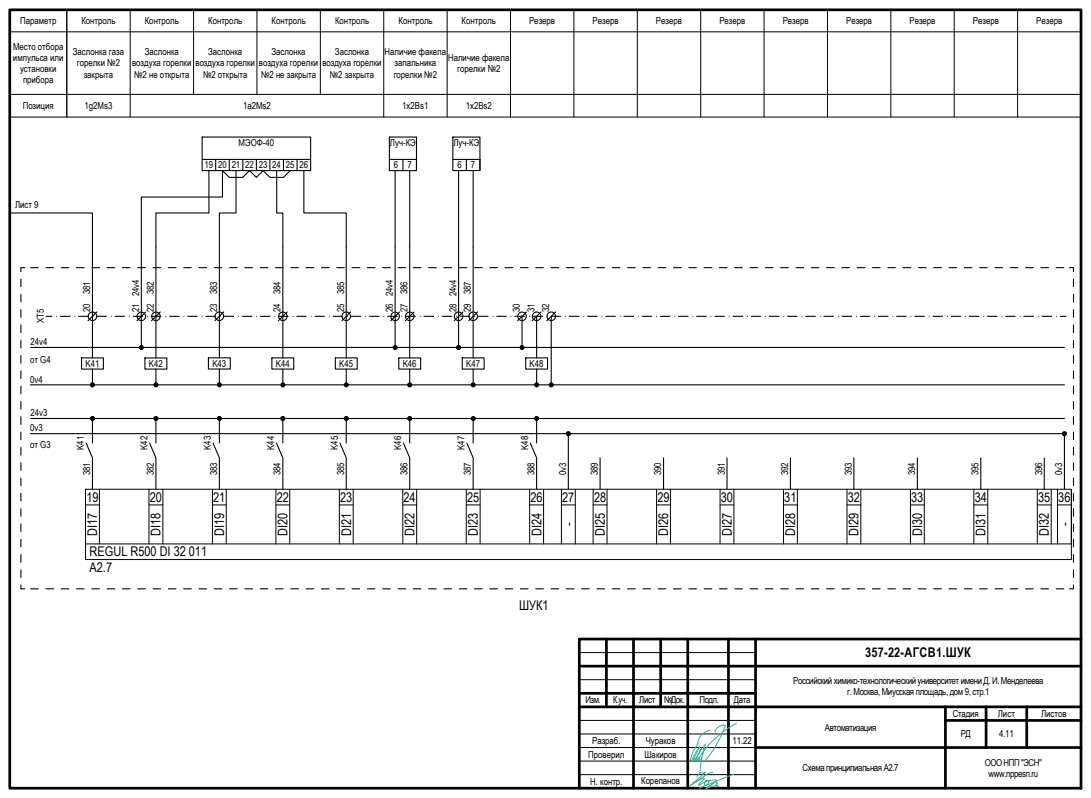
[picture p103: page 11]
Стадия; Лист; Листов; Изм.; №Док.; Подп.; Дата; Автоматизация; 357-22-АГСВ1.ШУК; 4.11 Разраб.; установки прибора; Позиция; REGUL R500 DI 32 011; Контроль; Резерв; закрыта; воздуха горелки №2 не открыта; воздуха горелки №2 открыта; воздуха горелки №2 не закрыта; воздуха горелки №2 закрыта; Наличие факела; горелки №2; Наличие факела горелки №2; МЭОФ-40; Лист 9; Луч-КЭ; ШУК1

Российский химико-технологический университет имени Д. И. Менделеева

г. Москва, Миусская площадь, дом 9, стр.1

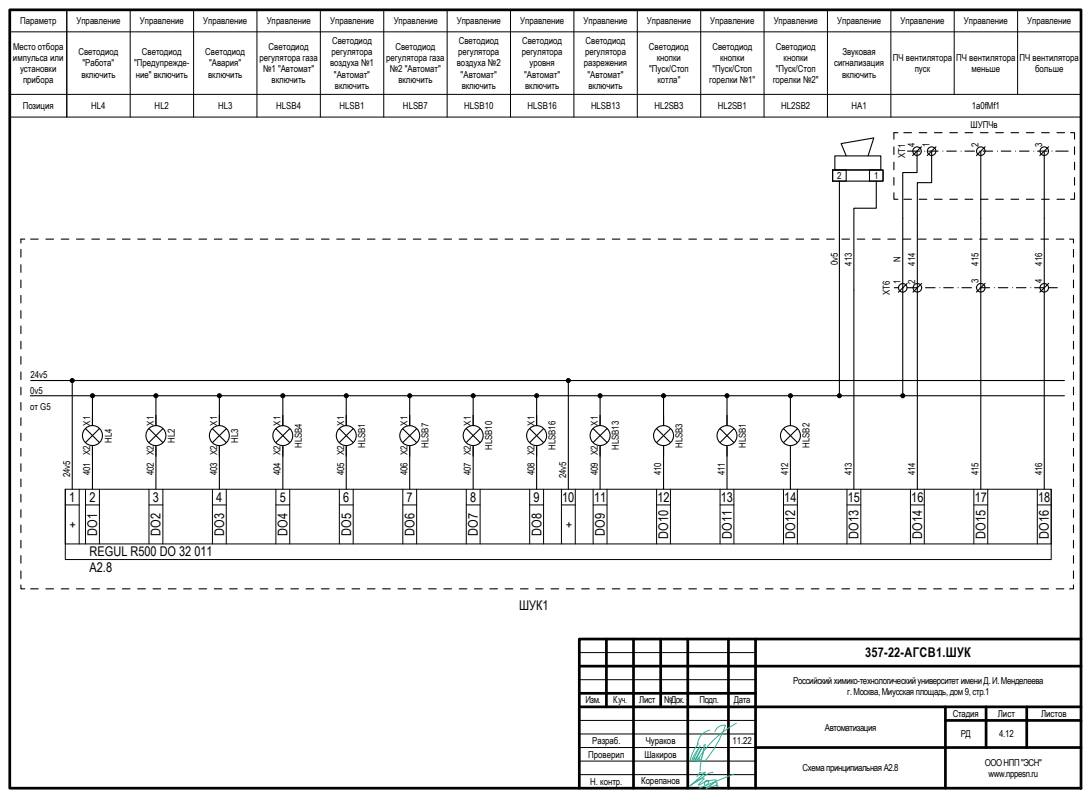
[picture p104: page 12]
Стадия; Лист; Листов; Изм.; №Док.; Подп.; Дата; Автоматизация; 357-22-АГСВ1.ШУК; 4.12 Разраб.; установки прибора; Позиция; REGUL R500 DO 32 011; Управление; Светодиод "Работа" включить; Светодиод "Предупрежде- ние" включить; Светодиод "Авария" включить; Светодиод регулятора газа №1 "Автомат" включить; Светодиод регулятора воздуха №1 "Автомат" включить; Светодиод кнопки "Пуск/Стоп котла"; Светодиод кнопки "Пуск/Стоп горелки №1"; HLSB4; HLSB1; HLSB7; HLSB10; HLSB16; HLSB13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

Российский химико-технологический университет имени Д. И. Менделеева

г. Москва, Миусская площадь, дом 9, стр.1

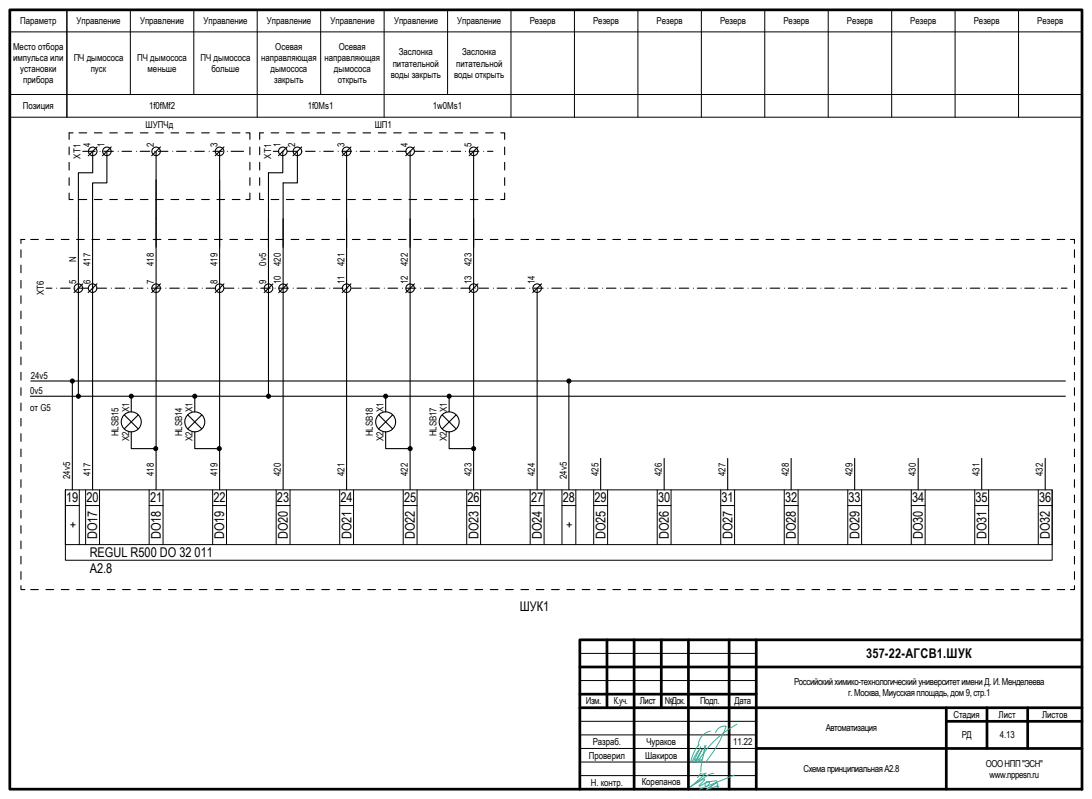
[picture p105: page 13]
Стадия; Лист; Листов; Изм.; №Док.; Подп.; Дата; Автоматизация; 357-22-АГСВ1.ШУК; 4.13 Разраб.; установки прибора; Позиция; REGUL R500 DO 32 011; Управление; Резерв; ПЧ дымососа пуск; ПЧ дымососа меньше; ПЧ дымососа больше; Осевая направляющая дымососа закрыть; Осевая направляющая дымососа открыть; 1f0fMf2; питательной воды закрыть; питательной воды открыть; ШУПЧд; X2 X1 HLSB18; X2 X1 HLSB17; X2 X1 HLSB15; X2 X1 HLSB14; ШУК1

Российский химико-технологический университет имени Д. И. Менделеева

г. Москва, Миусская площадь, дом 9, стр.1

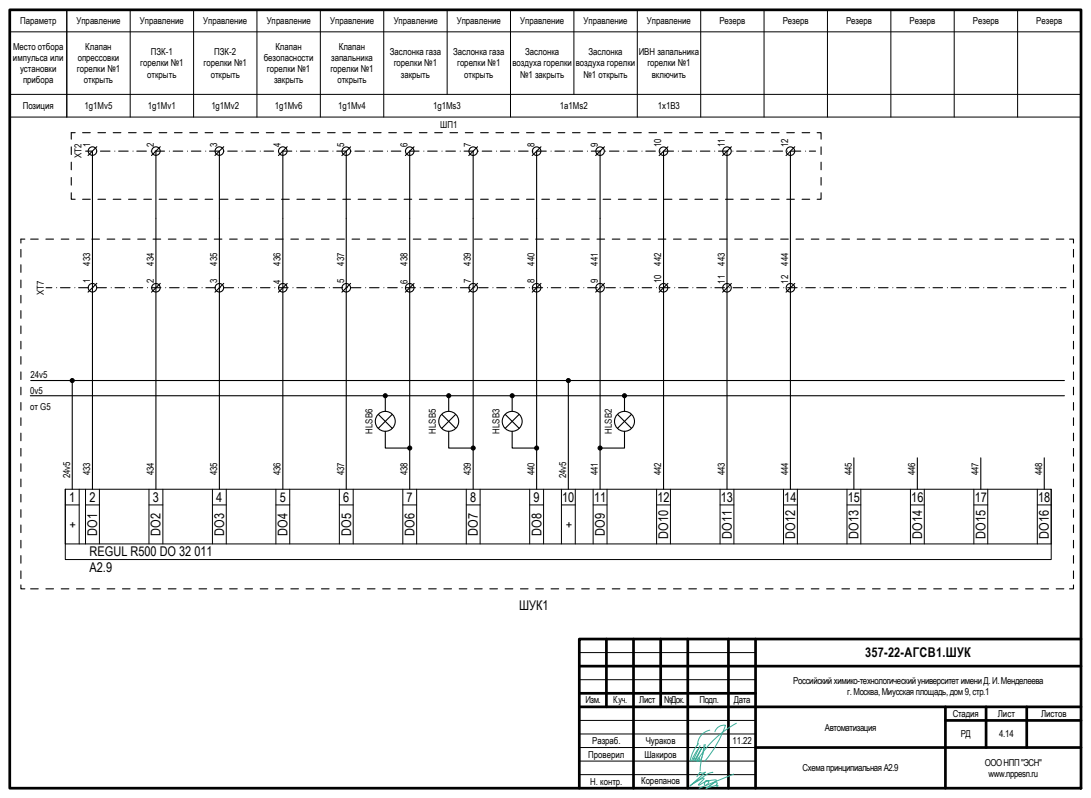
[picture p106: page 14]
Стадия; Лист; Листов; Изм.; №Док.; Подп.; Дата; Автоматизация; 357-22-АГСВ1.ШУК; 4.14 Разраб.; установки прибора; Позиция; REGUL R500 DO 32 011; Управление; Резерв; Клапан опрессовки горелки №1 открыть; ПЗК-1; открыть; ПЗК-2; Клапан безопасности горелки №1 закрыть; Клапан; горелки №1 открыть; ИВН запальника; включить; закрыть; воздуха горелки №1 закрыть; воздуха горелки №1 открыть; HLSB6; HLSB5; HLSB3; HLSB2; ШУК1

Российский химико-технологический университет имени Д. И. Менделеева

г. Москва, Миусская площадь, дом 9, стр.1

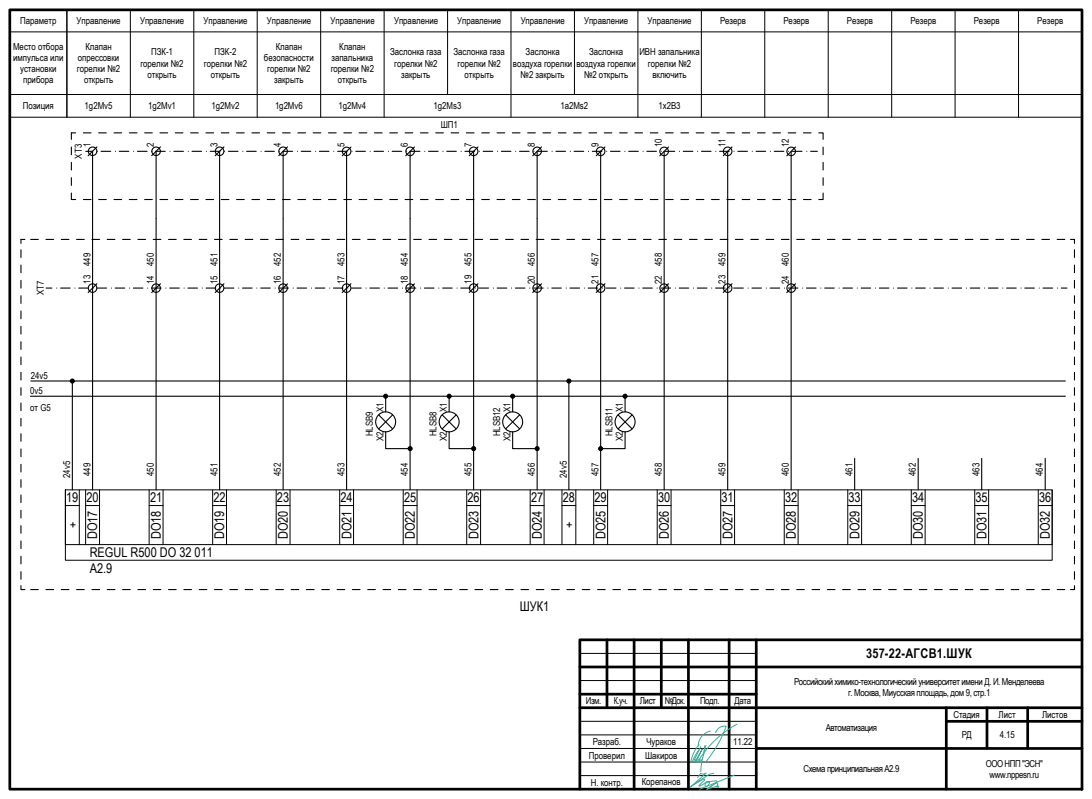
[picture p107: page 15]
Стадия; Лист; Листов; Изм.; №Док.; Подп.; Дата; Автоматизация; 357-22-АГСВ1.ШУК; 4.15 Разраб.; установки прибора; Позиция; REGUL R500 DO 32 011; Управление; Резерв; Клапан опрессовки горелки №2 открыть; ПЗК-1; открыть; ПЗК-2; Клапан безопасности горелки №2 закрыть; Клапан; горелки №2 открыть; ИВН запальника; включить; ШУК1; закрыть; воздуха горелки №2 закрыть; воздуха горелки №2 открыть; X2 X1 HLSB9; X2 X1 HLSB8; X2 X1 HLSB12; X2 X1 HLSB11

Российский химико-технологический университет имени Д. И. Менделеева

г. Москва, Миусская площадь, дом 9, стр.1
