nppesnteam/357-22-RHTU-DKVR-4.13/АГСВ1/8. ШП/АГСВ1.ШП (без схемы питания).pdf

## Вид передней панели

## Позиция

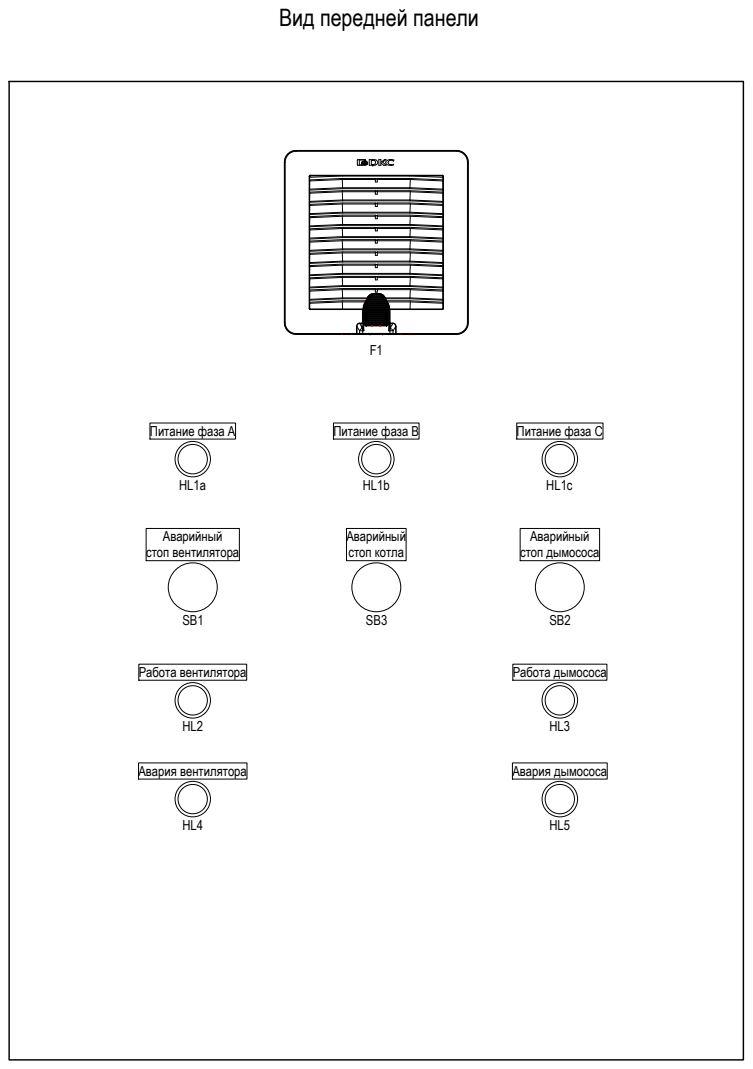
[picture p108: page 1]
Стадия; Лист; Листов; Изм.; №Док.; Подп.; Дата; 357-22-АГСВ1.ШП; 8.1 Разраб.; Проверил; Н. контр.; Чураков Шакиров; Корепанов; Питание фаза В; Аварийный стоп вентилятора; Работа вентилятора; Авария вентилятора; Работа дымососа; Авария дымососа; Аварийный стоп дымососа; Аварийный стоп котла; Питание фаза А; Питание фаза С; Описание; Кол-во; Решетка с вентилятором R5RV12230 (150х150)

Светосигнальный индикатор XB7EV03P (зеленый)
Кнопка управления XB7ES545P (красная, грибок)
Светосигнальный индикатор XB7EV04P (красный)

Российский химико-технологический университет имени Д. И. Менделеева

г. Москва, Миусская площадь, дом 9, стр.1

Автоматизация. Котел №1 ДКВР-4/13

ОООНПП "ЭСН"
www.nppesn.ru

Вид передней панели

## Позиция

1QF

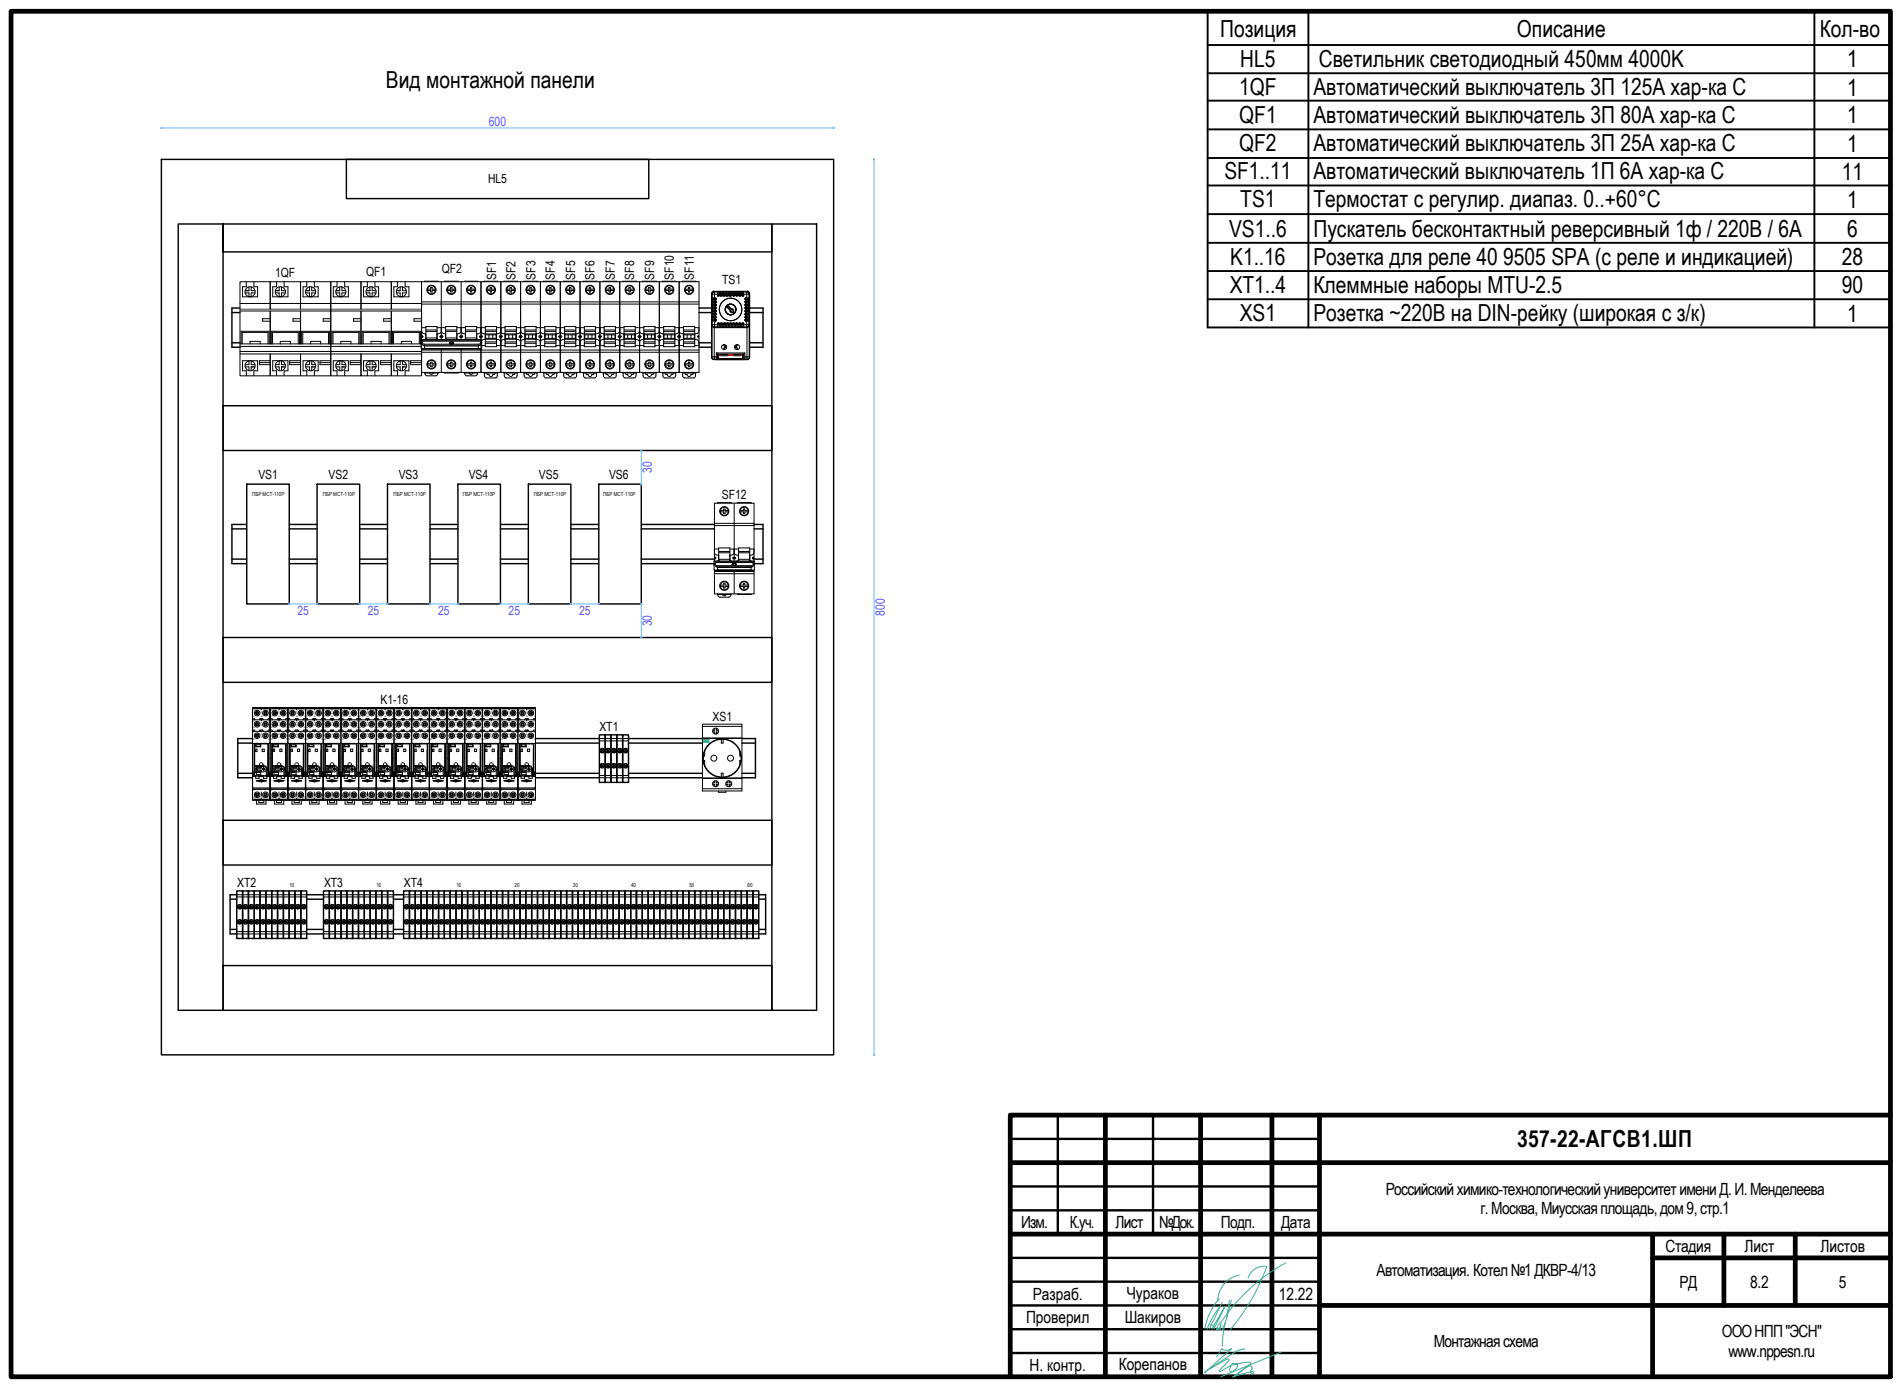
[picture p109: page 2]
Стадия; Лист; Листов; Изм.; №Док.; Подп.; Дата; 357-22-АГСВ1.ШП; Монтажная схема; 8.2 Разраб.; ПБР МСТ-110Р; ПБР ПБР МСТ-110Р; МСТ-110Р; COIL; Описание; Кол-во; Автоматический выключатель 3П 125А хар-ка C; Светильник светодиодный 450мм 4000K; SF1..11 Автоматический выключатель 1П 6А хар-ка C; Автоматический выключатель 3П 80А хар-ка C; Термостат с регулир. диапаз. 0..+60°С; Автоматический выключатель 3П 25А хар-ка C

Вид монтажной панели

Пускатель бесконтактный реверсивный 1ф / 220В / 6А
Розетка для реле 40 9505 SPA (с реле и индикацией)
Клеммные наборы MTU-2.5
Розетка ~220В на DIN-рейку (широкая с з/к)

Российский химико-технологический университет имени Д. И. Менделеева

г. Москва, Миусская площадь, дом 9, стр.1

Автоматизация. Котел №1 ДКВР-4/13

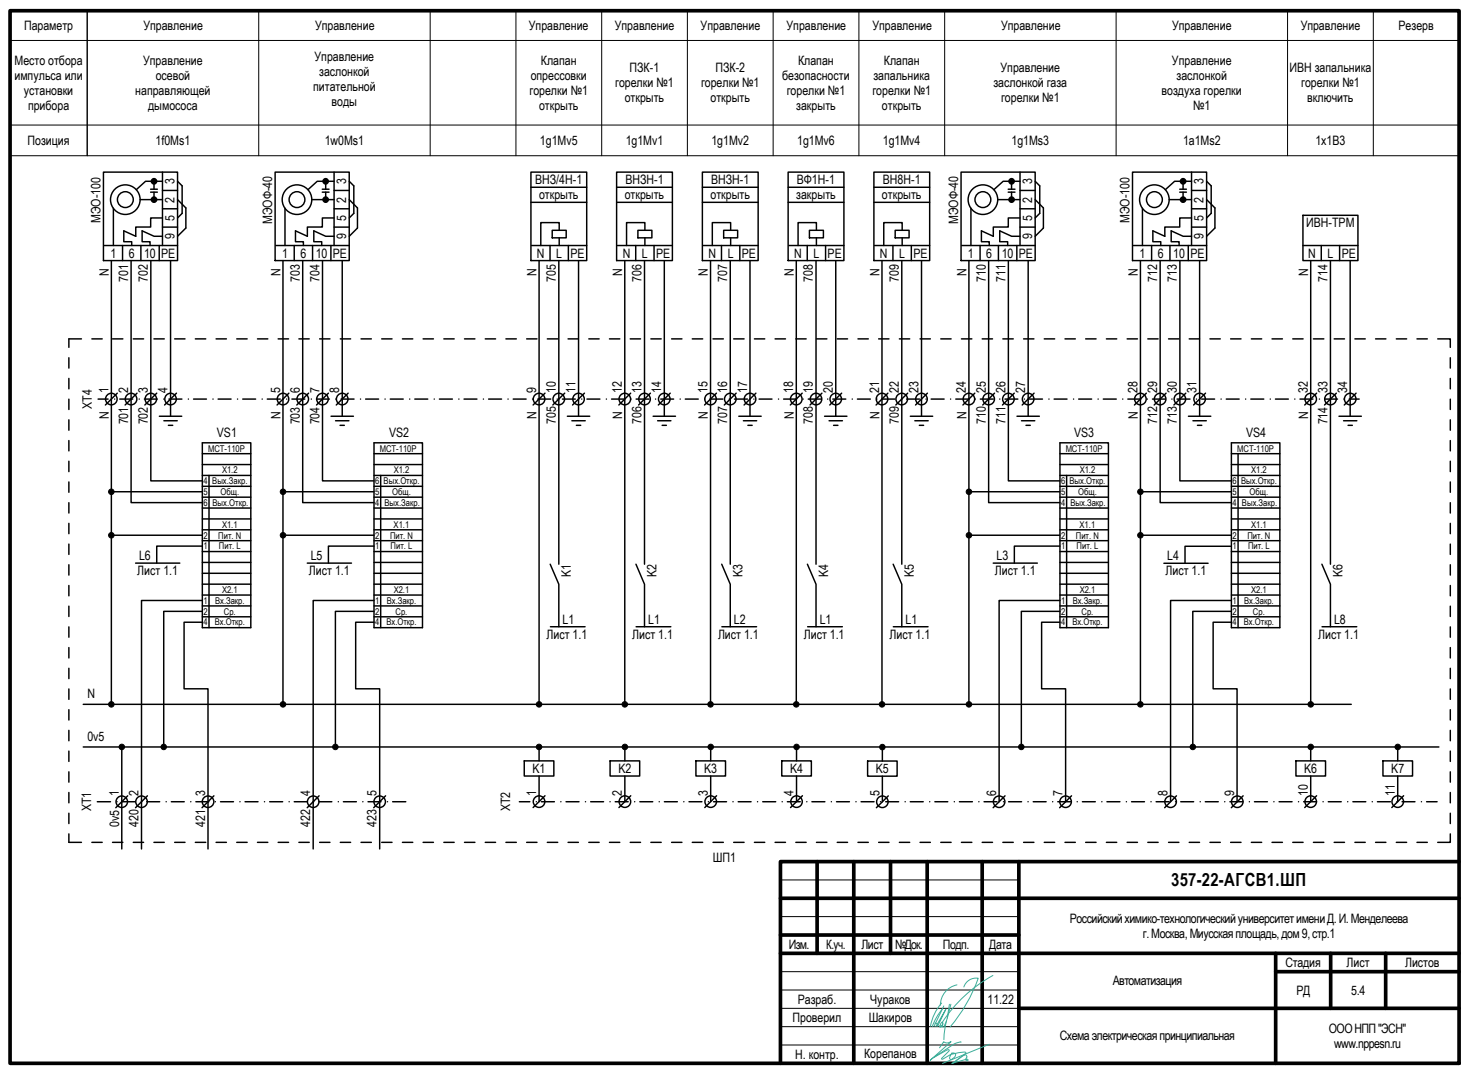
[picture p110: page 3]
Стадия; Лист; Листов; Изм.; №Док.; Подп.; Дата; Автоматизация; 357-22-АГСВ1.ШП; 5.4 Разраб.; Параметр; Место отбора импульса или установки прибора; Позиция; Управление; Управление осевой направляющей дымососа; Управление заслонкой питательной воды; Клапан опрессовки горелки №1 открыть; ПЗК-1 горелки №1 открыть; ПЗК-2 горелки №1 открыть; Клапан безопасности горелки №1 закрыть; Клапан запальника горелки №1 открыть; ИВН запальника горелки №1 включить; Управление заслонкой газа горелки №1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

Российский химико-технологический университет имени Д. И. Менделеева

г. Москва, Миусская площадь, дом 9, стр.1

Схема электрическая принципиальная

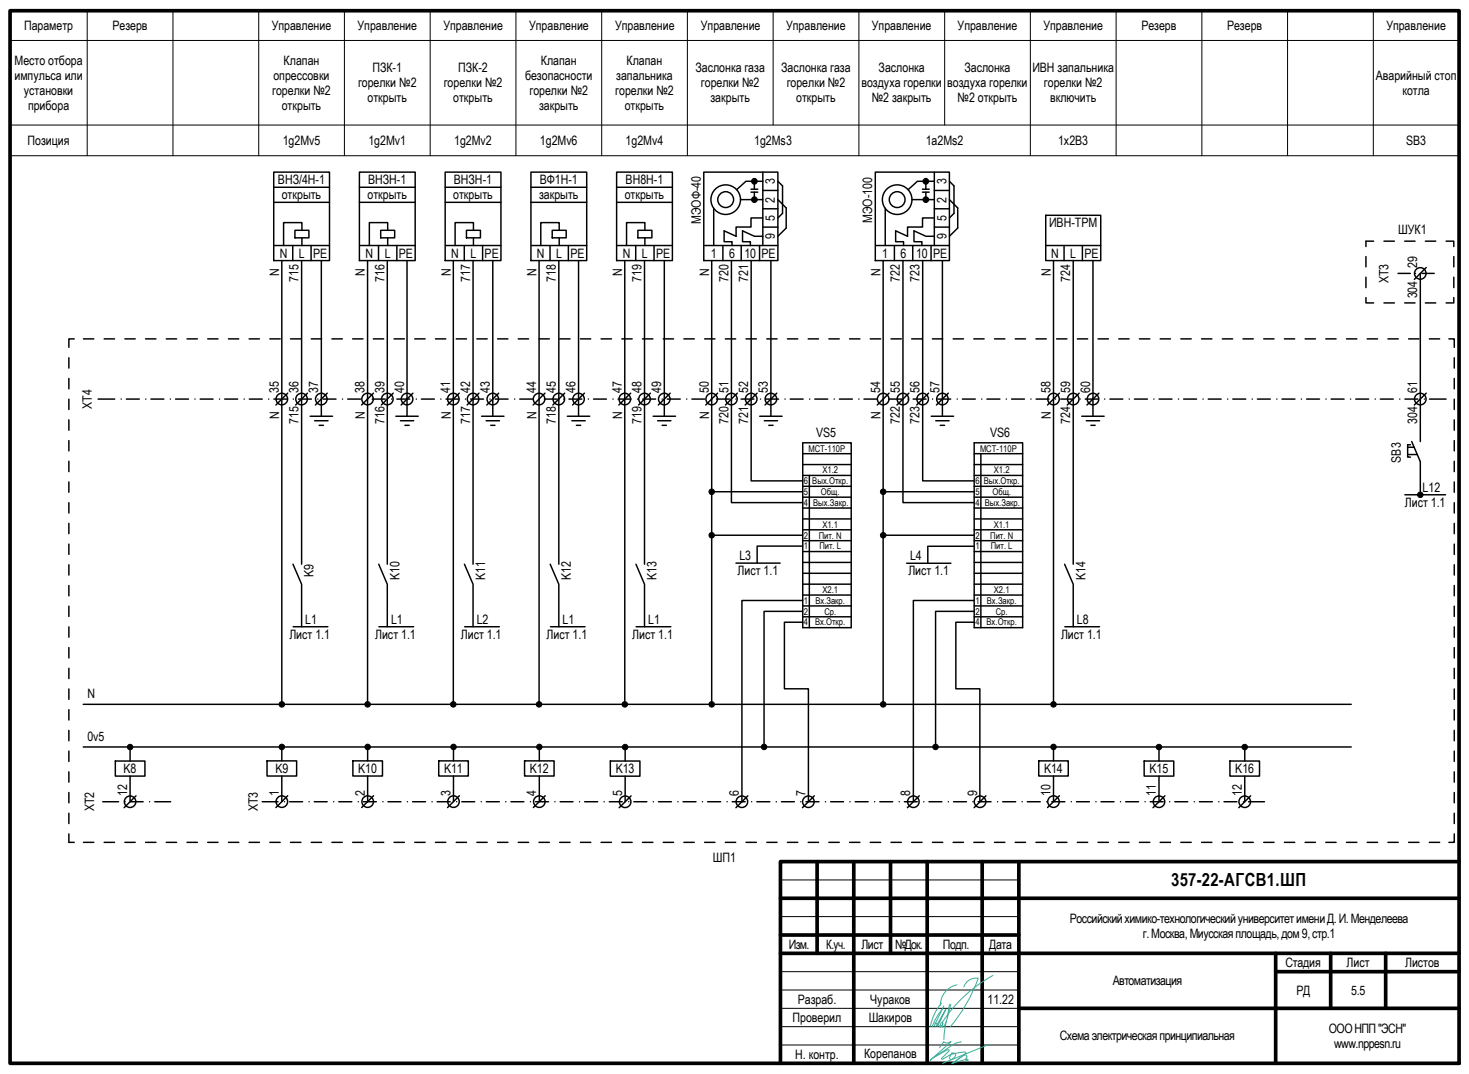
[picture p111: page 4]
Стадия; Лист; Листов; Изм.; №Док.; Подп.; Дата; 357-22-АГСВ1.ШП; Параметр; Место отбора импульса или установки прибора; Позиция; Управление; Клапан опрессовки горелки №2 открыть; ПЗК-1 горелки №2 открыть; ПЗК-2 горелки №2 открыть; Клапан безопасности горелки №2 закрыть; Клапан запальника горелки №2 открыть; ИВН запальника горелки №2 включить; Заслонка газа горелки №2 закрыть; Заслонка газа горелки №2 открыть; Заслонка воздуха горелки №2 закрыть; Заслонка воздуха горелки №2 открыть; ИВН-ТРМ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

Российский химико-технологический университет имени Д. И. Менделеева

г. Москва, Миусская площадь, дом 9, стр.1

Автоматизация | 5.5 Разраб.

Схема электрическая принципиальная
