nppesnteam/357-22-RHTU-DKVR-4.13/АГСВ1/1-8. Общее/5.4 Схема внешних электрических проводок.pdf

Стадия; Лист; Листов; Изм.; №Док.; Подп.; Дата; 5.4 Разраб.; Проверил; Н. контр.; Чураков Шакиров; Корепанов; Параметр; Место отбора импульса или установки прибора; Позиция; 357-22-АГСВ1; газораспределения и газопотребления; МКШнг; Контроль; Концевики заслонки питательной воды; Состояние ПЧ вентилятора; 1a0fMf1; МЭОФ-40; ШУПЧв; ПЧ дымососа работа; Концевики осевой направляющей дымососа; 1f0fMf2; МЭО-40; ШУПЧд; Клапан опрессовки горелки №1 открыт; ПЗК-1 горелки №1 открыт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

Автоматизация. Котел №1 ДКВР-4/13

Схема внешних электрических проводок. Входящие

ОООНПП "ЭСН"
www.nppesn.ru

дискретные сигналы (начало)
