nppesnteam/357-22-RHTU-DKVR-4.13/АГСВ2/10. ШП/10.3 Схема питания.pdf

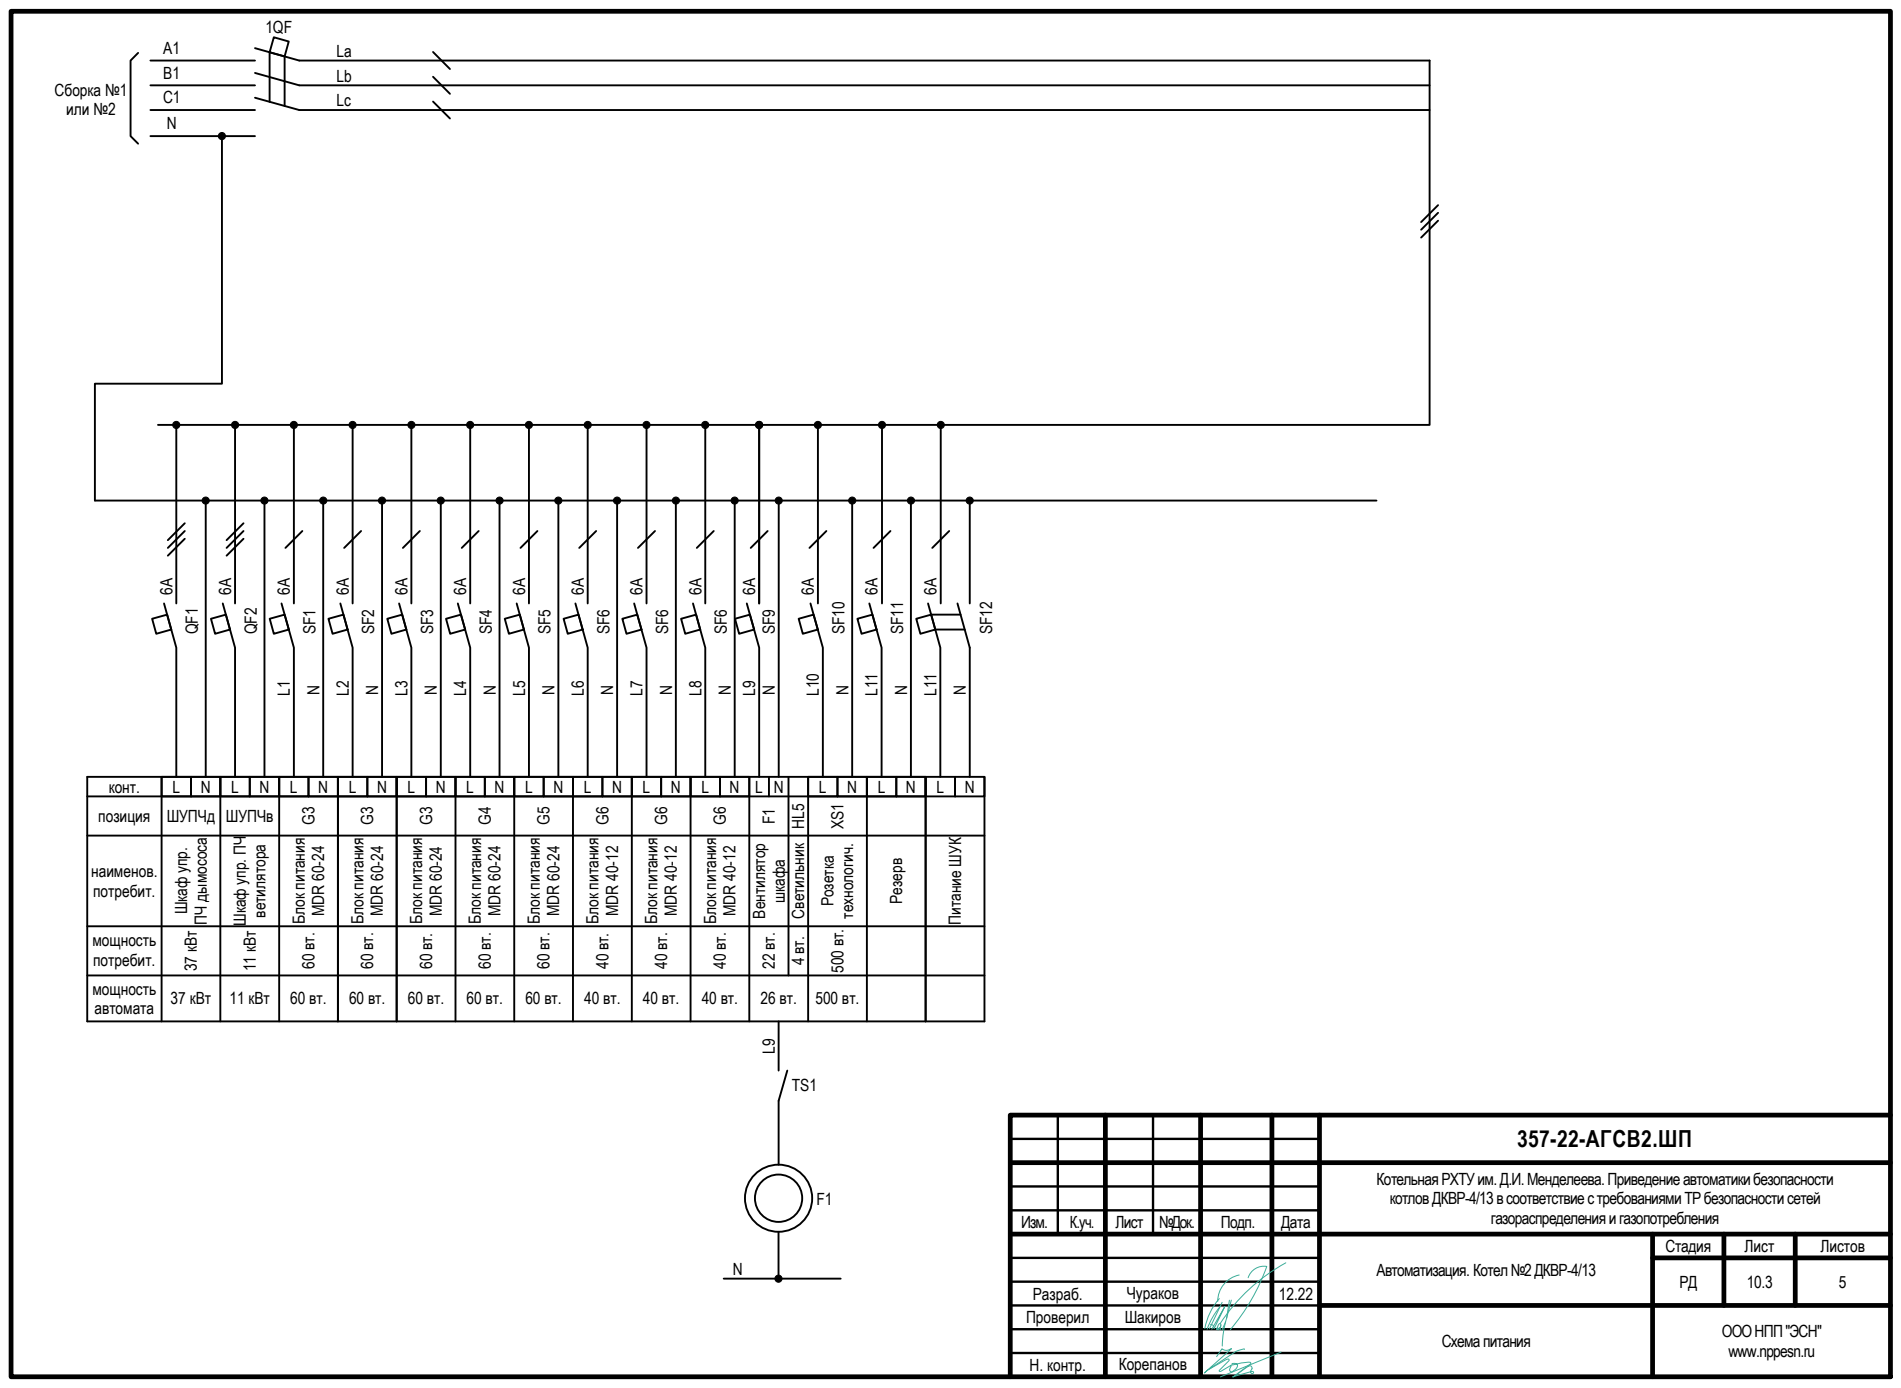
[picture p112: page 1]
Стадия; Лист; Листов; Изм.; №Док.; Подп.; Дата; газораспределения и газопотребления; 357-22-АГСВ2.ШП; Схема питания; 10.3 Разраб.; Проверил; Н. контр.; Чураков Шакиров; Корепанов; Сборка №1 или №2

конт. | L N | L N | L N | L N | L N | L N | L N | L N | L N | L N | L | N | | L N | L N
позиция | ШУПЧд | ШУПЧв

наименов. потребит.

мощность потребит.

мощность автомата | 37 кВт | 11 кВт | 60 вт. | 60 вт. | 60 вт. | 60 вт. | 60 вт. | 40 вт. | 40 вт. | 40 вт. | 26 вт. | | 500 вт.

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

Автоматизация. Котел №2 ДКВР-4/13

ОООНПП "ЭСН"
www.nppesn.ru
