nppesnteam/357-22-RHTU-DKVR-4.13/АГСВ2/10. ШП/10.4 Схема электрическая принципиальная.pdf

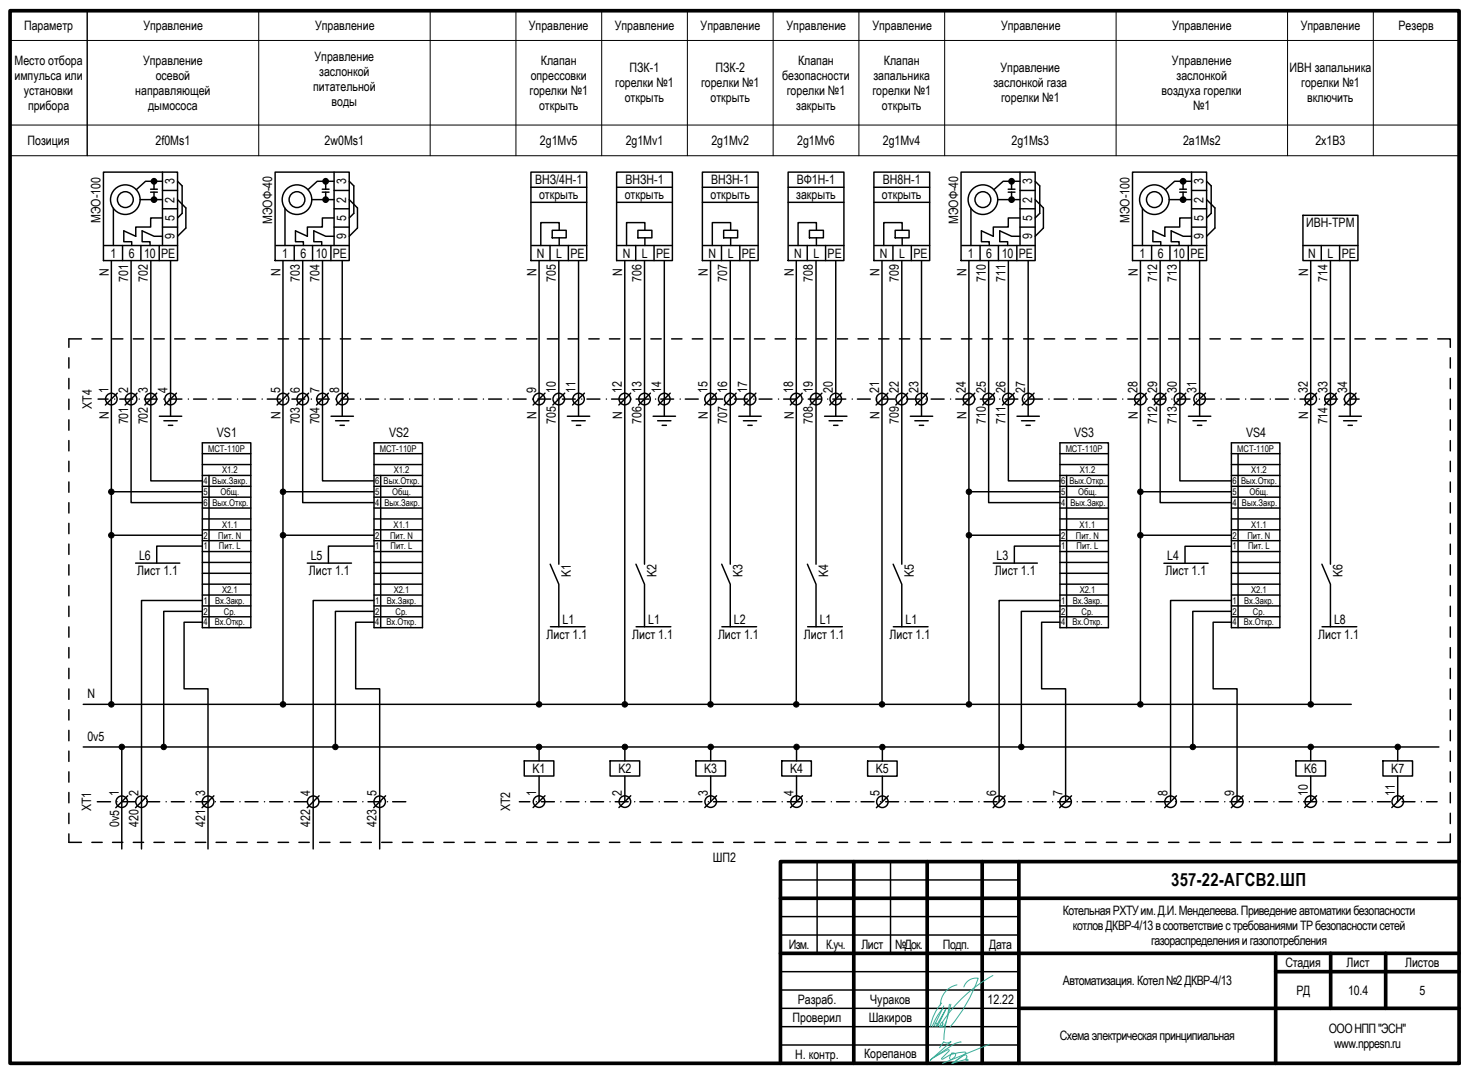
[picture p113: page 1]
Стадия; Лист; Листов; Изм.; №Док.; Подп.; Дата; 10.4 Разраб.; Проверил; Н. контр.; Чураков Шакиров; Корепанов; Параметр; Место отбора импульса или установки прибора; Позиция; 357-22-АГСВ2.ШП; газораспределения и газопотребления; Управление; Управление осевой направляющей дымососа; Управление заслонкой питательной воды; Клапан опрессовки горелки №1 открыть; ПЗК-1 горелки №1 открыть; ПЗК-2 горелки №1 открыть; Клапан безопасности горелки №1 закрыть; Клапан запальника горелки №1 открыть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

Автоматизация. Котел №2 ДКВР-4/13

ОООНПП "ЭСН"
www.nppesn.ru

Схема электрическая принципиальная
