nppesnteam/357-22-RHTU-DKVR-4.13/АГСВ2/10. ШП/10.5 Схема электрическая принципиальная.pdf

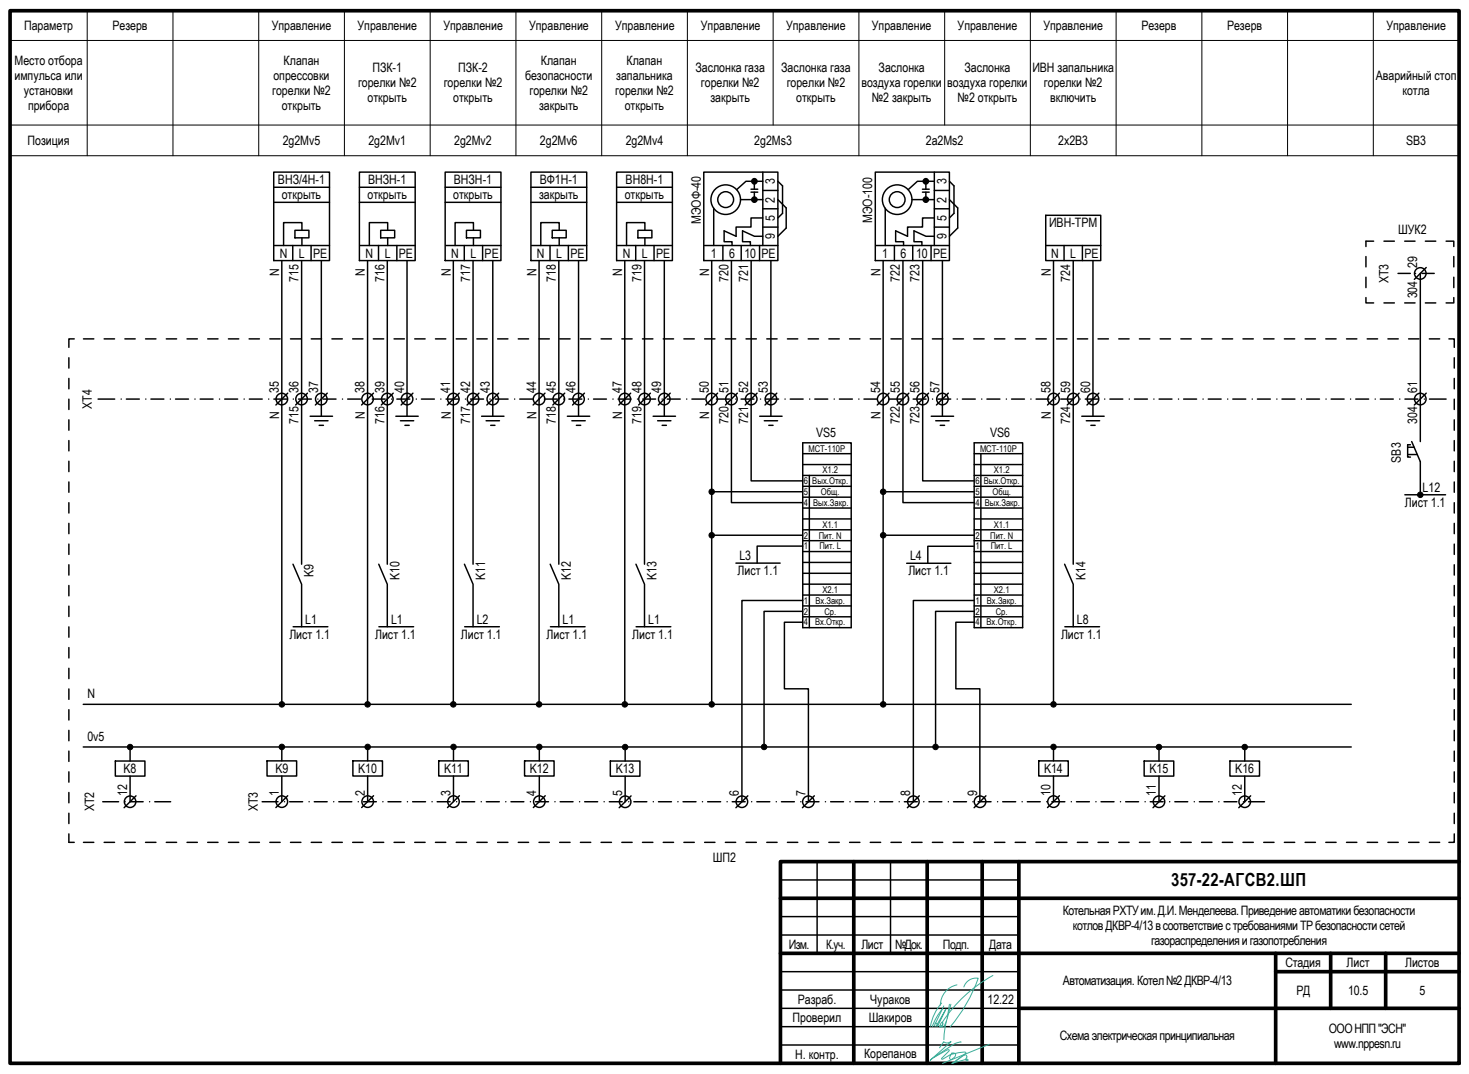
[picture p114: page 1]
Стадия; Лист; Листов; Изм.; №Док.; Подп.; Дата; Проверил; Н. контр.; Корепанов; Параметр; Место отбора импульса или установки прибора; Позиция; 357-22-АГСВ2.ШП; газораспределения и газопотребления; Управление; Клапан опрессовки горелки №2 открыть; ПЗК-1 горелки №2 открыть; ПЗК-2 горелки №2 открыть; Клапан безопасности горелки №2 закрыть; Клапан запальника горелки №2 открыть; ИВН запальника горелки №2 включить; Заслонка газа горелки №2 закрыть; Заслонка газа горелки №2 открыть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

Автоматизация. Котел №2 ДКВР-4/13 | 10.5 Разраб.

Чураков | 12.22
Шакиров

ОООНПП "ЭСН"
www.nppesn.ru

Схема электрическая принципиальная
