nppesnteam/357-22-RHTU-DKVR-4.13/АГСВ2/9. ШУК/9.10 Схема принципиальная DI.pdf

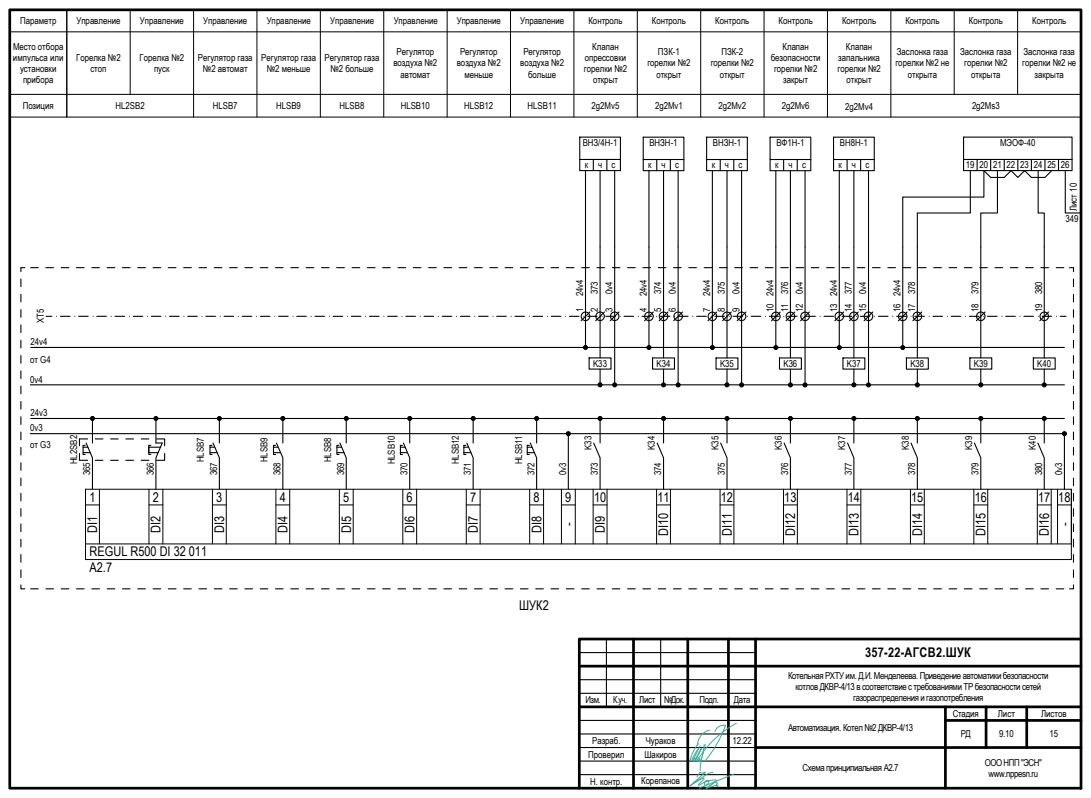
[picture p115: page 1]
Стадия; Лист; Листов; Изм.; №Док.; Подп.; Дата; Схема принципиальная А2.7; 9.10 Разраб.; Проверил; Н. контр.; Чураков Шакиров; Корепанов; Параметр; Место отбора импульса или установки прибора; Позиция; 357-22-АГСВ2.ШУК; газораспределения и газопотребления; REGUL R500 DI 32 011; Управление; Контроль; Горелка №2 стоп; Горелка №2 пуск; Регулятор газа №2 автомат; Регулятор газа №2 меньше; Регулятор газа №2 больше; Регулятор воздуха №2 автомат; Регулятор воздуха №2 меньше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

Автоматизация. Котел №2 ДКВР-4/13

ОООНПП "ЭСН"
www.nppesn.ru
