nppesnteam/357-22-RHTU-DKVR-4.13/(commit log)

2022-11-15 Первый вариант АГСВ
    Отсутствует кабельный журнал, трубные проводки и принципиальные схема ШУПЧв и ШУПЧд
    [357-22-АГСВ.ШОА.СО.xls, АГСВ.СО общее.xls, АГСВ.СО.xls, АГСВ.ШУПЧв.СО.xls, АГСВ.ШУПЧд.СО.xls, Сигналы на ПЛК.xlsx, Шифры шкафов.xlsx]
2022-11-15 Правки внешних проводок+КЖ
    [357-22-АГСВ.ШОА.СО.xls, АГСВ.КЖ.xls, АГСВ.СО общее.xls, АГСВ.ШОА.СО.xls, АГСВ.ШУПЧв.СО.xls, АГСВ.ШУПЧд.СО.xls]
2022-12-21 Конец, ждём экспертизу
    [АГСВ.КЖ.xls, АГСВ.СО.xls, АГСВ1.КЖ.xls, АГСВ1.СО.xls, АГСВ1.ШП.СО.xls, АГСВ1.ШУК.СО.xls, АГСВ2.ИО.xlsx, АГСВ2.КЖ.xls]
2023-01-14 Подготовка на экспертизу
    Добавлен ЭТН, комплектация, сборка, шкаф АВР
    [357-22-рхту_Комплектация_8шкафов_230114.xlsx, АГСВ.ИО.xlsx, АГСВ.КЖ.xls, АГСВ.СО.xls, АГСВ.ШАВР.СО.xls, АГСВ.ШОА.СО.xls, АГСВ.ШУПЧд.СО.xls, АГСВ.ЭТН.xlsx]
2023-01-30 конечный вариант
    [357-22-рхту_Комплектация_8шкафов_230116.xlsx, АГСВ.dwg, АГСВ.ШАВР.Сборка.xlsx, АГСВ.ШОА.Сборка.xlsx, АГСВ.ШУПЧв.Сборка.xlsx, АГСВ.ШУПЧд.Сборка.xlsx, АГСВ1.dwg, АГСВ1.ШП.Сборка.xlsx]
